NervenCid/UNAL_FDM/README.md

# UNAL FDM
Impresora 3D

Bienvenido al sitio web de Diego

<b> mi proyecto de impresión 3d </b>
