NervenCid/UNAL_FDM/Prototipo_11/Cotizaciones y cuentas/Pesos.docx

Estructura:

Base:

Tornillo:

Base:

Sistema Transfer:

Cremallera:

Carro IGUS:

Extrusores:

Porta-Rodamientos:

Motor Paso:

Porta NEMA 17:

Motor + Porta Nema 17:
