NervenCid/UNAL_FDM/Prototipo_11/Cotizaciones y cuentas/Cotizacion_1.pdf

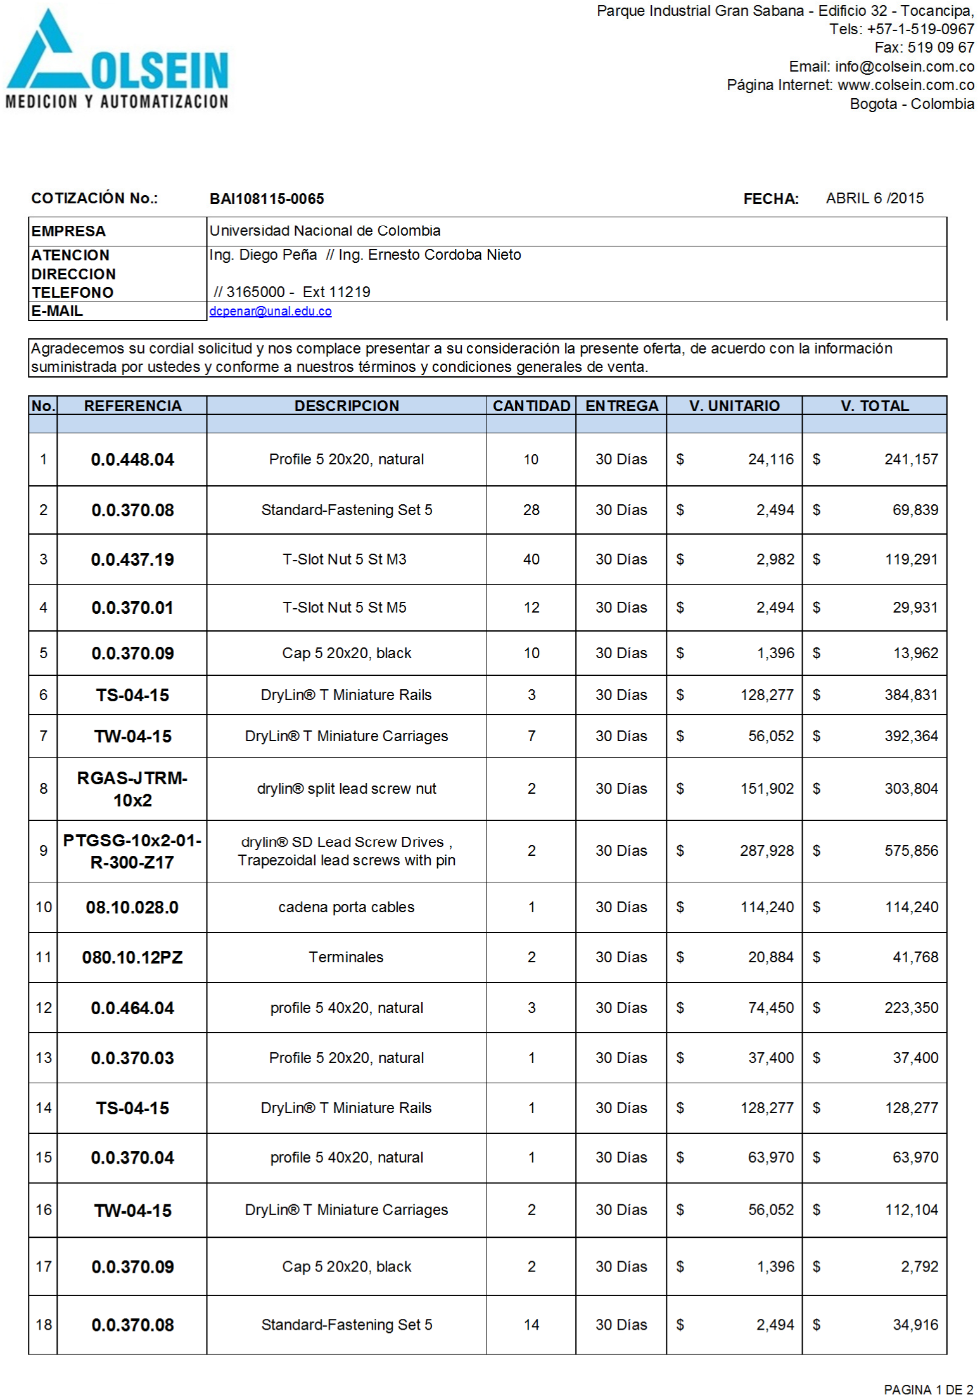
[picture p1: page 1]
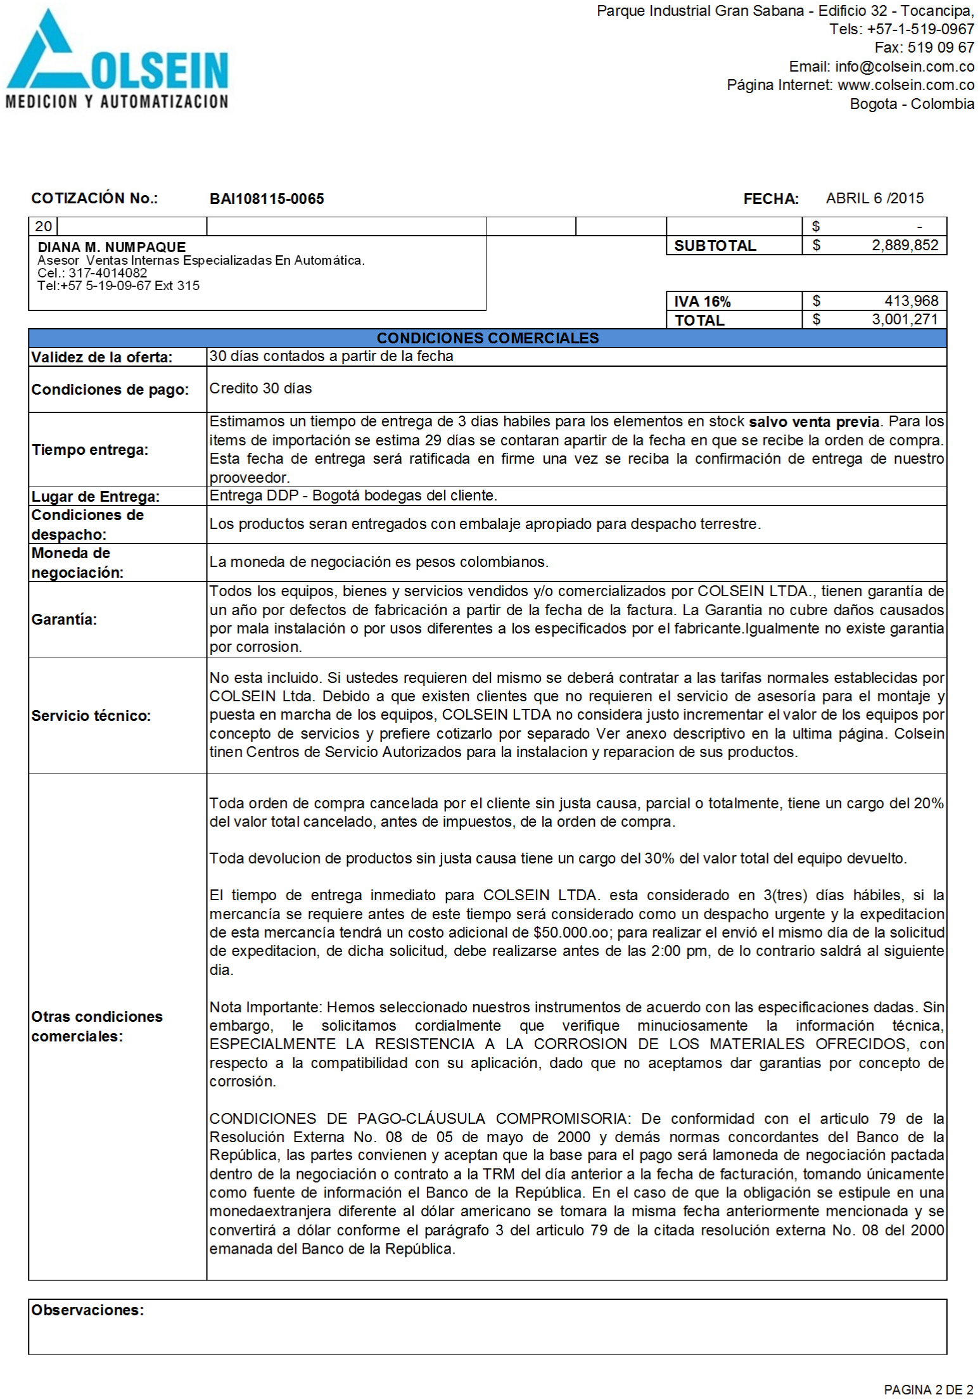
[picture p2: page 2]
