NervenCid/UNAL_FDM/Prototipo_11/Cotizaciones y cuentas/Cotizacion_2.pdf

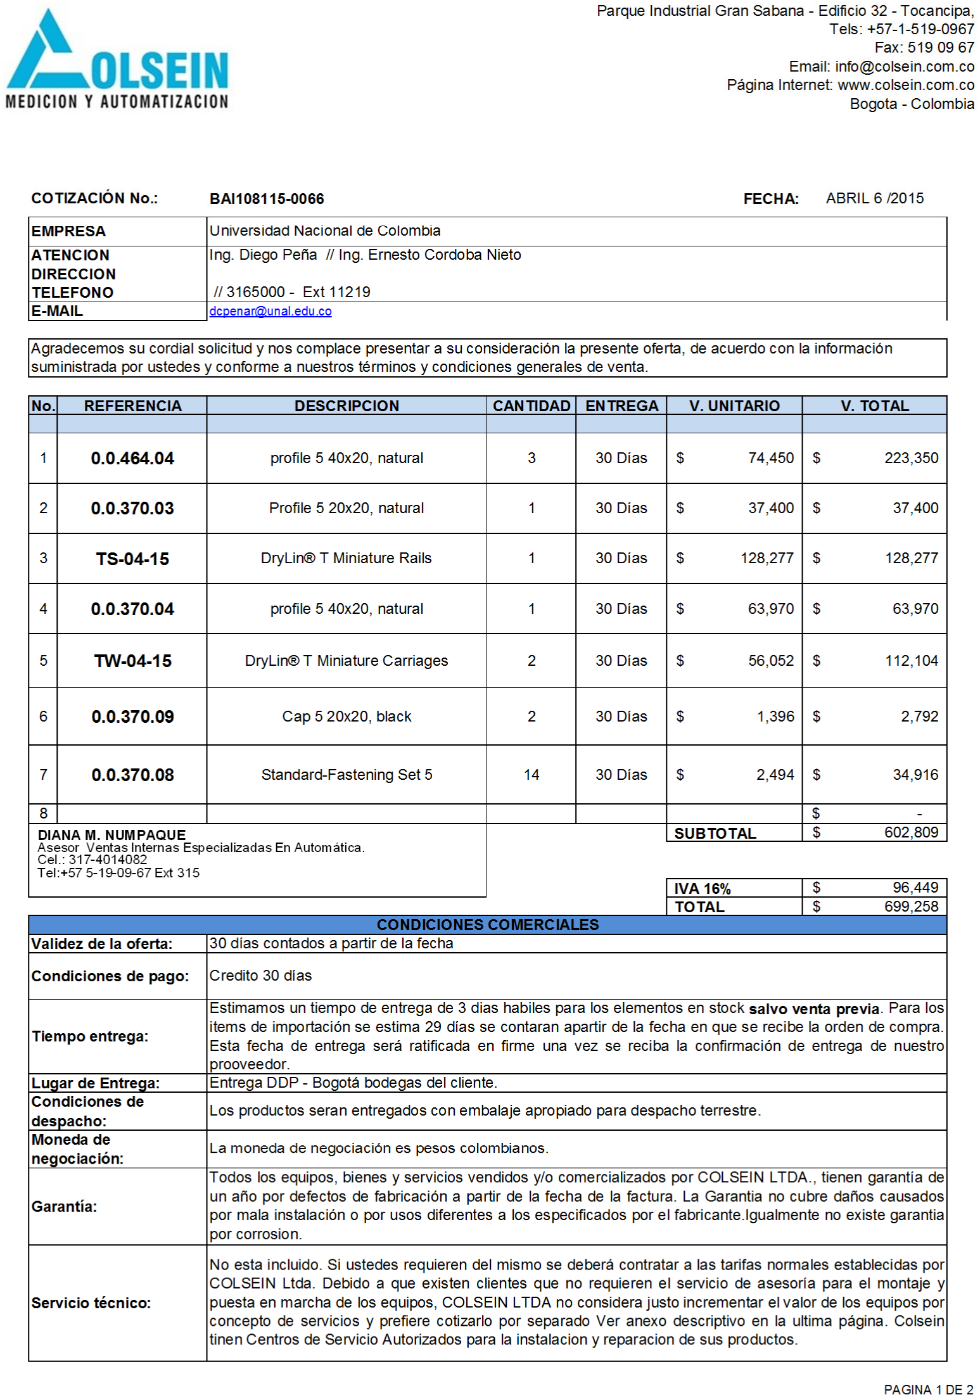
[picture p3: page 1]
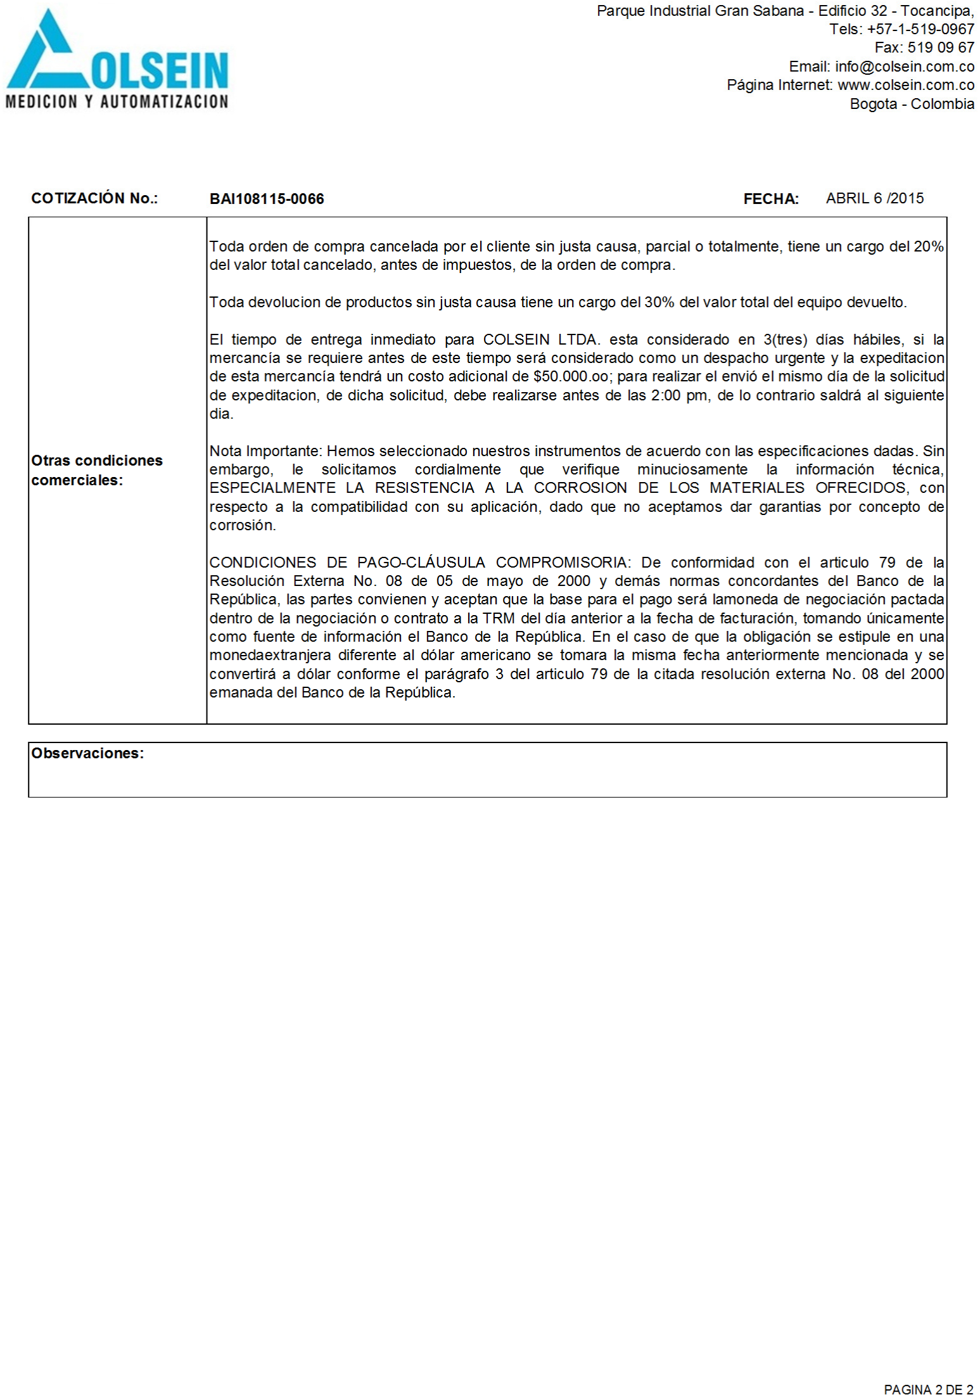
[picture p4: page 2]
