NervenCid/UNAL_FDM/Prototipo_11/AccesoriosTHK/20126271125239772372.jpg

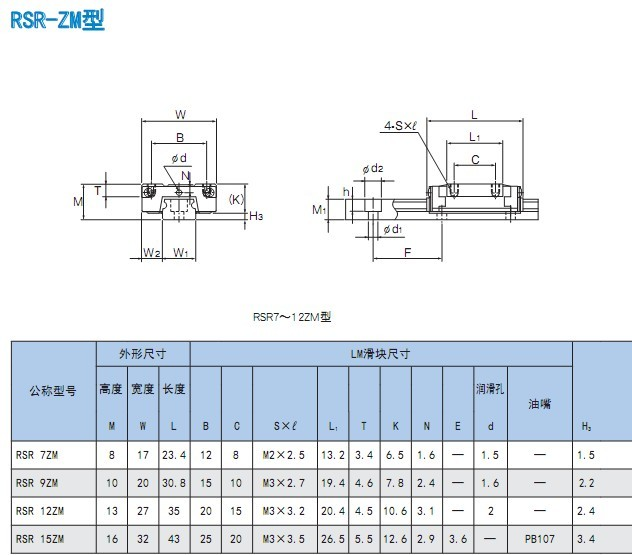
Prototipo_11/AccesoriosTHK/20126271125239772372.jpg
