NervenCid/UNAL_FDM/Prototipo_11/AccesoriosTHK/RSR9ZM_005_j.png

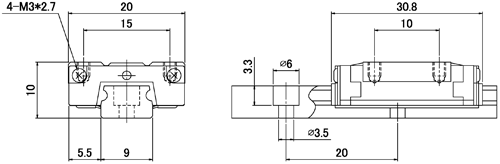
Prototipo_11/AccesoriosTHK/RSR9ZM_005_j.png
