NervenCid/UNAL_FDM/Prototipo_11/Analisis_EF/Lamina_Acople_10mm_EjeXYV4/file6_5987fbc9.jpg

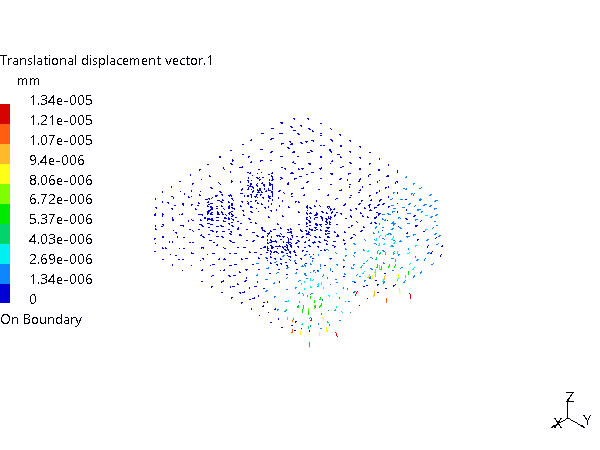
Prototipo_11/Analisis_EF/Lamina_Acople_10mm_EjeXYV4/file6_5987fbc9.jpg
