NervenCid/UNAL_FDM/Prototipo_11/Analisis_EF/Lamina_Acople_Extrusor_V5.jpg

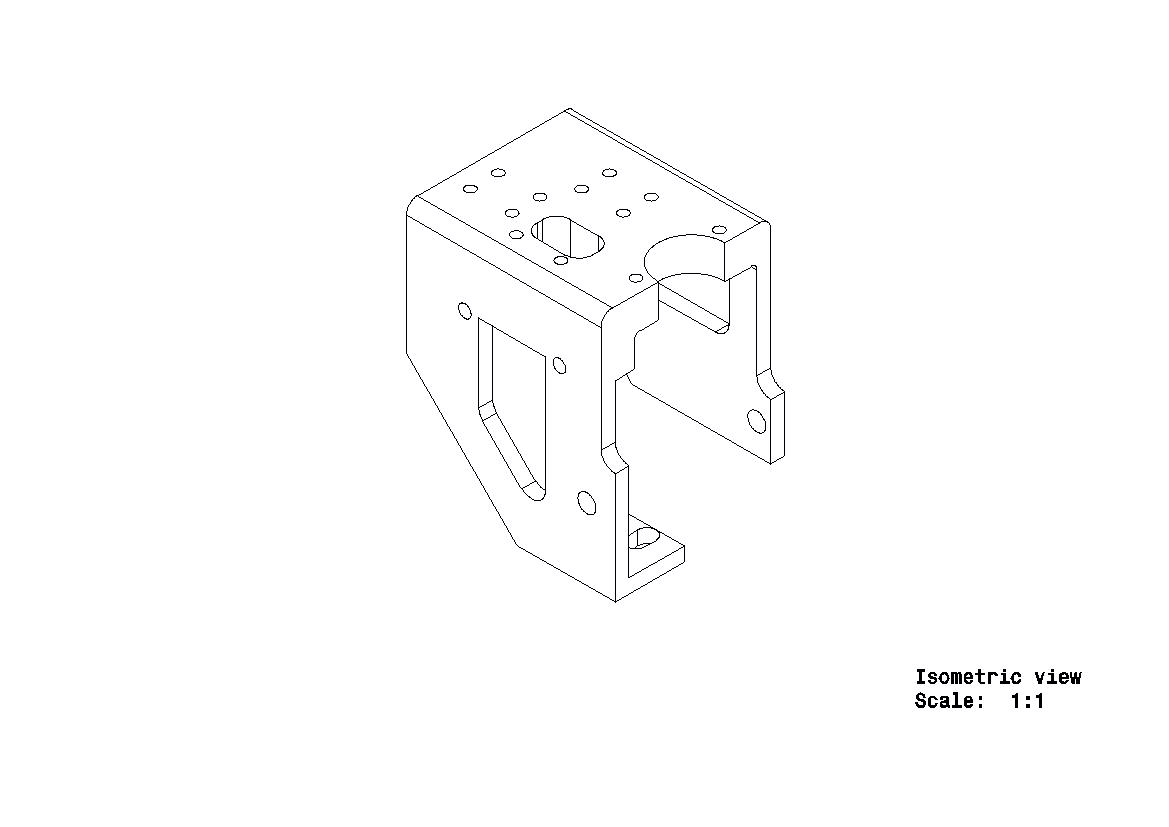
Prototipo_11/Analisis_EF/Lamina_Acople_Extrusor_V5.jpg
