NervenCid/UNAL_FDM/Prototipo_11/Analisis_EF/SoporteGiratorioX.jpg

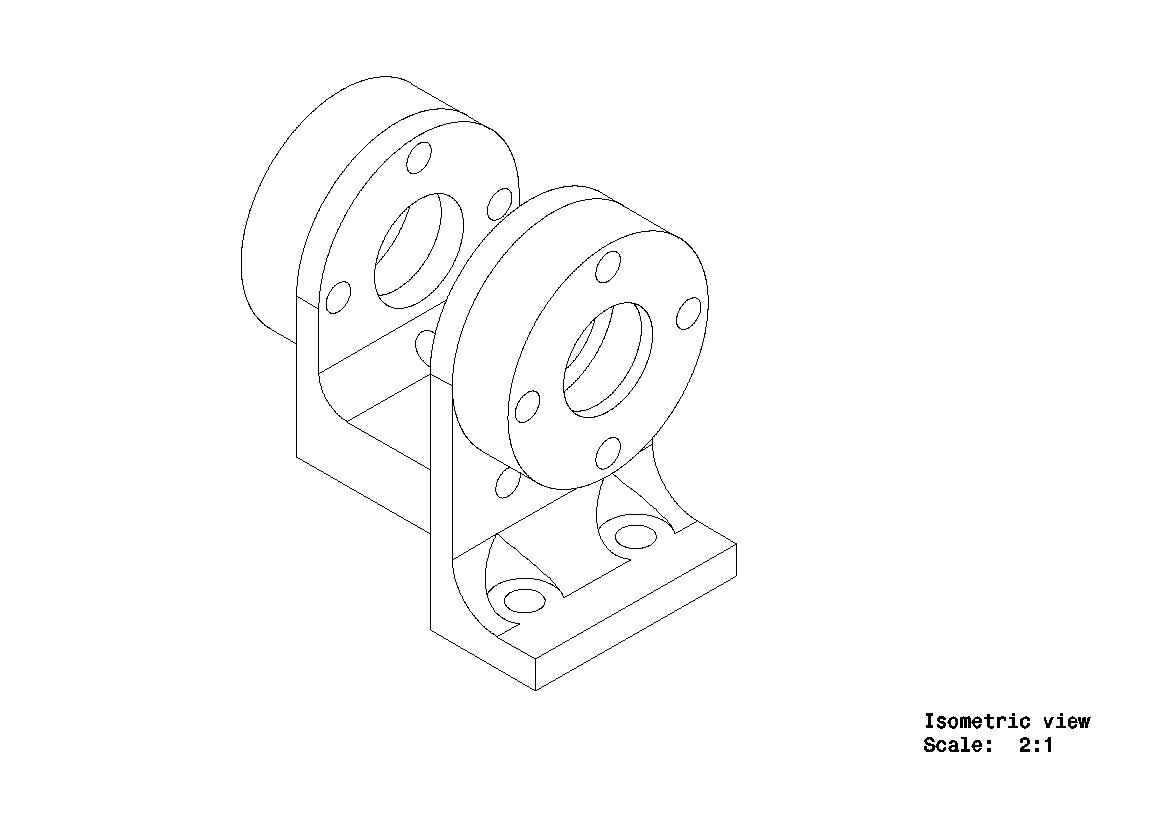
Prototipo_11/Analisis_EF/SoporteGiratorioX.jpg
