NervenCid/UNAL_FDM/Prototipo_11/Analisis_EF/SoporteGiratorioX/file3_59892431.jpg

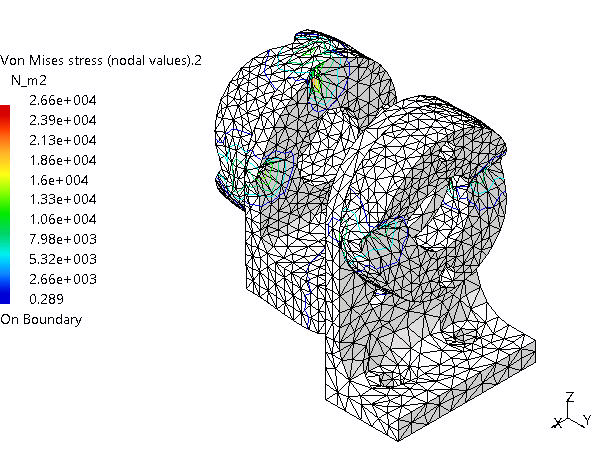
Prototipo_11/Analisis_EF/SoporteGiratorioX/file3_59892431.jpg
