NervenCid/UNAL_FDM/Prototipo_11/Analisis_EF/SoporteGiratorioX/file4_59892431.jpg

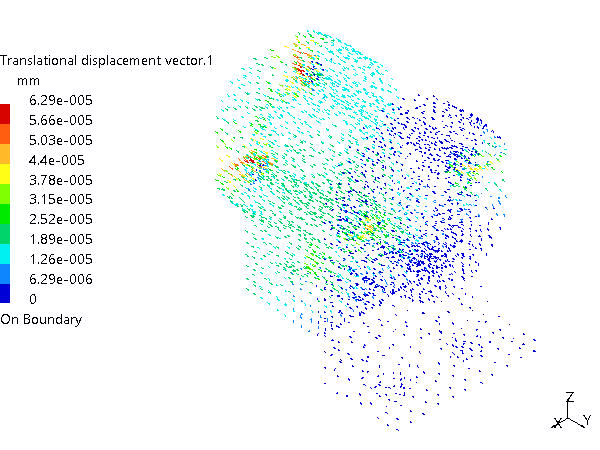
Prototipo_11/Analisis_EF/SoporteGiratorioX/file4_59892431.jpg
