NervenCid/UNAL_FDM/Prototipo_11/Analisis_EF/SoporteGiratorioY.jpg

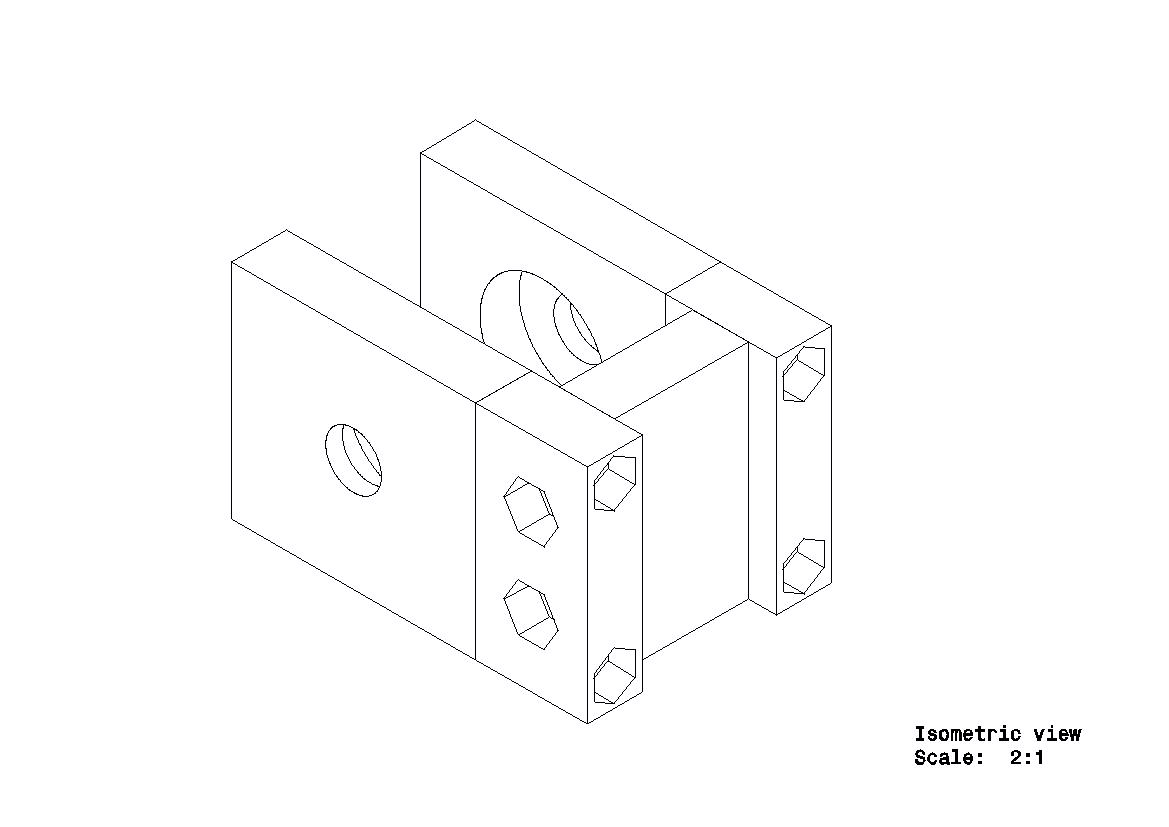
Prototipo_11/Analisis_EF/SoporteGiratorioY.jpg
