NervenCid/UNAL_FDM/Prototipo_11/Analisis_EF/SoporteGiratorioY/file1_5987ef5c.jpg

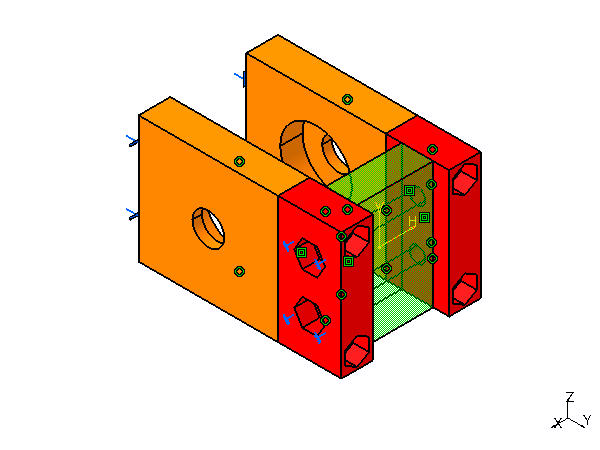
Prototipo_11/Analisis_EF/SoporteGiratorioY/file1_5987ef5c.jpg
