NervenCid/UNAL_FDM/Prototipo_11/Analisis_EF/SoporteGiratorioY/file4_5987ef5c.jpg

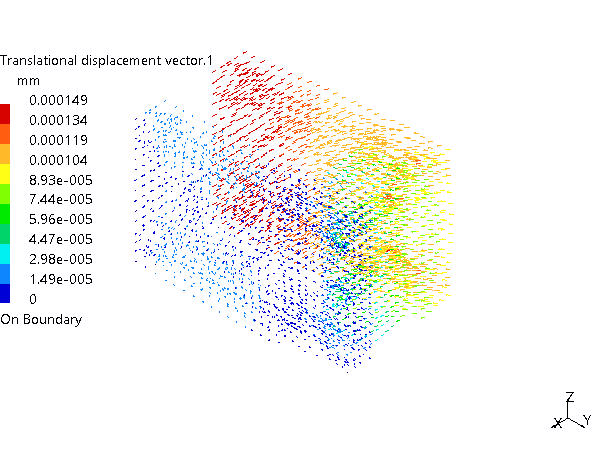
Prototipo_11/Analisis_EF/SoporteGiratorioY/file4_5987ef5c.jpg
