NervenCid/UNAL_FDM/Prototipo_11/Analisis_EF/TensorX.jpg

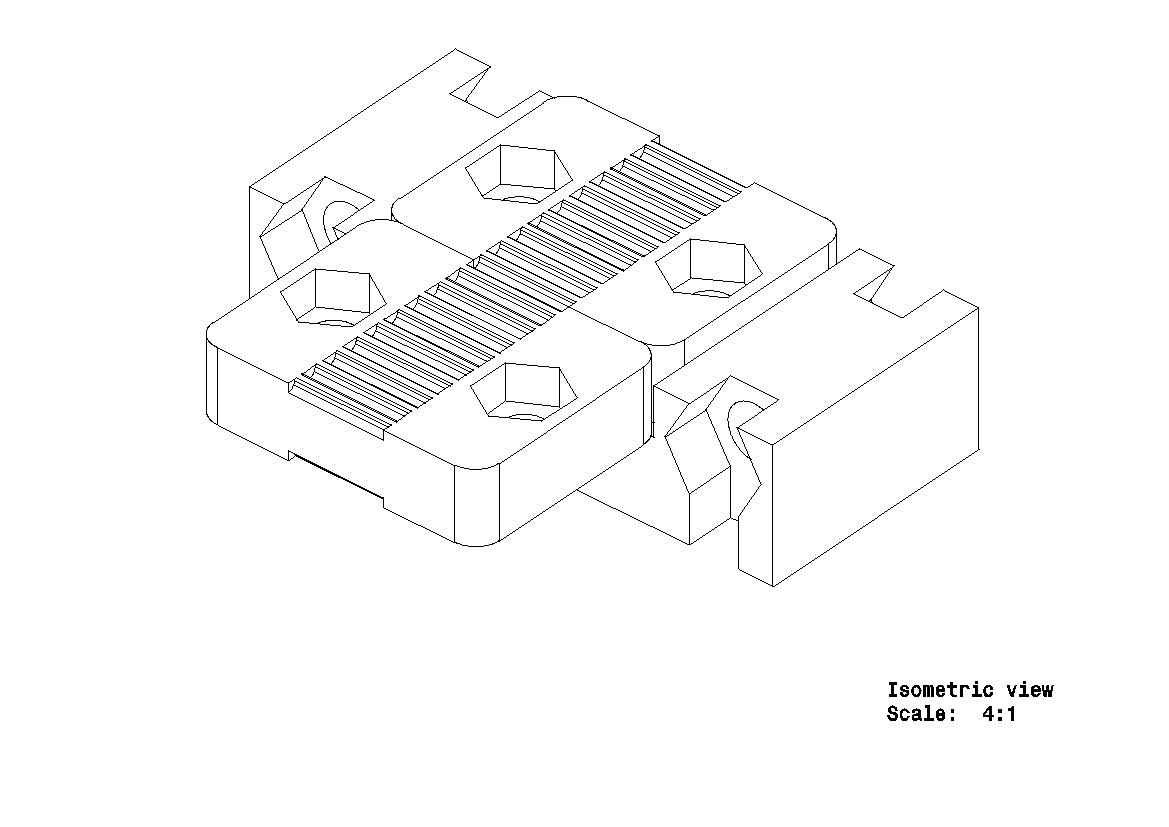
Prototipo_11/Analisis_EF/TensorX.jpg
