NervenCid/UNAL_FDM/Prototipo_11/Analisis_EF/TensorX/file1_59893316.jpg

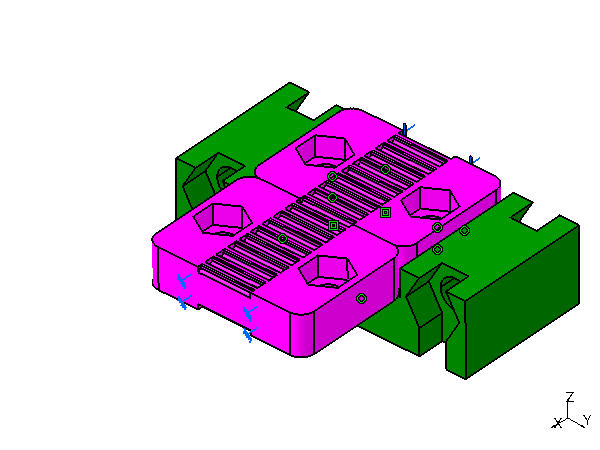
Prototipo_11/Analisis_EF/TensorX/file1_59893316.jpg
