NervenCid/UNAL_FDM/Prototipo_11/Analisis_EF/TensorY.jpg

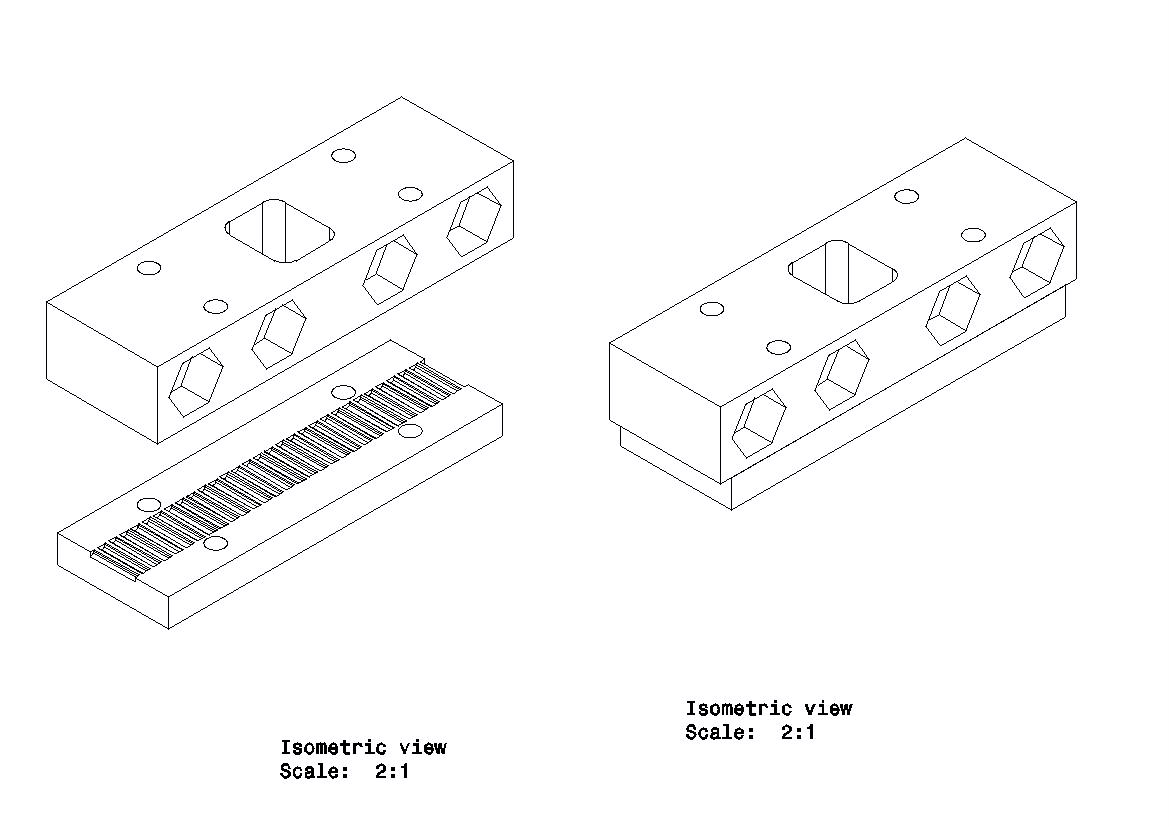
Prototipo_11/Analisis_EF/TensorY.jpg
