NervenCid/UNAL_FDM/Prototipo_11/Analisis_EF/TensorY/file1_5987cb9e.jpg

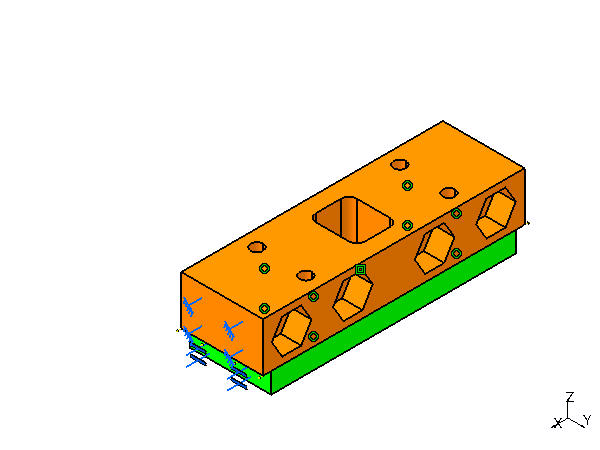
Prototipo_11/Analisis_EF/TensorY/file1_5987cb9e.jpg
