NervenCid/UNAL_FDM/Prototipo_11/Analisis_EF/TensorY/file3_5987cb9e.jpg

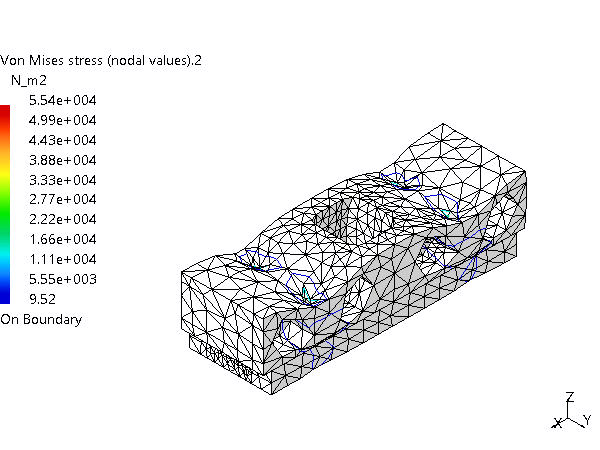
Prototipo_11/Analisis_EF/TensorY/file3_5987cb9e.jpg
