NervenCid/UNAL_FDM/Prototipo_11/Planos Electricos/600px-Ramps-Shield-10.jpg

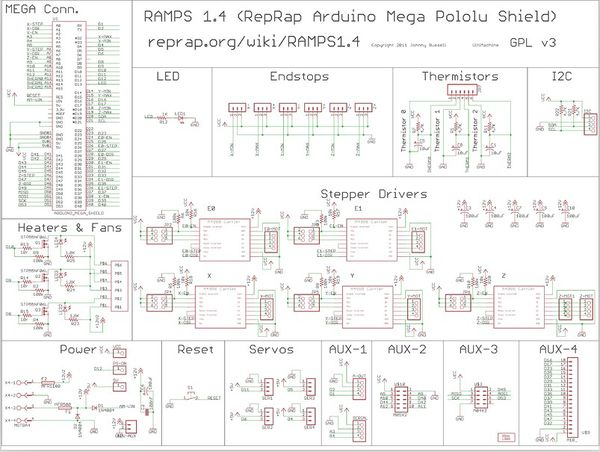
Prototipo_11/Planos Electricos/600px-Ramps-Shield-10.jpg
