NervenCid/UNAL_FDM/Prototipo_11/Planos Electricos/2782231411938289153.png

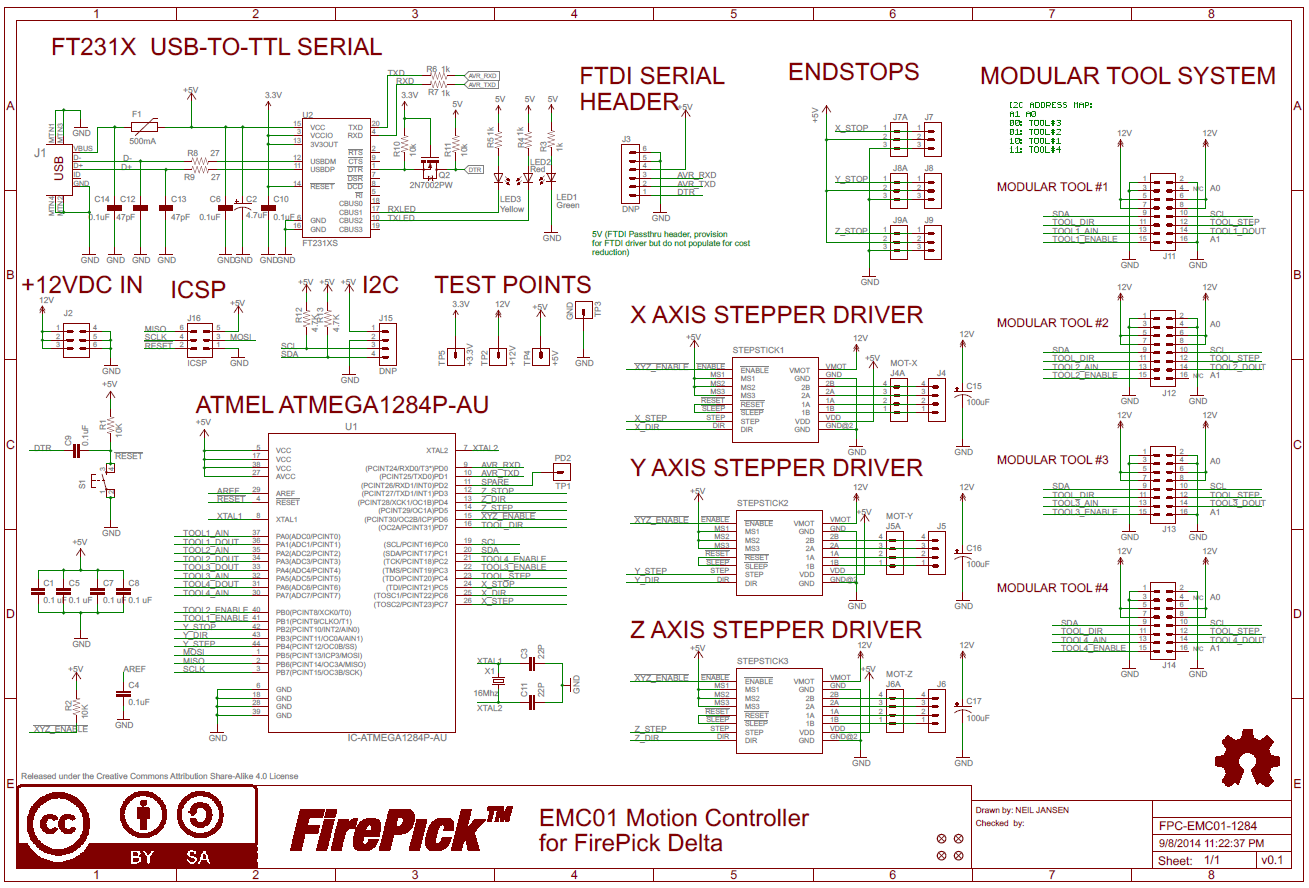
Prototipo_11/Planos Electricos/2782231411938289153.png
