NervenCid/UNAL_FDM/Prototipo_11/Planos Electricos/Bloques1.jpg

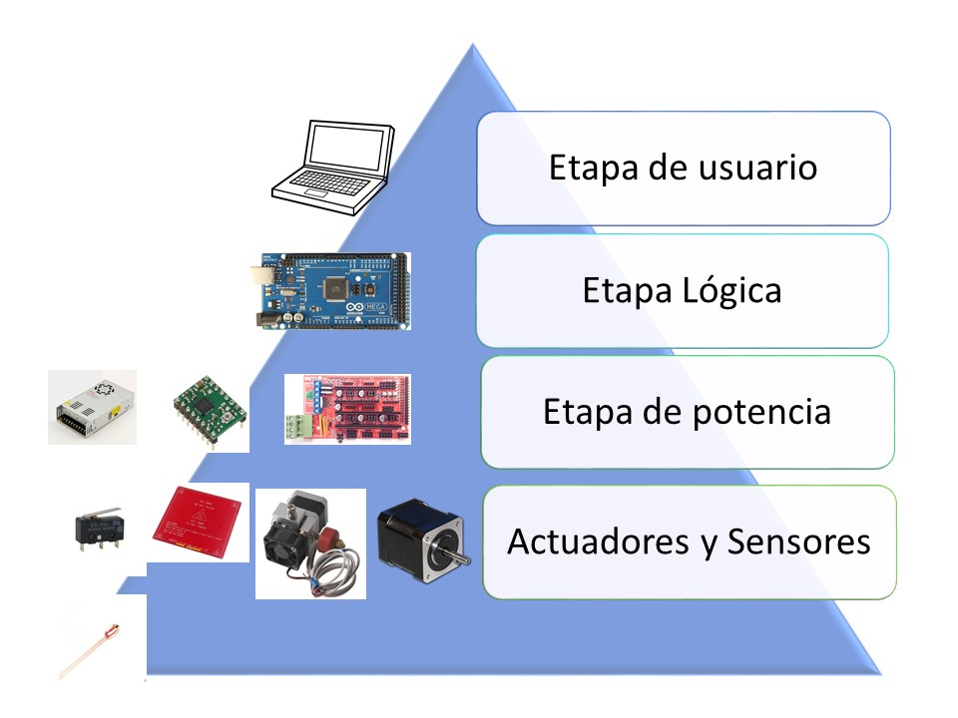
Prototipo_11/Planos Electricos/Bloques1.jpg
