NervenCid/UNAL_FDM/Prototipo_11/Planos Electricos/Bloques2.jpg

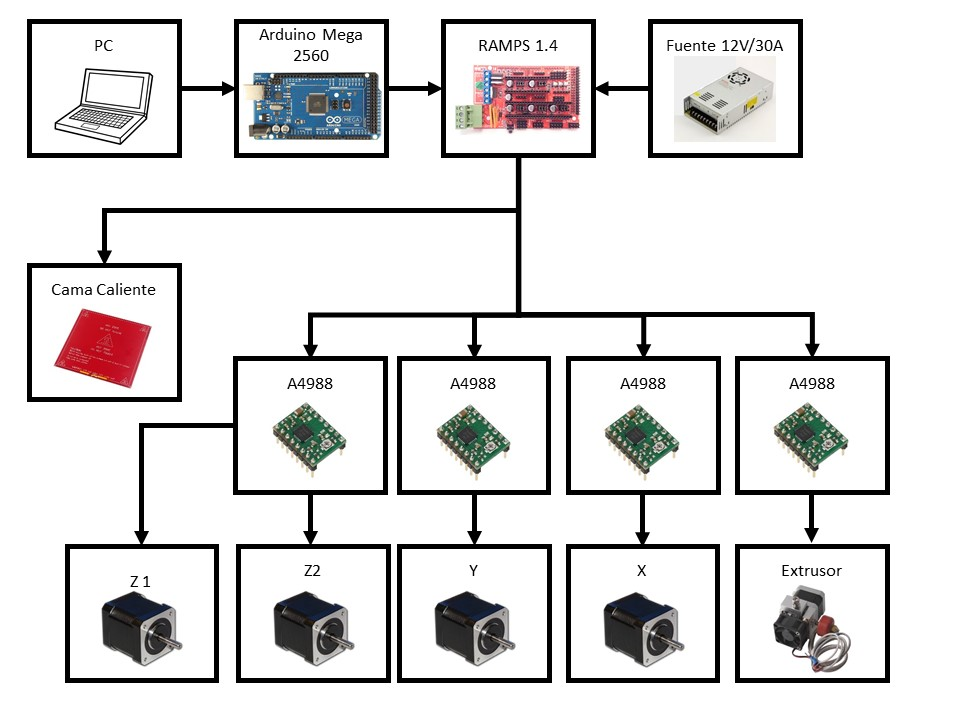
Prototipo_11/Planos Electricos/Bloques2.jpg
