NervenCid/UNAL_FDM/Prototipo_11/Planos Electricos/Bloques3.jpg

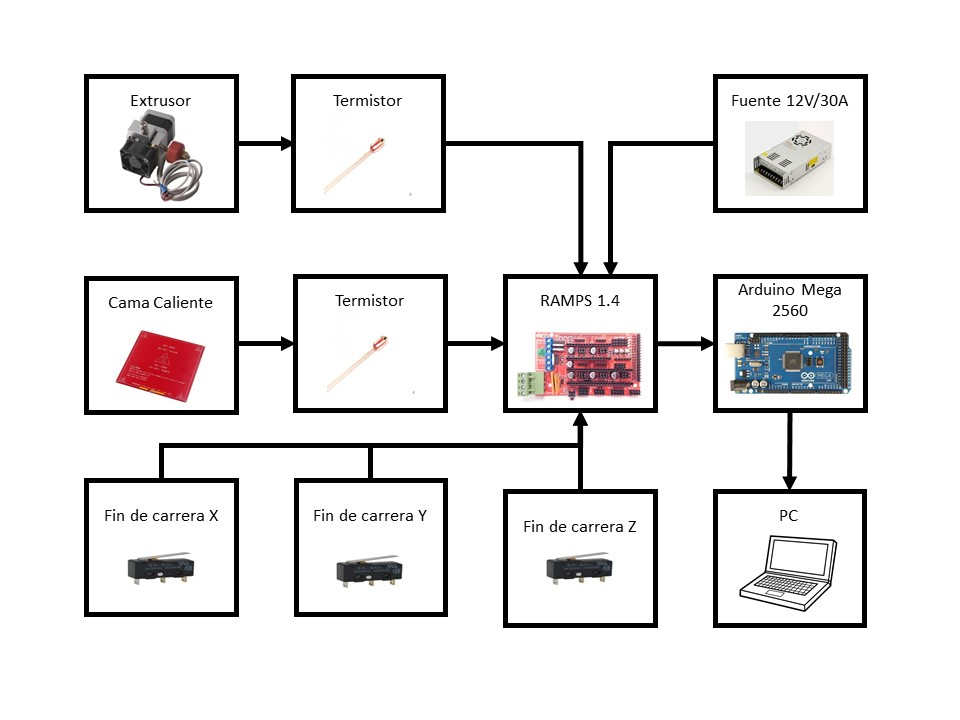
Prototipo_11/Planos Electricos/Bloques3.jpg
