NervenCid/UNAL_FDM/Prototipo_11/Planos Electricos/Bloques4.jpg

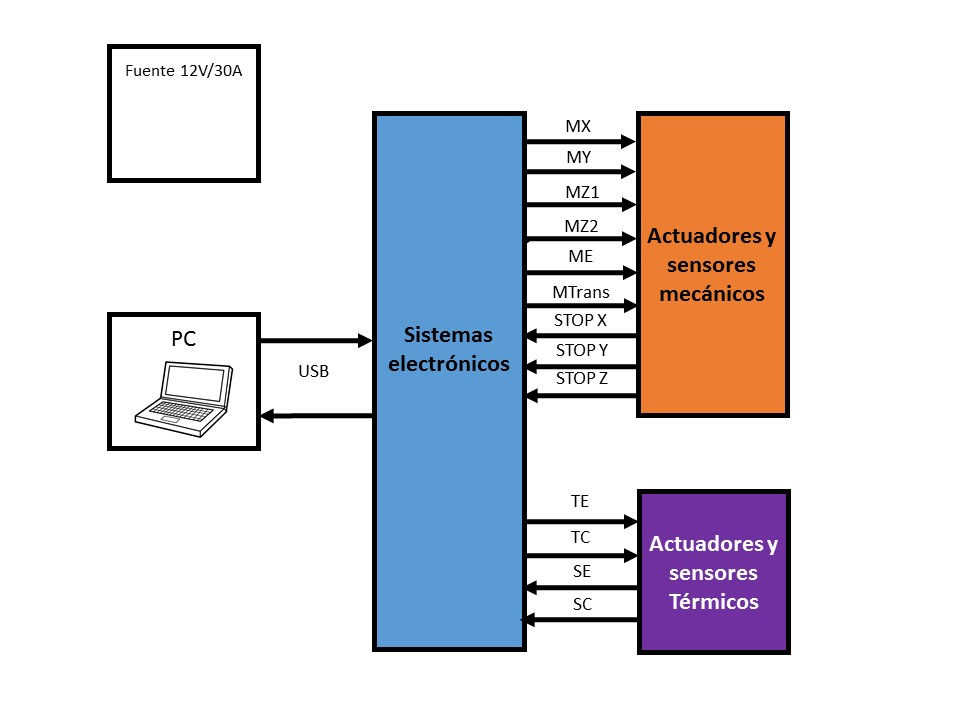
Prototipo_11/Planos Electricos/Bloques4.jpg
