NervenCid/UNAL_FDM/Prototipo_11/Planos Electricos/Bloques5.jpg

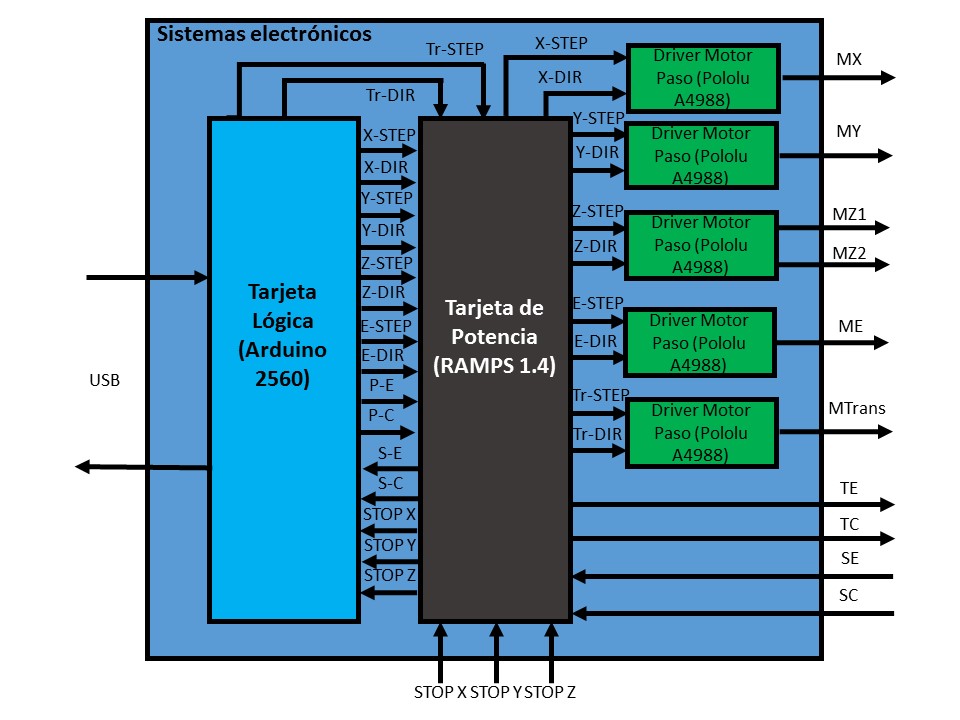
Prototipo_11/Planos Electricos/Bloques5.jpg
