NervenCid/UNAL_FDM/Prototipo_11/Planos Electricos/Bloques6.jpg

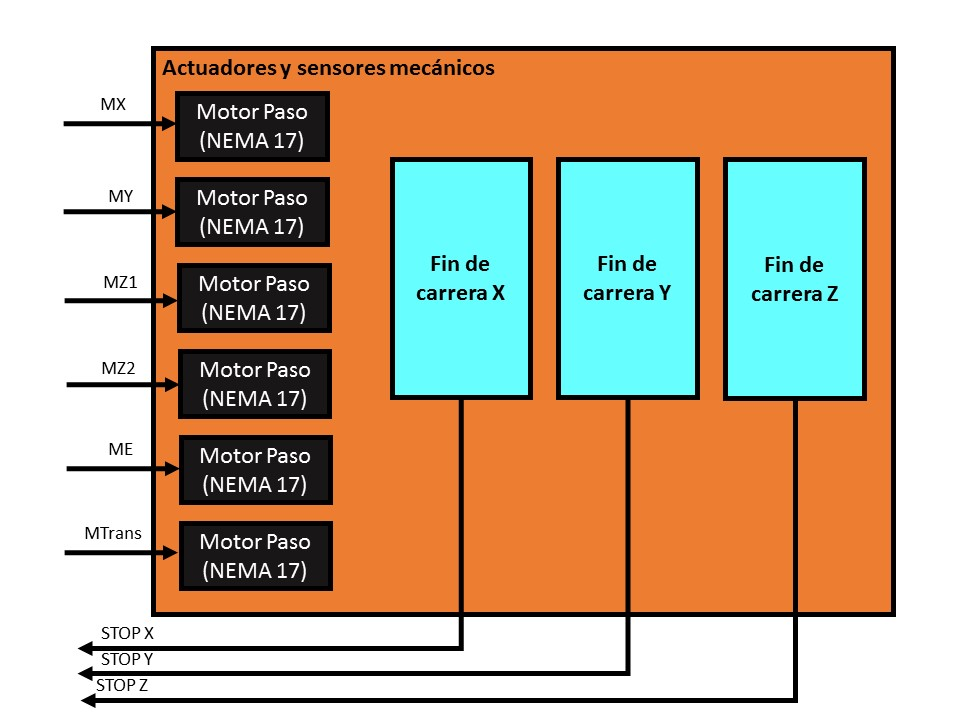
Prototipo_11/Planos Electricos/Bloques6.jpg
