NervenCid/UNAL_FDM/Prototipo_11/Planos Electricos/Bloques7.jpg

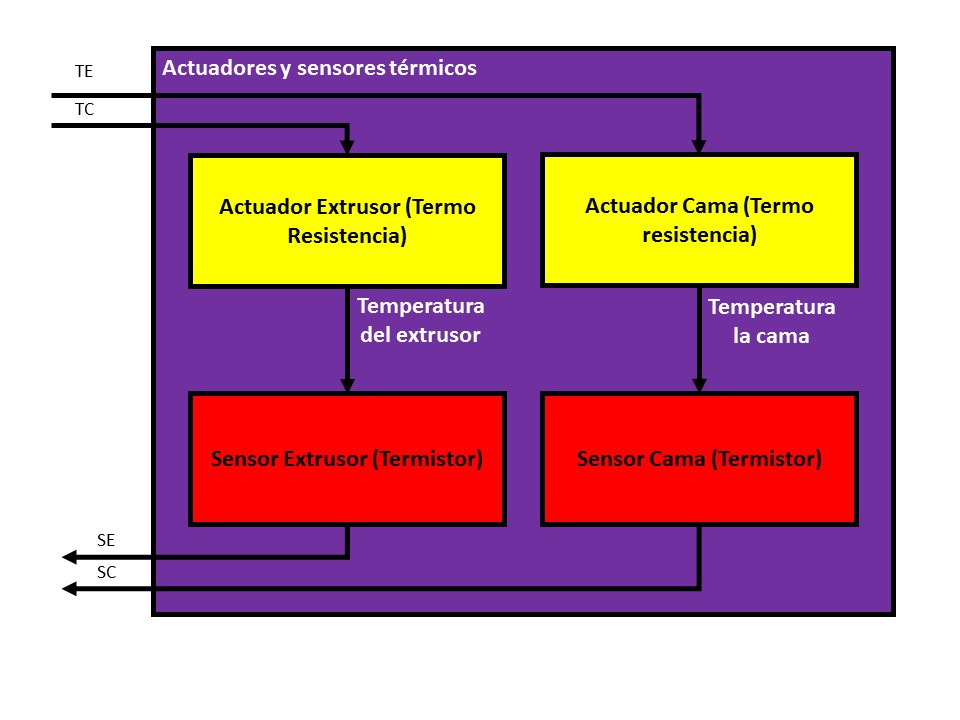
Prototipo_11/Planos Electricos/Bloques7.jpg
