NervenCid/UNAL_FDM/Prototipo_11/Planos Electricos/Gabinete1.jpg

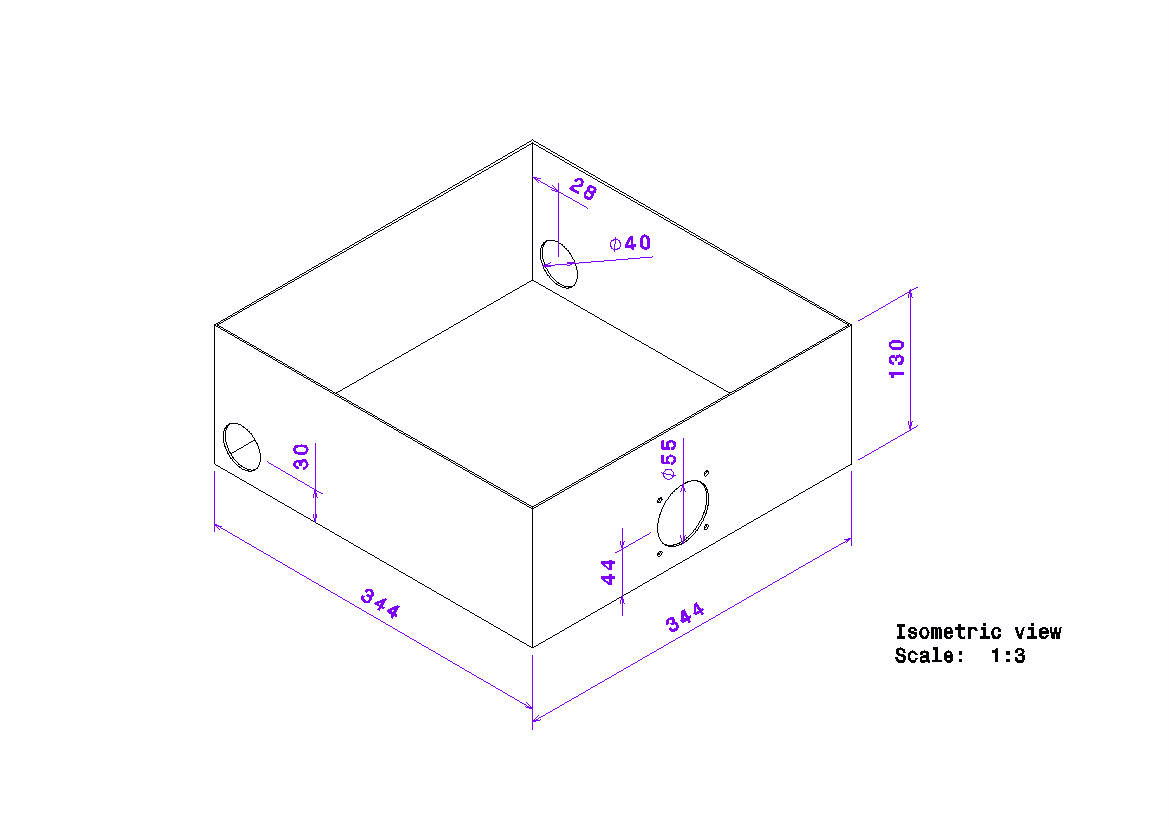
Prototipo_11/Planos Electricos/Gabinete1.jpg
