NervenCid/UNAL_FDM/Prototipo_11/Planos Electricos/RAMPSConnect.jpg

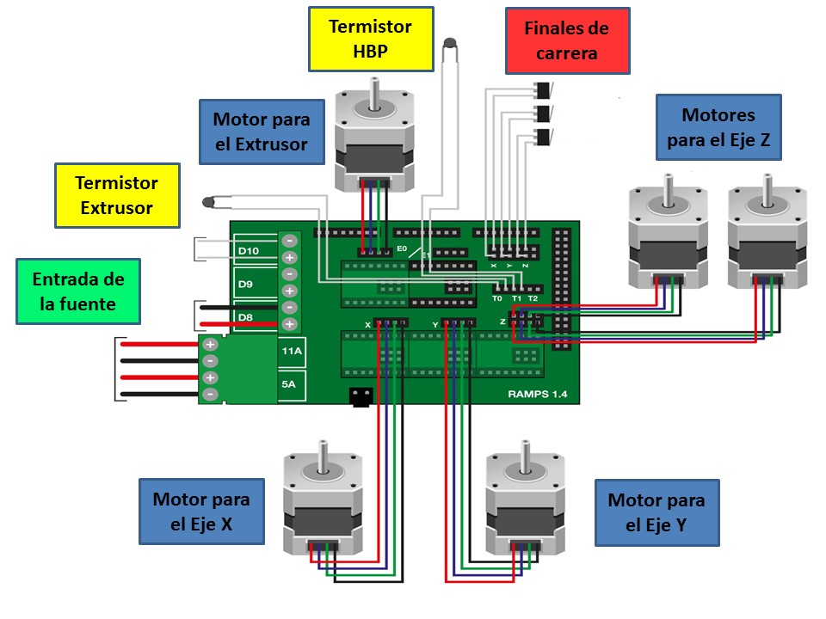
Prototipo_11/Planos Electricos/RAMPSConnect.jpg
