NervenCid/UNAL_FDM/Prototipo_11/Planos Electricos/RAMPSFULL.jpg

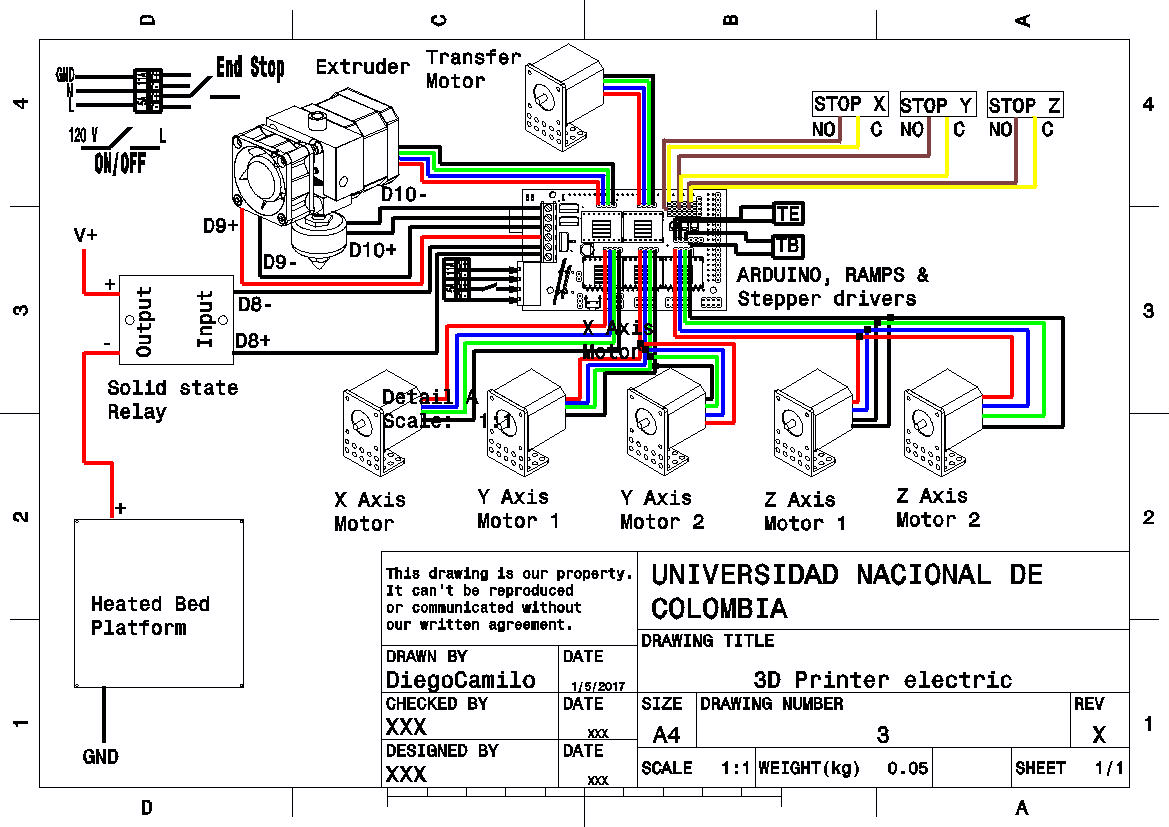
Prototipo_11/Planos Electricos/RAMPSFULL.jpg
