NervenCid/UNAL_FDM/Prototipo_11/Planos Electricos/REPRAPschematic.png

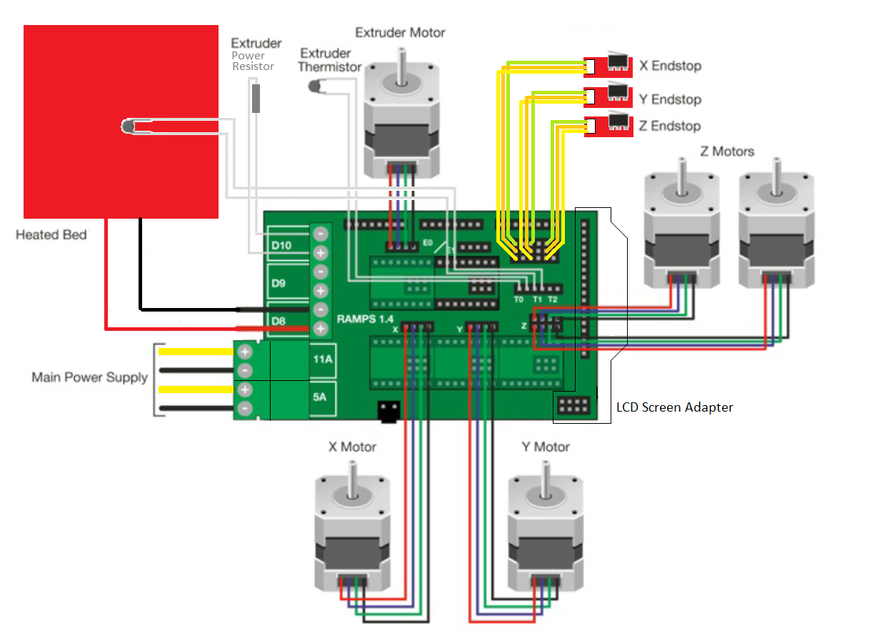
Prototipo_11/Planos Electricos/REPRAPschematic.png
