NervenCid/UNAL_FDM/Prototipo_11/Planos/BaseMovil.jpg

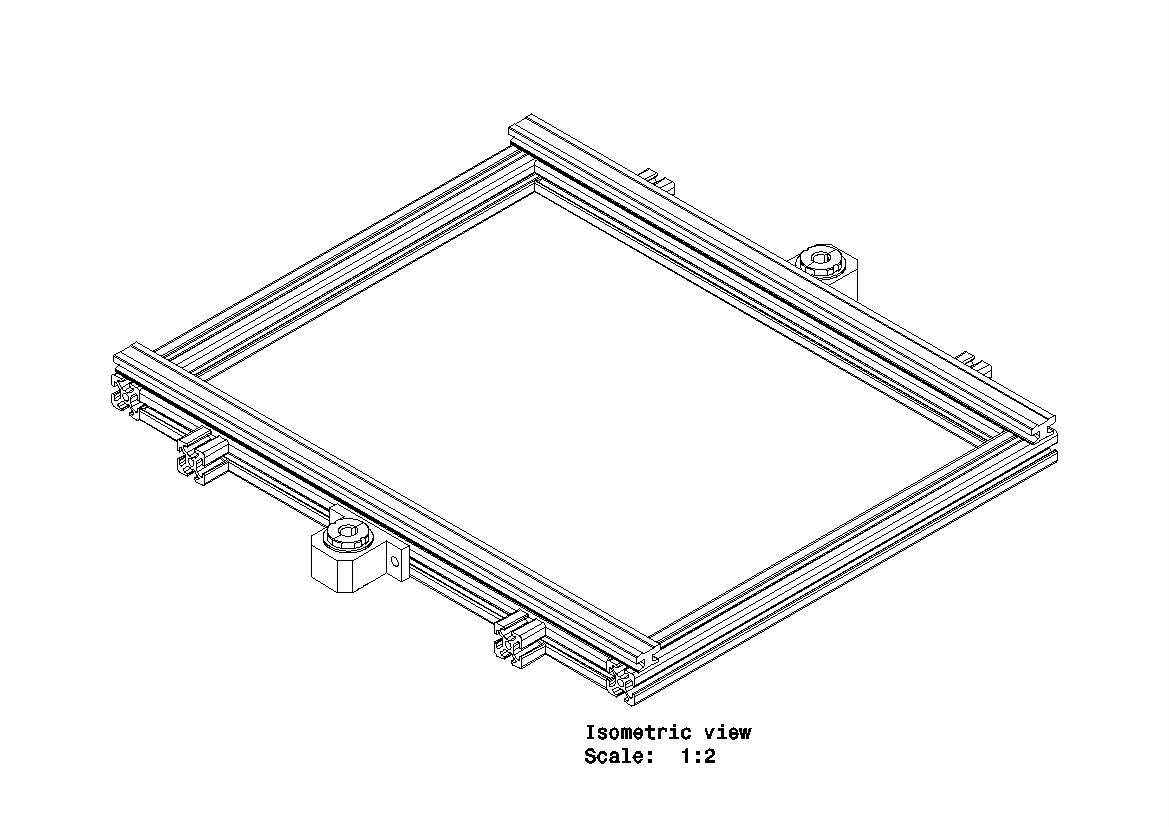
Prototipo_11/Planos/BaseMovil.jpg
