NervenCid/UNAL_FDM/Prototipo_11/Planos/BaseMovilEns.jpg

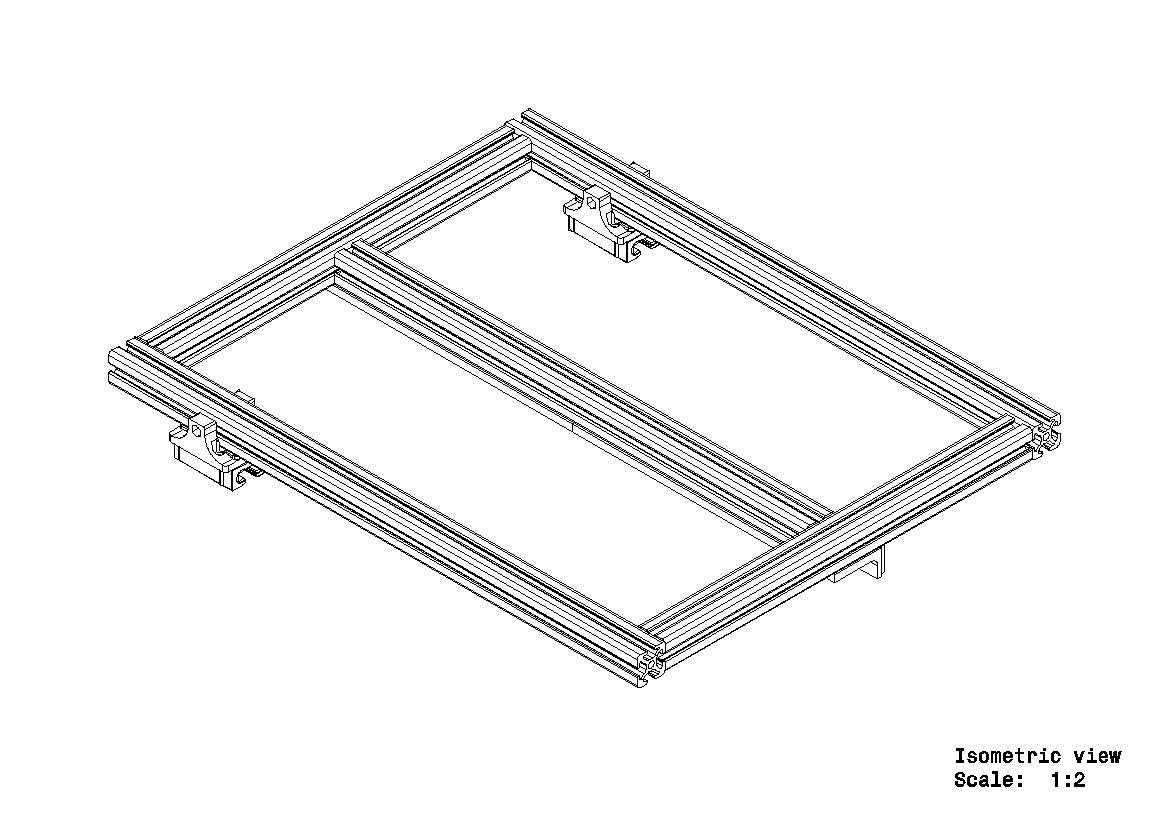
Prototipo_11/Planos/BaseMovilEns.jpg
