NervenCid/UNAL_FDM/Prototipo_11/Planos/BaseMovilExplo.jpg

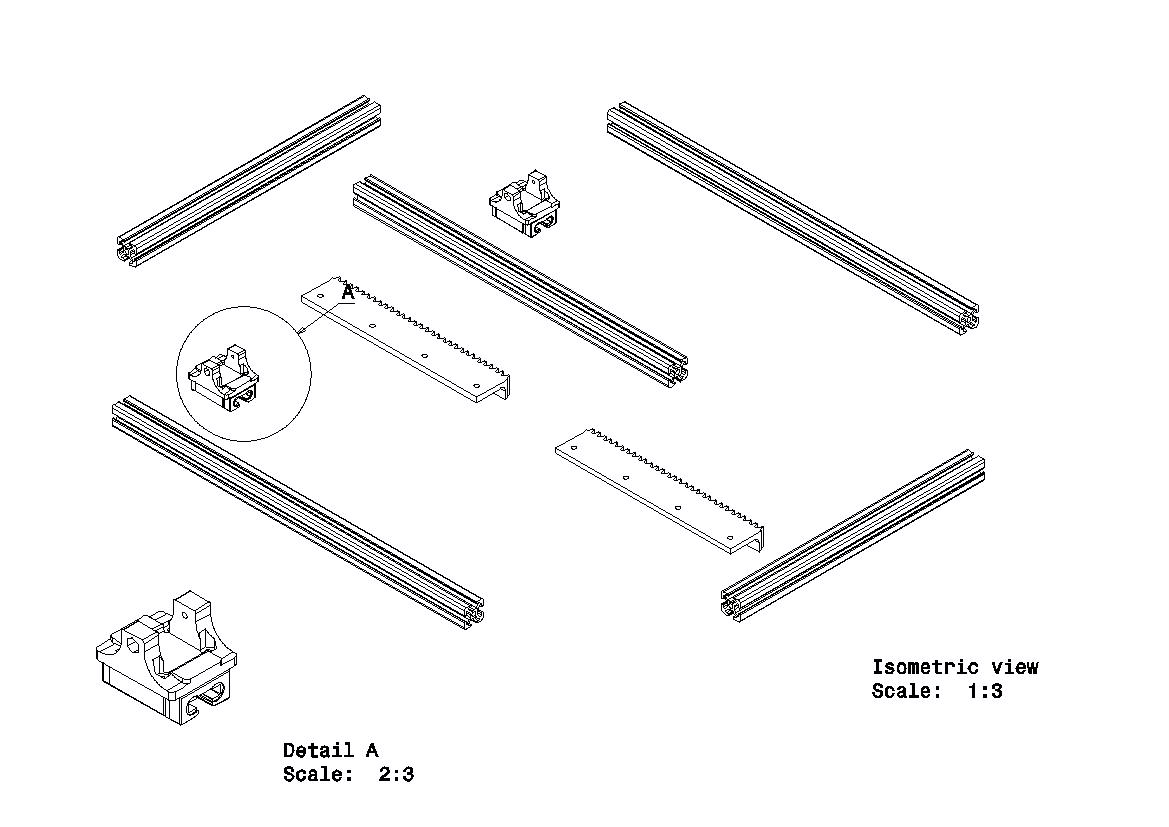
Prototipo_11/Planos/BaseMovilExplo.jpg
