NervenCid/UNAL_FDM/Prototipo_11/Planos/BaseMovP1.jpg

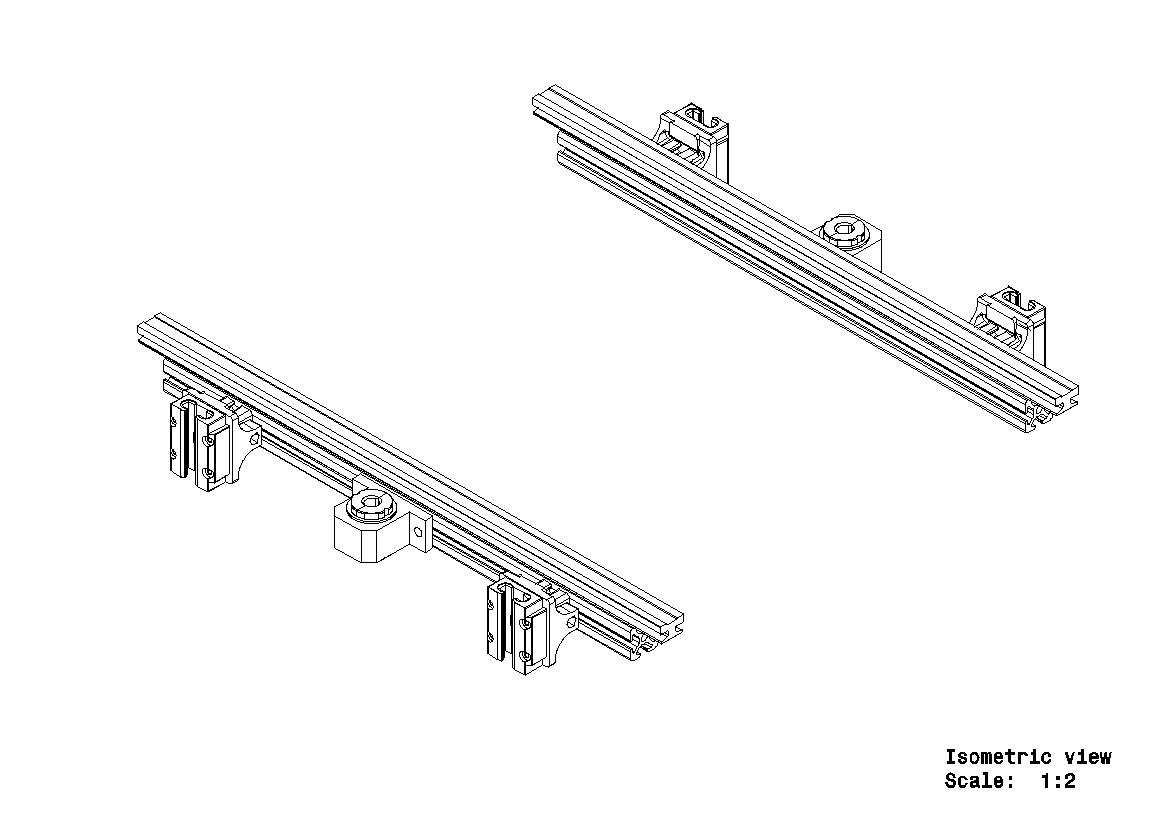
Prototipo_11/Planos/BaseMovP1.jpg
