NervenCid/UNAL_FDM/Prototipo_11/Planos/Conjunto.jpg

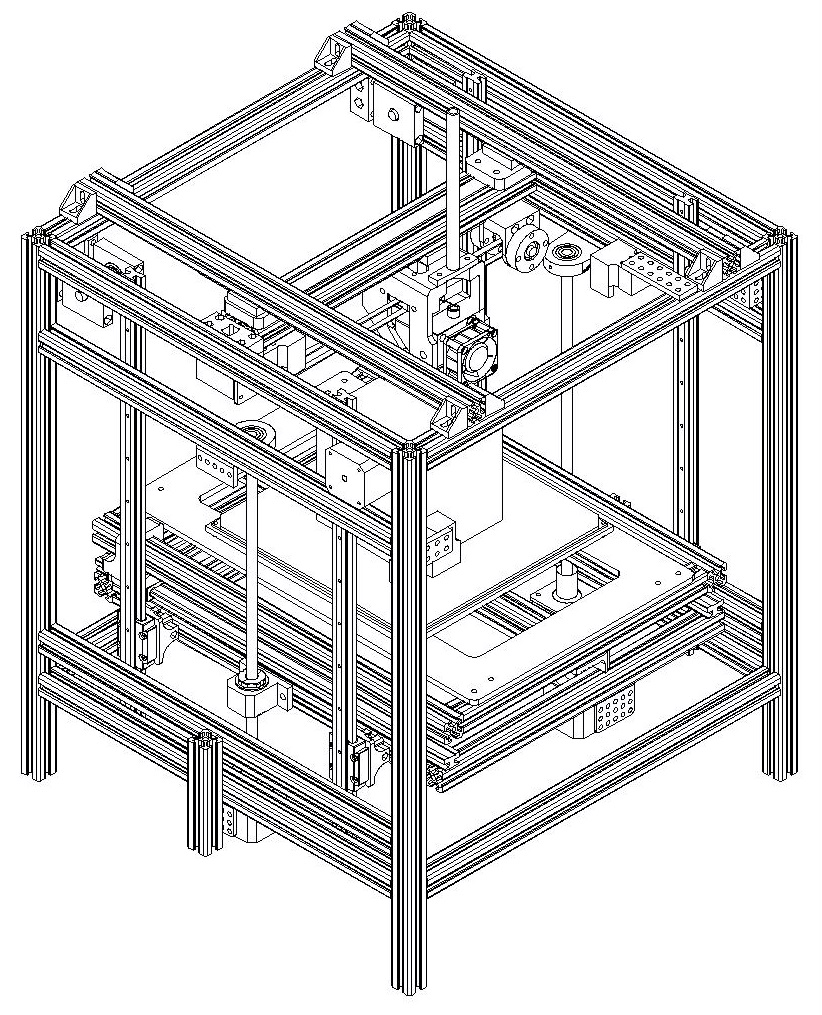
Prototipo_11/Planos/Conjunto.jpg
