NervenCid/UNAL_FDM/Prototipo_11/Planos/ConjuntoExtrusor.jpg

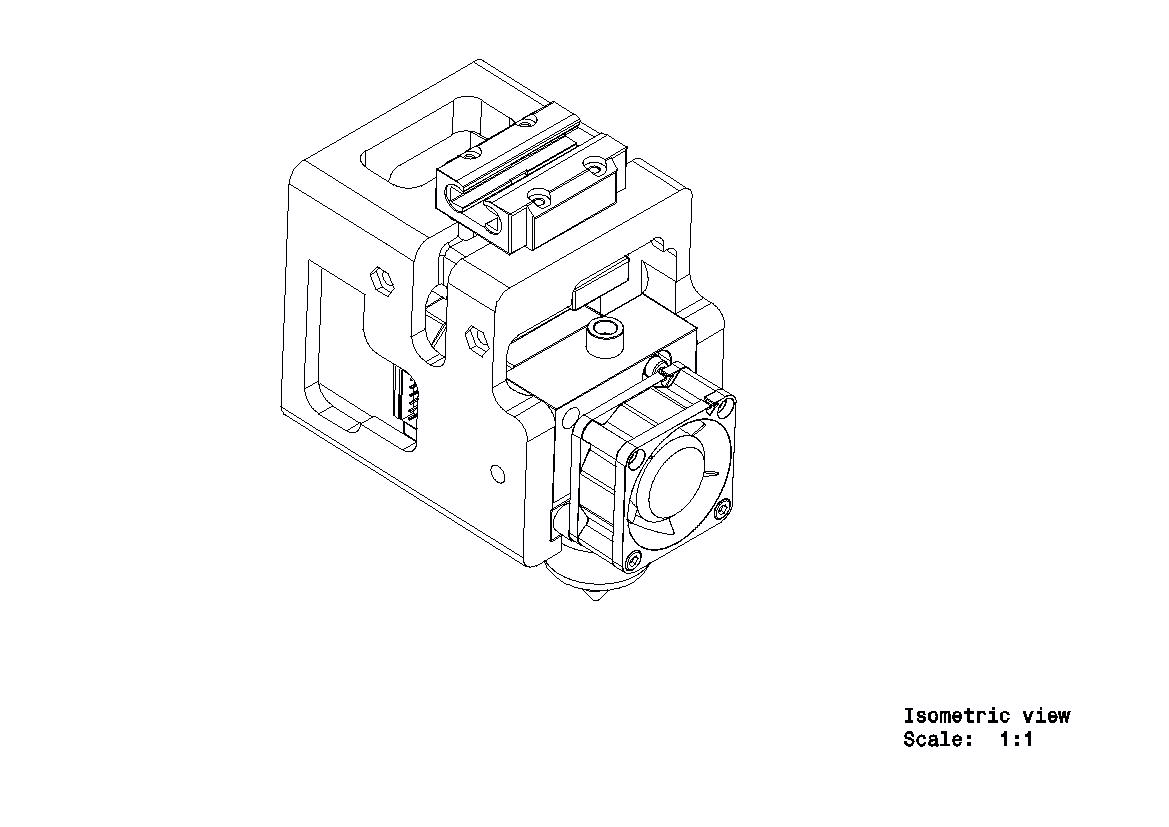
Prototipo_11/Planos/ConjuntoExtrusor.jpg
