NervenCid/UNAL_FDM/Prototipo_11/Planos/ConjuntoExtrusorExplo.jpg

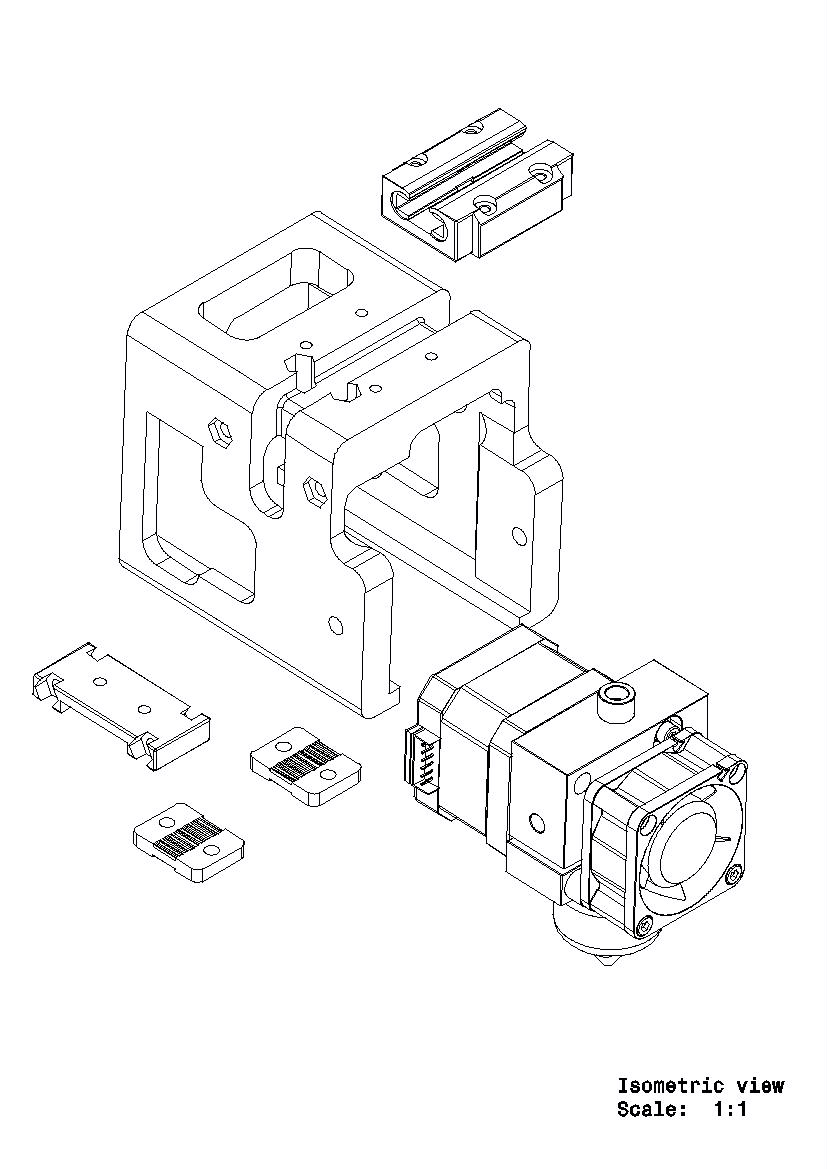
Prototipo_11/Planos/ConjuntoExtrusorExplo.jpg
