NervenCid/UNAL_FDM/Prototipo_11/Planos/EjeX2.jpg

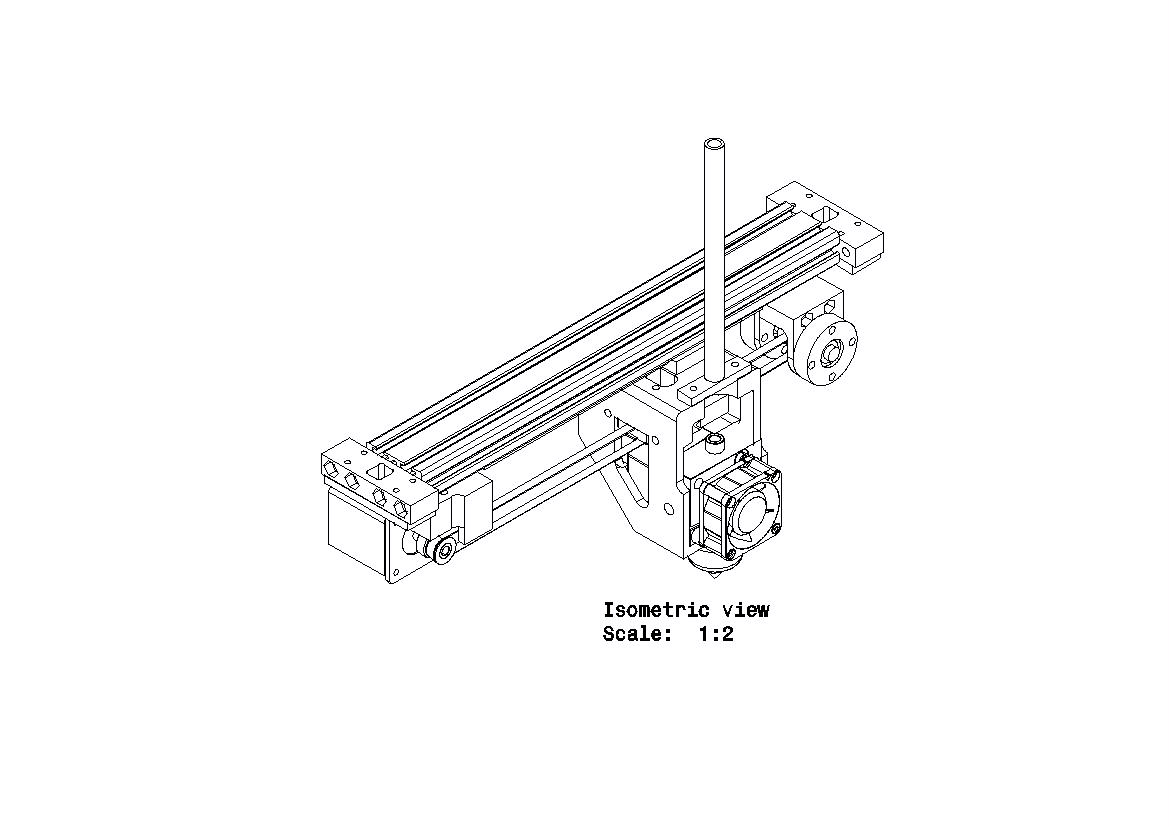
Prototipo_11/Planos/EjeX2.jpg
