NervenCid/UNAL_FDM/Prototipo_11/Planos/EjeX.jpg

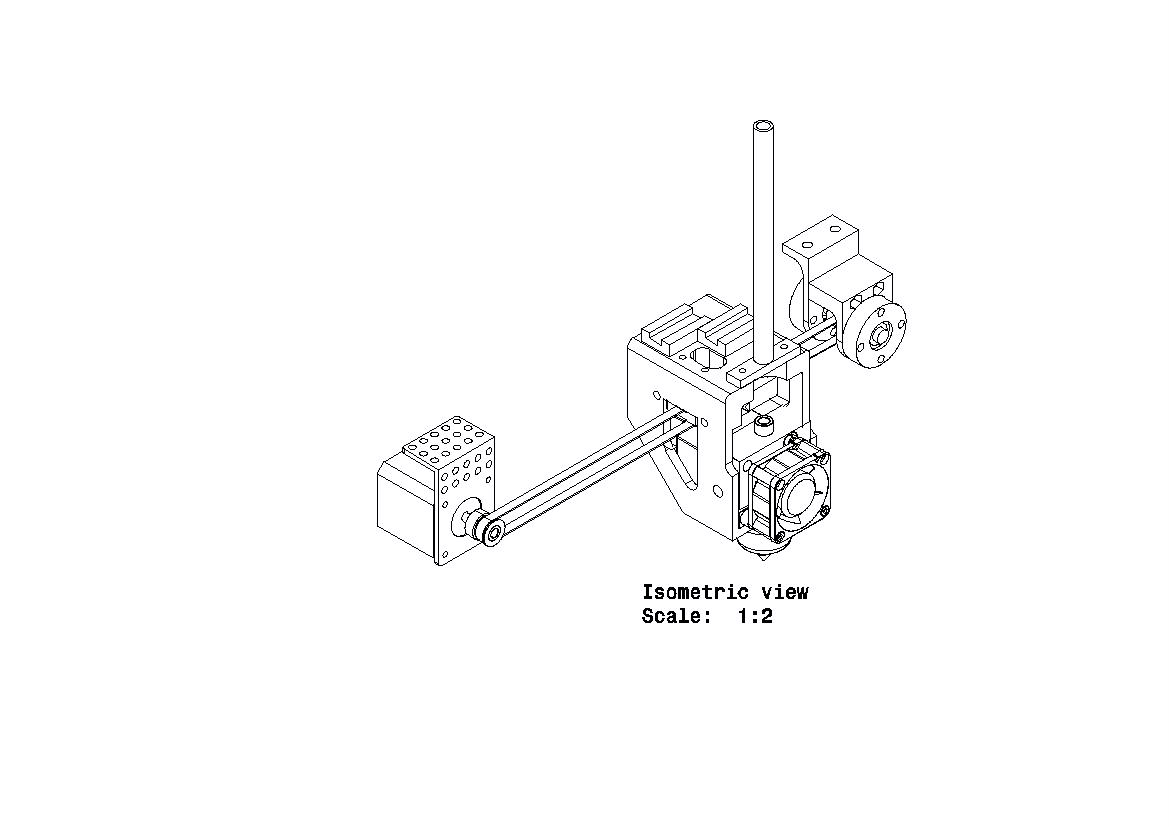
Prototipo_11/Planos/EjeX.jpg
