NervenCid/UNAL_FDM/Prototipo_11/Planos/EjeY.jpg

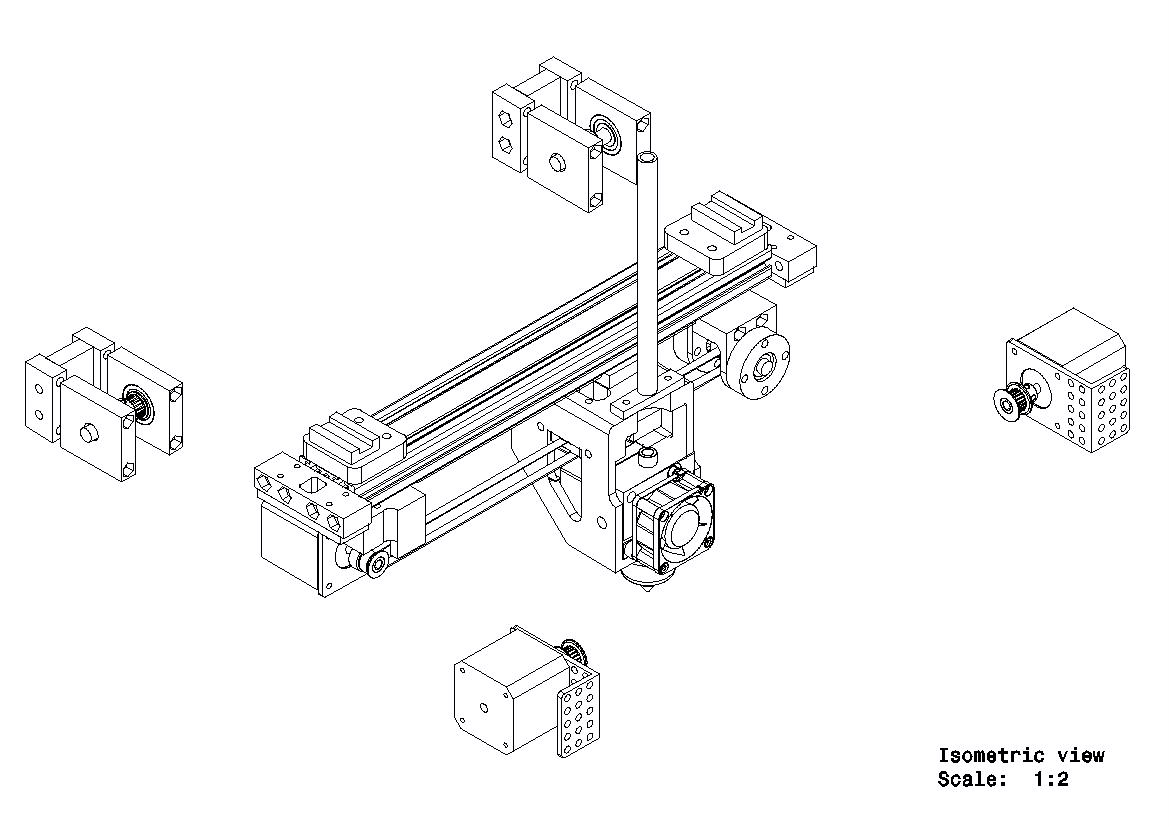
Prototipo_11/Planos/EjeY.jpg
