NervenCid/UNAL_FDM/Prototipo_11/Planos/EjeYEstr.jpg

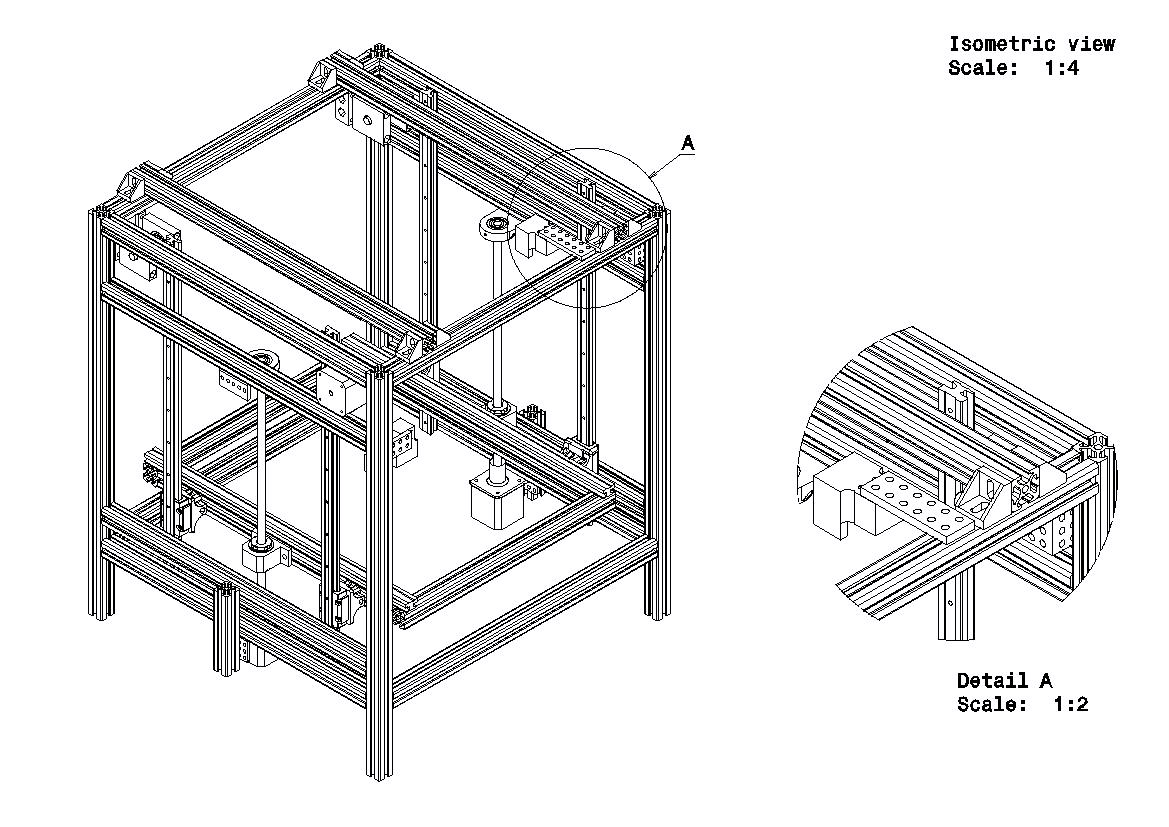
Prototipo_11/Planos/EjeYEstr.jpg
