NervenCid/UNAL_FDM/Prototipo_11/Planos/EjeZ.jpg

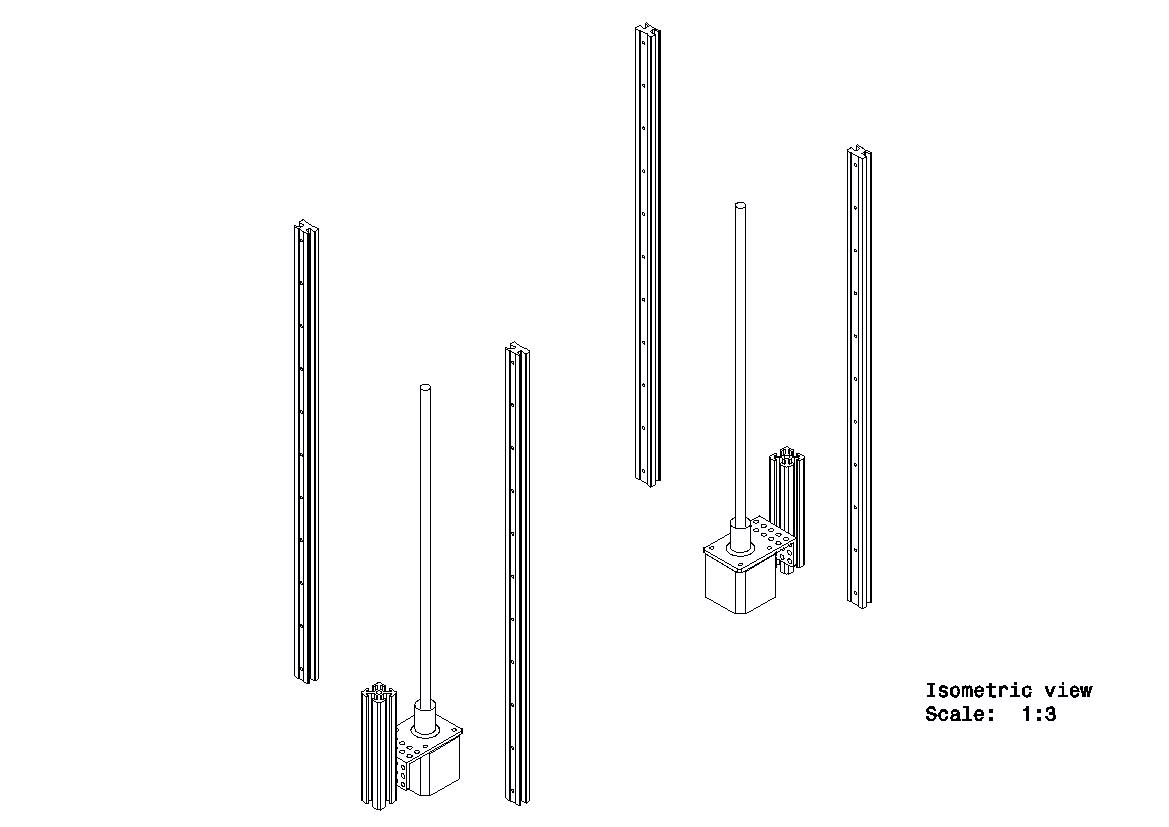
Prototipo_11/Planos/EjeZ.jpg
