NervenCid/UNAL_FDM/Prototipo_11/Planos/EnsamXYP1.jpg

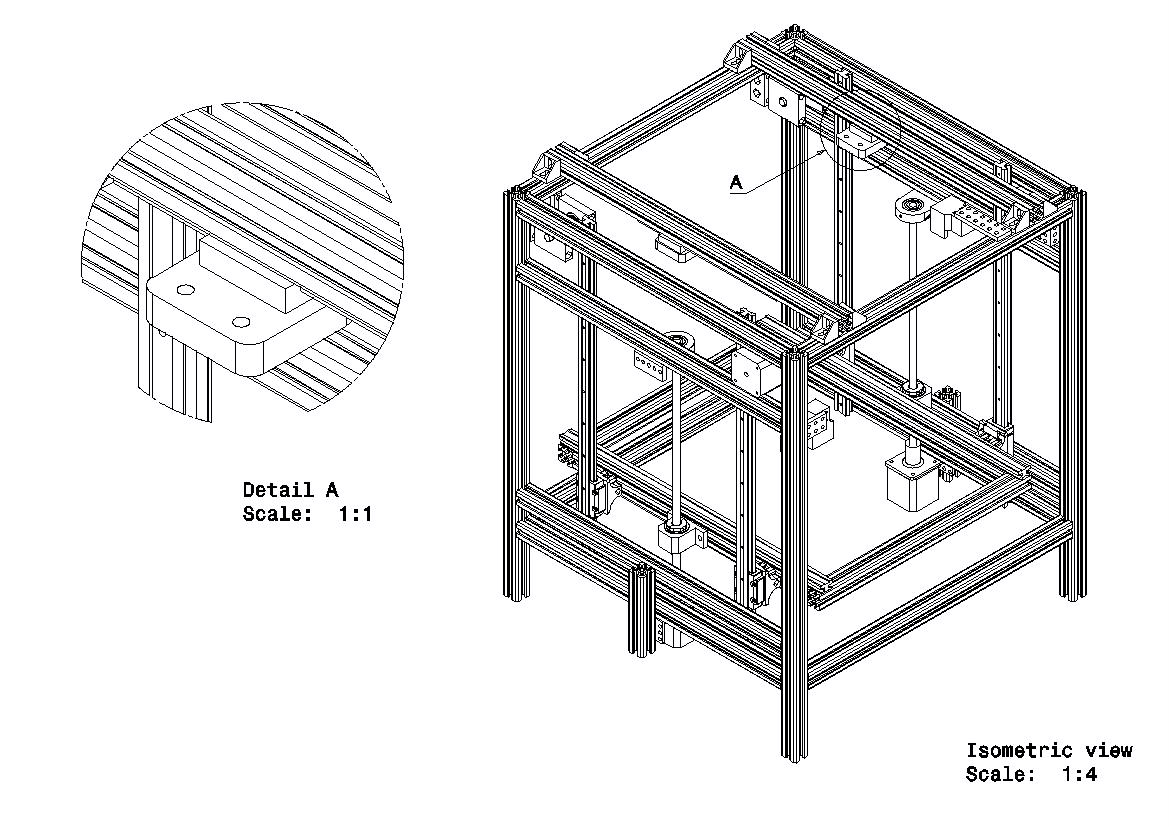
Prototipo_11/Planos/EnsamXYP1.jpg
