NervenCid/UNAL_FDM/Prototipo_11/Planos/EstructBMF1.jpg

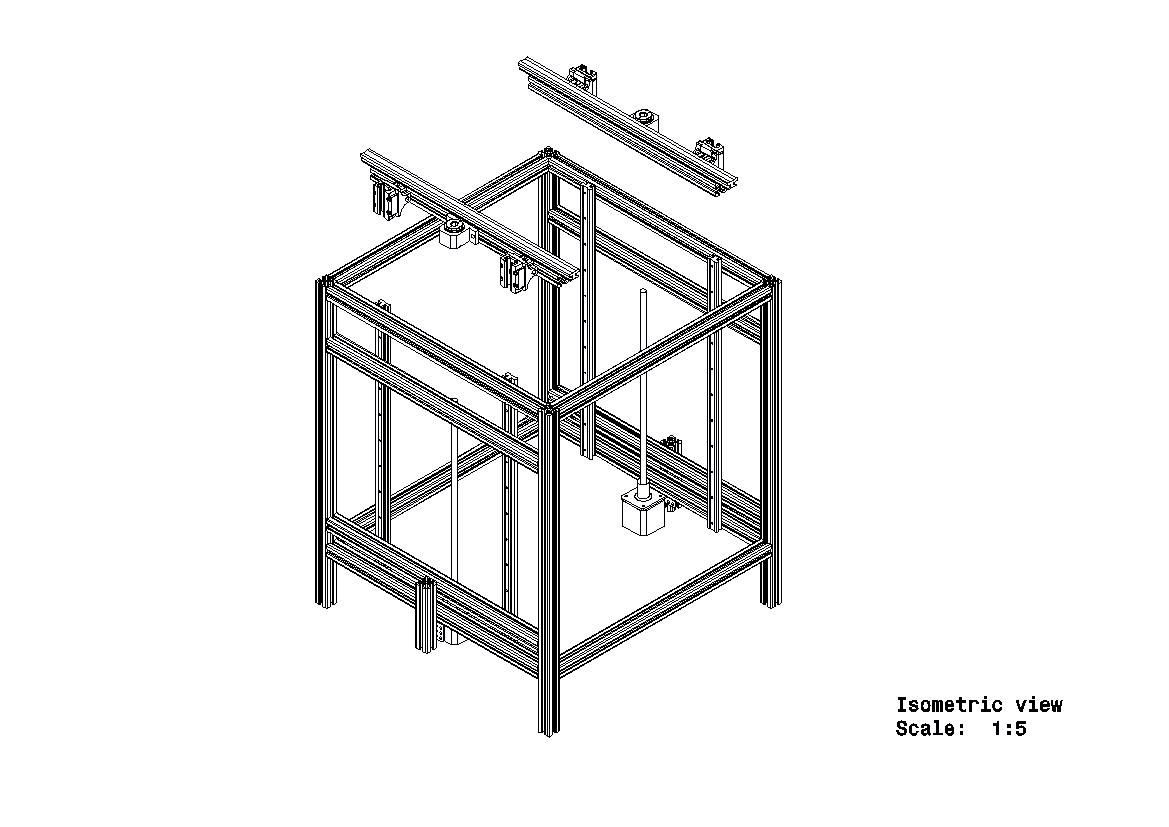
Prototipo_11/Planos/EstructBMF1.jpg
