NervenCid/UNAL_FDM/Prototipo_11/Planos/EstructBMF3.jpg

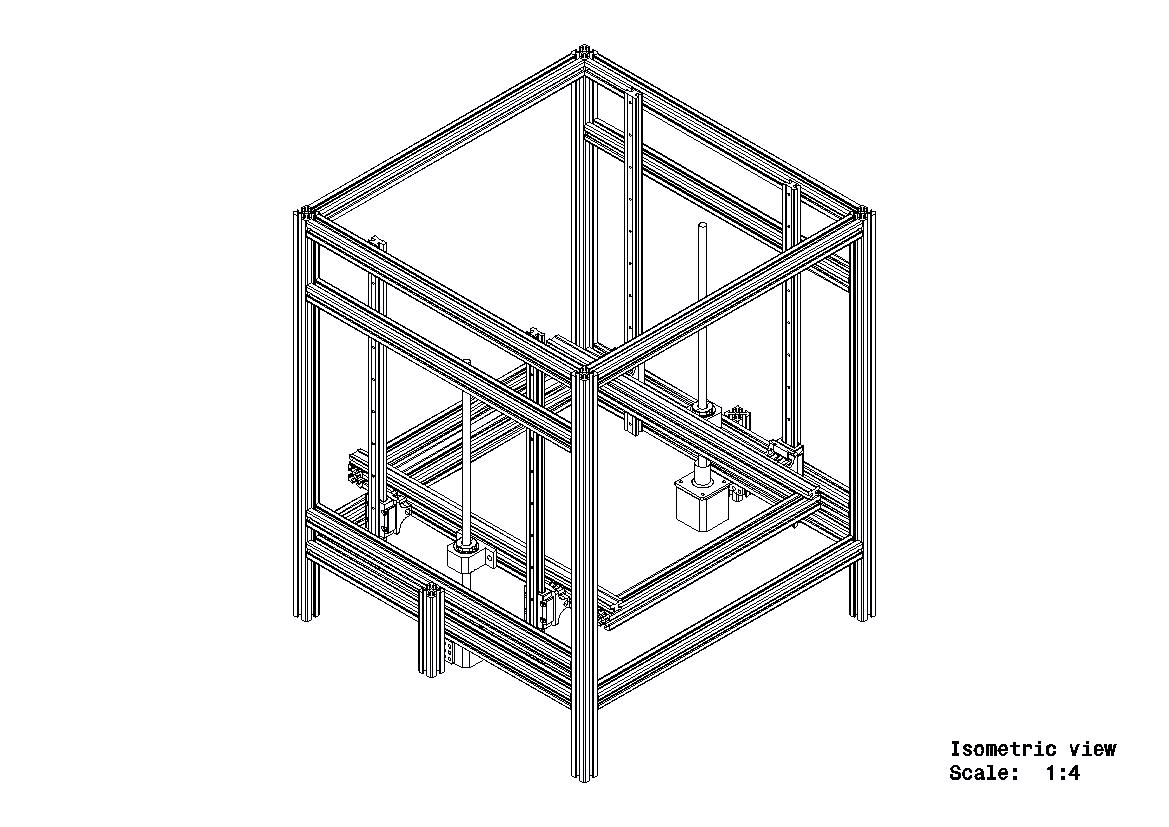
Prototipo_11/Planos/EstructBMF3.jpg
