NervenCid/UNAL_FDM/Prototipo_11/Planos/EstructPatin.jpg

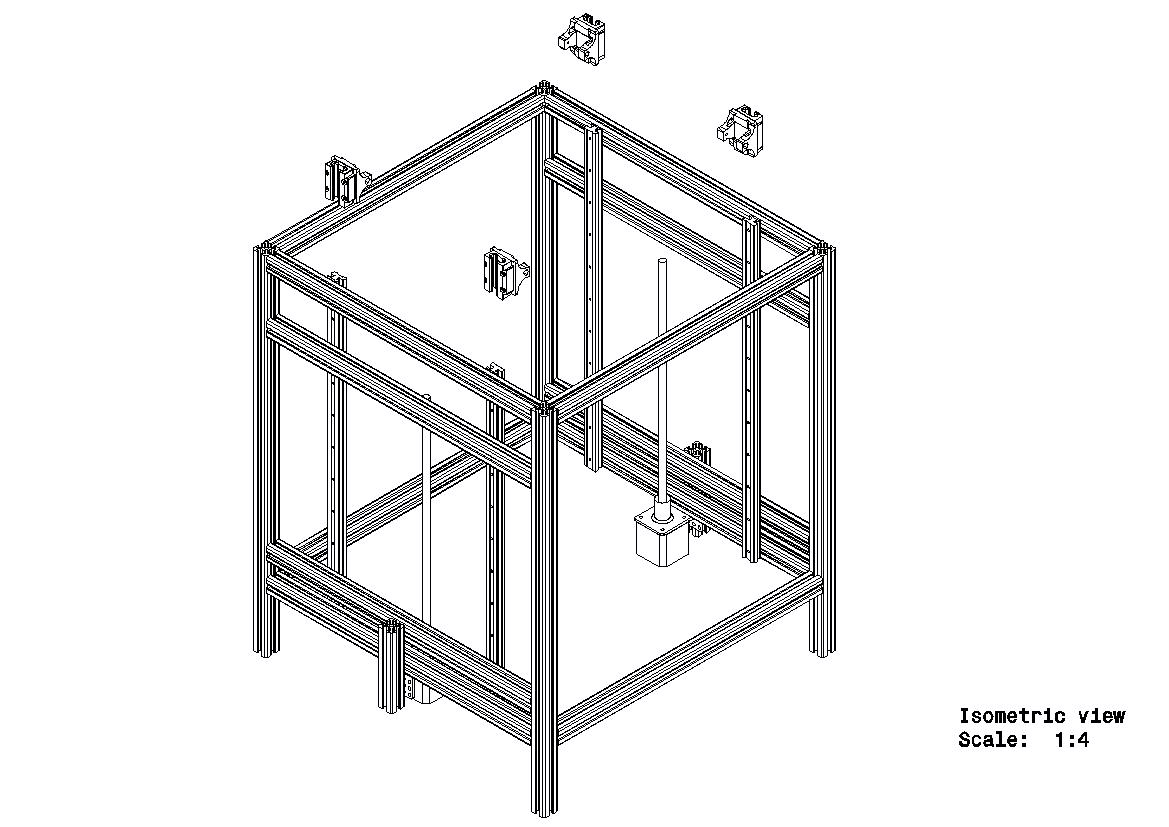
Prototipo_11/Planos/EstructPatin.jpg
