NervenCid/UNAL_FDM/Prototipo_11/Planos/EstructuraIsometrica.jpg

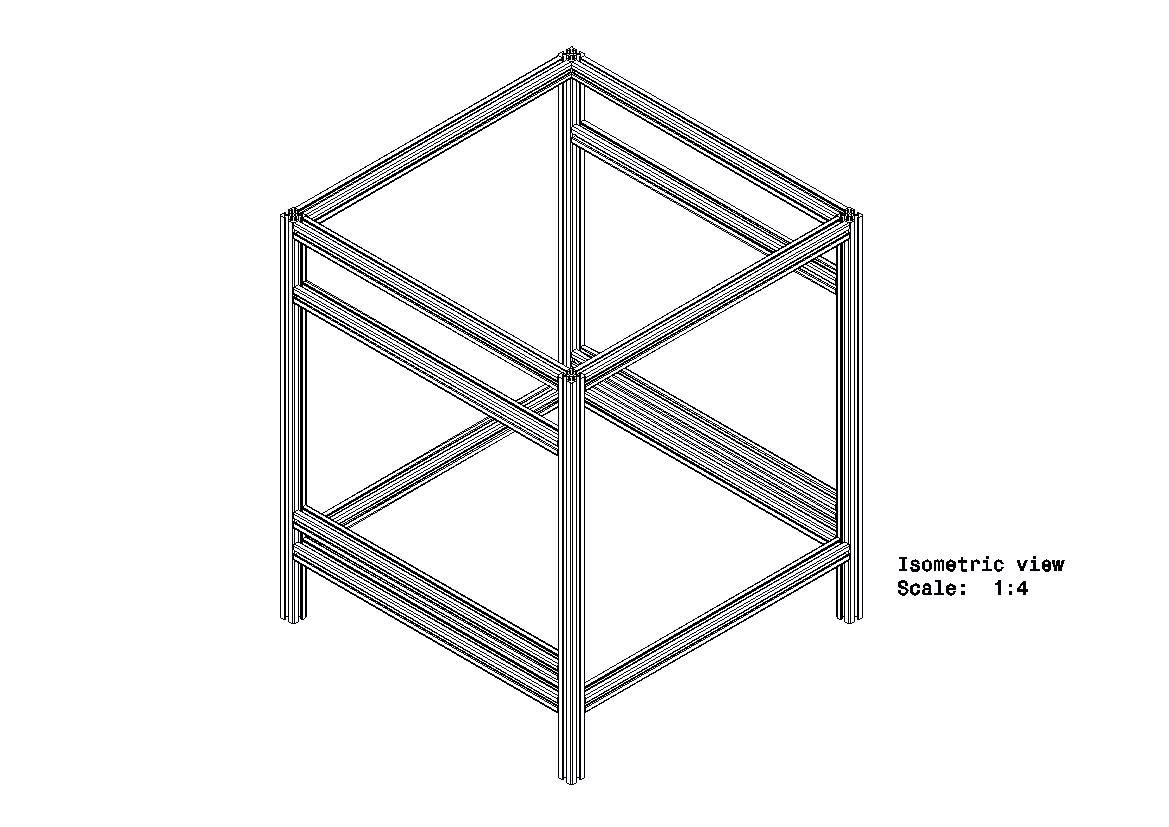
Prototipo_11/Planos/EstructuraIsometrica.jpg
