NervenCid/UNAL_FDM/Prototipo_11/Planos/ExtructEjeXYF1.jpg

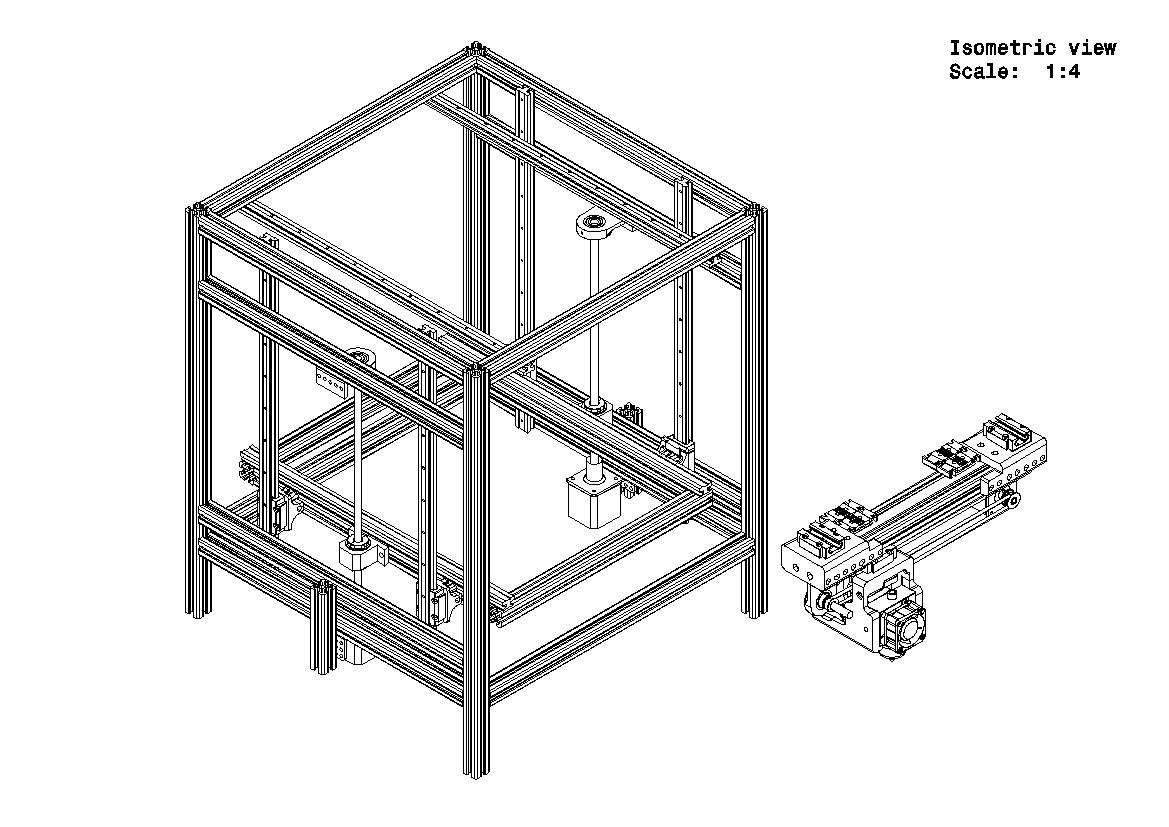
Prototipo_11/Planos/ExtructEjeXYF1.jpg
