NervenCid/UNAL_FDM/Prototipo_11/Planos/ExtructEjeXYF2.jpg

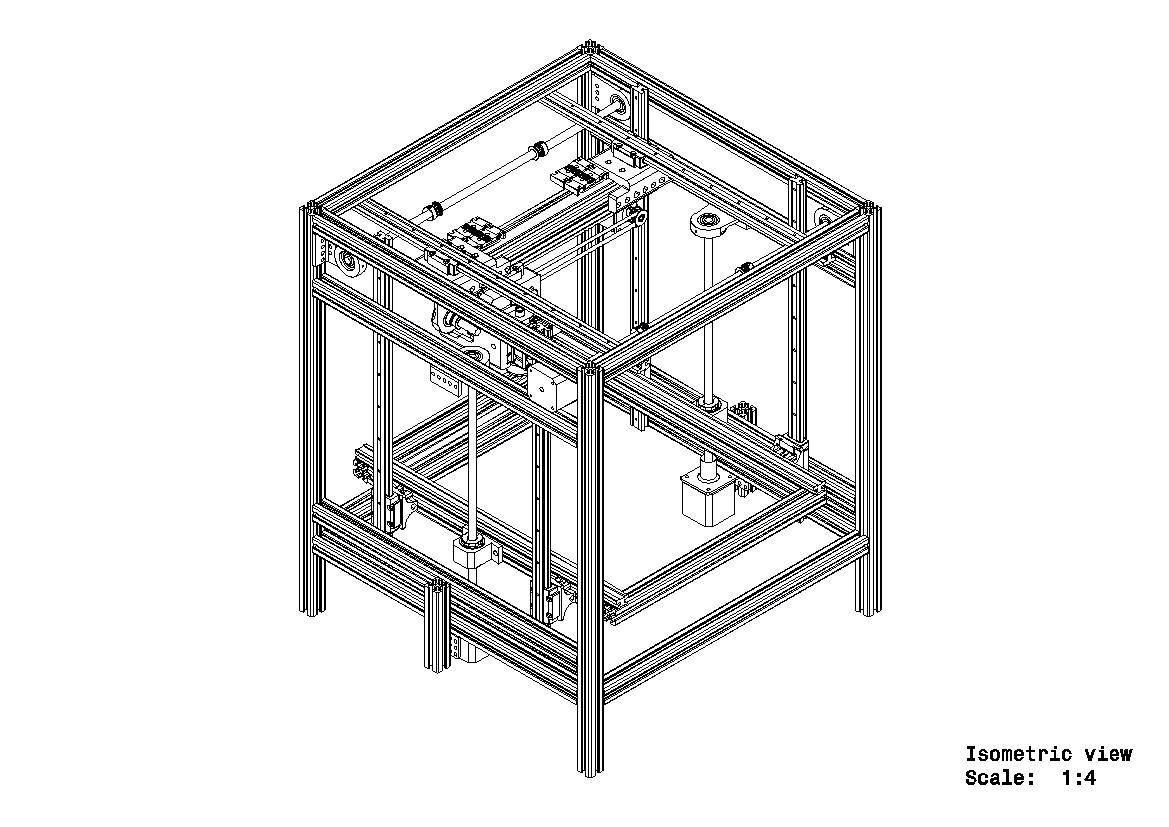
Prototipo_11/Planos/ExtructEjeXYF2.jpg
