NervenCid/UNAL_FDM/Prototipo_11/Planos/Extrusor.jpg

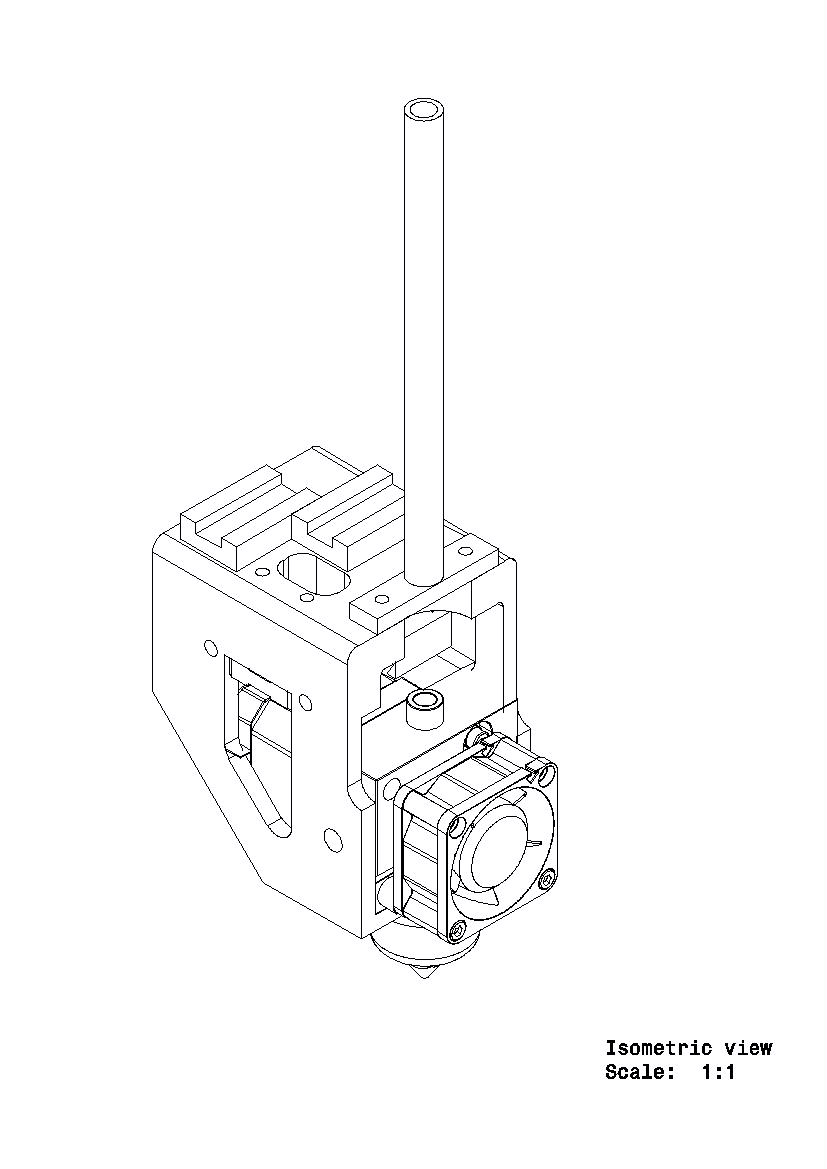
Prototipo_11/Planos/Extrusor.jpg
