NervenCid/UNAL_FDM/Prototipo_11/Planos/ExtrusorExplosionado.jpg

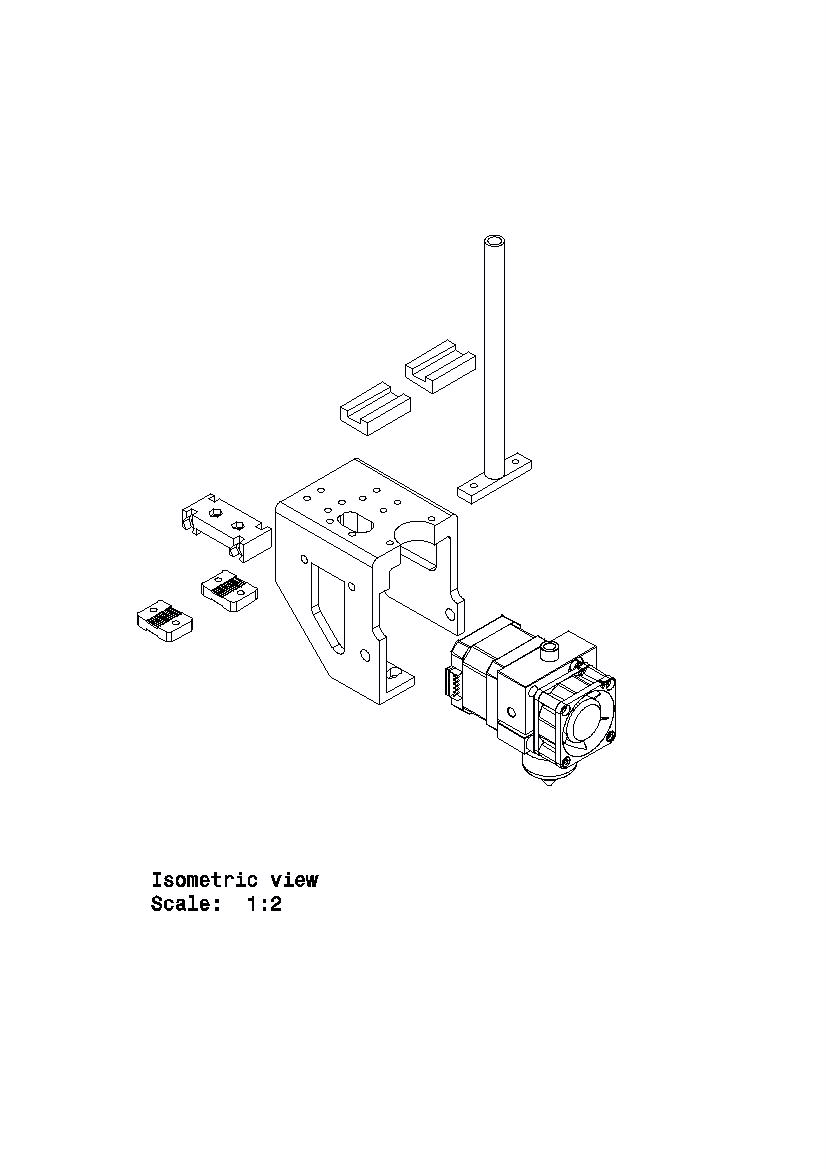
Prototipo_11/Planos/ExtrusorExplosionado.jpg
