NervenCid/UNAL_FDM/Prototipo_11/Planos/HBP.jpg

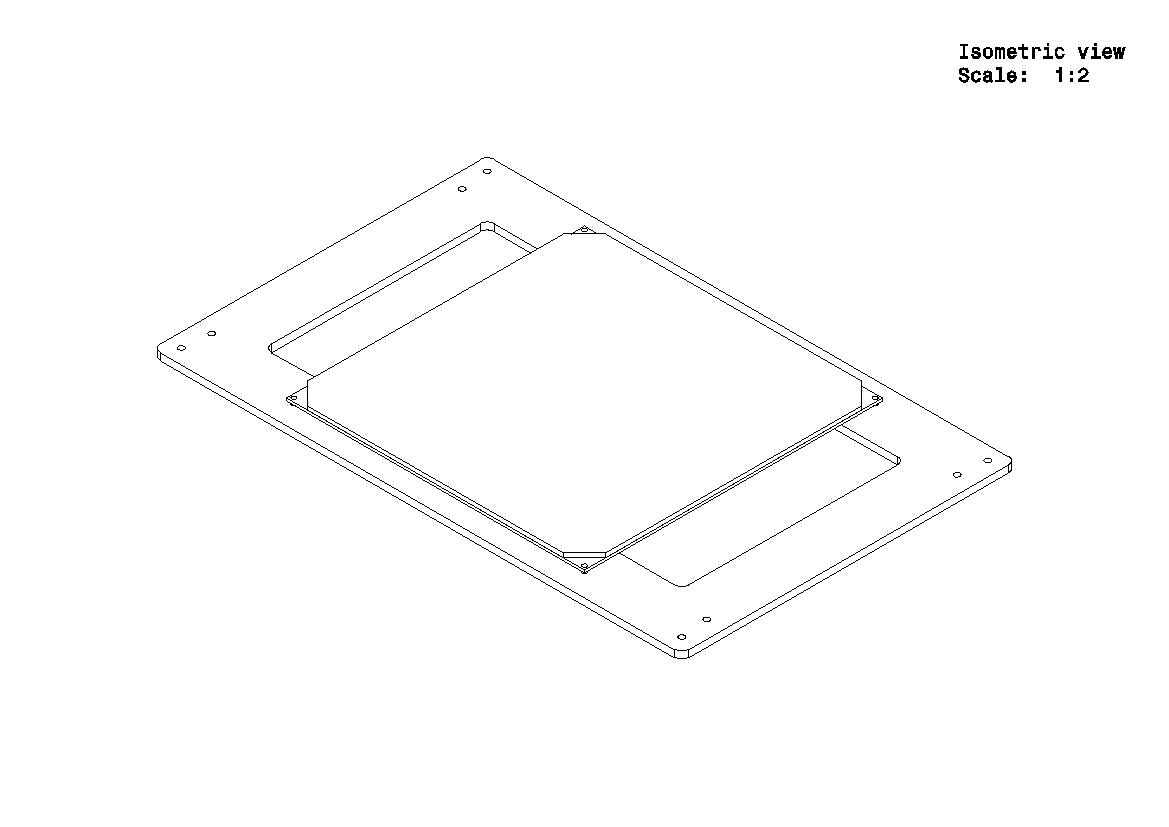
Prototipo_11/Planos/HBP.jpg
