NervenCid/UNAL_FDM/Prototipo_11/Planos/HBPExplo.jpg

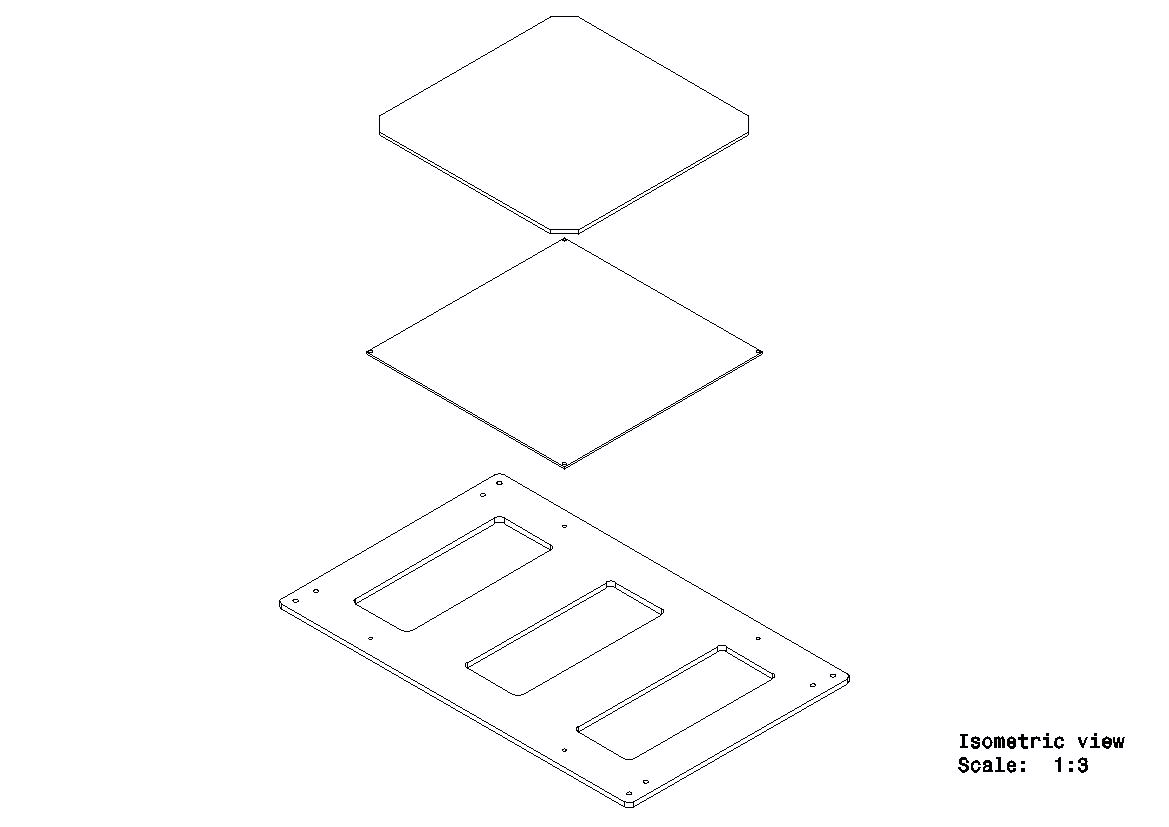
Prototipo_11/Planos/HBPExplo.jpg
