NervenCid/UNAL_FDM/Prototipo_11/Planos/IsometricaExplos.jpg

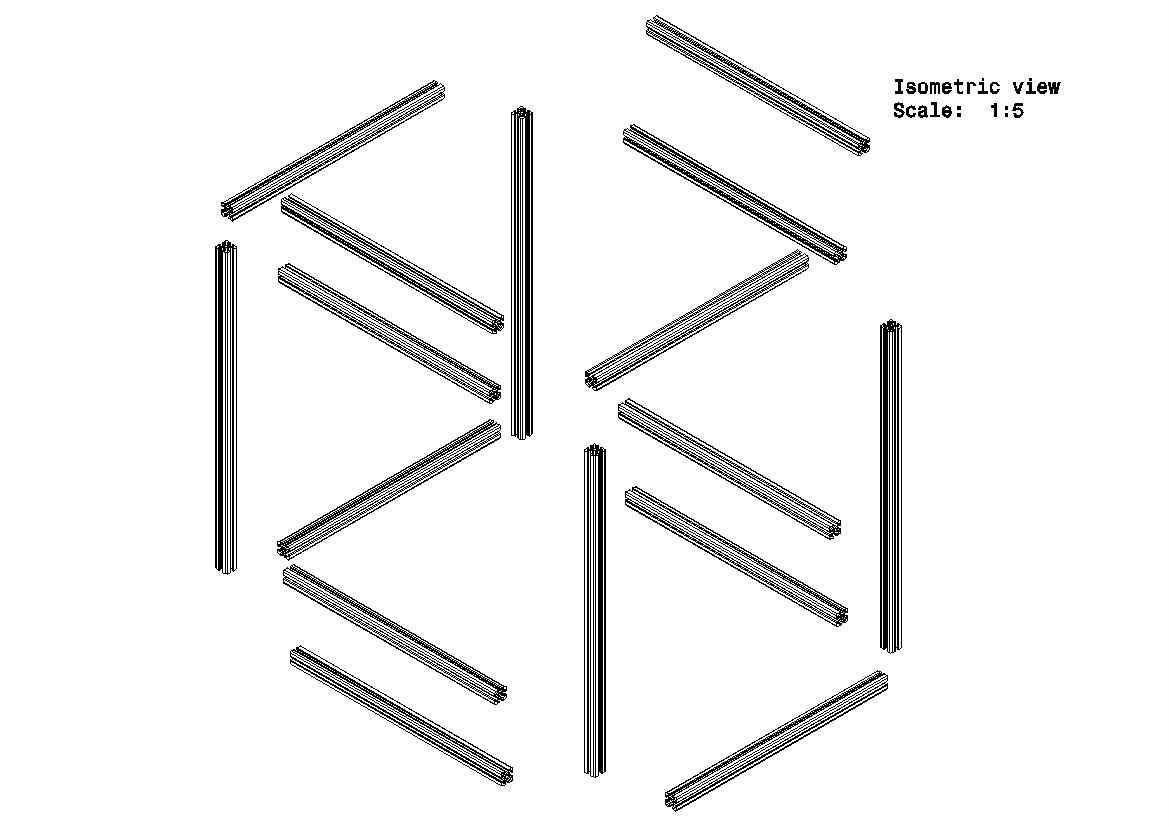
Prototipo_11/Planos/IsometricaExplos.jpg
