NervenCid/UNAL_FDM/Prototipo_11/Planos/LaminaYTWExplo.jpg

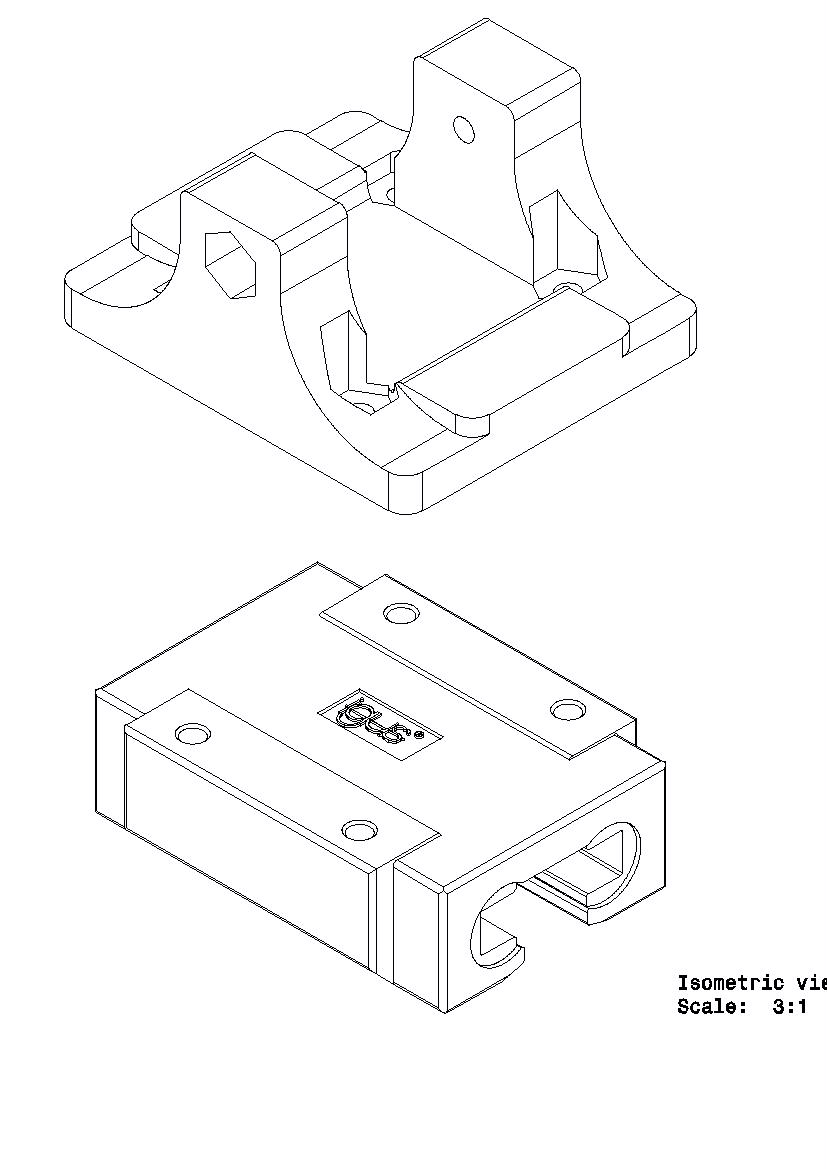
Prototipo_11/Planos/LaminaYTWExplo.jpg
