NervenCid/UNAL_FDM/Prototipo_11/Planos/LaminaYTWIsome.jpg

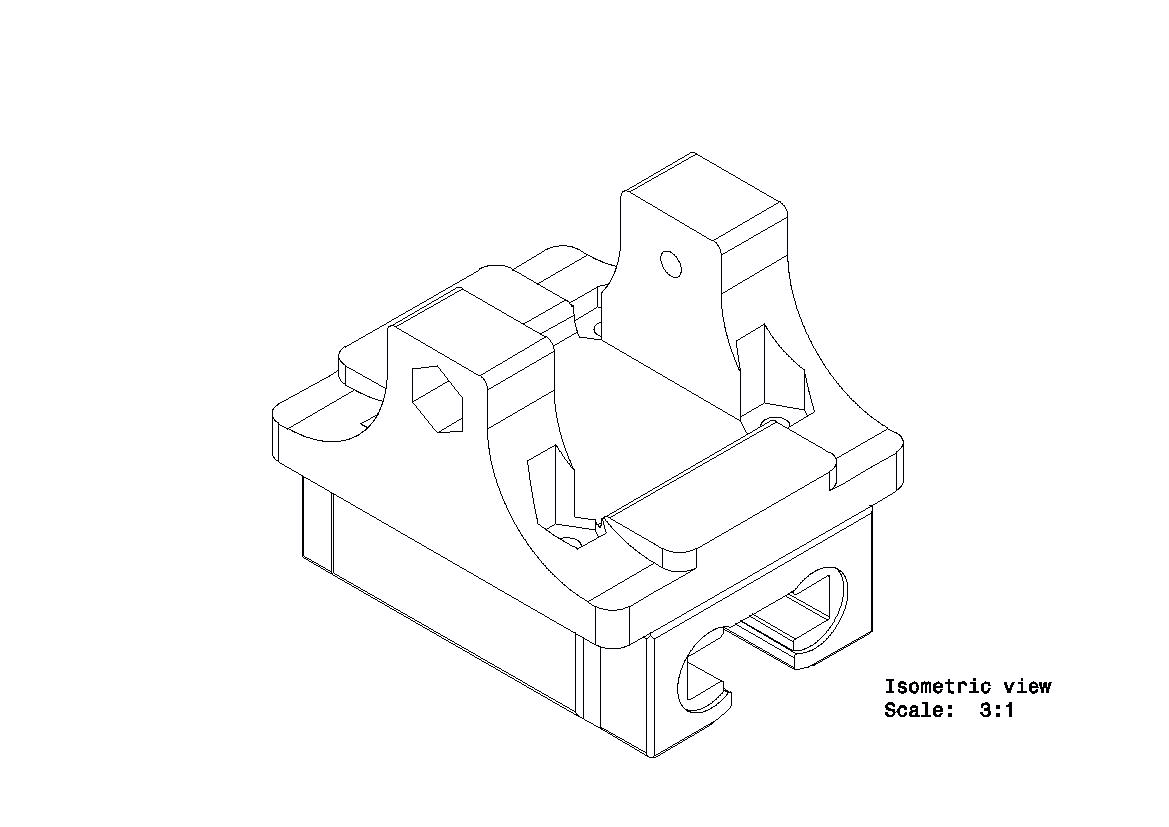
Prototipo_11/Planos/LaminaYTWIsome.jpg
