NervenCid/UNAL_FDM/Prototipo_11/Planos/PortaYNEMA17.jpg

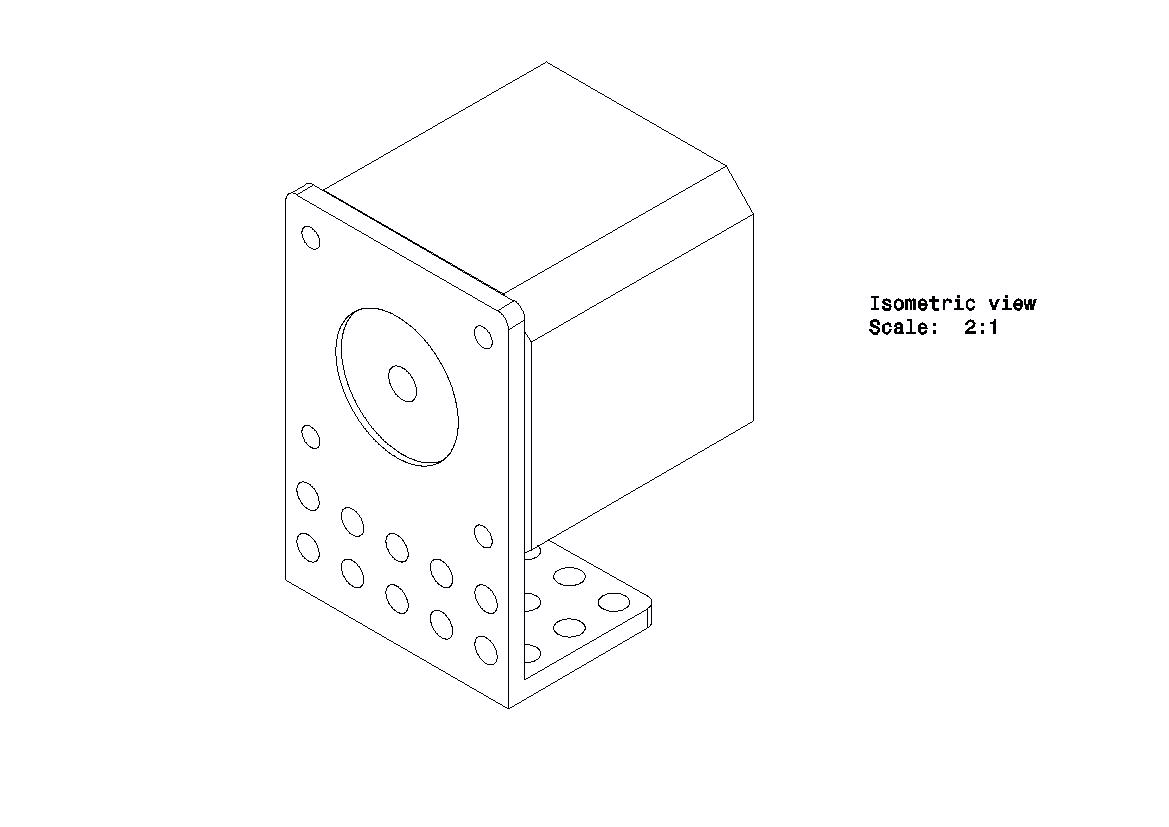
Prototipo_11/Planos/PortaYNEMA17.jpg
