NervenCid/UNAL_FDM/Prototipo_11/Planos/PortaYRod.jpg

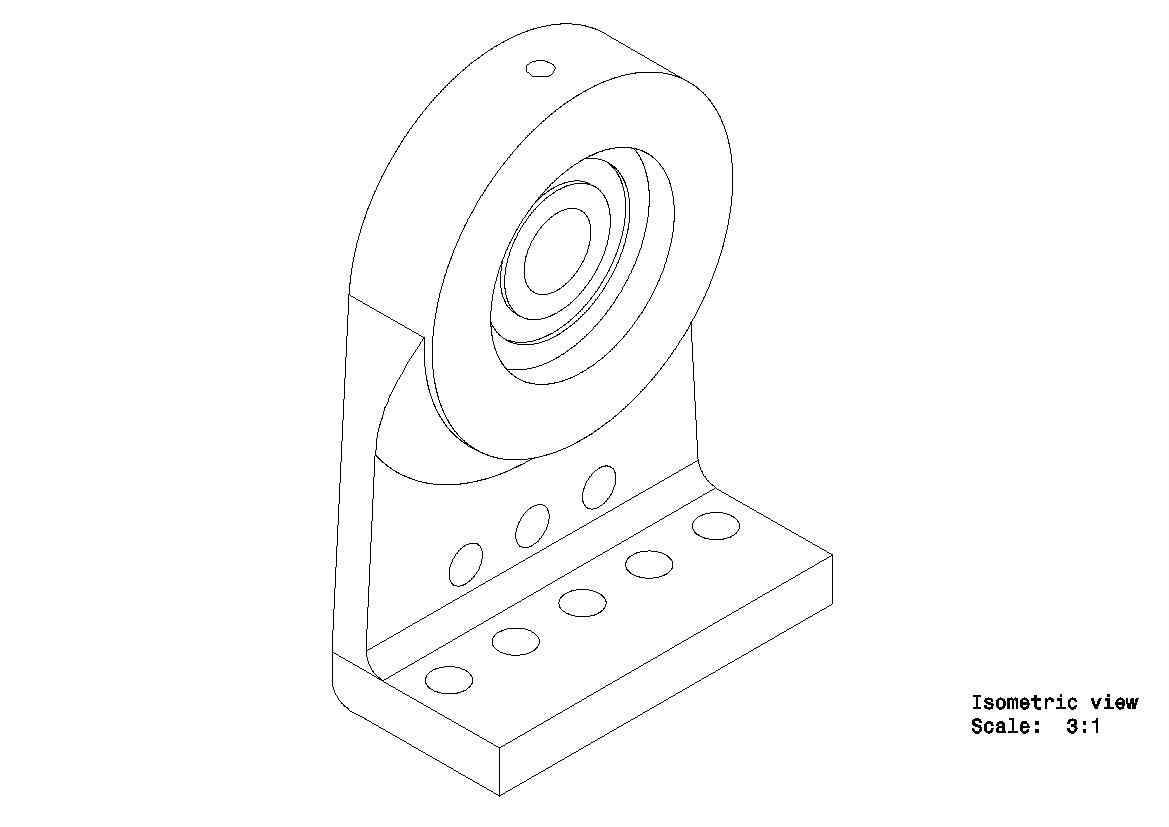
Prototipo_11/Planos/PortaYRod.jpg
