NervenCid/UNAL_FDM/Prototipo_11/Planos/SoporteGiratorioX.jpg

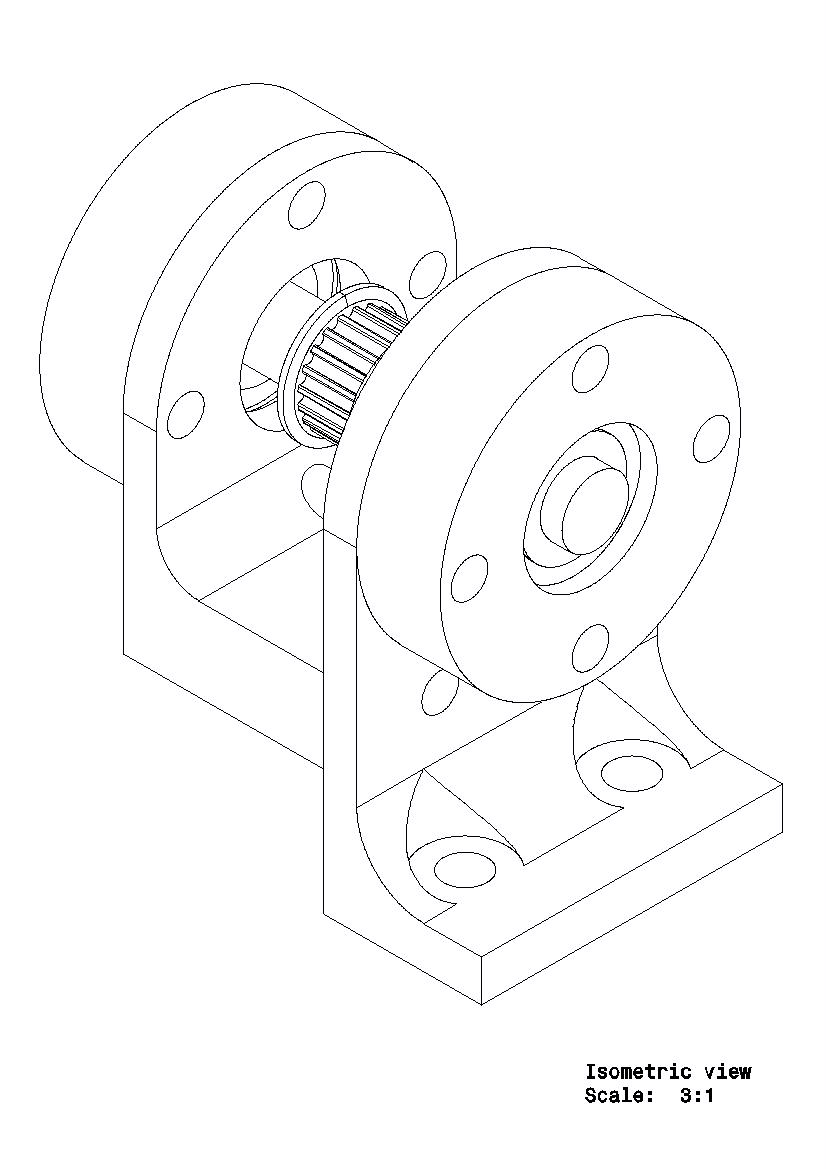
Prototipo_11/Planos/SoporteGiratorioX.jpg
