NervenCid/UNAL_FDM/Prototipo_11/Planos/SoporteGiratorioXExplosionado.jpg

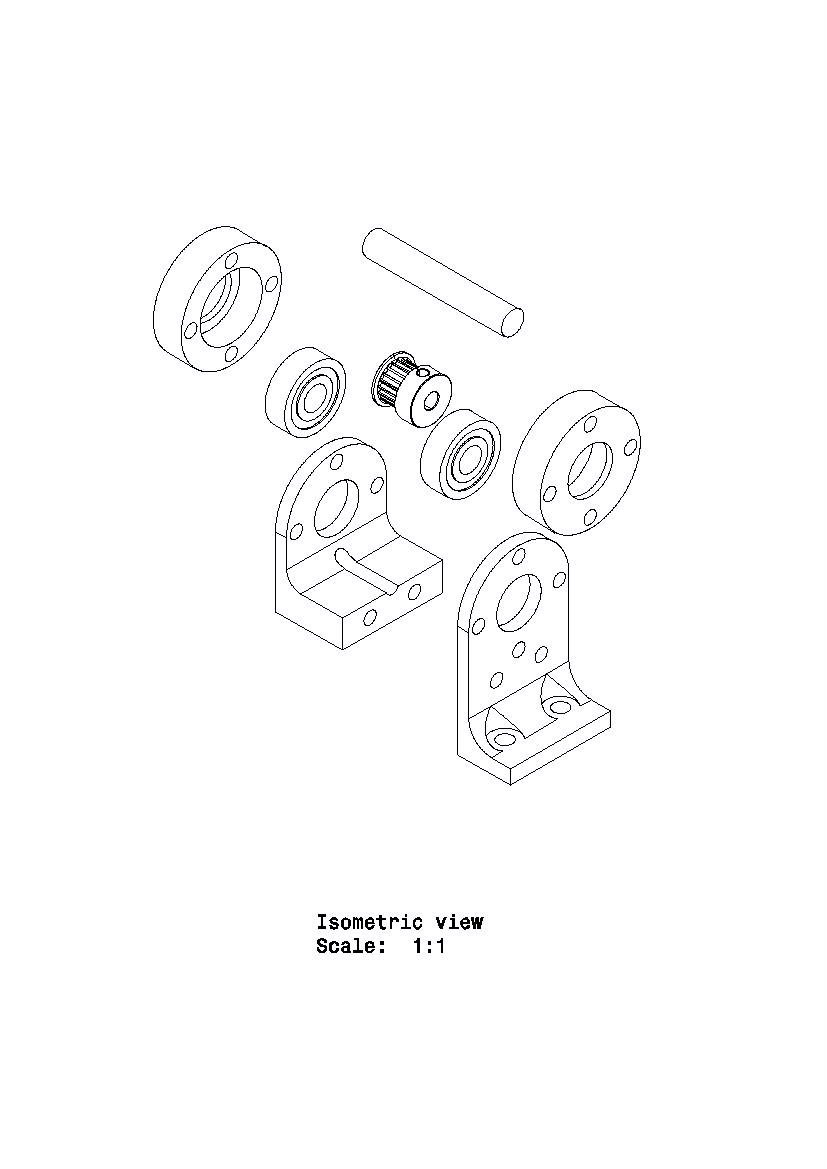
Prototipo_11/Planos/SoporteGiratorioXExplosionado.jpg
