NervenCid/UNAL_FDM/Prototipo_11/Planos/SoporteGiratorioY.jpg

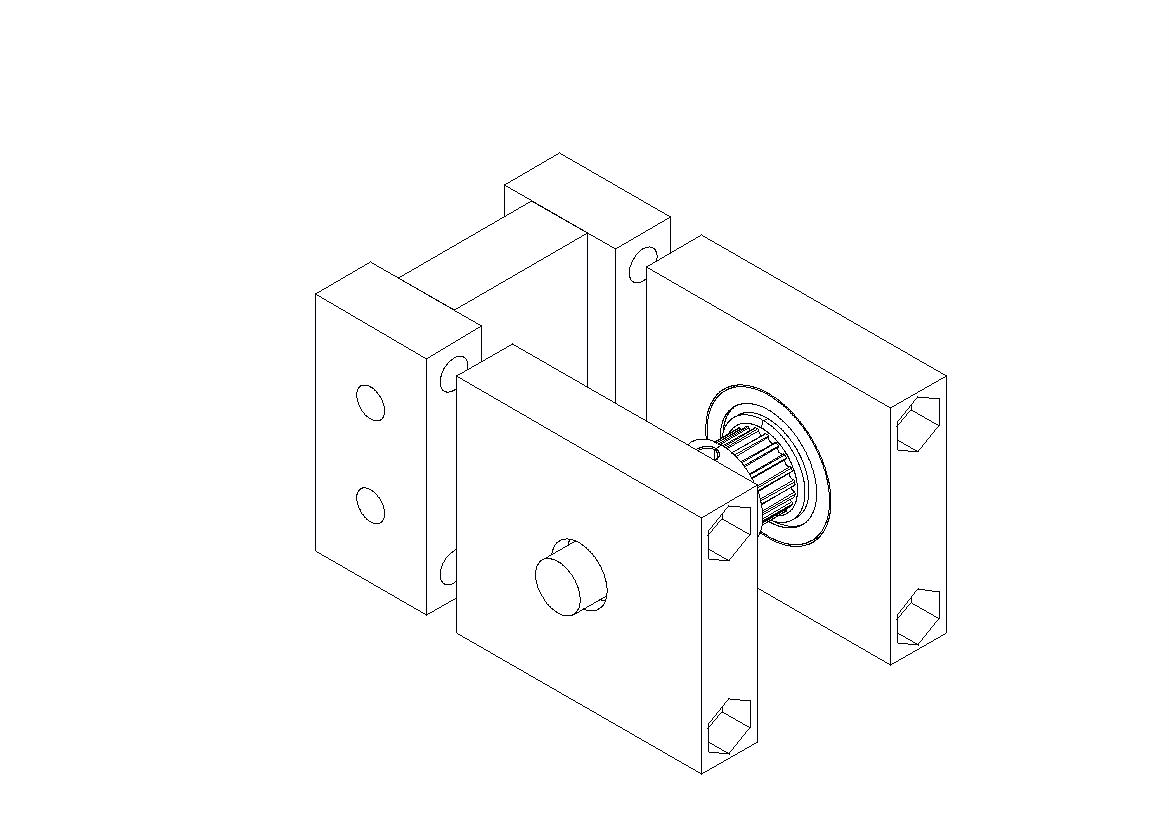
Prototipo_11/Planos/SoporteGiratorioY.jpg
