NervenCid/UNAL_FDM/Prototipo_11/Planos/Transfer.jpg

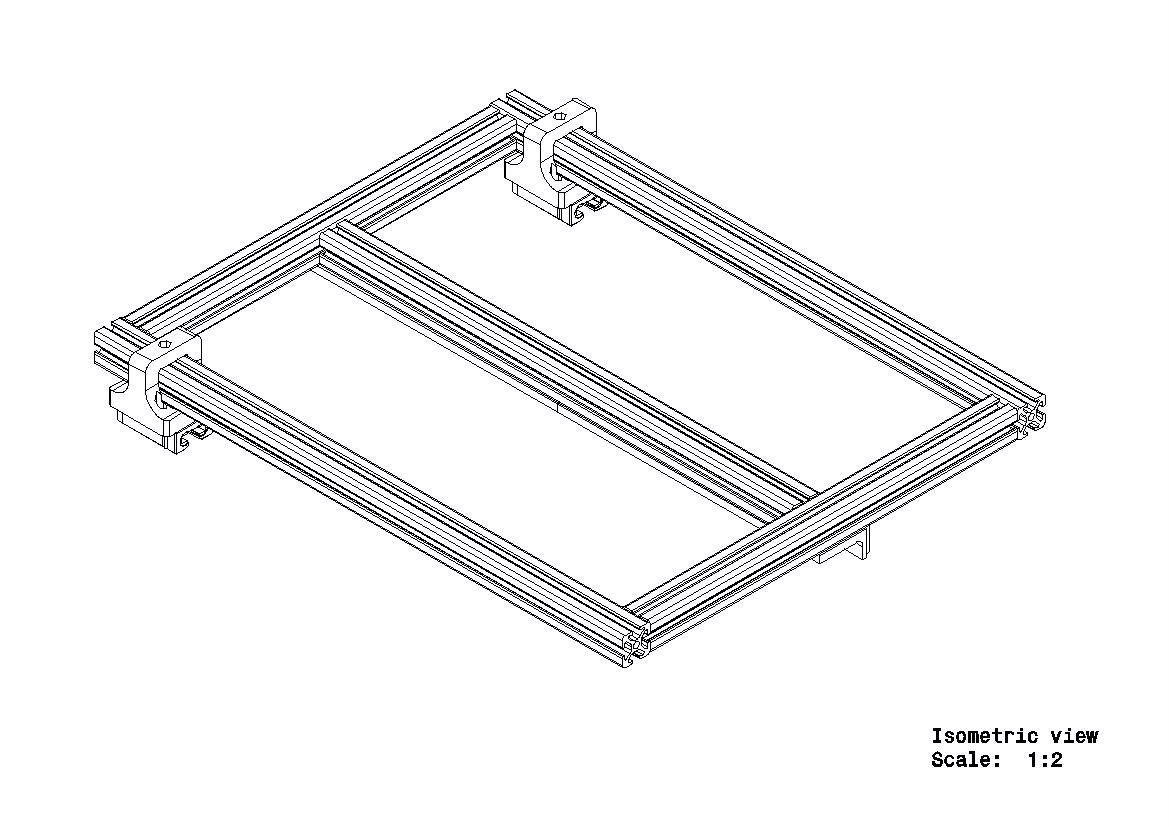
Prototipo_11/Planos/Transfer.jpg
