NervenCid/UNAL_FDM/Prototipo_11/Planos/UnionEstandar.jpg

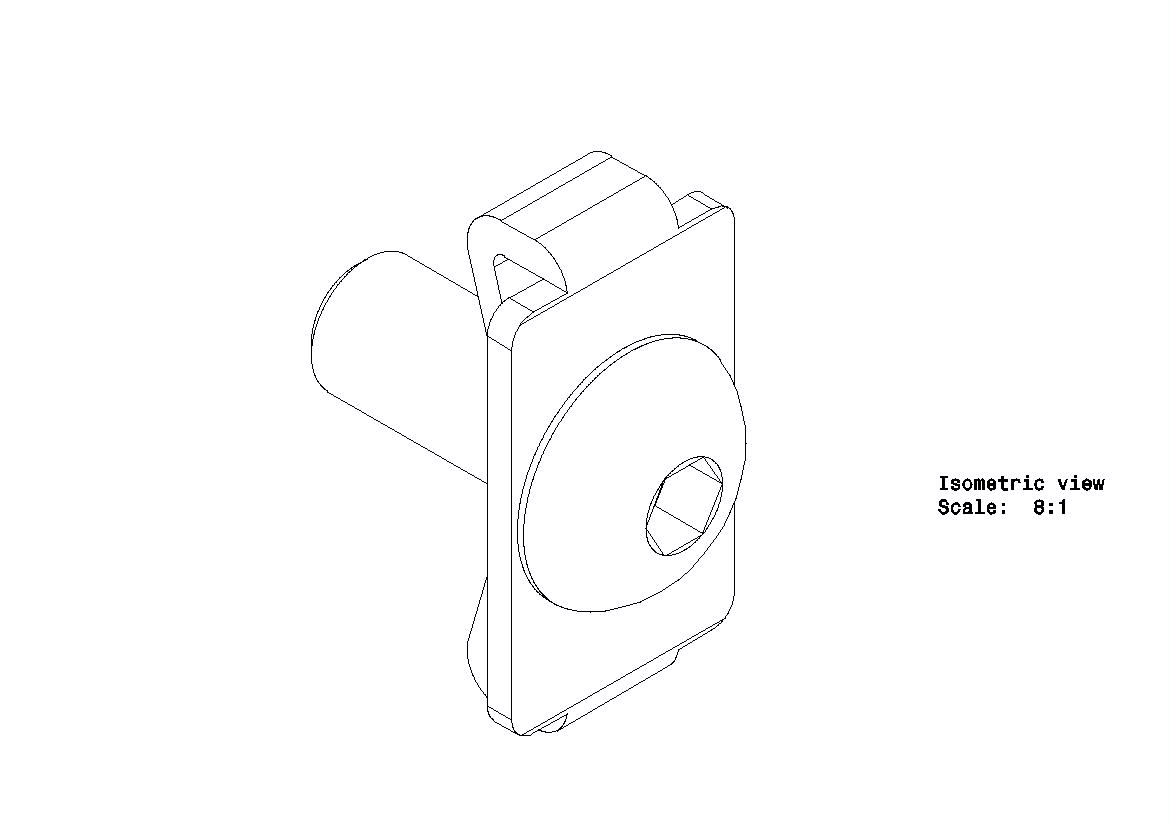
Prototipo_11/Planos/UnionEstandar.jpg
