NervenCid/UNAL_FDM/Prototipo_11/Tablero/Render.jpg

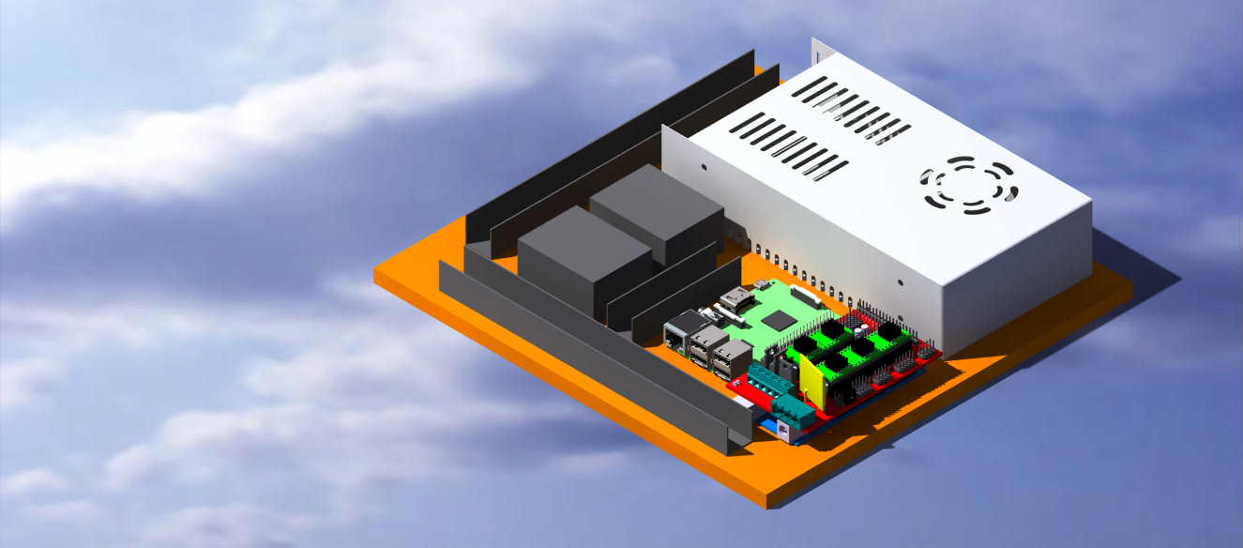
Prototipo_11/Tablero/Render.jpg
