NervenCid/UNAL_FDM/Prototipo_11/Cotizaciones y cuentas/Cuentas Ensamblaje_1.ods

Sheet: Precios Totales
No. | REFERENCIA | NOMBRE | CANTIDAD APROX (metros o unidades) | VALOR UNITARIO | VALOR TOTAL
1 | 0.0.448.04 | Perfil 5 20x20 Natural | 11 | 24116 | 265276
2 | 0.0.464.04 | Perfil 5 40x20 Natural | 1 | 74450 | 74450
3 | TS 04-15 | DrylinT Miniature Rails | 4 | 128277 | 513108
4 | 0.0.370.08 | Standard Fastering set 5 | 45 | 2498 | 112410
5 | TW 04-15 | DrylinT Miniature Carriage | 11 | 56052 | 616572
6 | 0.0.370.09 | Cap 5 20x20 black | 10 | 1396 | 13960
7 | 08.10.128.0 | Cadena Porta Cables | 1 | 114240 | 114240
8 | RGAS-JTRM-10x20 | Drylin lead screw nut | 2 | 152902 | 305804
9 | PTGSG-10x2-01-R-300-Z17 | Drylin SD Lead screw Drives, Trapezoidal lead screw with pin | 2 | 287928 | 575856
 |  |  |  | TOTAL GLOBAL | 2591676

Sheet: CANTIDADES PERFIL
ESTRUCTURA |  |  |  |  |  |  | Total Perfil 5 (mm) | Total Drylin T (mm)
No. | Referencia | Nombre | Medida unitaria (mm) | Cantidad | Medida Total (mm) |  | 6610 | 2520
1 | 0.0.448.04 | Perfil 5 20x20 (500 mm) | 500 | 4 | 2000
2 | 0.0.448.04 | Perfil 5 20x20 (380 mm) | 380 | 12 | 4560
3 | 0.0.448.04 | Perfil 5 20x20(50 mm) | 50 | 1 | 50
4 | TS 04-15 | DrylinT Miniature Rails (420 mm) | 420 | 6 | 2520
BASE MOVIL |  |  |  |  |  |  | Total Perfil 5 (mm) | Total Drylin T (mm)
No. | Referencia | Nombre | Medida unitaria (mm) | Cantidad | Medida Total (mm) |  | 1820 | 840
1 | 0.0.448.04 | Perfil 5 20x20 (304 mm) | 304 | 2 | 608
2 | 0.0.448.04 | Perfil 5 20x20 (380 mm) | 380 | 3 | 1140
3 | 0.0.448.04 | Perfil 5 20x20(18 mm) | 18 | 4 | 72
4 | TS 04-15 | DrylinT Miniature Rails (420 mm) | 420 | 2 | 840
EJE X |  |  |  |  |  |  | Total Perfil 5 (40x20) (mm) | Total Drylin T (mm)
No. | Referencia | Nombre | Medida unitaria (mm) | Cantidad | Medida Total (mm) |  | 300 | 300
1 | 0.0.464.04 | Perfil 5 40x20 (300 mm) | 300 | 1 | 300
2 | TS 04-15 | DrylinT Miniature Rails (300 mm) | 300 | 1 | 300
PLATAFORMA MOVIL |  |  |  |  |  |  | Total Perfil 5 (mm) | Total Drylin T (mm)
No. | Referencia | Nombre | Medida unitaria (mm) | Cantidad | Medida Total (mm) |  | 1628 | 0
1 | 0.0.448.04 | Perfil 5 20x20 (380 mm) | 380 | 2 | 760
2 | 0.0.448.04 | Perfil 5 20x20 (340 mm) | 340 | 1 | 340
3 | 0.0.448.04 | Perfil 5 20x20 (264 mm) | 264 | 2 | 528
 |  |  |  |  |  |  | GLOBAL TOTAL
 |  |  |  |  |  |  | Total Perfil 5 (mm) | Total Perfil 5 (40x20) (mm) | Total Drylin T (mm)
 |  |  |  |  |  |  | 10058 | 300 | 3660
 |  |  |  |  |  | APROX (metros) | 11 | 1 | 4
