NervenCid/UNAL_FDM/Prototipo_11/Faltantes.xlsx

Item | Cantidad | Costo
Guias lineales THK | 2 | $130000
Patin adicional THK | 2 | $20000
Relay DC-DC 25 A | 1 | $235000
Soportes cable | 1 | N/A
Soporte RaspBerry | 1 | N/A
