NervenCid/UNAL_FDM/Prototipo_11/Ensamblaje_2.stp

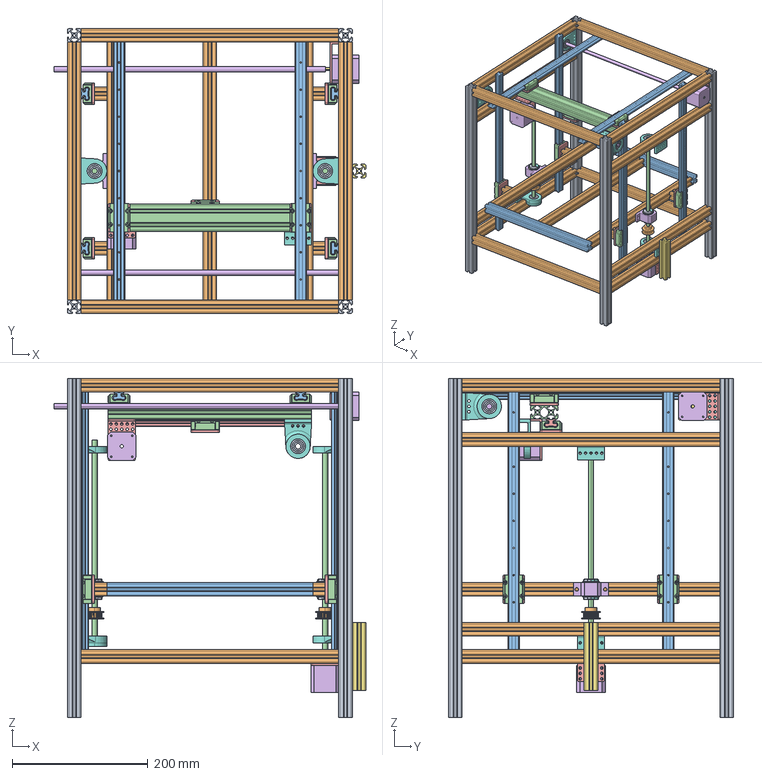
[picture p81: CAD file, 2017-09-23]
Prototipo_11/Ensamblaje_2.stp
459.7 x 420.0 x 500.0 mm
