NervenCid/UNAL_FDM/Prototipo_11/Accesorios_IGUS/BB_608_B180_10_GL_2.stp

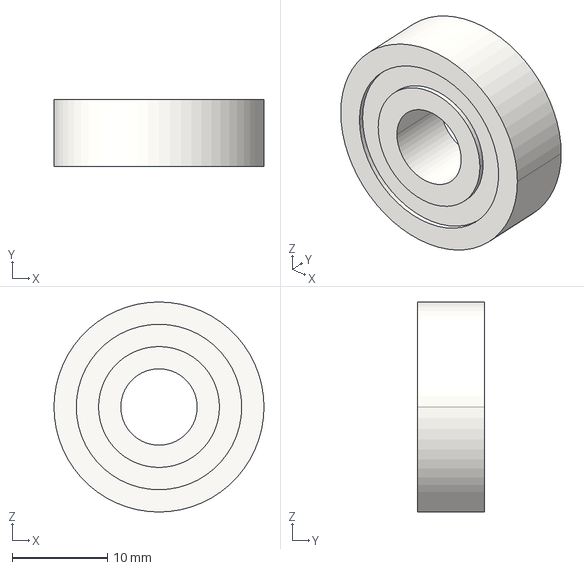
[picture p82: CAD file, 2017-09-23]
Prototipo_11/Accesorios_IGUS/BB_608_B180_10_GL_2.stp
22.0 x 7.00 x 22.0 mm
