NervenCid/UNAL_FDM/Prototipo_11/ExtrusorPorta.stp

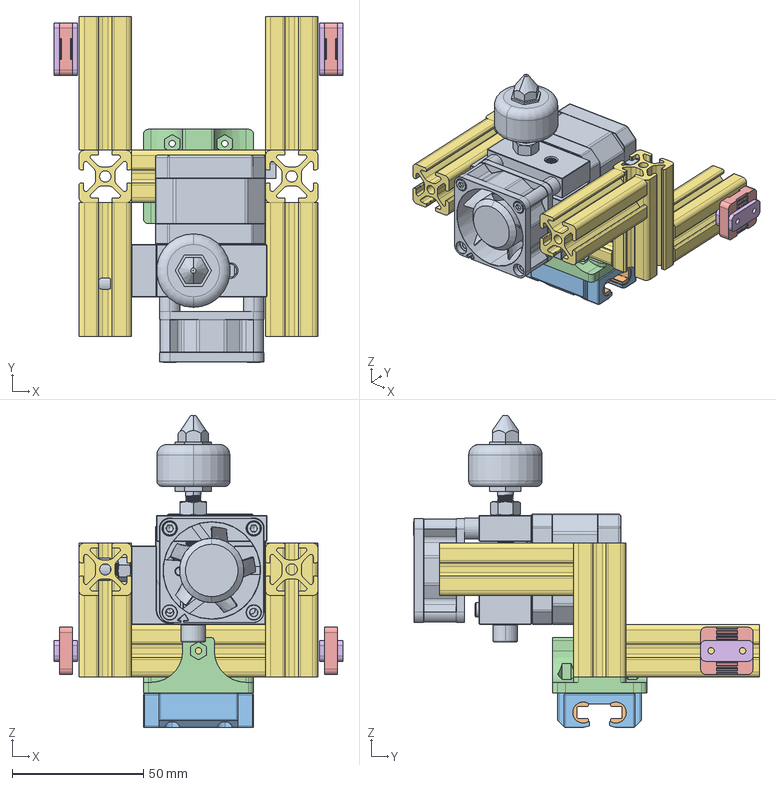
[picture p83: CAD file, 2017-09-23]
Prototipo_11/ExtrusorPorta.stp
110.0 x 131.9 x 118.8 mm
