NervenCid/UNAL_FDM/Prototipo_11/Otros_Accesorios/SC8UU.stp

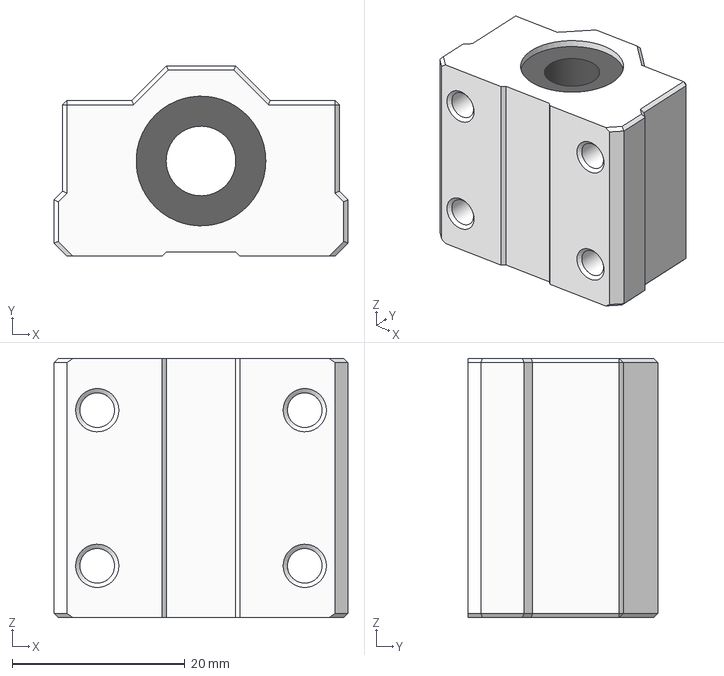
[picture p84: CAD file, 2017-09-23]
Prototipo_11/Otros_Accesorios/SC8UU.stp
34.0 x 22.0 x 30.0 mm
