NervenCid/UNAL_FDM/Prototipo_11/Piezas_Impresas/Lamina_Acople_4mm.stp

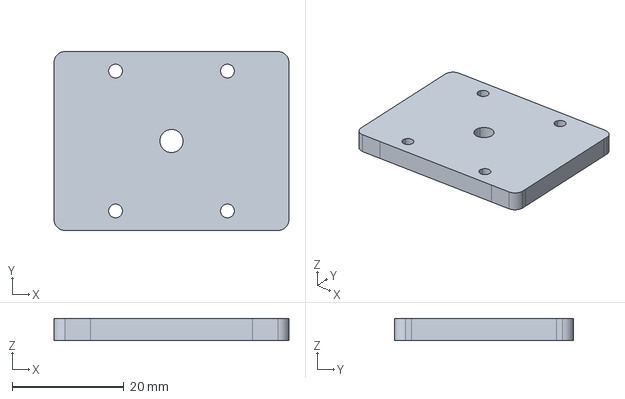
[picture p85: CAD file, 2017-09-23]
Prototipo_11/Piezas_Impresas/Lamina_Acople_4mm.stp
42.0 x 32.0 x 4.00 mm
