NervenCid/UNAL_FDM/Prototipo_11/PortaRollo/UnionCarrEs.stl

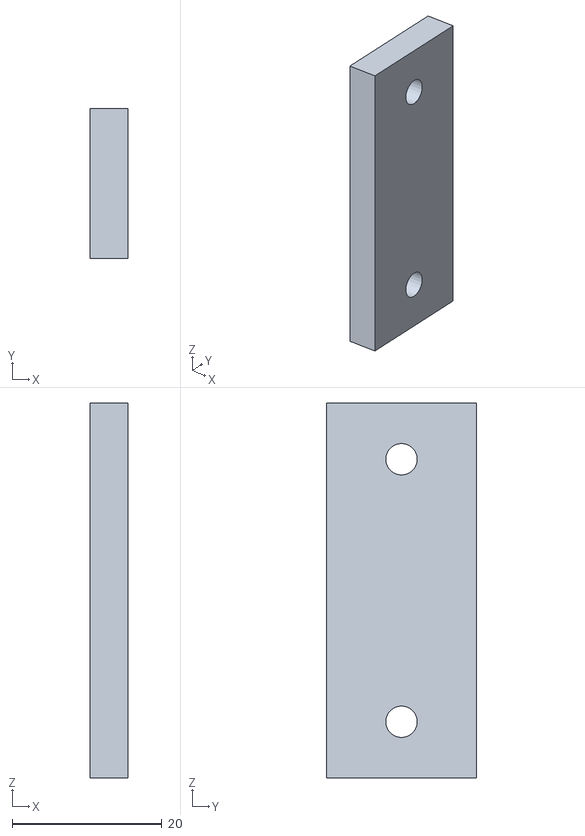
[picture p86: CAD file, 2017-09-23]
Prototipo_11/PortaRollo/UnionCarrEs.stl
5.00 x 20.0 x 50.0
