NervenCid/UNAL_FDM/Prototipo_11/SoporteGiratorio/UnionAPerfil.stl

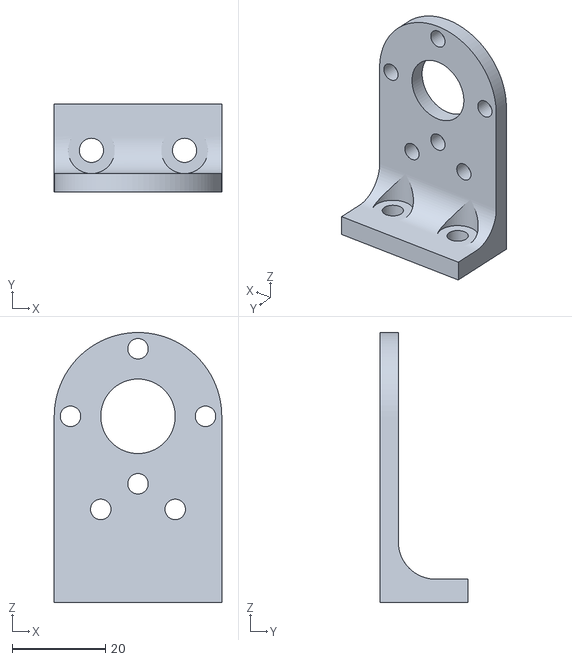
[picture p87: CAD file, 2017-09-23]
Prototipo_11/SoporteGiratorio/UnionAPerfil.stl
36.0 x 19.0 x 58.0
