NervenCid/UNAL_FDM/Prototipo_11/Tablero/Power_Supply.STEP

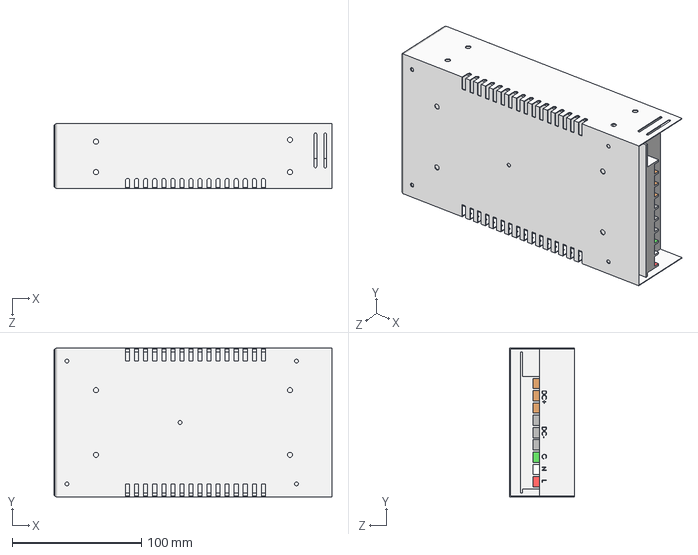
[picture p88: CAD file, 2017-09-23]
Prototipo_11/Tablero/Power_Supply.STEP
215.0 x 115.0 x 50.0 mm
