NervenCid/UNAL_FDM/Prototipo_11/Accesorios_IGUS/RGAS_JTRM_10x2_1.stp

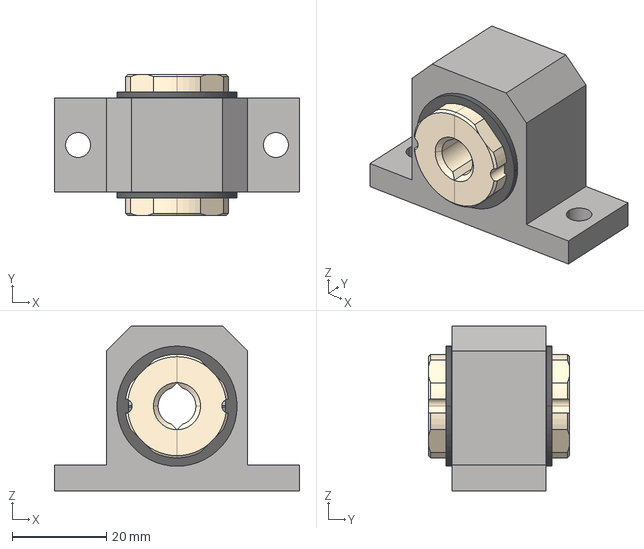
[picture p89: CAD file, 2017-09-23]
Prototipo_11/Accesorios_IGUS/RGAS_JTRM_10x2_1.stp
52.0 x 30.0 x 35.0 mm
