NervenCid/UNAL_FDM/Prototipo_11/Piezas_Impresas/Lamina_Fijacion.stl

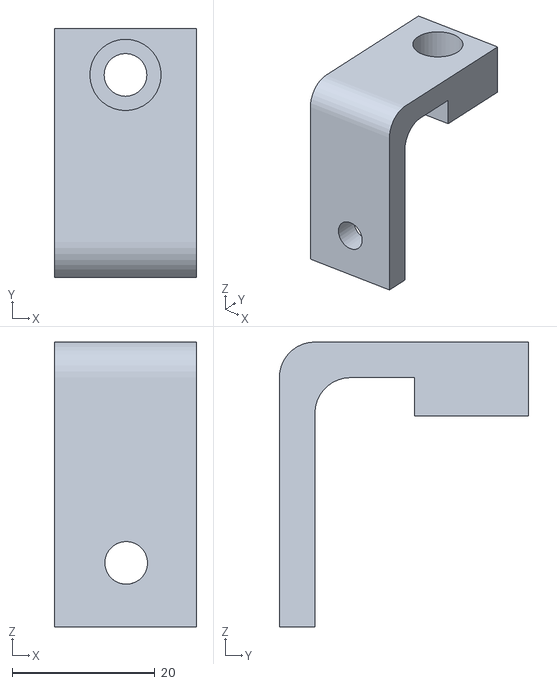
[picture p90: CAD file, 2017-09-23]
Prototipo_11/Piezas_Impresas/Lamina_Fijacion.stl
20.0 x 35.0 x 40.0
