NervenCid/UNAL_FDM/Prototipo_11/PortaRollo/UnionPerfCarr.stl

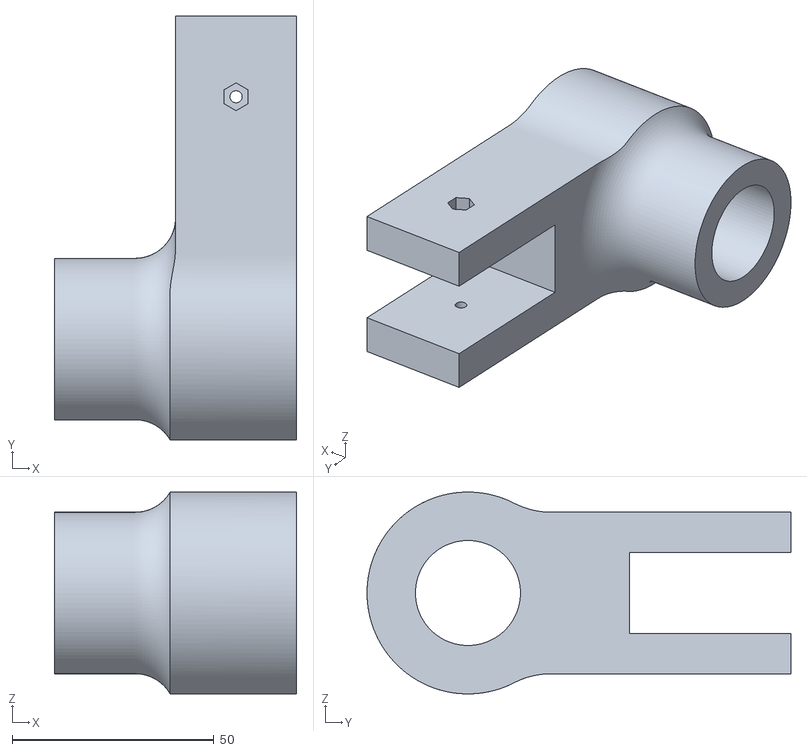
[picture p91: CAD file, 2017-09-23]
Prototipo_11/PortaRollo/UnionPerfCarr.stl
60.0 x 105.0 x 50.0
