NervenCid/UNAL_FDM/Prototipo_11/SoporteGiratorio/PortaBalinera.stl

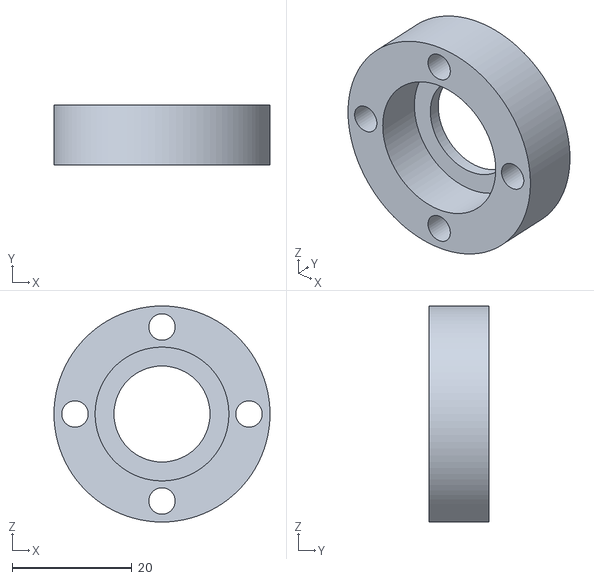
[picture p92: CAD file, 2017-09-23]
Prototipo_11/SoporteGiratorio/PortaBalinera.stl
36.0 x 10.0 x 36.0
