NervenCid/UNAL_FDM/Prototipo_11/Accesorios_IGUS/TW_04_15.stp

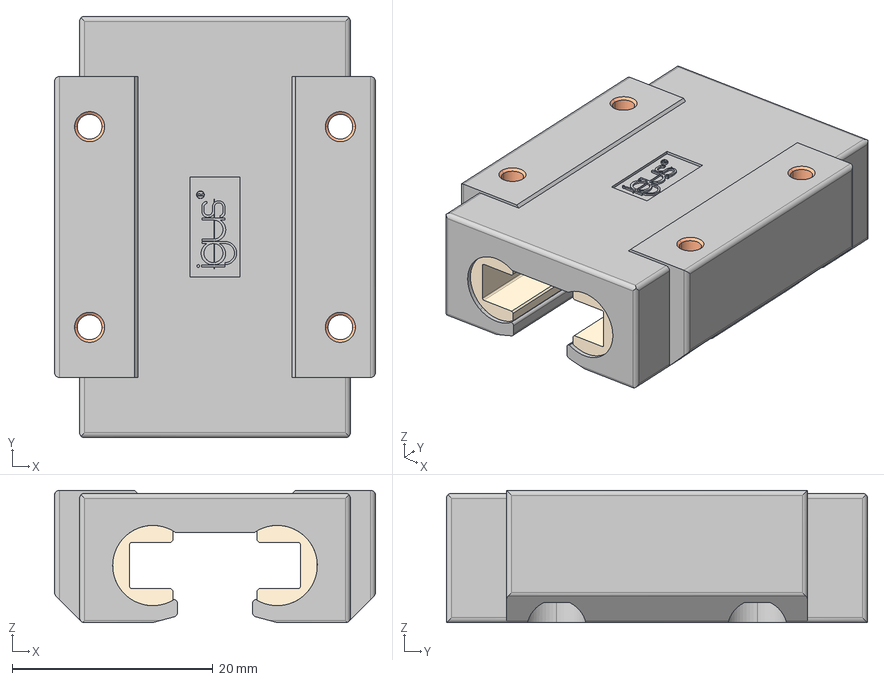
[picture p93: CAD file, 2017-09-23]
Prototipo_11/Accesorios_IGUS/TW_04_15.stp
32.0 x 42.0 x 13.2 mm
