NervenCid/UNAL_FDM/Prototipo_11/Base_Movil_1.stp

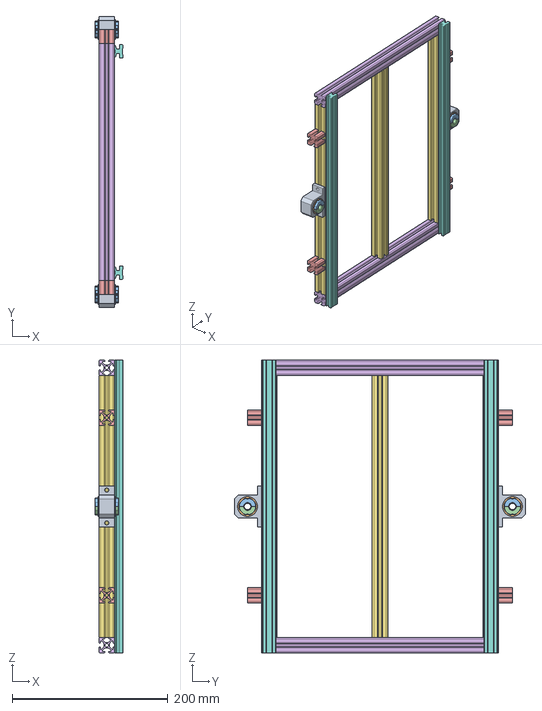
[picture p94: CAD file, 2017-09-23]
Prototipo_11/Base_Movil_1.stp
35.8 x 374.0 x 376.0 mm
