NervenCid/UNAL_FDM/Prototipo_11/PerfilesItem5/item_7000262_Profile_M_20x4_E_natural_L=20.stp

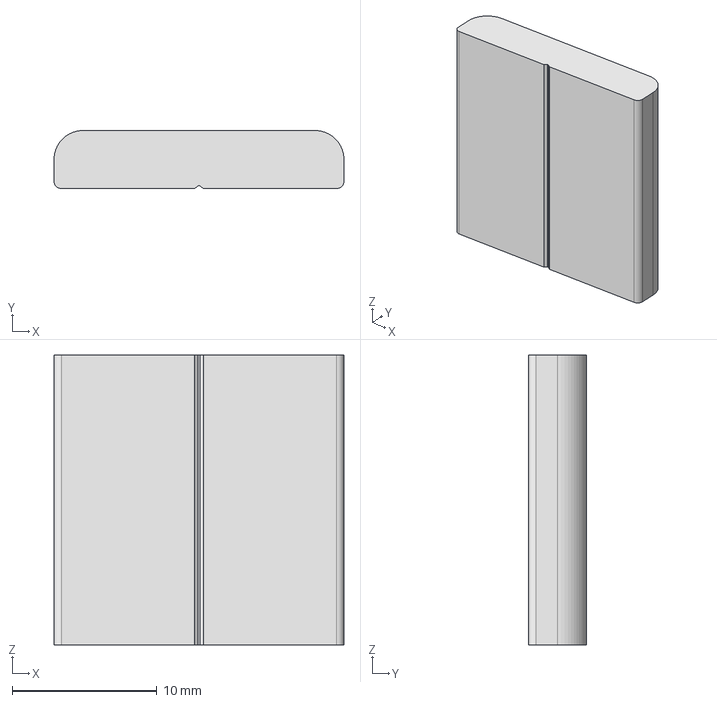
[picture p95: CAD file, 2017-09-23]
Prototipo_11/PerfilesItem5/item_7000262_Profile_M_20x4_E_natural_L=20.stp
20.0 x 4.00 x 20.0 mm
