NervenCid/UNAL_FDM/Prototipo_11/Piezas_Impresas/Arandela_Rod.stl

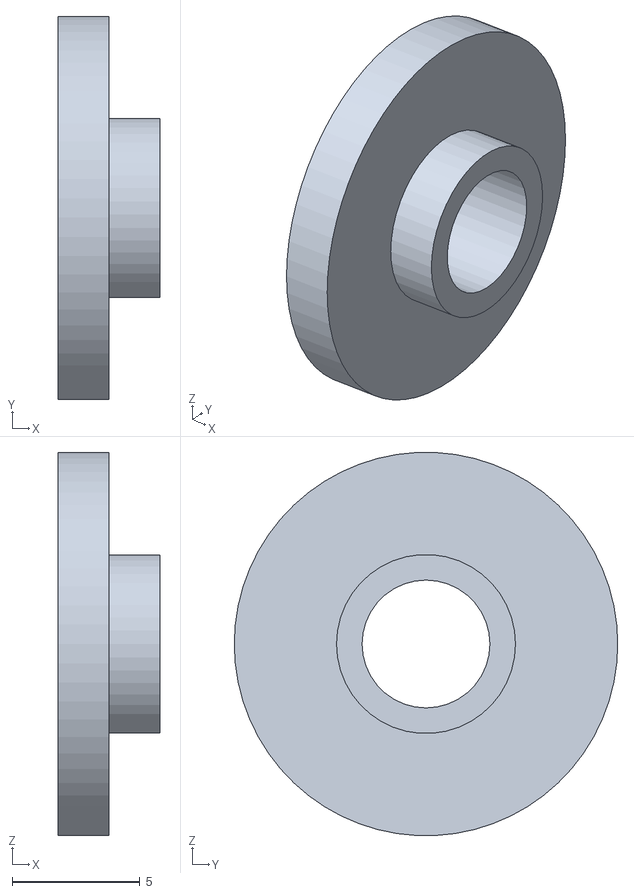
[picture p96: CAD file, 2017-09-23]
Prototipo_11/Piezas_Impresas/Arandela_Rod.stl
4.00 x 15.0 x 15.0
