NervenCid/UNAL_FDM/Prototipo_11/PortaRollo/PieAmigoPCarr.stl

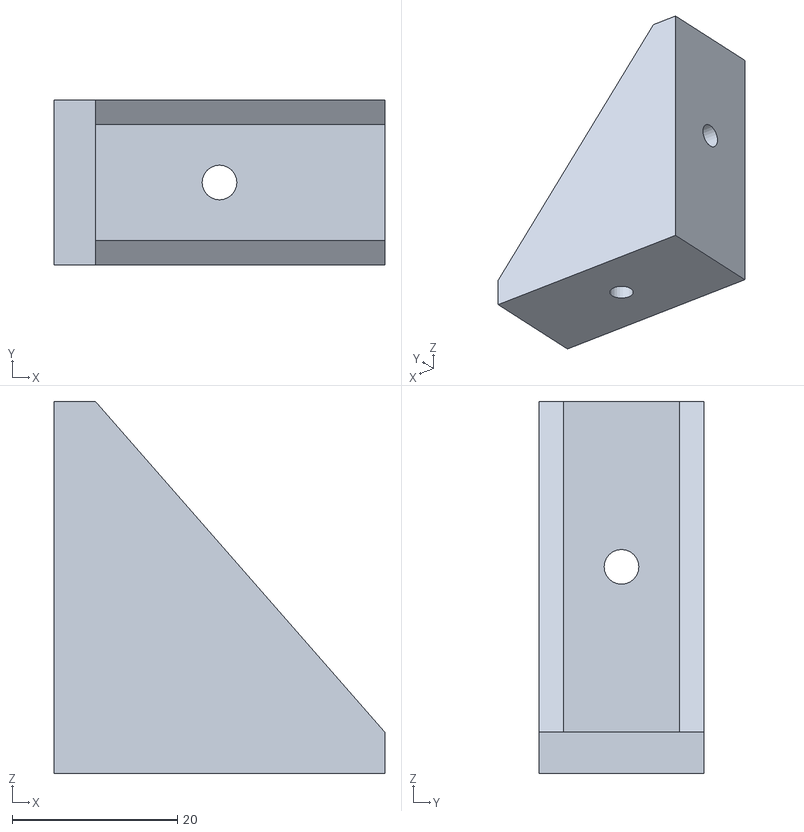
[picture p97: CAD file, 2017-09-23]
Prototipo_11/PortaRollo/PieAmigoPCarr.stl
40.0 x 20.0 x 45.0
