NervenCid/UNAL_FDM/Prototipo_11/SoporteGiratorio/UnionV.stl

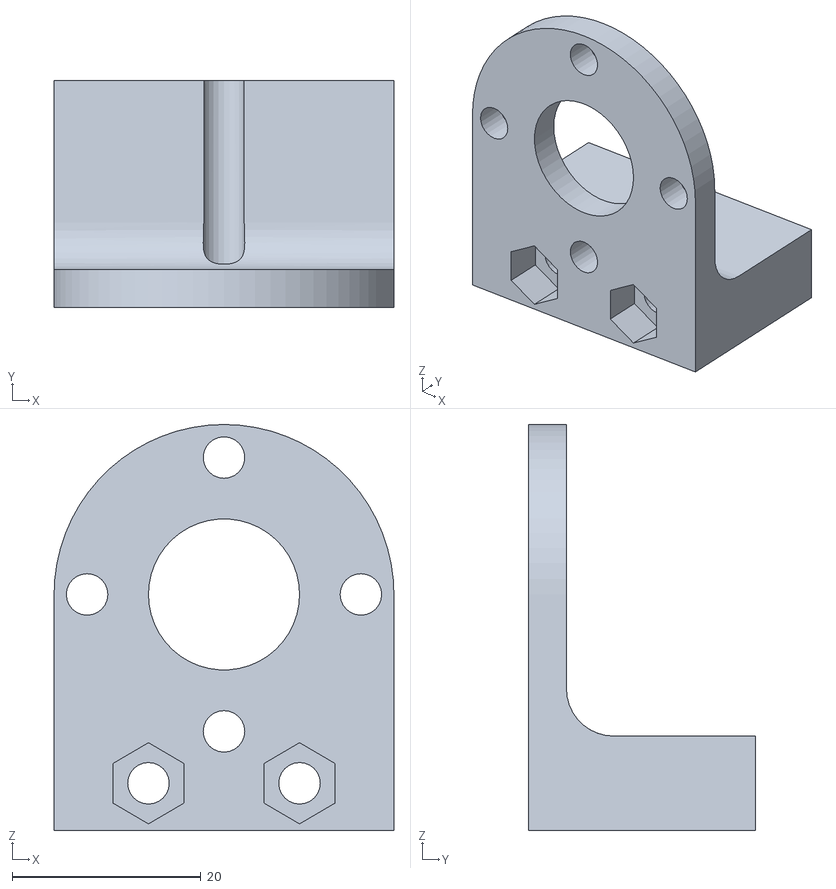
[picture p98: CAD file, 2017-09-23]
Prototipo_11/SoporteGiratorio/UnionV.stl
36.0 x 24.0 x 43.0
