NervenCid/UNAL_FDM/Prototipo_11/Accesorios_IGUS/MFM_081416_10.stp

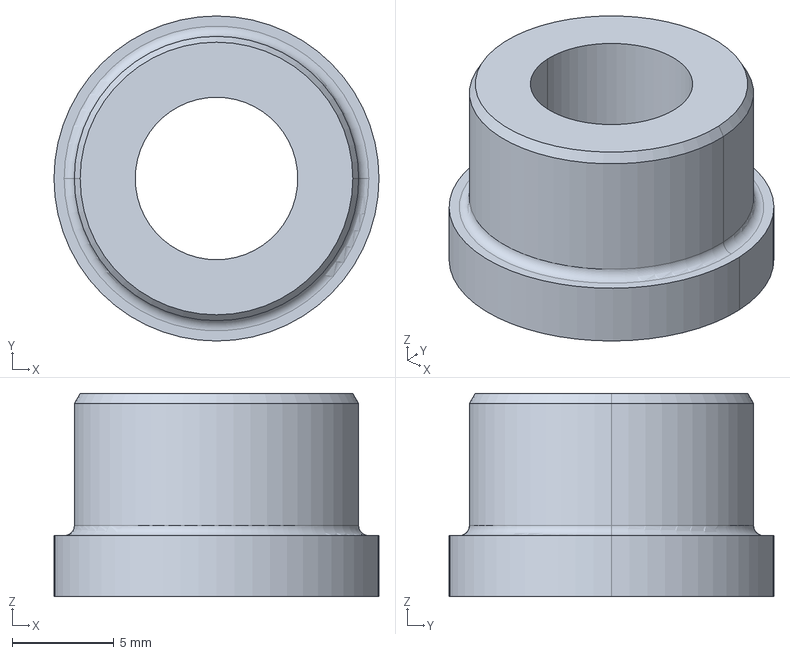
[picture p99: CAD file, 2017-09-23]
Prototipo_11/Accesorios_IGUS/MFM_081416_10.stp
16.0 x 16.0 x 10.0 mm
