NervenCid/UNAL_FDM/Prototipo_11/PerfilesItem5/Profile_5_60x20_natural_L=20.stp

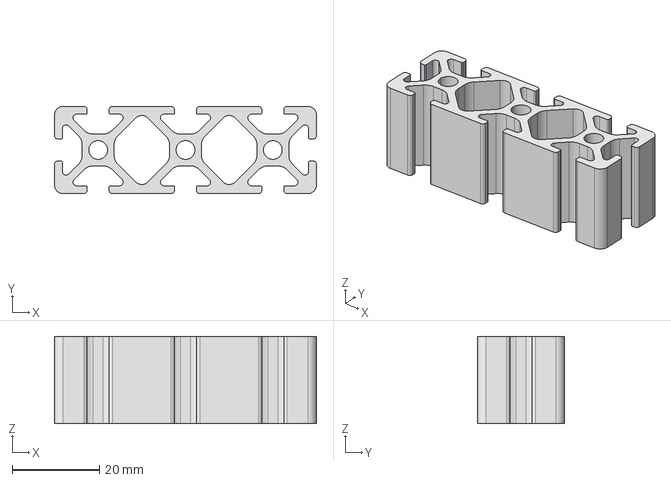
[picture p100: CAD file, 2017-09-23]
Prototipo_11/PerfilesItem5/Profile_5_60x20_natural_L=20.stp
60.0 x 20.0 x 20.0 mm
