NervenCid/UNAL_FDM/Prototipo_11/Piezas_Impresas/Lamina_Acople_4mm_EjeXTensor.stl

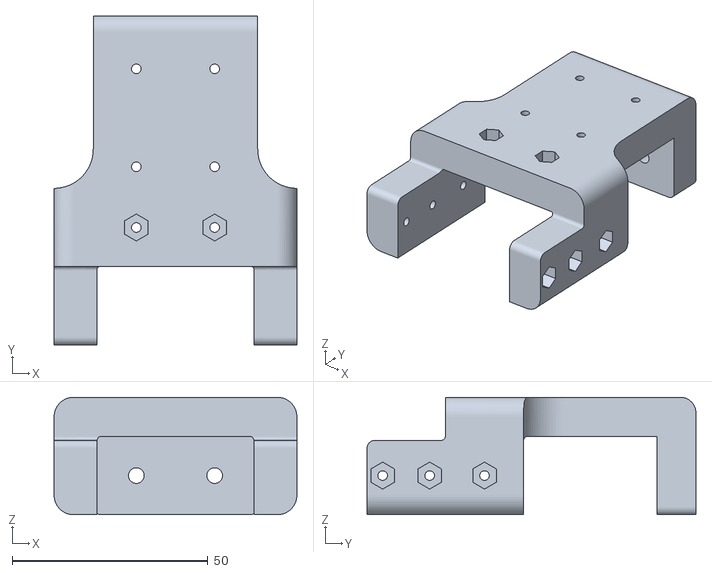
[picture p101: CAD file, 2017-09-23]
Prototipo_11/Piezas_Impresas/Lamina_Acople_4mm_EjeXTensor.stl
62.0 x 84.0 x 30.0
