NervenCid/UNAL_FDM/Prototipo_11/PortaRollo/UnionEstPerf.stl

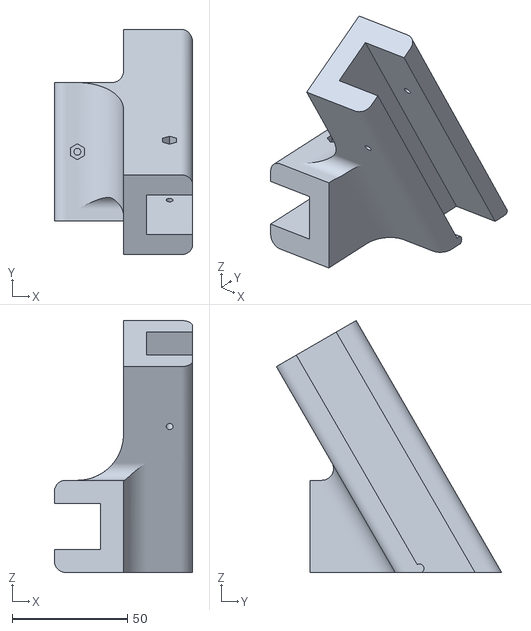
[picture p102: CAD file, 2017-09-23]
Prototipo_11/PortaRollo/UnionEstPerf.stl
60.0 x 97.7 x 109.3
