NervenCid/UNAL_FDM/Prototipo_11/Accesorios_IGUS/JFRM_2020TR8x1_5_1.stp

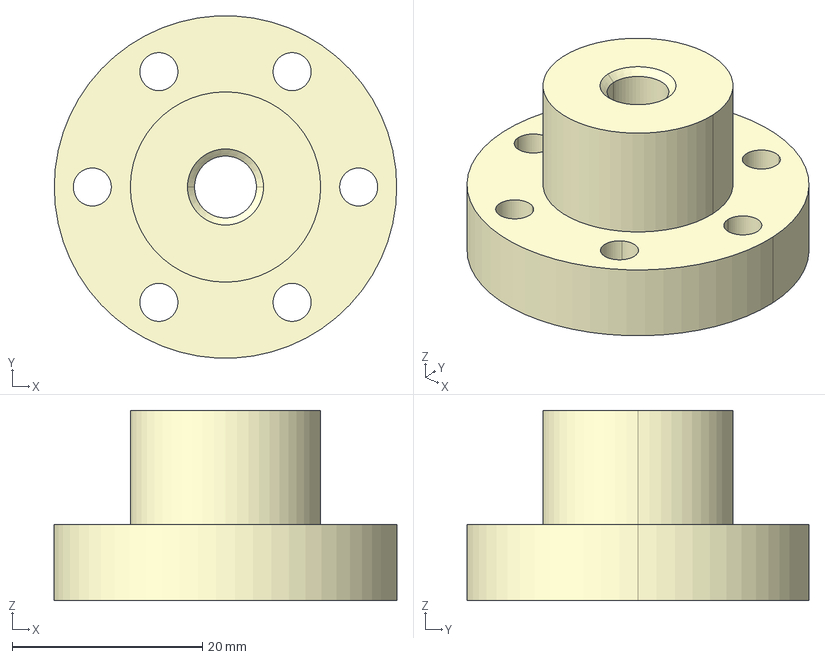
[picture p103: CAD file, 2017-09-23]
Prototipo_11/Accesorios_IGUS/JFRM_2020TR8x1_5_1.stp
36.0 x 35.9 x 20.0 mm
