NervenCid/UNAL_FDM/Prototipo_11/PerfilesItem5/item_0037008_Standard_Fastening_Set_5_1.stp

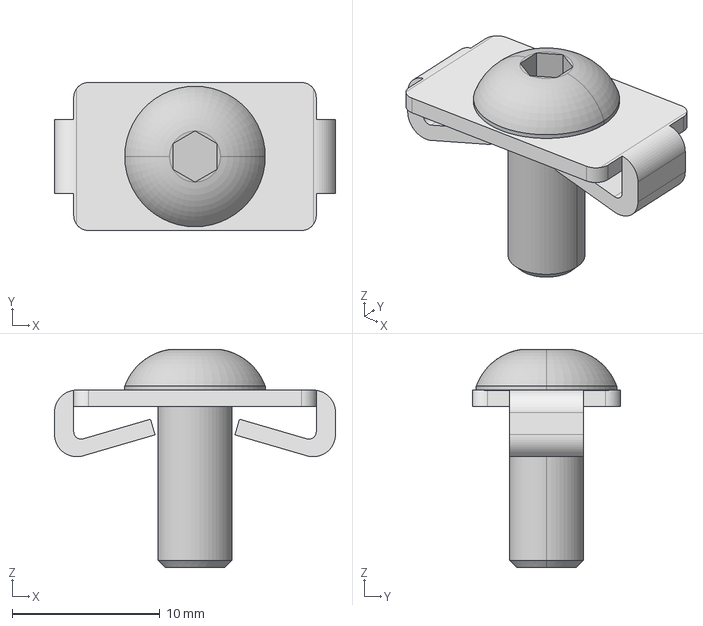
[picture p104: CAD file, 2017-09-23]
Prototipo_11/PerfilesItem5/item_0037008_Standard_Fastening_Set_5_1.stp
19.0 x 10.0 x 14.8 mm
