NervenCid/UNAL_FDM/Prototipo_11/Piezas_Impresas/Soporte_GiraTensor_B.stl

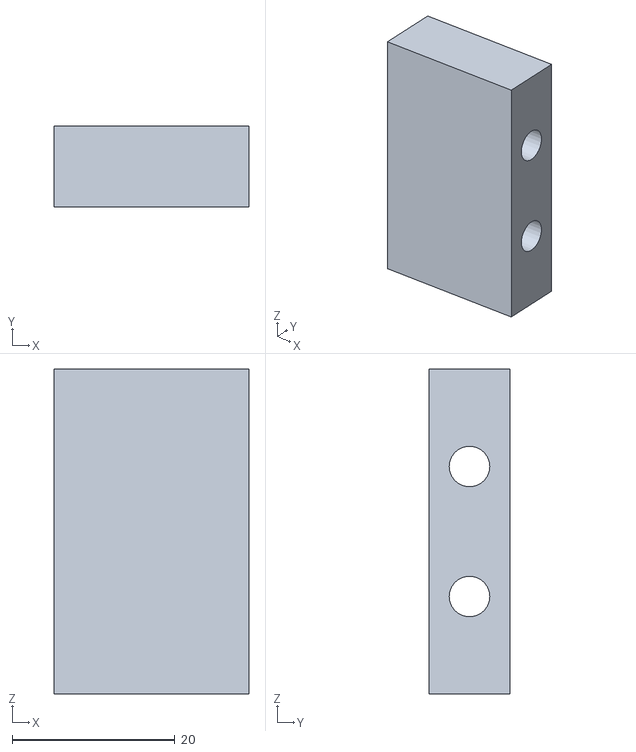
[picture p105: CAD file, 2017-09-23]
Prototipo_11/Piezas_Impresas/Soporte_GiraTensor_B.stl
24.0 x 10.0 x 40.0
