NervenCid/UNAL_FDM/Prototipo_11/Accesorios_IGUS/JSRM_1418TR8x1_5.stp

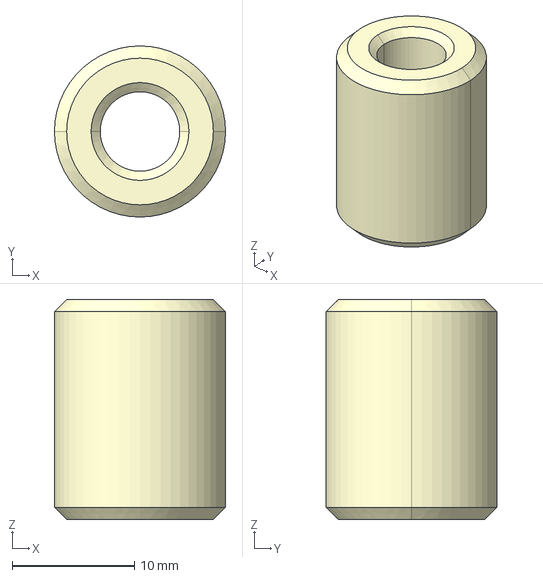
[picture p106: CAD file, 2017-09-23]
Prototipo_11/Accesorios_IGUS/JSRM_1418TR8x1_5.stp
14.0 x 14.0 x 18.0 mm
