NervenCid/UNAL_FDM/Prototipo_11/Piezas_Impresas/Lamina_Acople_10mm_EjeXYV4.stl

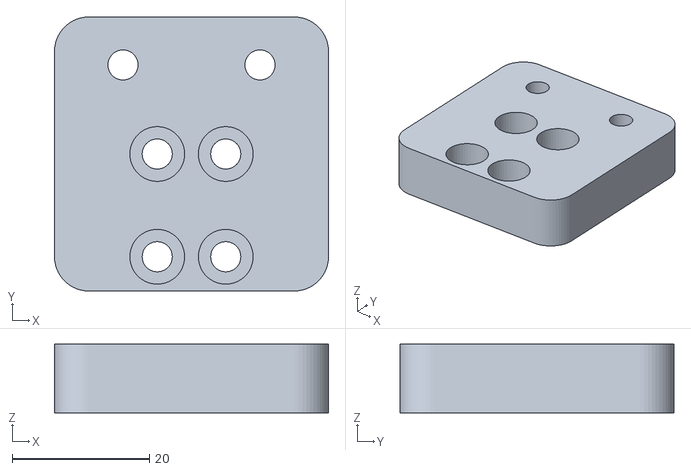
[picture p107: CAD file, 2017-09-23]
Prototipo_11/Piezas_Impresas/Lamina_Acople_10mm_EjeXYV4.stl
40.0 x 40.0 x 10.0
