NervenCid/UNAL_FDM/Prototipo_11/Accesorios_IGUS/TS_04_15_UNGEBOHRT.stp

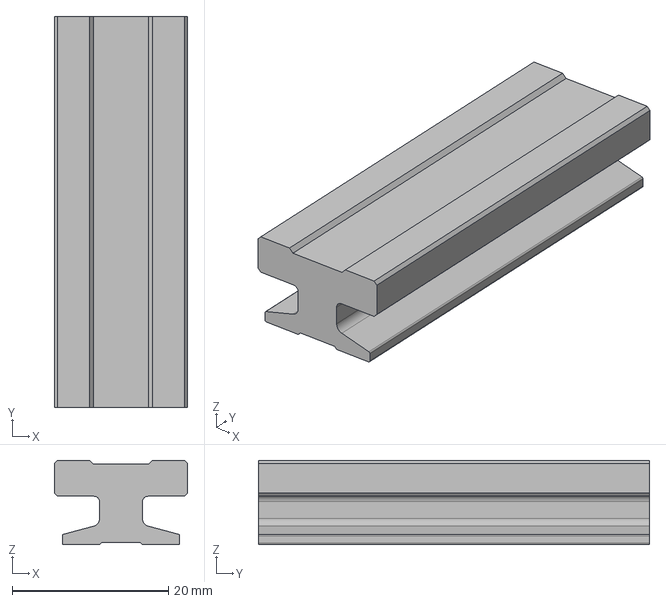
[picture p108: CAD file, 2017-09-23]
Prototipo_11/Accesorios_IGUS/TS_04_15_UNGEBOHRT.stp
17.0 x 50.0 x 10.8 mm
