NervenCid/UNAL_FDM/Prototipo_11/Piezas_Impresas/PortaEndStopZ_v1.stl

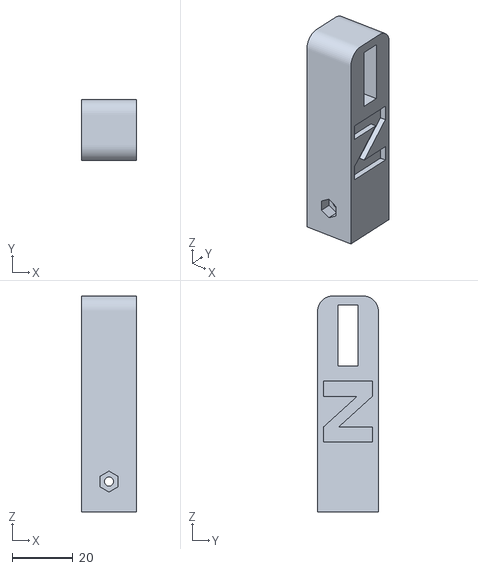
[picture p109: CAD file, 2017-09-23]
Prototipo_11/Piezas_Impresas/PortaEndStopZ_v1.stl
18.0 x 20.0 x 71.0
