NervenCid/UNAL_FDM/Prototipo_11/Piezas_Impresas/EJE_Acople_Gear_Polea.stl

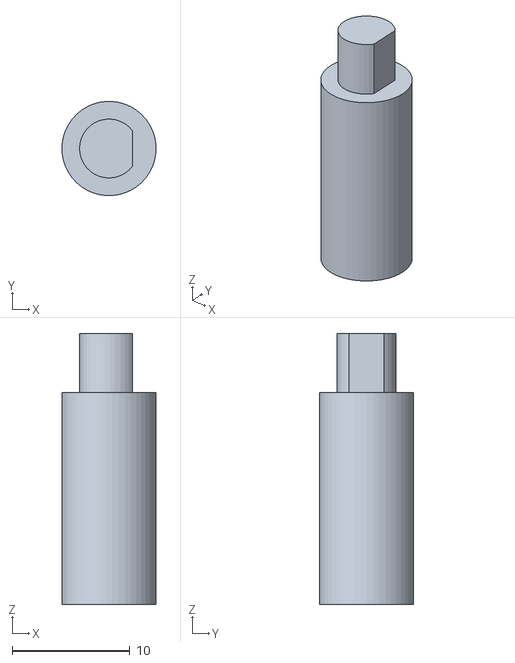
[picture p110: CAD file, 2017-09-23]
Prototipo_11/Piezas_Impresas/EJE_Acople_Gear_Polea.stl
8.00 x 7.98 x 23.0
