NervenCid/UNAL_FDM/Prototipo_11/Piezas_Impresas/Lamina_Acople_4mm_Extrusor.stl

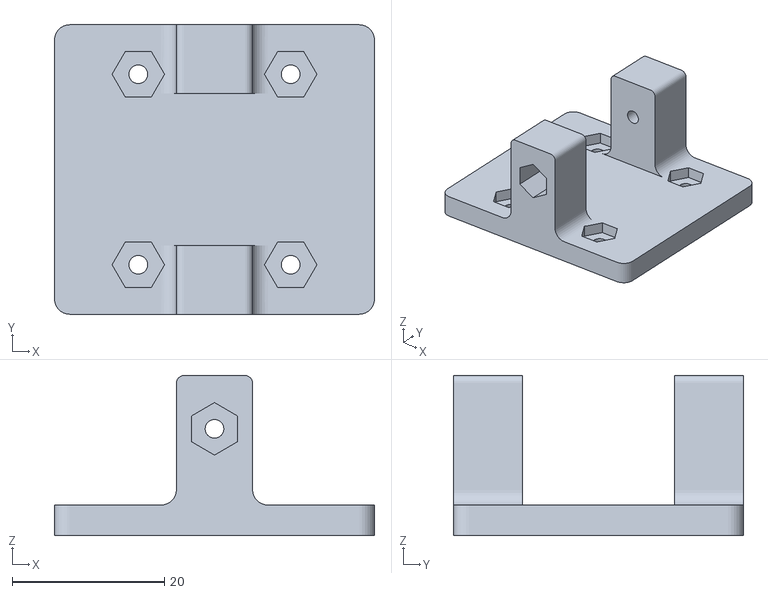
[picture p111: CAD file, 2017-09-23]
Prototipo_11/Piezas_Impresas/Lamina_Acople_4mm_Extrusor.stl
42.0 x 38.0 x 21.0
