NervenCid/UNAL_FDM/Prototipo_11/Piezas_Impresas/PortaEndStopX_v1.stl

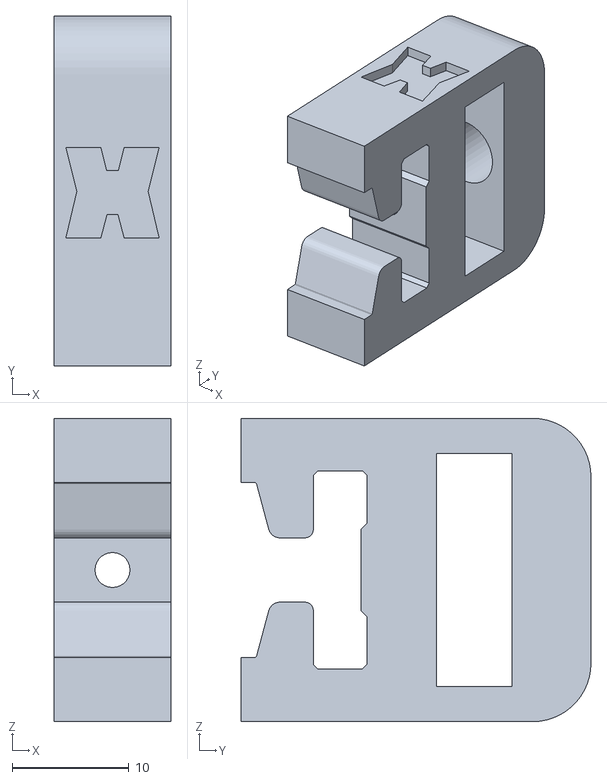
[picture p113: CAD file, 2017-09-23]
Prototipo_11/Piezas_Impresas/PortaEndStopX_v1.stl
10.0 x 30.0 x 26.0
