NervenCid/UNAL_FDM/Prototipo_11/Piezas_Impresas/BujeTornillo.stl

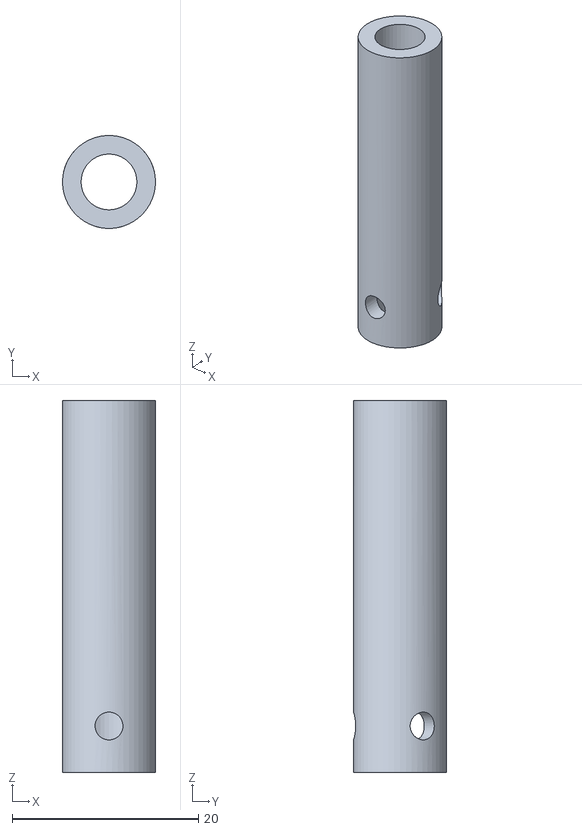
[picture p114: CAD file, 2017-09-23]
Prototipo_11/Piezas_Impresas/BujeTornillo.stl
10.0 x 9.99 x 40.0
