NervenCid/UNAL_FDM/Prototipo_11/Piezas_Impresas/Lamina_Tensor_A_V2.stl

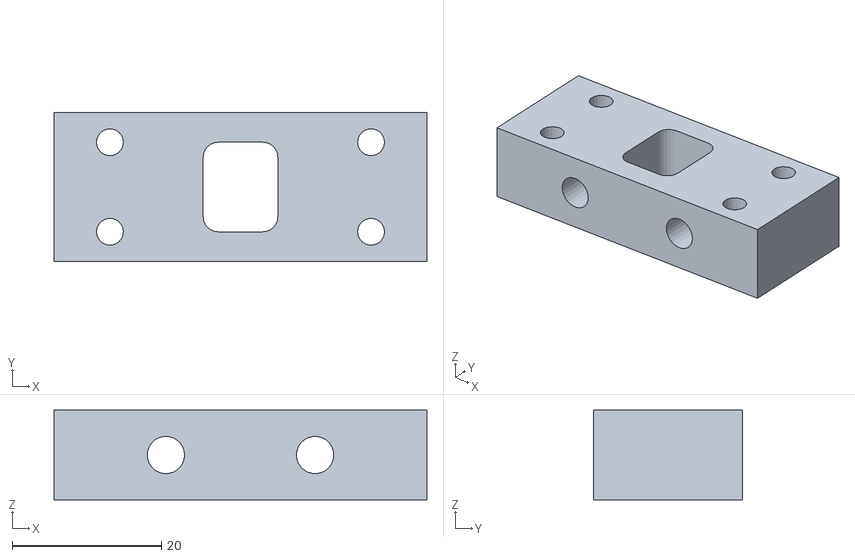
[picture p115: CAD file, 2017-09-23]
Prototipo_11/Piezas_Impresas/Lamina_Tensor_A_V2.stl
50.0 x 20.0 x 12.0
