NervenCid/UNAL_FDM/Prototipo_11/Piezas_Impresas/Lamina_Tensor_B.stl

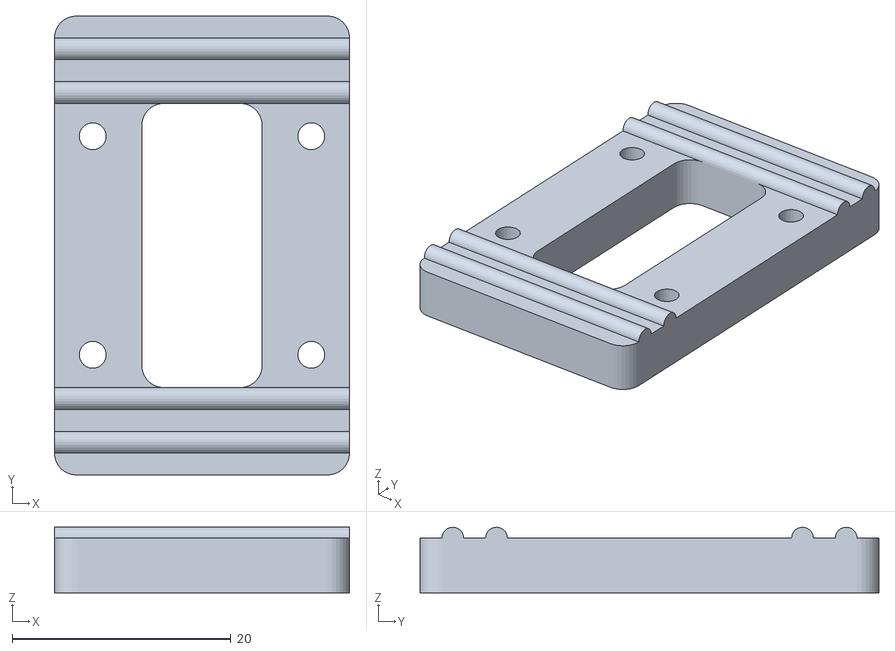
[picture p116: CAD file, 2017-09-23]
Prototipo_11/Piezas_Impresas/Lamina_Tensor_B.stl
27.0 x 42.0 x 6.00
