NervenCid/UNAL_FDM/Prototipo_11/Piezas_Impresas/GT2_Tensor.stl

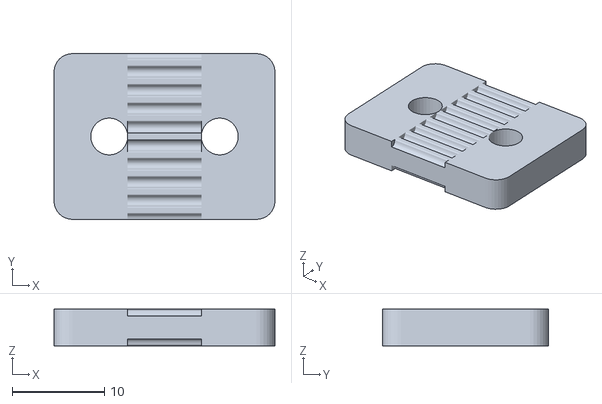
[picture p117: CAD file, 2017-09-23]
Prototipo_11/Piezas_Impresas/GT2_Tensor.stl
24.0 x 18.0 x 4.00
