NervenCid/UNAL_FDM/Prototipo_11/Piezas_Impresas/ContrapesoExtrusor.stl

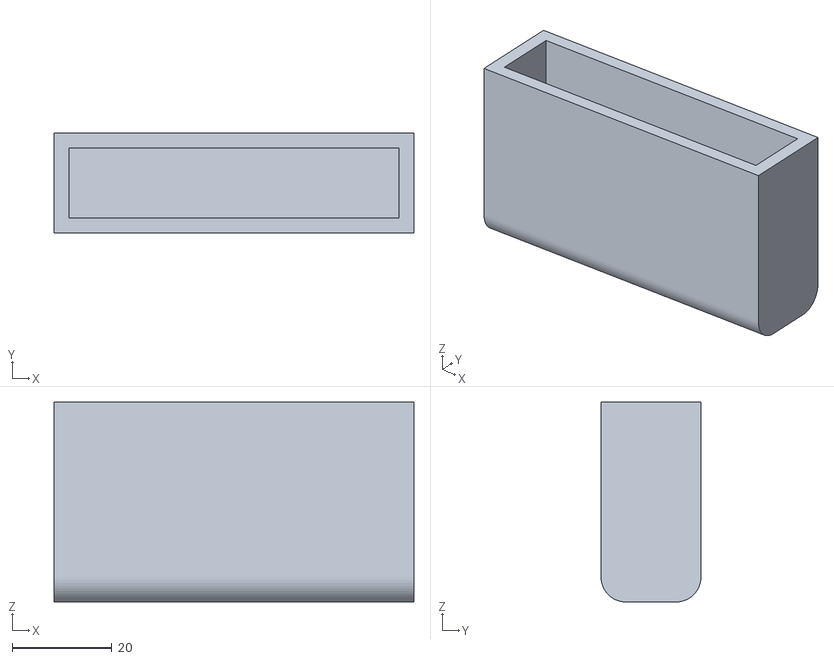
[picture p118: CAD file, 2017-09-23]
Prototipo_11/Piezas_Impresas/ContrapesoExtrusor.stl
72.0 x 20.0 x 40.0
