NervenCid/UNAL_FDM/Prototipo_11/Piezas_Impresas/EjeAmpliado_5_8.stl

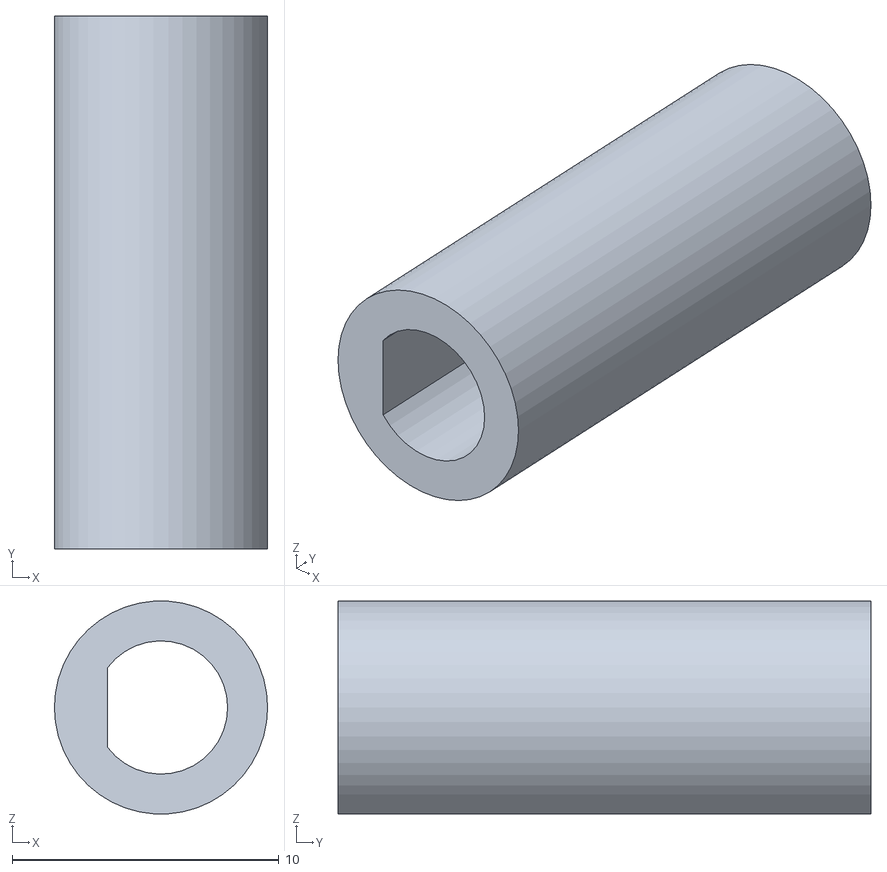
[picture p119: CAD file, 2017-09-23]
Prototipo_11/Piezas_Impresas/EjeAmpliado_5_8.stl
8.00 x 20.0 x 7.98
