NervenCid/UNAL_FDM/Prototipo_11/Piezas_Impresas/GT2_Tensor_v3.stl

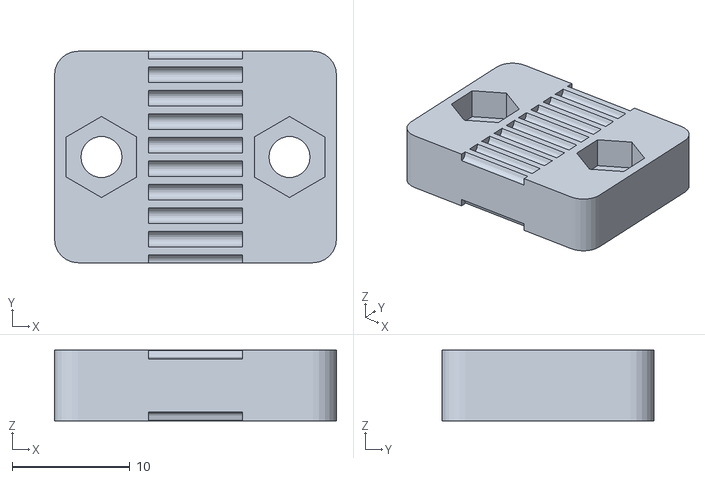
[picture p120: CAD file, 2017-09-23]
Prototipo_11/Piezas_Impresas/GT2_Tensor_v3.stl
24.0 x 18.0 x 6.00
