NervenCid/UNAL_FDM/Prototipo_11/Piezas_Impresas/Gear_Transfer.stl

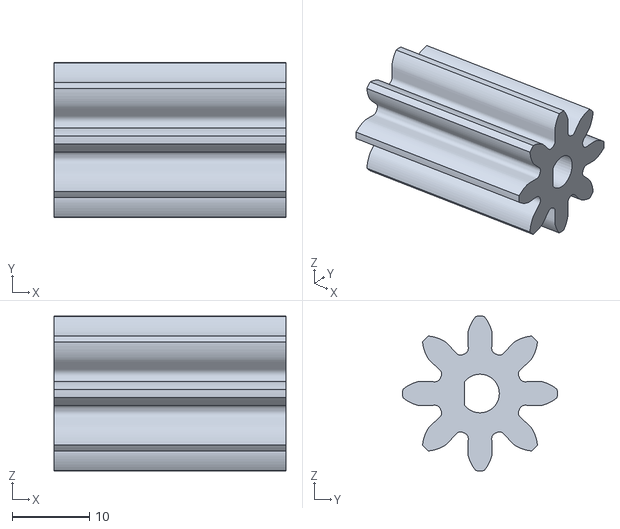
[picture p121: CAD file, 2017-09-23]
Prototipo_11/Piezas_Impresas/Gear_Transfer.stl
30.0 x 20.0 x 20.0
