NervenCid/UNAL_FDM/Prototipo_11/Piezas_Impresas/Lamina_Acople_10mm_EjeXY.stl

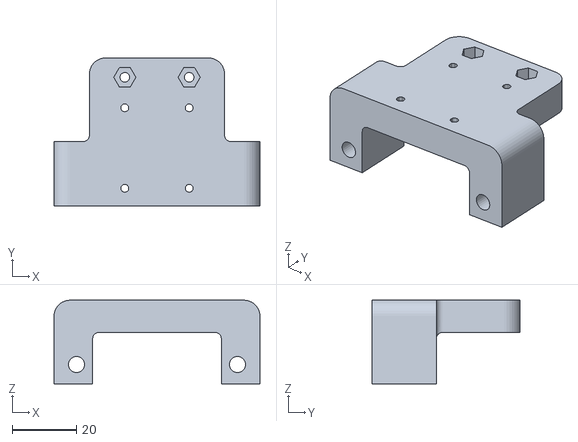
[picture p122: CAD file, 2017-09-23]
Prototipo_11/Piezas_Impresas/Lamina_Acople_10mm_EjeXY.stl
64.0 x 46.0 x 26.0
