NervenCid/UNAL_FDM/Prototipo_11/Piezas_Impresas/Lamina_Acople_4mm_v3.stl

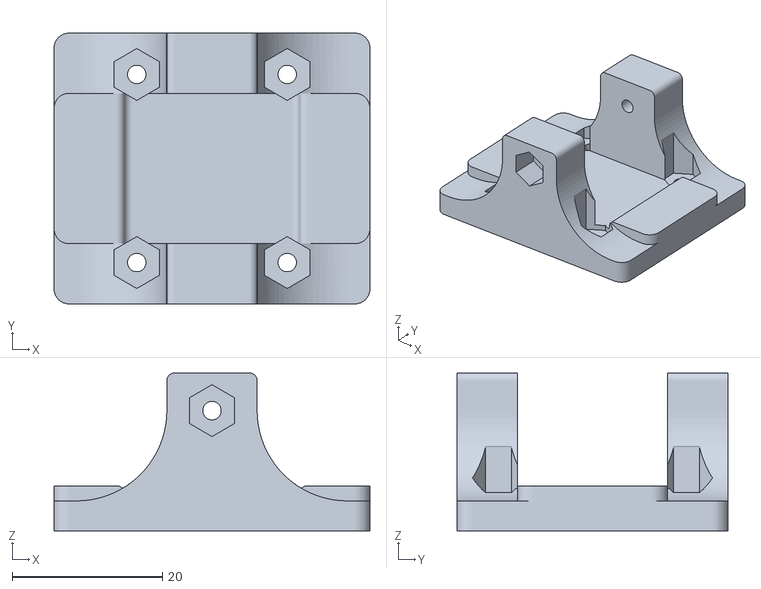
[picture p123: CAD file, 2017-09-23]
Prototipo_11/Piezas_Impresas/Lamina_Acople_4mm_v3.stl
42.0 x 36.0 x 21.0
