NervenCid/UNAL_FDM/Prototipo_11/Piezas_Impresas/Soporte_GiraTensor_C.stl

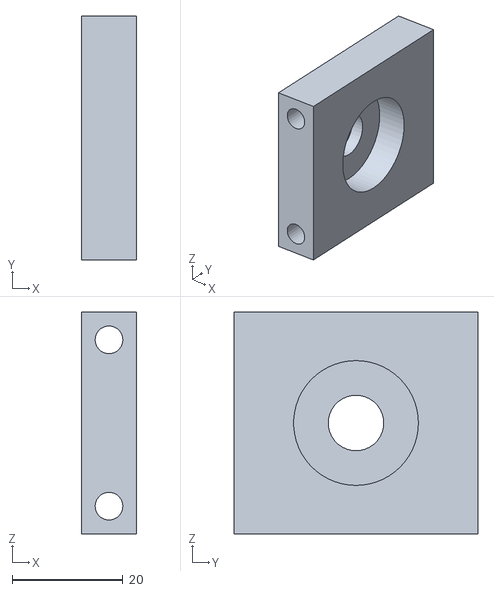
[picture p124: CAD file, 2017-09-23]
Prototipo_11/Piezas_Impresas/Soporte_GiraTensor_C.stl
10.0 x 44.0 x 40.0
