NervenCid/UNAL_FDM/Prototipo_11/Piezas_Impresas/portaEndStopU.stl

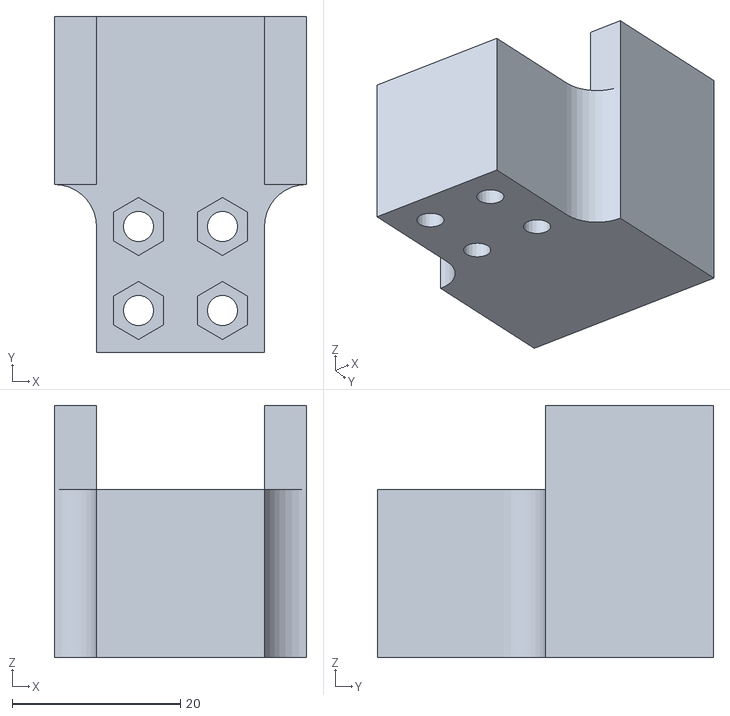
[picture p125: CAD file, 2017-09-23]
Prototipo_11/Piezas_Impresas/portaEndStopU.stl
30.0 x 40.0 x 30.0
