NervenCid/UNAL_FDM/Prototipo_11/Piezas_Impresas/Gear_Prueba1.stl

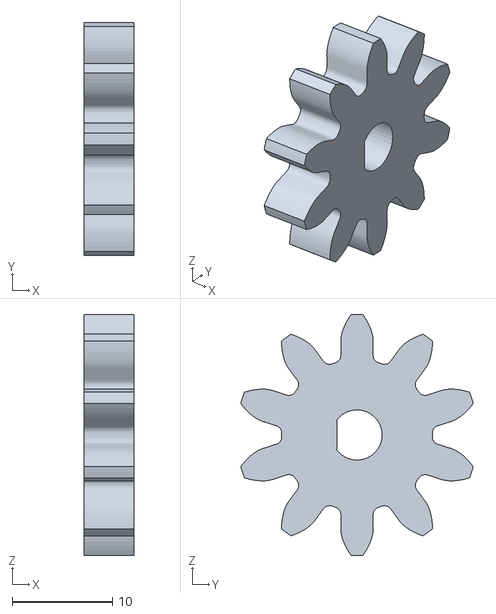
[picture p126: CAD file, 2017-09-23]
Prototipo_11/Piezas_Impresas/Gear_Prueba1.stl
5.00 x 23.2 x 24.0
