NervenCid/UNAL_FDM/Prototipo_11/Piezas_Impresas/Lamina_tensorX.stl

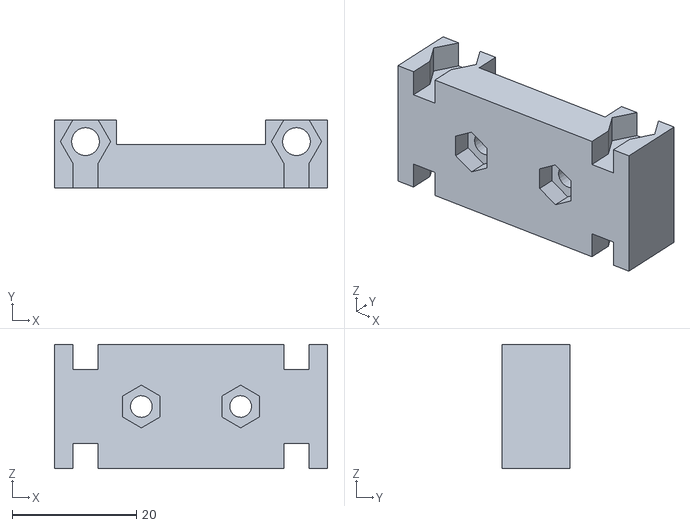
[picture p127: CAD file, 2017-09-23]
Prototipo_11/Piezas_Impresas/Lamina_tensorX.stl
44.0 x 11.0 x 20.0
