NervenCid/UNAL_FDM/Prototipo_11/Piezas_Impresas/Soporte_GiraTensor_A.stl

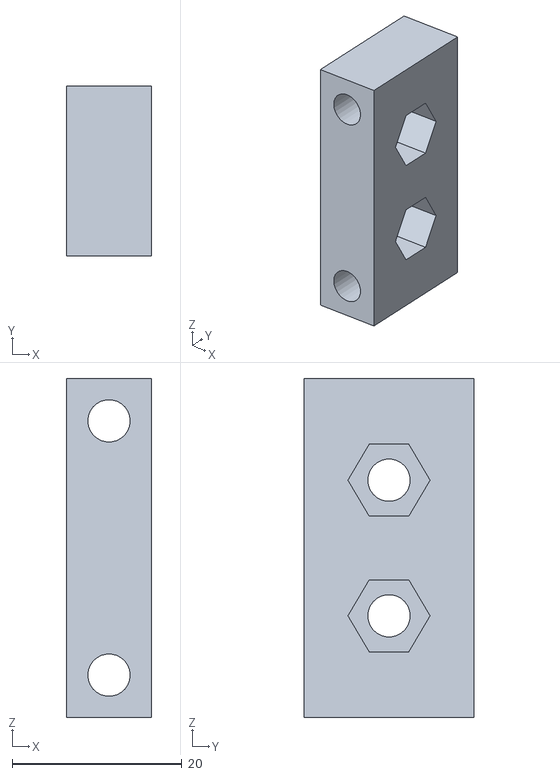
[picture p128: CAD file, 2017-09-23]
Prototipo_11/Piezas_Impresas/Soporte_GiraTensor_A.stl
10.0 x 20.0 x 40.0
