NervenCid/UNAL_FDM/Prototipo_11/Piezas_Impresas/Lamina_TensorA_4mm.stl

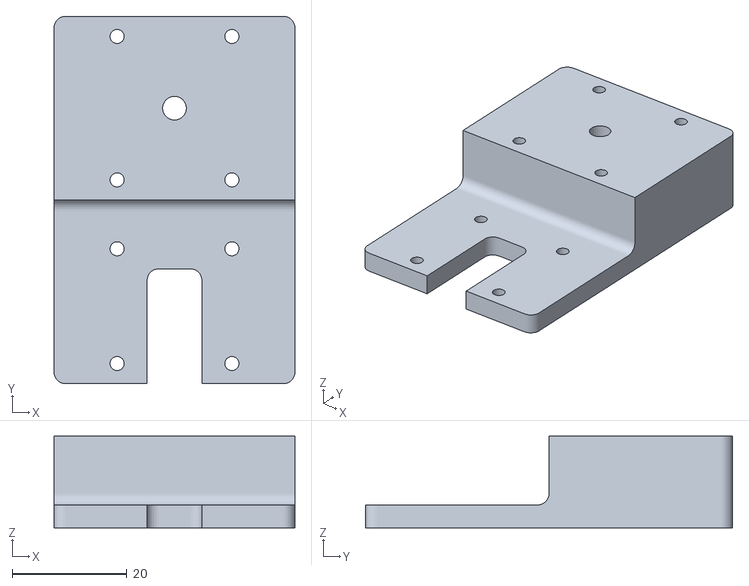
[picture p129: CAD file, 2017-09-23]
Prototipo_11/Piezas_Impresas/Lamina_TensorA_4mm.stl
42.0 x 64.0 x 16.0
