NervenCid/UNAL_FDM/Prototipo_11/Piezas_Impresas/Guia_FilamentoA.stl

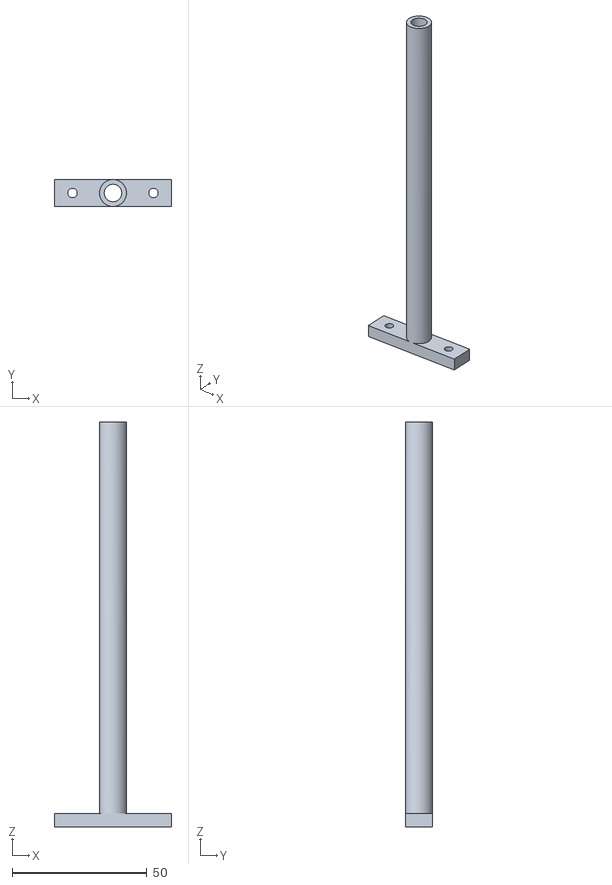
[picture p131: CAD file, 2017-09-23]
Prototipo_11/Piezas_Impresas/Guia_FilamentoA.stl
43.5 x 10.0 x 150.0
