NervenCid/UNAL_FDM/Prototipo_11/Piezas_Impresas/Lamina_tensorY.stl

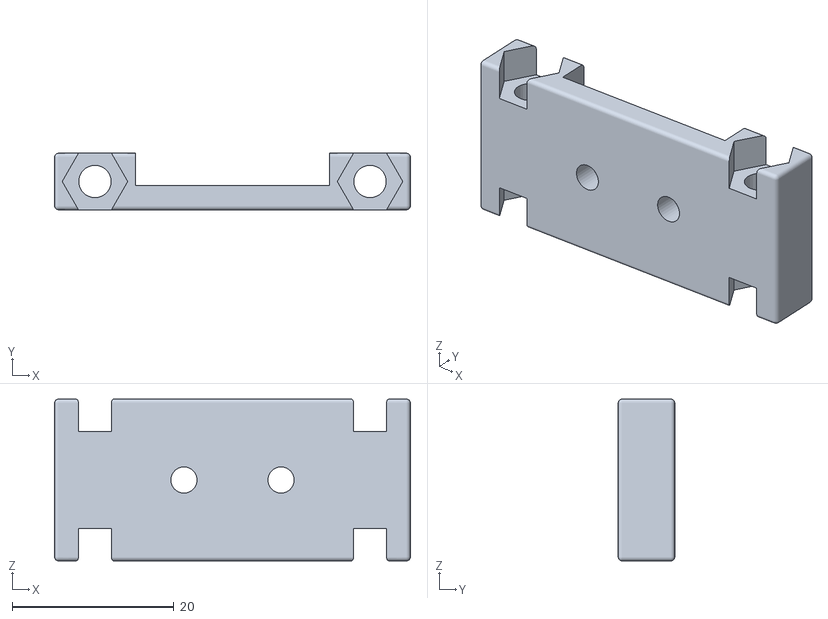
[picture p132: CAD file, 2017-09-23]
Prototipo_11/Piezas_Impresas/Lamina_tensorY.stl
44.0 x 7.00 x 20.0
