NervenCid/UNAL_FDM/Prototipo_11/Piezas_Impresas/PortaRodamientosDual.stl

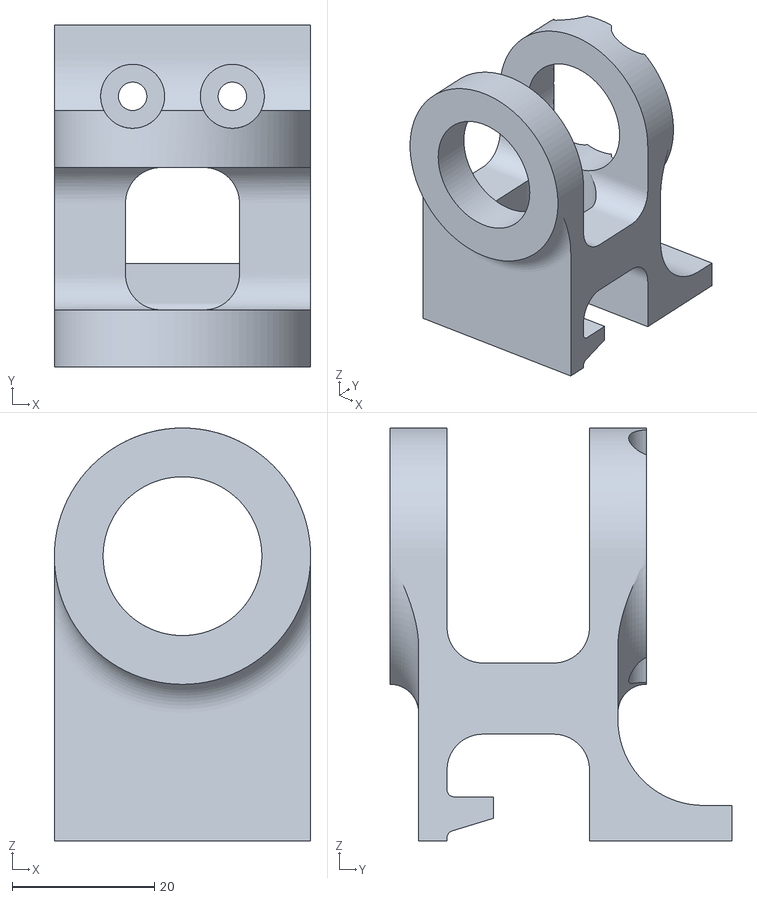
[picture p133: CAD file, 2017-09-23]
Prototipo_11/Piezas_Impresas/PortaRodamientosDual.stl
36.0 x 48.0 x 58.0
