NervenCid/UNAL_FDM/Prototipo_11/Piezas_Impresas/LaminaEndStop.stl

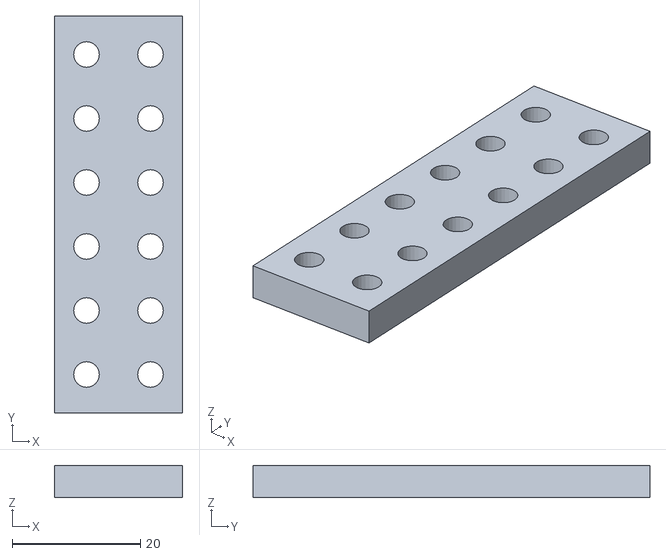
[picture p134: CAD file, 2017-09-23]
Prototipo_11/Piezas_Impresas/LaminaEndStop.stl
20.0 x 62.0 x 5.00
