NervenCid/UNAL_FDM/Prototipo_11/Piezas_Impresas/Gear_output.stl

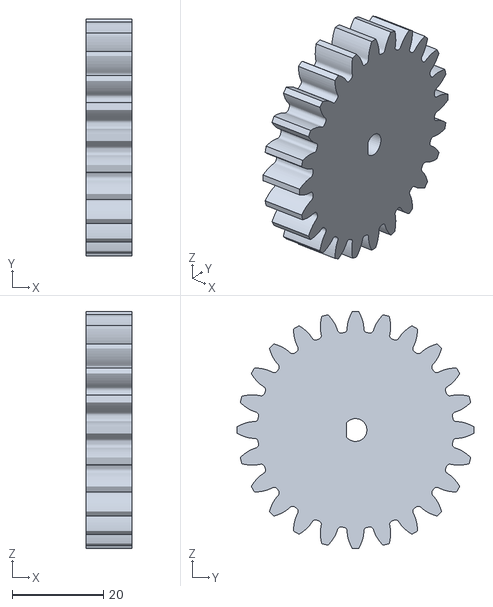
[picture p135: CAD file, 2017-09-23]
Prototipo_11/Piezas_Impresas/Gear_output.stl
10.0 x 52.0 x 52.0
