NervenCid/UNAL_FDM/Prototipo_11/Piezas_Impresas/PortaRodamientos.stp

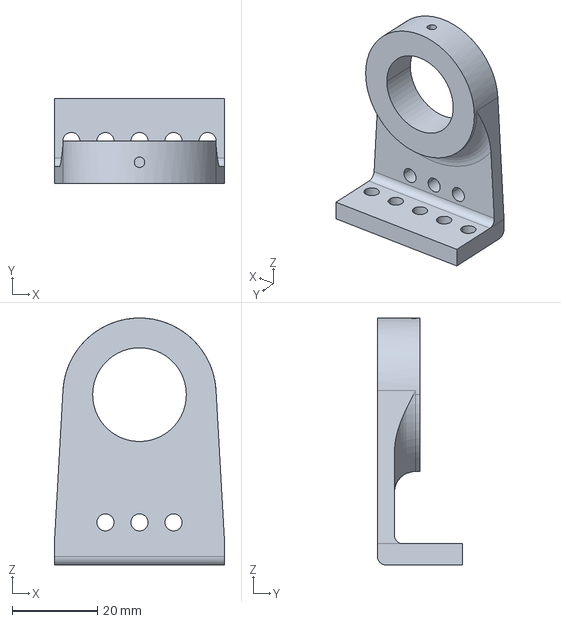
[picture p136: CAD file, 2017-09-23]
Prototipo_11/Piezas_Impresas/PortaRodamientos.stp
40.0 x 20.0 x 58.0 mm
