NervenCid/UNAL_FDM/Prototipo_11/Piezas_Impresas/Lamina_Acople_Transfer_v2.stl

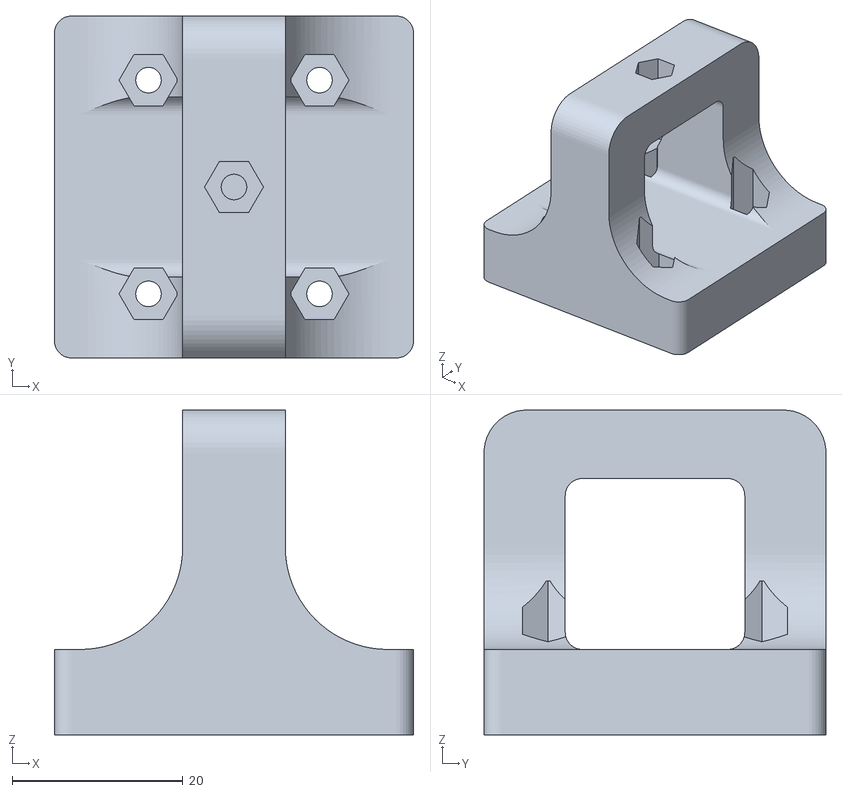
[picture p137: CAD file, 2017-09-23]
Prototipo_11/Piezas_Impresas/Lamina_Acople_Transfer_v2.stl
42.0 x 40.0 x 38.0
