NervenCid/UNAL_FDM/Prototipo_11/Piezas_Impresas/PortaRasp.stl

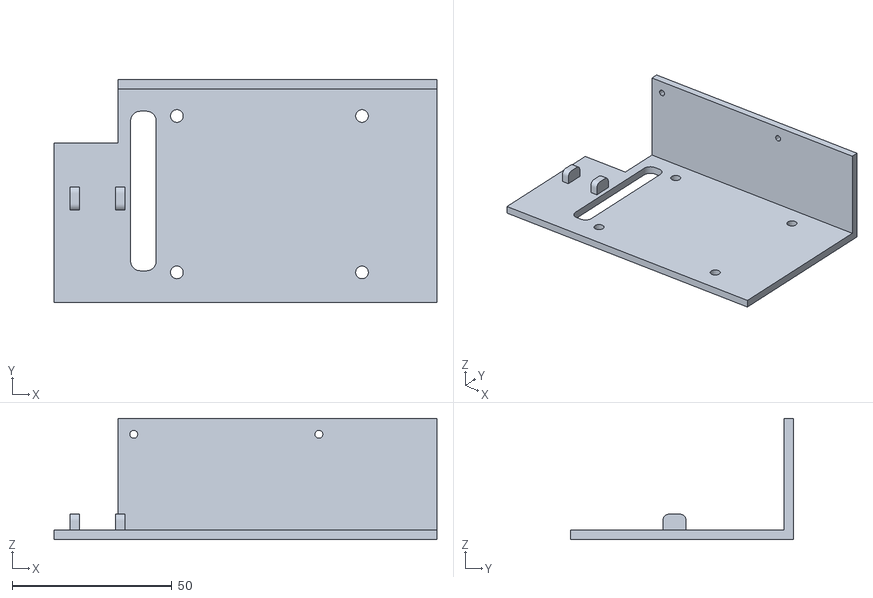
[picture p138: CAD file, 2017-09-23]
Prototipo_11/Piezas_Impresas/PortaRasp.stl
120.0 x 70.0 x 38.0
