NervenCid/UNAL_FDM/Prototipo_11/Piezas_Impresas/AdaptadorContraP.stl

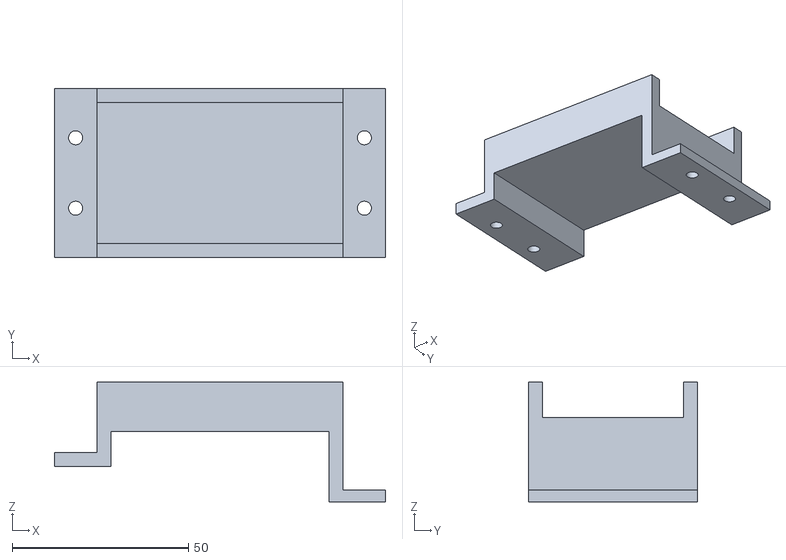
[picture p139: CAD file, 2017-09-23]
Prototipo_11/Piezas_Impresas/AdaptadorContraP.stl
94.0 x 48.0 x 34.0
