NervenCid/UNAL_FDM/Prototipo_11/Piezas_Impresas/Lamina_Acople_Extrusor_v5.stl

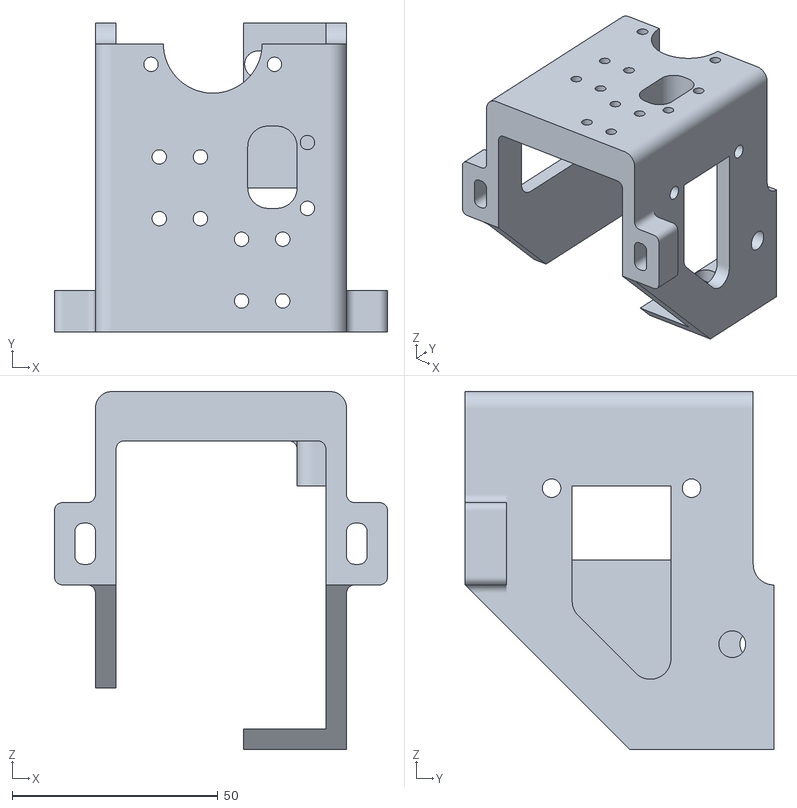
[picture p140: CAD file, 2017-09-23]
Prototipo_11/Piezas_Impresas/Lamina_Acople_Extrusor_v5.stl
81.0 x 75.0 x 87.0
