NervenCid/UNAL_FDM/Prototipo_11/Piezas_Impresas/LaminaComp2.stl

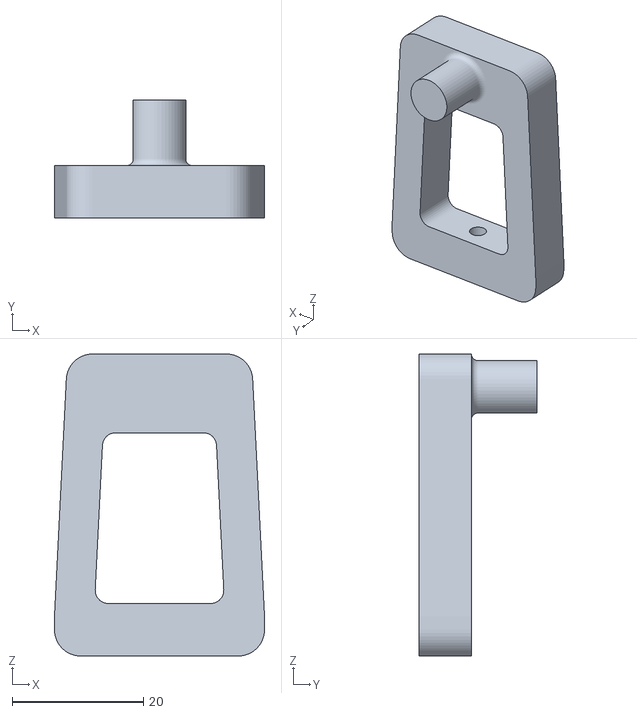
[picture p141: CAD file, 2017-09-23]
Prototipo_11/Piezas_Impresas/LaminaComp2.stl
32.0 x 18.0 x 46.0
