NervenCid/UNAL_FDM/Prototipo_11/Piezas_Impresas/Mariposa.igs

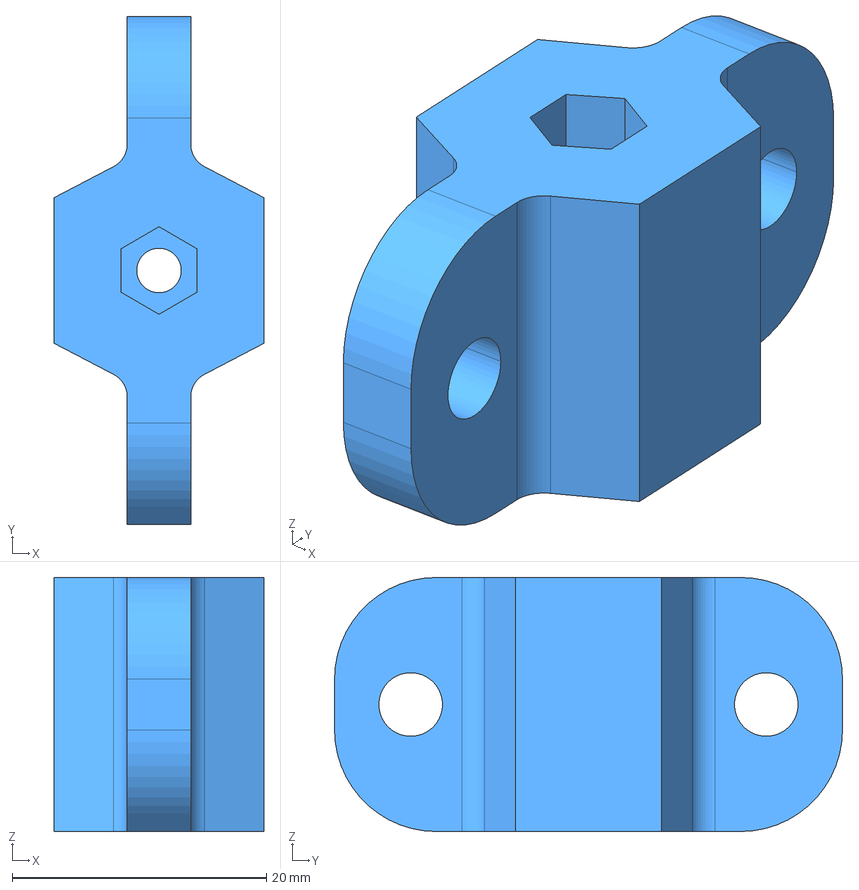
[picture p142: CAD file, 2017-09-23]
Prototipo_11/Piezas_Impresas/Mariposa.igs
16.5 x 40.0 x 20.0 mm
