NervenCid/UNAL_FDM/Prototipo_11/Piezas_Impresas/TAPETAPCrr.stl

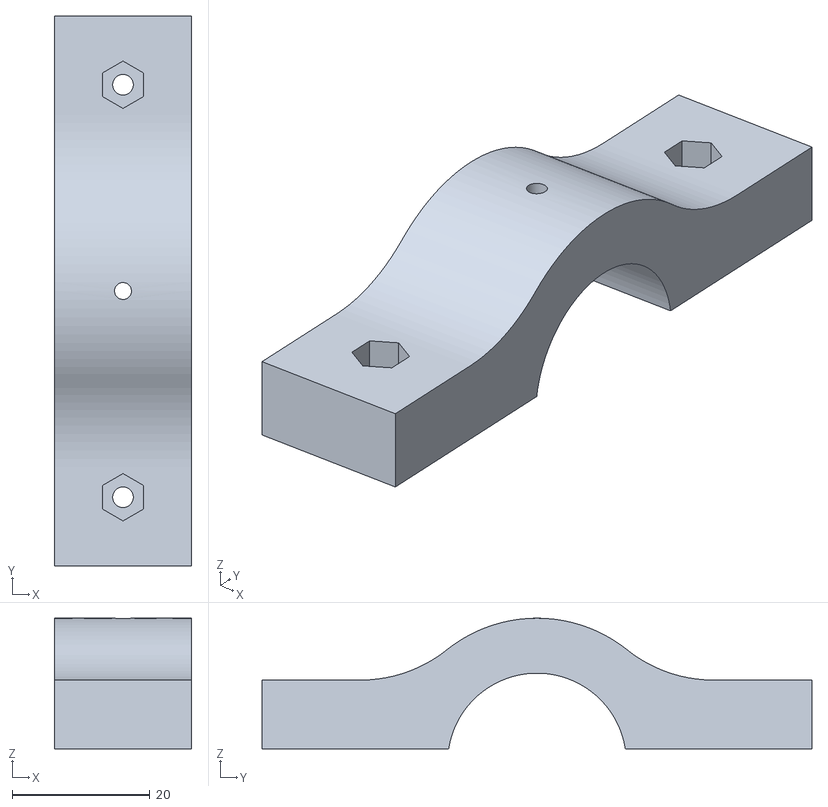
[picture p143: CAD file, 2017-09-23]
Prototipo_11/Piezas_Impresas/TAPETAPCrr.stl
20.0 x 80.0 x 19.0
