NervenCid/UNAL_FDM/Prototipo_11/Piezas_Impresas/Lamina_Acople_Transfer.stl

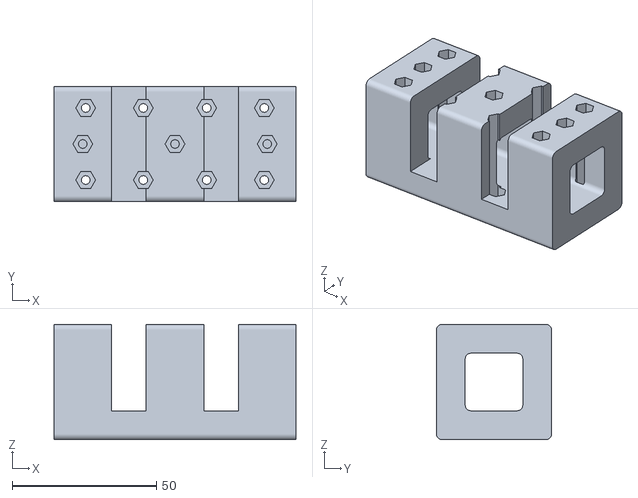
[picture p144: CAD file, 2017-09-23]
Prototipo_11/Piezas_Impresas/Lamina_Acople_Transfer.stl
84.0 x 40.0 x 40.0
