NervenCid/UNAL_FDM/Prototipo_11/Piezas_Impresas/Lamina_Acople_10mm_EjeXYV3.stl

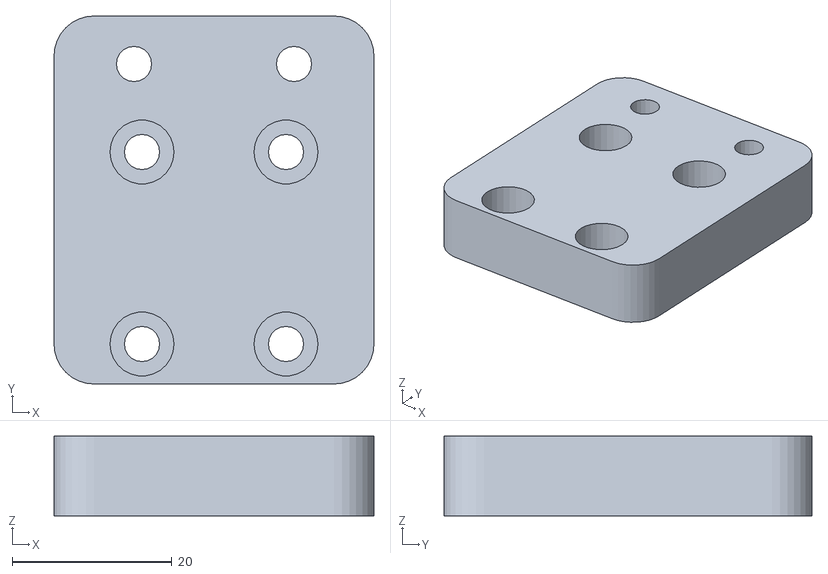
[picture p145: CAD file, 2017-09-23]
Prototipo_11/Piezas_Impresas/Lamina_Acople_10mm_EjeXYV3.stl
40.0 x 46.0 x 10.0
