NervenCid/UNAL_FDM/Prototipo_11/Piezas_Impresas/PieAmigo2020.stl

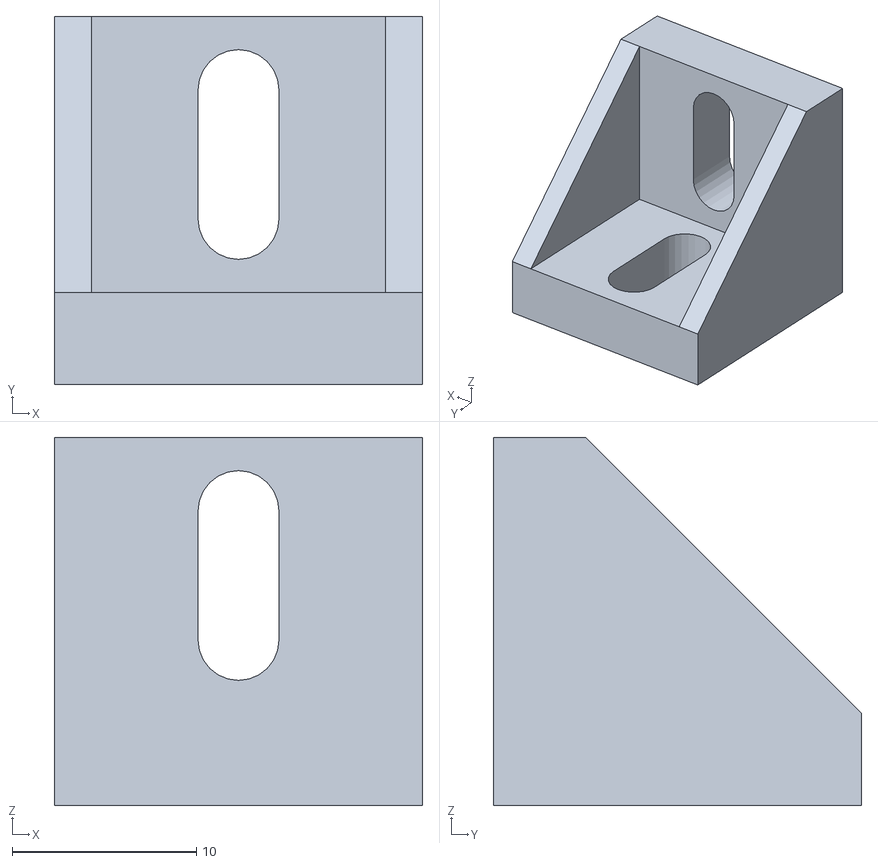
[picture p146: CAD file, 2017-09-23]
Prototipo_11/Piezas_Impresas/PieAmigo2020.stl
20.0 x 20.0 x 20.0
