NervenCid/UNAL_FDM/Prototipo_11/Piezas_Impresas/LaminaComp1.stl

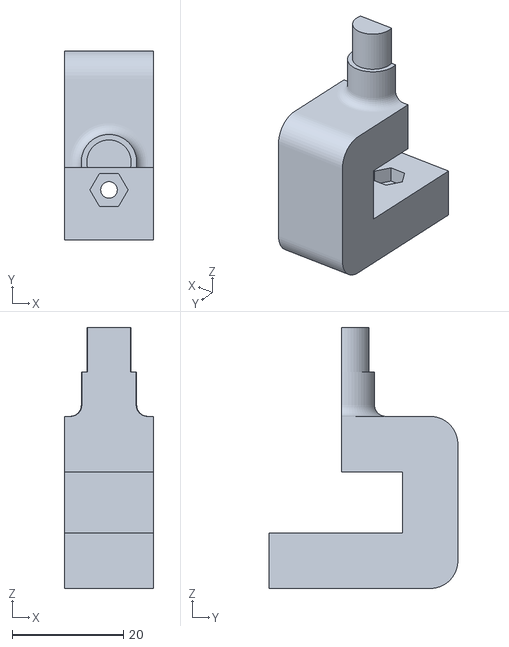
[picture p147: CAD file, 2017-09-23]
Prototipo_11/Piezas_Impresas/LaminaComp1.stl
16.0 x 34.0 x 47.0
