NervenCid/UNAL_FDM/Prototipo_11/Piezas_Impresas/PortaEndStopY_v1.stl

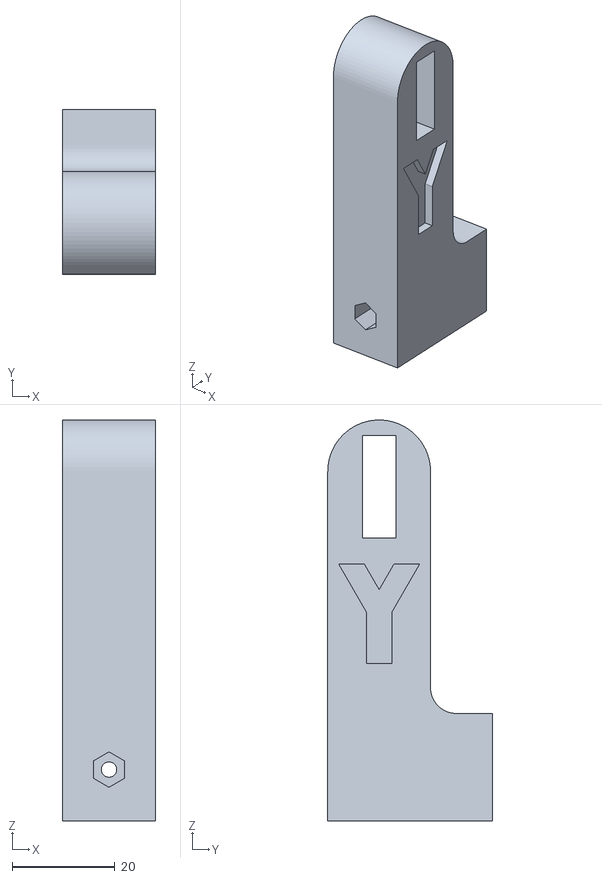
[picture p148: CAD file, 2017-09-23]
Prototipo_11/Piezas_Impresas/PortaEndStopY_v1.stl
18.0 x 32.0 x 78.0
