NervenCid/UNAL_FDM/Prototipo_11/Piezas_Impresas/PortaRodamientosCerrado.stp

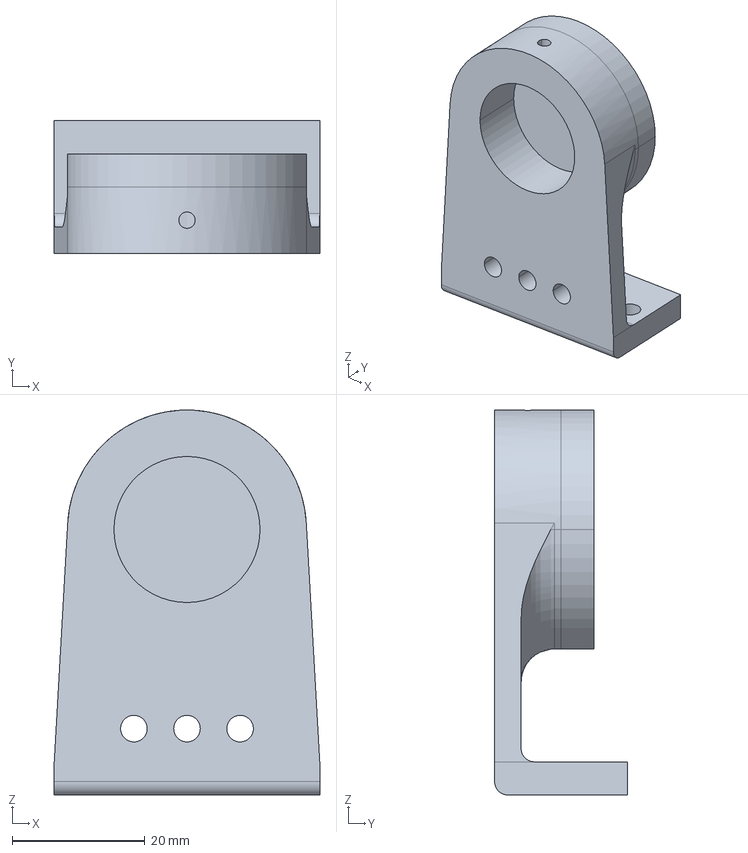
[picture p149: CAD file, 2017-09-23]
Prototipo_11/Piezas_Impresas/PortaRodamientosCerrado.stp
40.0 x 20.0 x 58.0 mm
