NervenCid/UNAL_FDM/Prototipo_11/Piezas_Impresas/Lamina_Tensor_B_V2.stl

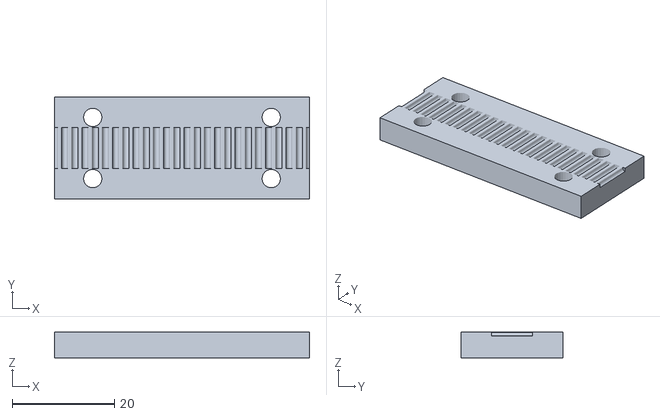
[picture p150: CAD file, 2017-09-23]
Prototipo_11/Piezas_Impresas/Lamina_Tensor_B_V2.stl
50.0 x 20.0 x 5.00
