NervenCid/UNAL_FDM/Prototipo_11/Piezas_Impresas/ContraPeso.stl

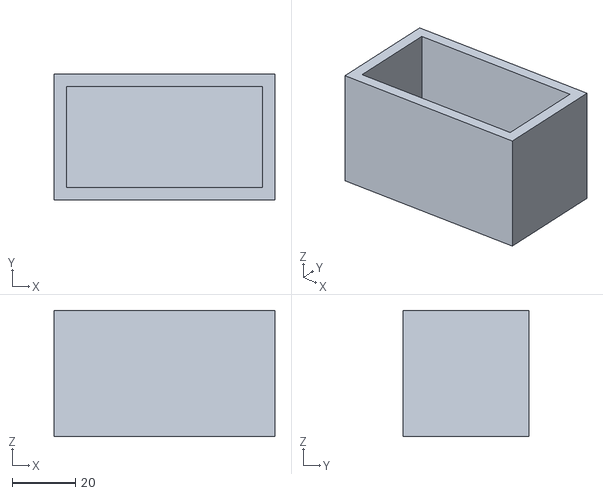
[picture p151: CAD file, 2017-09-23]
Prototipo_11/Piezas_Impresas/ContraPeso.stl
70.0 x 40.0 x 40.0
