NervenCid/UNAL_FDM/Prototipo_11/Piezas_Impresas/Cremallera_Transfer_1.stl

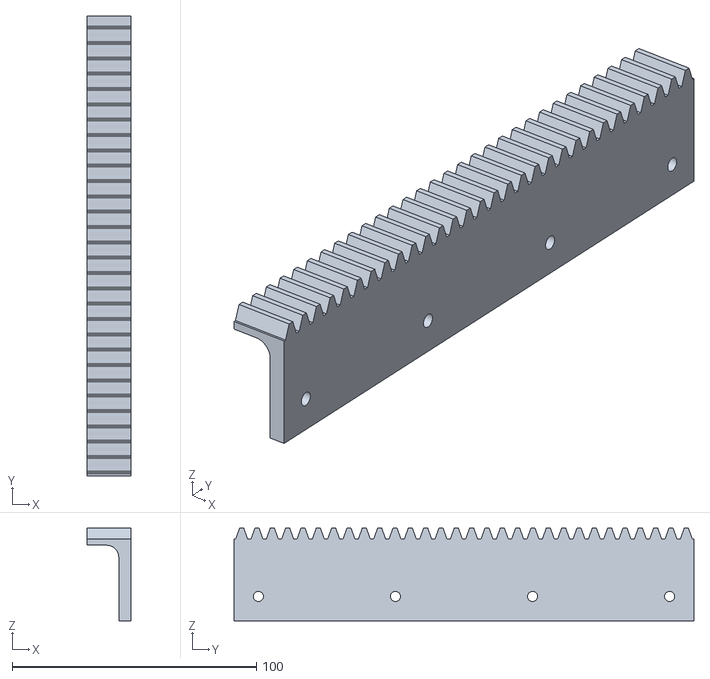
[picture p152: CAD file, 2017-09-23]
Prototipo_11/Piezas_Impresas/Cremallera_Transfer_1.stl
18.0 x 188.5 x 38.0
