NervenCid/UNAL_FDM/(list of files, cad)

Other CAD files:
Prototipo_11/Piezas_Impresas/Lamina_tensorY_v2.stl
Prototipo_11/(GT2) 36 Tooth x 8mm Bore Pulley.CATPart
Prototipo_11/AccesoriosTHK/Balinera.CATPart
Prototipo_11/AccesoriosTHK/RSR9ZZMRIEL.CATPart
Prototipo_11/Accesorios_IGUS/619_5.CATProduct
Prototipo_11/Accesorios_IGUS/619_5_PART1.CATPart
Prototipo_11/Accesorios_IGUS/619_5_PART2.CATPart
Prototipo_11/Accesorios_IGUS/619_5_PART3.CATPart
Prototipo_11/Accesorios_IGUS/BB_608_B180_10_GL_2.CATPart
Prototipo_11/Accesorios_IGUS/RGAS_JTRM_10x2.CATPart
Prototipo_11/Accesorios_IGUS/TS_04_15.CATPart
Prototipo_11/Accesorios_IGUS/TS_04_15x300.CATPart
Prototipo_11/Accesorios_IGUS/TS_04_15x336.CATPart
Prototipo_11/Accesorios_IGUS/TS_04_15x376.CATPart
Prototipo_11/Accesorios_IGUS/TS_04_15x420.CATPart
Prototipo_11/Accesorios_IGUS/TW_04_15.CATPart
Prototipo_11/Accesorios_IGUS/Tornillo_M8.CATPart
Prototipo_11/Accesorios_IGUS/Tornillo_M8x300.CATPart
Prototipo_11/Acople flexible.CATPart
Prototipo_11/Acople_5_8.CATPart
Prototipo_11/Analisis_EF/SoporteGiratorioX.CATProduct
Prototipo_11/Analisis_EF/SoporteGiratorioY.CATProduct
Prototipo_11/Analisis_EF/TensorX.CATProduct
Prototipo_11/Analisis_EF/TensorY.CATProduct
Prototipo_11/Audio.CATPart
Prototipo_11/Base_Movil_1.CATProduct
Prototipo_11/Base_Movil_2.CATProduct
Prototipo_11/CameraAssembly.CATPart
Prototipo_11/Compensador.CATProduct
Prototipo_11/Correa_Sinc_Y.CATPart
Prototipo_11/Correa_Sync_Z.CATPart
Prototipo_11/Correa_X.CATPart
Prototipo_11/Cremallera_Plantilla.CATPart
Prototipo_11/Eje_S_8_292.CATPart
Prototipo_11/Eje_S_8_400.CATPart
Prototipo_11/Eje_S_8_50.CATPart
Prototipo_11/Eje_XY.CATProduct
Prototipo_11/Ensamblaje_1.CATProduct
Prototipo_11/Ensamblaje_1_Aux.CATProduct
Prototipo_11/Ensamblaje_2.CATProduct
Prototipo_11/Estructura.CATProduct
Prototipo_11/Extruder Assembly.CATPart
Prototipo_11/ExtrusorPorta.CATProduct
Prototipo_11/ExtrusorPorta2.CATProduct
Prototipo_11/ExtrusorPorta3.CATProduct
Prototipo_11/ExtrusorPorta4.CATProduct
Prototipo_11/GPIO.CATPart
Prototipo_11/GPU.CATPart
Prototipo_11/GT2_20teeth_pulley.CATPart
Prototipo_11/GT2_20tooth.CATPart
Prototipo_11/GT2_Tensor.CATPart
Prototipo_11/Guia_Falsa_X.CATPart
Prototipo_11/Guia_Falsa_Y.CATPart
Prototipo_11/Guia_Falsa_Z.CATPart
Prototipo_11/HBP/HB.CATPart
Prototipo_11/HBP/HBP.CATProduct
Prototipo_11/HBP/Perfil_Item200.CATPart
Prototipo_11/HBP/Perfil_Item400.CATPart
Prototipo_11/HBP/Platina_Montaje.CATPart
Prototipo_11/HBP/Tabla.CATPart
Prototipo_11/HBP/Vidrio_HB.CATPart
Prototipo_11/HBP/Volumen.CATPart
Prototipo_11/HDMI.CATPart
Prototipo_11/LaminaTrans_TW.CATProduct
Prototipo_11/LaminaYTW04.CATProduct
Prototipo_11/Lamina_Tensor_B.CATPart
Prototipo_11/Laminas_TensorYTW.CATProduct
Prototipo_11/Mainboard2.CATPart
Prototipo_11/MakerBlock/42BYG_NEMA17.CATPart
Prototipo_11/MakerBlock/Bracket_U1.CATPart
Prototipo_11/MicroSD.CATPart
Prototipo_11/MicroSDSocket.CATPart
Prototipo_11/NEMA17_17HS4417.CATPart
Prototipo_11/NEMA17_Shaft.CATPart
Prototipo_11/Otros_Accesorios/AcopleEstEjeY.CATPart
Prototipo_11/Otros_Accesorios/EjeSincro.CATPart
Prototipo_11/Otros_Accesorios/GuiaCilindricaY.CATPart
Prototipo_11/Otros_Accesorios/SC8UU.CATPart
Prototipo_11/Part1.CATPart
Prototipo_11/PerfilesItem5/Eje_10.CATPart
Prototipo_11/PerfilesItem5/Eje_10x300.CATPart
Prototipo_11/PerfilesItem5/Eje_10x340.CATPart
Prototipo_11/PerfilesItem5/Perfil_Doble.CATPart
Prototipo_11/PerfilesItem5/Perfil_Doble_260.CATPart
Prototipo_11/PerfilesItem5/Perfil_Doble_292.CATPart
Prototipo_11/PerfilesItem5/Perfil_Doble_300.CATPart
Prototipo_11/PerfilesItem5/Perfil_Doble_40.CATPart
Prototipo_11/PerfilesItem5/Perfil_Doble_Final.CATPart
Prototipo_11/PerfilesItem5/Perfil_Doble_Movil.CATPart
Prototipo_11/PerfilesItem5/Perfil_Item.CATPart
Prototipo_11/PerfilesItem5/Perfil_Item_100.CATPart
Prototipo_11/PerfilesItem5/Perfil_Item_150.CATPart
Prototipo_11/PerfilesItem5/Perfil_Item_17.CATPart
Prototipo_11/PerfilesItem5/Perfil_Item_18.CATPart
Prototipo_11/PerfilesItem5/Perfil_Item_230.CATPart
Prototipo_11/PerfilesItem5/Perfil_Item_264.CATPart
Prototipo_11/PerfilesItem5/Perfil_Item_280.CATPart
Prototipo_11/PerfilesItem5/Perfil_Item_284.CATPart
Prototipo_11/PerfilesItem5/Perfil_Item_300.CATPart
Prototipo_11/PerfilesItem5/Perfil_Item_304.CATPart
Prototipo_11/PerfilesItem5/Perfil_Item_336.CATPart
Prototipo_11/PerfilesItem5/Perfil_Item_340.CATPart
Prototipo_11/PerfilesItem5/Perfil_Item_360.CATPart
Prototipo_11/PerfilesItem5/Perfil_Item_38.CATPart
Prototipo_11/PerfilesItem5/Perfil_Item_380.CATPart
Prototipo_11/PerfilesItem5/Perfil_Item_400.CATPart
Prototipo_11/PerfilesItem5/Perfil_Item_420.CATPart
Prototipo_11/PerfilesItem5/Perfil_Item_50.CATPart
Prototipo_11/PerfilesItem5/Perfil_Item_500.CATPart
Prototipo_11/PerfilesItem5/Perfil_Item_51.CATPart
Prototipo_11/PerfilesItem5/Perfil_Item_52.CATPart
Prototipo_11/PerfilesItem5/Perfil_Item_72.CATPart
Prototipo_11/PerfilesItem5/Perfil_Triple -60.CATPart
Prototipo_11/PerfilesItem5/Perfil_Triple.CATPart
Prototipo_11/PerfilesItem5/item_0037006_T_Slot_Nut_5_St_M4_2.stp
Prototipo_11/PerfilesItem5/item_0043719_T_Slot_Nut_5_St_M3_1.stp
Prototipo_11/PerfilesItem5/item_7000262_Profile_M_20x4_E.CATPart
Prototipo_11/Piezas_Impresas/AdaptadorContraP.CATPart
Prototipo_11/Piezas_Impresas/Arandela_Rod.CATPart
Prototipo_11/Piezas_Impresas/BujeAntiFlex.CATPart
Prototipo_11/Piezas_Impresas/BujeTornillo.CATPart
Prototipo_11/Piezas_Impresas/ContraPeso.CATPart
Prototipo_11/Piezas_Impresas/ContrapesoExtrusor.CATPart
Prototipo_11/Piezas_Impresas/Cremallera_Horizontal.CATPart
Prototipo_11/Piezas_Impresas/Cremallera_Transfer_1.CATPart
Prototipo_11/Piezas_Impresas/EJE_Acople_Gear_Polea.CATPart
Prototipo_11/Piezas_Impresas/EjeAmpliado_5_8.CATPart
Prototipo_11/Piezas_Impresas/GT2_Tensor.CATPart
Prototipo_11/Piezas_Impresas/GT2_Tensor_v2.CATPart
Prototipo_11/Piezas_Impresas/GT2_Tensor_v2.stl
Prototipo_11/Piezas_Impresas/GT2_Tensor_v3.CATPart
Prototipo_11/Piezas_Impresas/Gear_Prueba1.CATPart
Prototipo_11/Piezas_Impresas/Gear_Transfer.CATPart
Prototipo_11/Piezas_Impresas/Gear_input.CATPart
Prototipo_11/Piezas_Impresas/Gear_output.CATPart
Prototipo_11/Piezas_Impresas/Guia_FilamentoA.CATPart
Prototipo_11/Piezas_Impresas/LaminaComp1.CATPart
Prototipo_11/Piezas_Impresas/LaminaComp2.CATPart
Prototipo_11/Piezas_Impresas/LaminaEndStop.CATPart
Prototipo_11/Piezas_Impresas/Lamina_Acople_10mm_EjeXY.CATPart
Prototipo_11/Piezas_Impresas/Lamina_Acople_10mm_EjeXYV2.CATPart
Prototipo_11/Piezas_Impresas/Lamina_Acople_10mm_EjeXYV3.CATPart
Prototipo_11/Piezas_Impresas/Lamina_Acople_10mm_EjeXYV4.CATPart
Prototipo_11/Piezas_Impresas/Lamina_Acople_4mm.CATPart
Prototipo_11/Piezas_Impresas/Lamina_Acople_4mm.stl
Prototipo_11/Piezas_Impresas/Lamina_Acople_4mm_EjeXTensor.CATPart
Prototipo_11/Piezas_Impresas/Lamina_Acople_4mm_EjeXTensorV2.CATPart
Prototipo_11/Piezas_Impresas/Lamina_Acople_4mm_EjeXTensor[TOLERANCIA].CATPart
Prototipo_11/Piezas_Impresas/Lamina_Acople_4mm_EjeXY.CATPart
Prototipo_11/Piezas_Impresas/Lamina_Acople_4mm_Extrusor.CATPart
Prototipo_11/Piezas_Impresas/Lamina_Acople_4mm_v2.CATPart
Prototipo_11/Piezas_Impresas/Lamina_Acople_4mm_v2.stl
Prototipo_11/Piezas_Impresas/Lamina_Acople_4mm_v3.CATPart
Prototipo_11/Piezas_Impresas/Lamina_Acople_Extrusor_v2.CATPart
Prototipo_11/Piezas_Impresas/Lamina_Acople_Extrusor_v2.stl
Prototipo_11/Piezas_Impresas/Lamina_Acople_Extrusor_v3.CATPart
Prototipo_11/Piezas_Impresas/Lamina_Acople_Extrusor_v3.stl
Prototipo_11/Piezas_Impresas/Lamina_Acople_Extrusor_v4.CATPart
Prototipo_11/Piezas_Impresas/Lamina_Acople_Extrusor_v4.stl
Prototipo_11/Piezas_Impresas/Lamina_Acople_Extrusor_v5.CATPart
Prototipo_11/Piezas_Impresas/Lamina_Acople_Transfer.CATPart
Prototipo_11/Piezas_Impresas/Lamina_Acople_Transfer_v2.CATPart
Prototipo_11/Piezas_Impresas/Lamina_Fijacion.CATPart
Prototipo_11/Piezas_Impresas/Lamina_TensorA_4mm.CATPart
Prototipo_11/Piezas_Impresas/Lamina_Tensor_A_V1.CATPart
Prototipo_11/Piezas_Impresas/Lamina_Tensor_A_V1.stl
Prototipo_11/Piezas_Impresas/Lamina_Tensor_A_V2.CATPart
Prototipo_11/Piezas_Impresas/Lamina_Tensor_B_V1.CATPart
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
