NervenCid/UNAL_FDM/Prototipo_11/Analisis_EF/Platina_Montaje/index.html

Platina_Montaje

### MESH:

Entity | Size
Nodes | 975
Elements | 2530

### ELEMENT TYPE:

Connectivity | Statistics
TE4 | 2530 ( 100.00% )

### ELEMENT QUALITY:

Criterion | Good | Poor | Bad | Worst | Average
Stretch | 2472 ( 97.71% ) | 58 ( 2.29% ) | 0 ( 0.00% ) | 0.220 | 0.477
Aspect Ratio | 2454 ( 97.00% ) | 76 ( 3.00% ) | 0 ( 0.00% ) | 6.248 | 2.916

### Materials.1

Material | User Material.2 : Steel
Young's modulus | 2e+011N_m2
Poisson's ratio | 0.266
Density | 7860kg_m3
Coefficient of thermal expansion | 1.17e-005_Kdeg
Yield strength | 2.5e+008N_m2

# Static Case

### Boundary Conditions

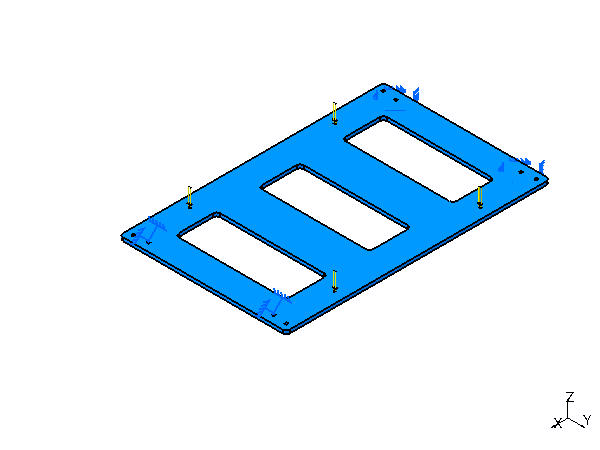
[picture p153: Prototipo_11/Analisis_EF/Platina_Montaje/file1_58896d8b.jpg]


Figure 1

### STRUCTURE Computation

Number of nodes | : | 975
Number of elements | : | 2530
Number of D.O.F. | : | 2925
Number of Contact relations | : | 0
Number of Kinematic relations | : | 0

Linear tetrahedron | : | 2530

### RESTRAINT Computation

Name: Restraints.1

Number of S.P.C : 93

### LOAD Computation

Name: Loads.1

Applied load resultant :

Fx | = | 0 | . | 000e+000 | N
Fy | = | 0 | . | 000e+000 | N
Fz | = | -5 | . | 742e-001 | N
Mx | = | 4 | . | 774e-004 | Nxm
My | = | 5 | . | 529e-004 | Nxm
Mz | = | 0 | . | 000e+000 | Nxm

### STIFFNESS Computation

Number of lines | : | 2925
Number of coefficients | : | 46314
Number of blocks | : | 1
Maximum number of coefficients per bloc | : | 46314
Total matrix size | : | 0 | . | 54 | Mb

### SINGULARITY Computation

Restraint: Restraints.1

Number of local singularities | : | 0
Number of singularities in translation | : | 0
Number of singularities in rotation | : | 0
Generated constraint type | : | MPC

### CONSTRAINT Computation

Restraint: Restraints.1

Number of constraints | : | 93
Number of coefficients | : | 0
Number of factorized constraints | : | 93
Number of coefficients | : | 0
Number of deferred constraints | : | 0

### FACTORIZED Computation

Method | : | SPARSE
Number of factorized degrees | : | 2832
Number of supernodes | : | 438
Number of overhead indices | : | 13734
Number of coefficients | : | 124305
Maximum front width | : | 114
Maximum front size | : | 6555
Size of the factorized matrix (Mb) | : | 0 | . | 948372
Number of blocks | : | 1
Number of Mflops for factorization | : | 7 | . | 244e+000
Number of Mflops for solve | : | 5 | . | 114e-001
Minimum relative pivot | : | 5 | . | 121e-004

Minimum and maximum pivot

Value | Dof | Node | x (mm) | y (mm) | z (mm)
6.6495e+006 | Tz | 974 | 1.3102e+002 | 8.0000e+001 | -1.7000e+001
2.4907e+010 | Tx | 427 | -1.8568e+002 | 1.1284e+002 | -1.7000e+001

Minimum pivot

Value | Dof | Node | x (mm) | y (mm) | z (mm)
7.8886e+006 | Tz | 975 | -1.4689e+002 | -1.0137e+002 | -1.4500e+001
2.4558e+007 | Tz | 511 | -1.4173e+002 | 1.0608e+002 | -1.7000e+001
4.6860e+007 | Tz | 392 | 1.5000e+002 | 2.6950e+001 | -1.7000e+001
4.7576e+007 | Tz | 973 | -9.8608e+001 | -8.6997e+001 | -1.7000e+001
4.8472e+007 | Tz | 945 | 1.8052e+001 | -8.5487e+001 | -1.2000e+001
4.9142e+007 | Tz | 535 | 7.1996e+001 | 9.3812e+001 | -1.7000e+001
6.1932e+007 | Tz | 969 | 1.7941e+002 | 1.1414e+002 | -1.4477e+001
7.3235e+007 | Tz | 401 | 1.5000e+002 | 4.9033e+001 | -1.2000e+001
8.7169e+007 | Tz | 867 | 1.0049e+002 | 1.0860e+002 | -1.2000e+001

Translational pivot distribution

Value | Percentage
10.E6 --> 10.E7 | 7.0621e-002
10.E7 --> 10.E8 | 3.5311e-001
10.E8 --> 10.E9 | 1.6525e+001
10.E9 --> 10.E10 | 8.0297e+001
10.E10 --> 10.E11 | 2.7542e+000

### DIRECT METHOD Computation

Name: Static Case Solution.1

Restraint: Restraints.1

Load: Loads.1

Strain Energy : 8.481e-009 J

Equilibrium

Components | Applied Forces | Reactions | Residual | Relative Magnitude Error
Fx (N) | 0.0000e+000 | 1.9349e-013 | 1.9349e-013 | 2.0299e-013
Fy (N) | 0.0000e+000 | -9.0553e-015 | -9.0553e-015 | 9.5002e-015
Fz (N) | -5.7418e-001 | 5.7418e-001 | -4.1818e-012 | 4.3872e-012
Mx (Nxm) | 4.7738e-004 | -4.7738e-004 | -7.7295e-014 | 4.2680e-013
My (Nxm) | 5.5285e-004 | -5.5285e-004 | -2.1544e-013 | 1.1896e-012
Mz (Nxm) | 0.0000e+000 | 9.4564e-016 | 9.4564e-016 | 5.2216e-015

### Static Case Solution.1 - Deformed mesh.2

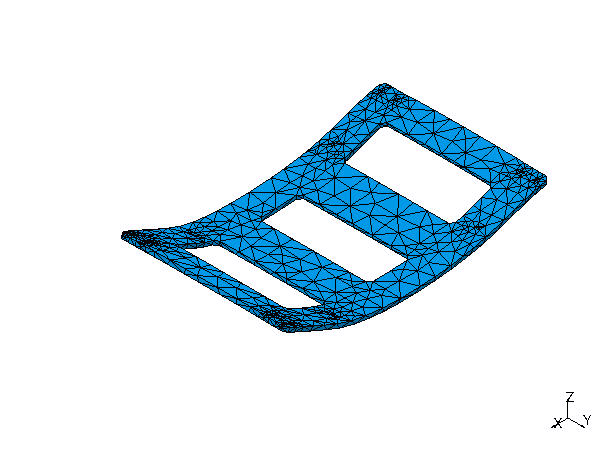
[picture p154: Prototipo_11/Analisis_EF/Platina_Montaje/file2_58896d8b.jpg]


Figure 2

On deformed mesh ---- On boundary ---- Over all the model

### Static Case Solution.1 - Von Mises stress (nodal values).2

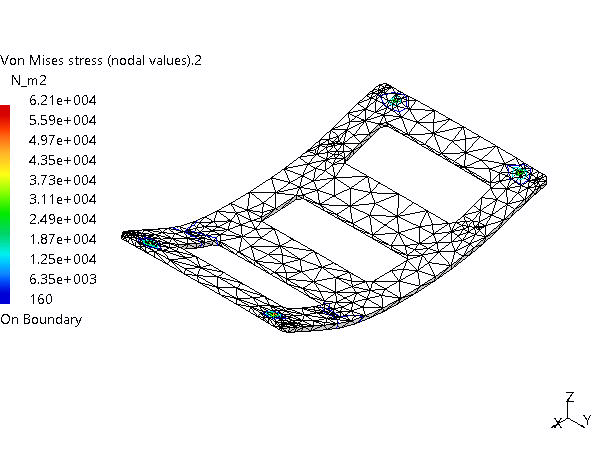
[picture p155: Prototipo_11/Analisis_EF/Platina_Montaje/file3_58896d8b.jpg]


Figure 3

3D elements: : Components: : All

On deformed mesh ---- On boundary ---- Over all the model

### Static Case Solution.1 - Translational displacement vector.1

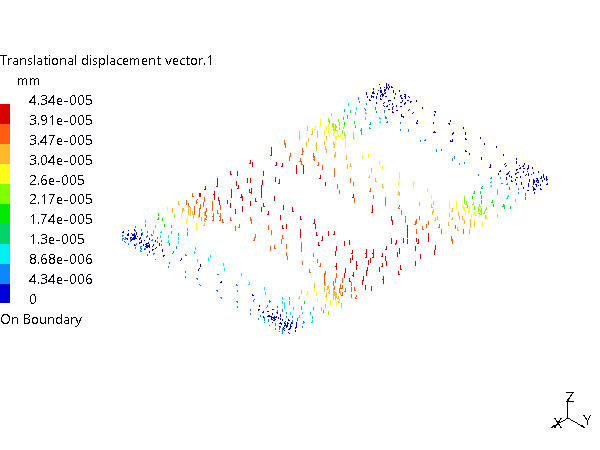
[picture p156: Prototipo_11/Analisis_EF/Platina_Montaje/file4_58896d8b.jpg]


Figure 4

3D elements: : Components: : All

On deformed mesh ---- On boundary ---- Over all the model

### Static Case Solution.1 - Deformed mesh.1

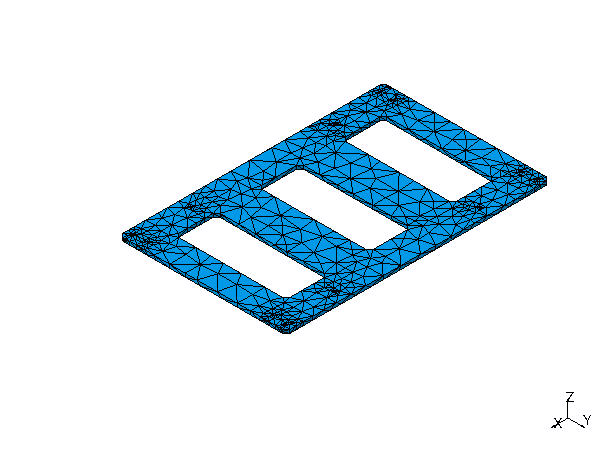
[picture p157: Prototipo_11/Analisis_EF/Platina_Montaje/file5_58896d8b.jpg]


Figure 5

On deformed mesh ---- On boundary ---- Over all the model

### Static Case Solution.1 - Von Mises stress (nodal values).1

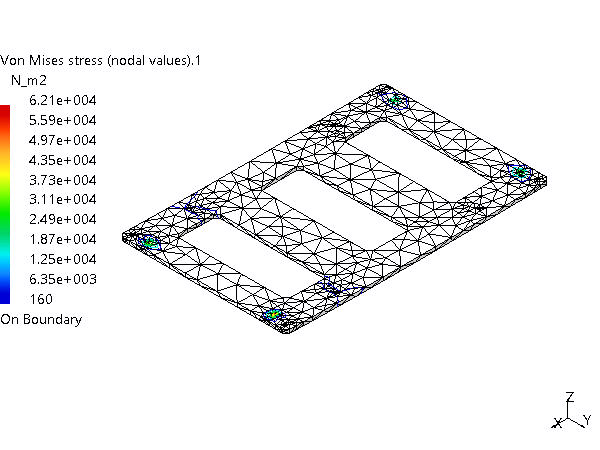
[picture p158: Prototipo_11/Analisis_EF/Platina_Montaje/file6_58896d8b.jpg]


Figure 6

3D elements: : Components: : All

On deformed mesh ---- On boundary ---- Over all the model

### Global Sensors

Sensor Name | Sensor Value
Energy | 8.481e-009J
