NervenCid/UNAL_FDM/Prototipo_11/Planos/EnsamblajeFULL.jpg

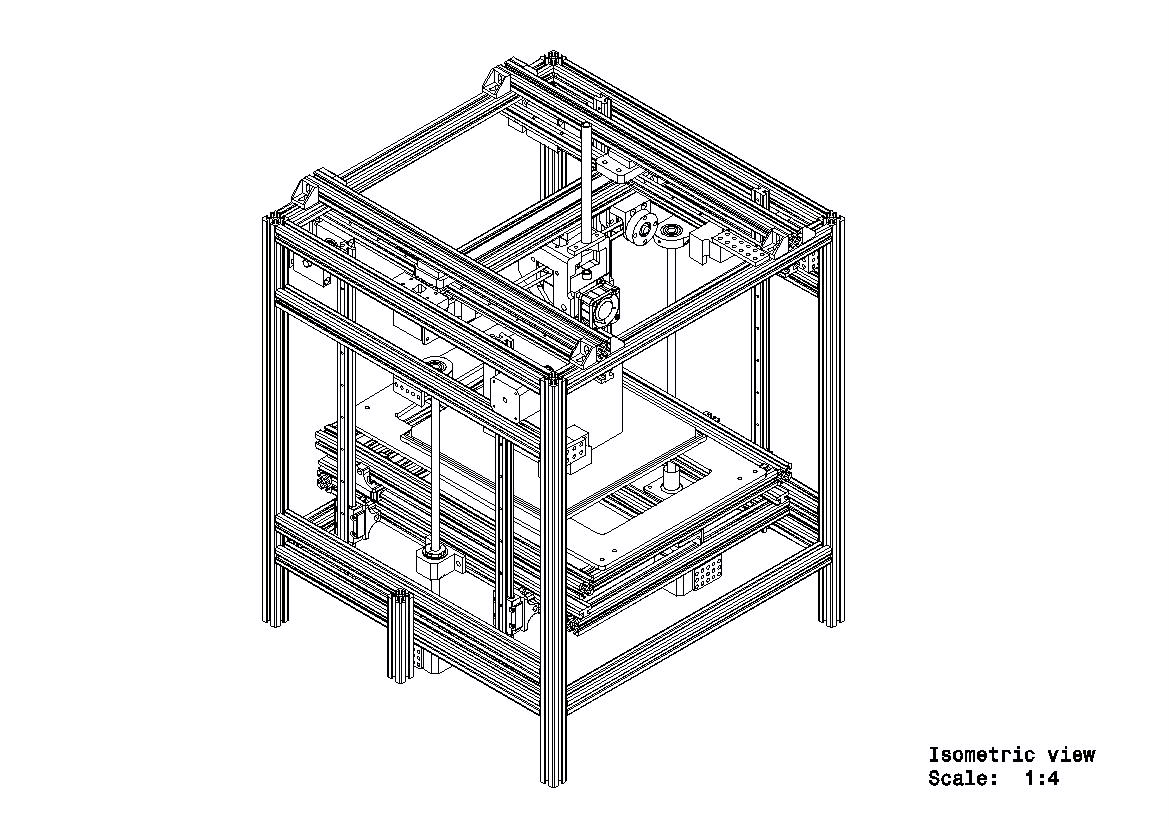
Prototipo_11/Planos/EnsamblajeFULL.jpg
