NervenCid/UNAL_FDM/Prototipo_11/Planos Electricos/BaseEnsamblada.pdf

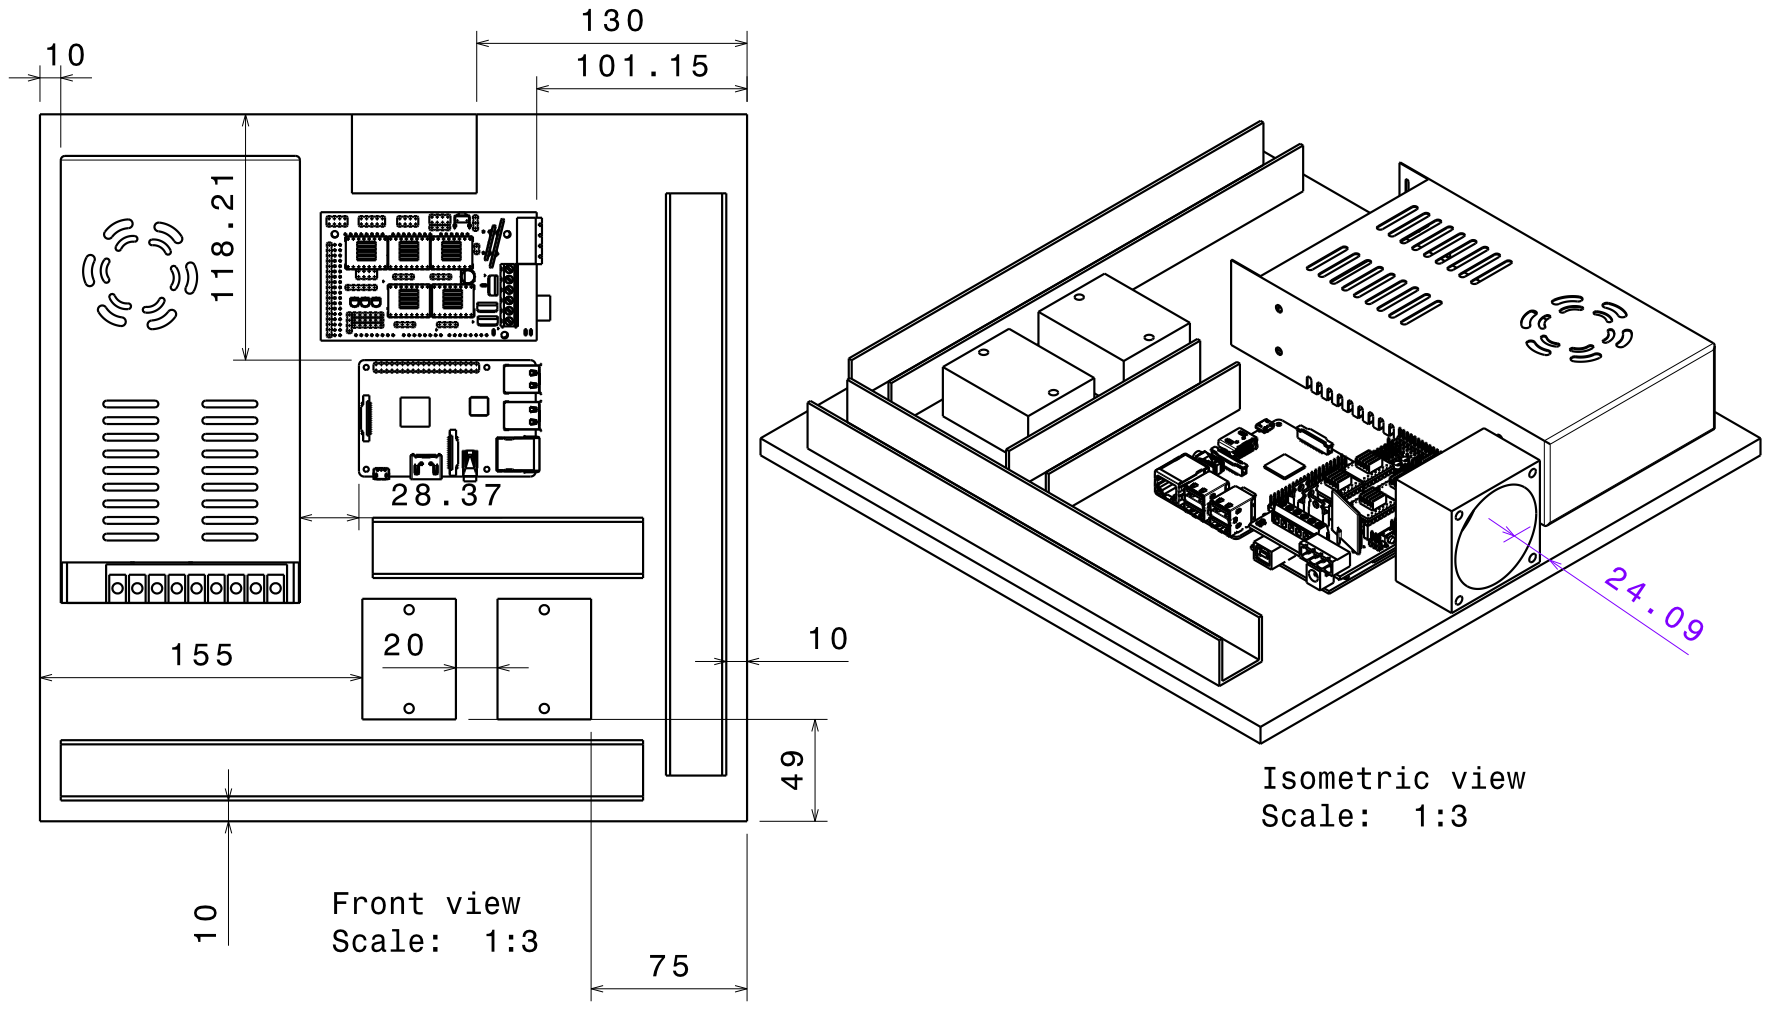
[picture p160: page 1]
