NervenCid/UNAL_FDM/Prototipo_11/Planos/EnsamblajeFULL.pdf

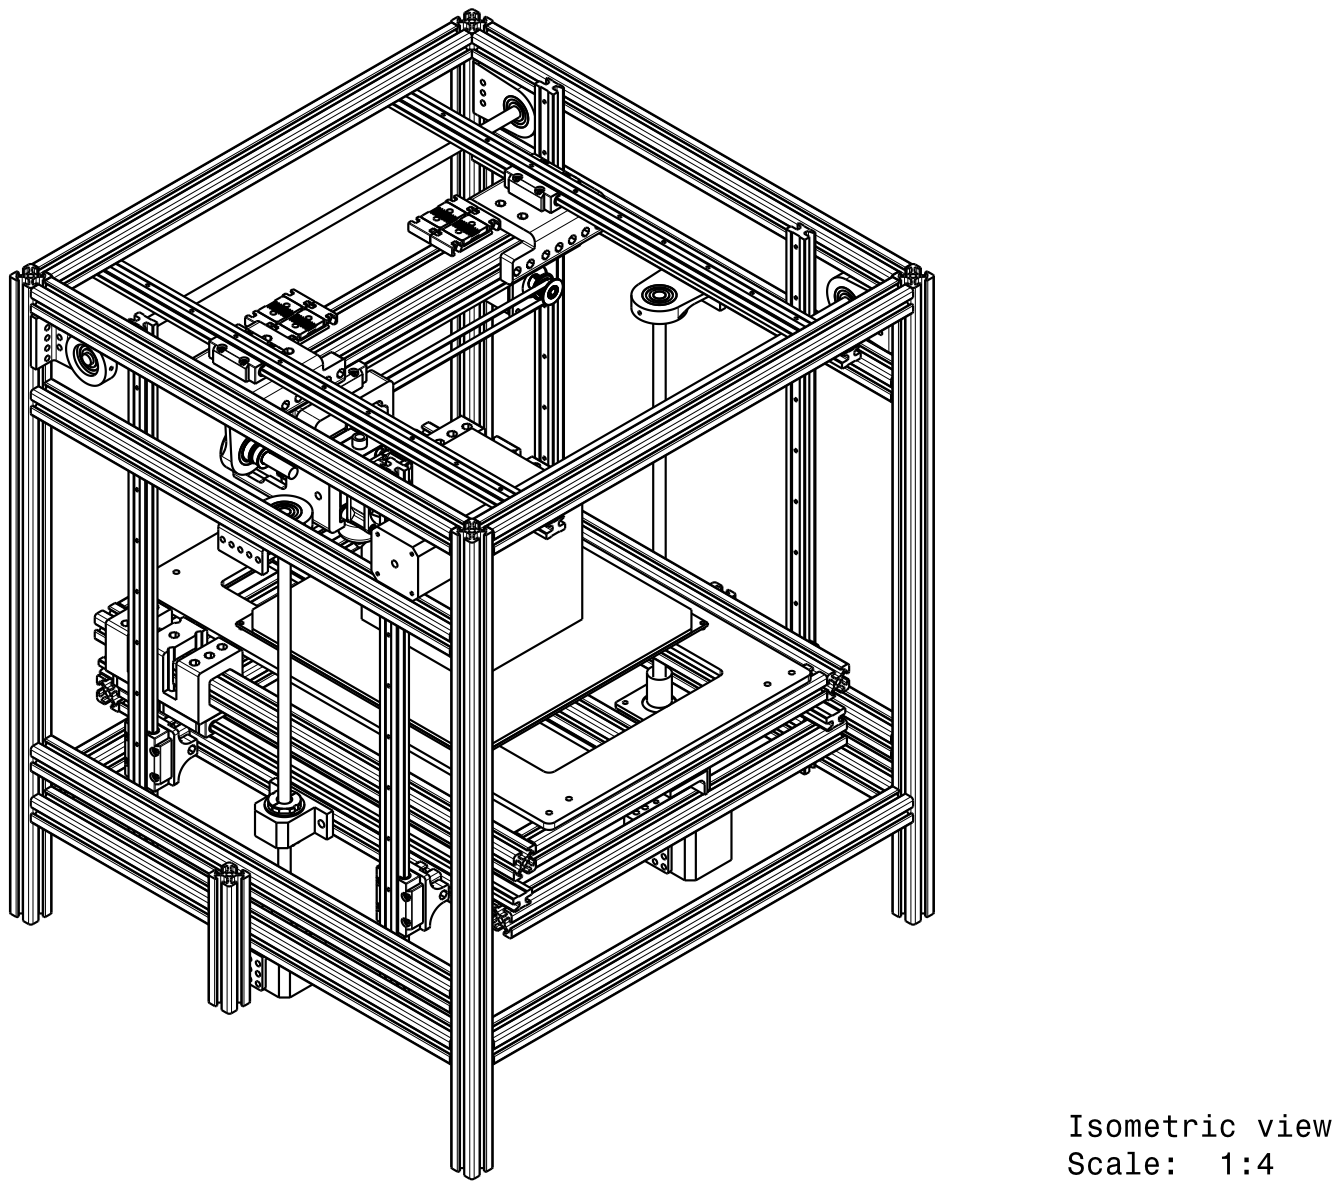
[picture p161: page 1]
