NervenCid/UNAL_FDM/Prototipo_11/Base.pdf

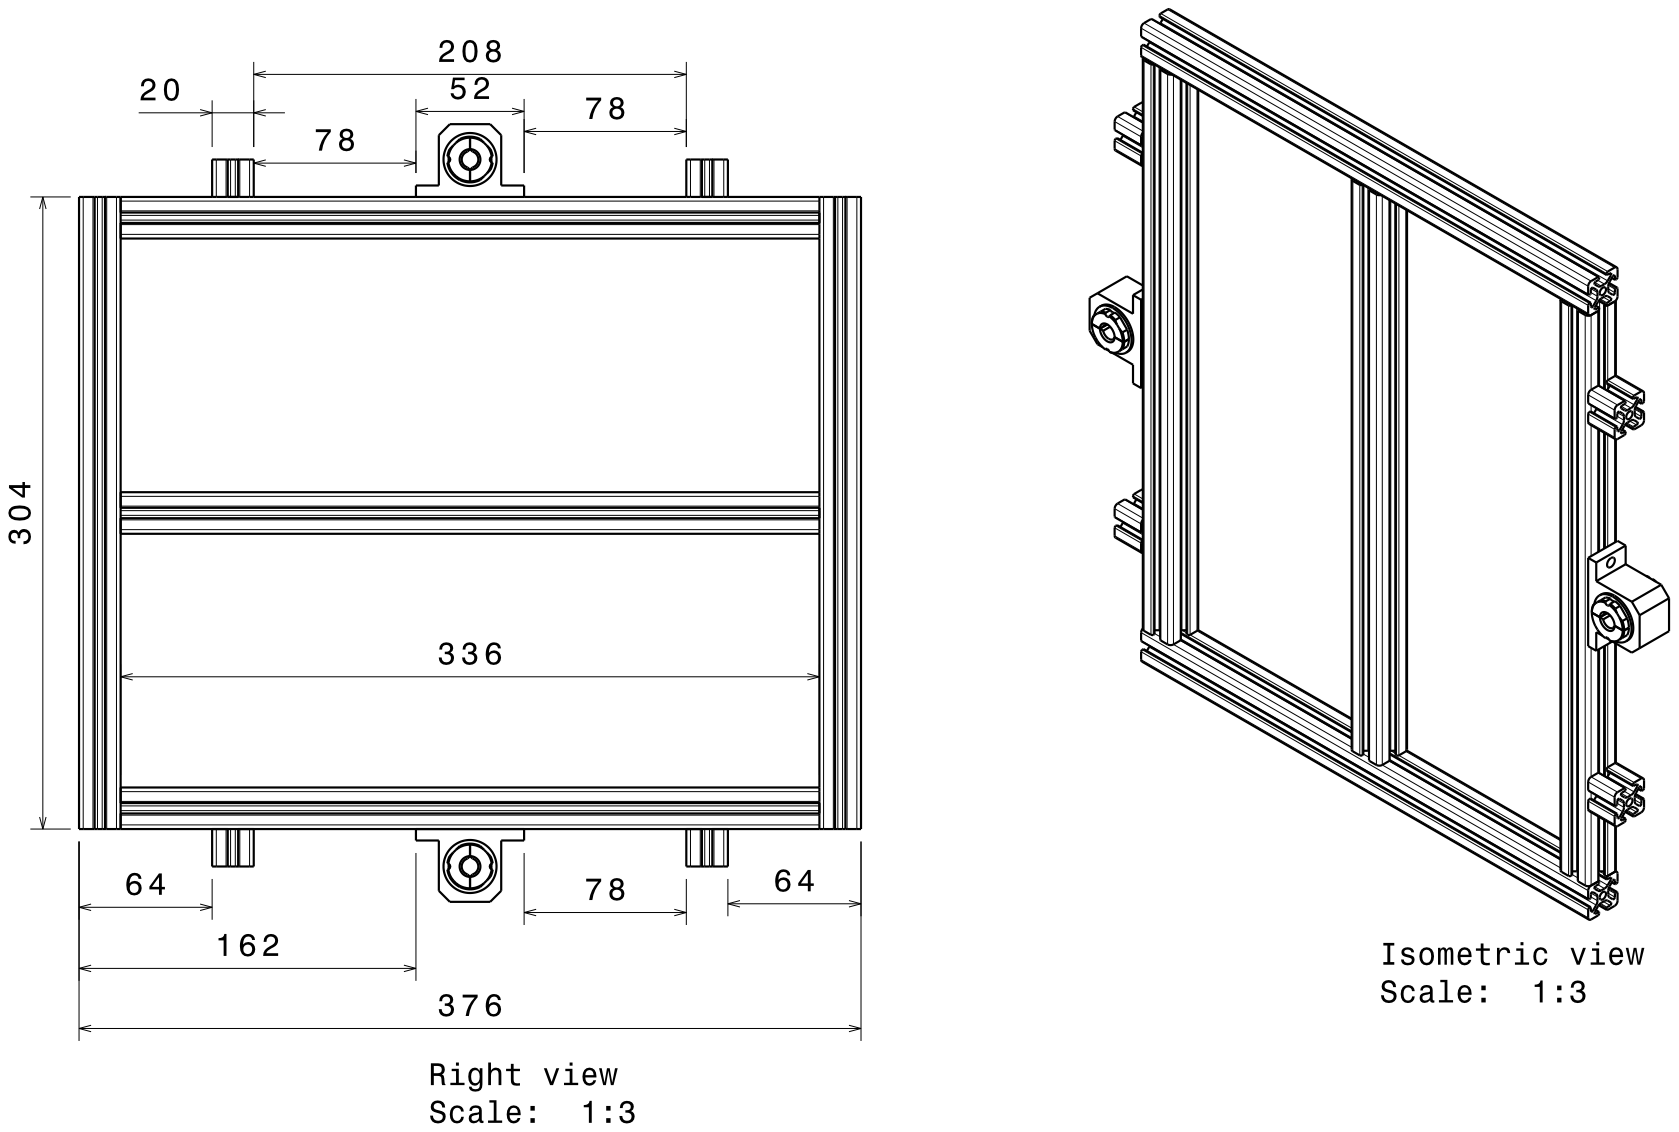
[picture p162: page 1]
