NervenCid/UNAL_FDM/Prototipo_11/Base_Movil_1.pdf

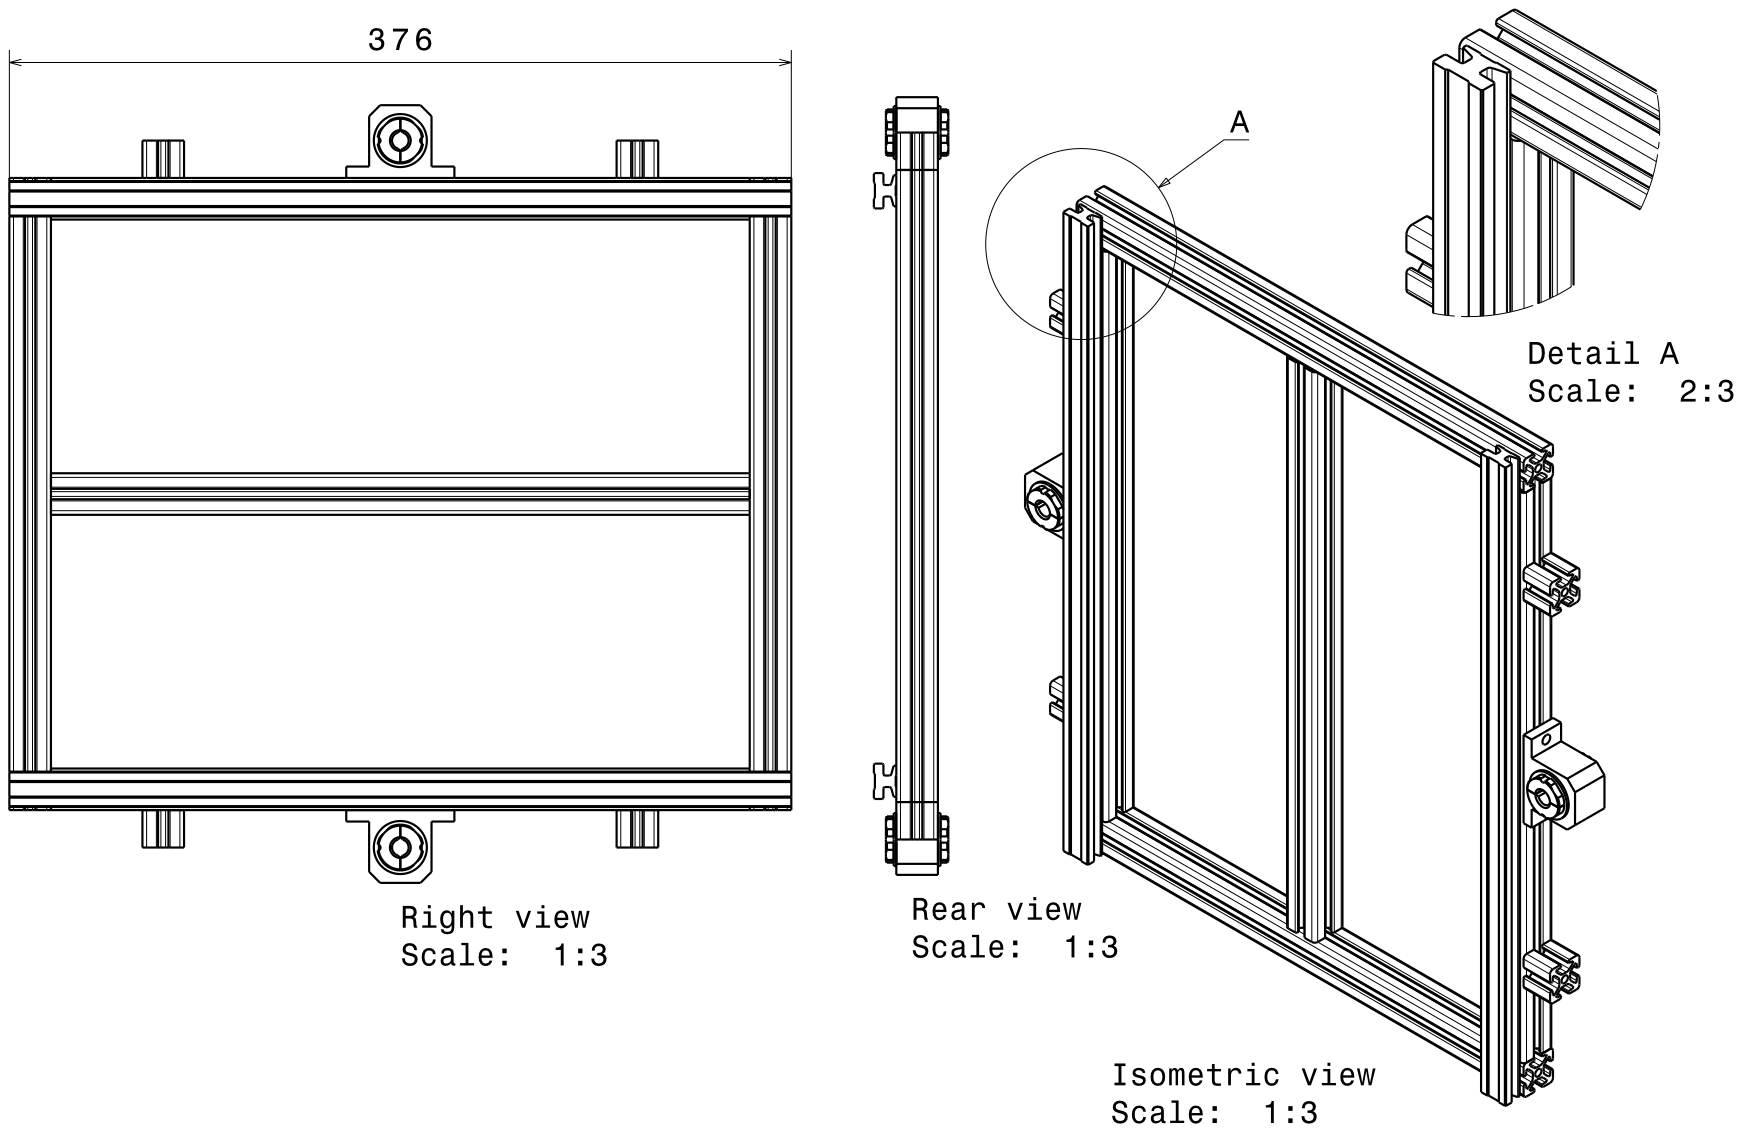
[picture p163: page 1]
