NervenCid/UNAL_FDM/Prototipo_11/LaminaTensorY.pdf

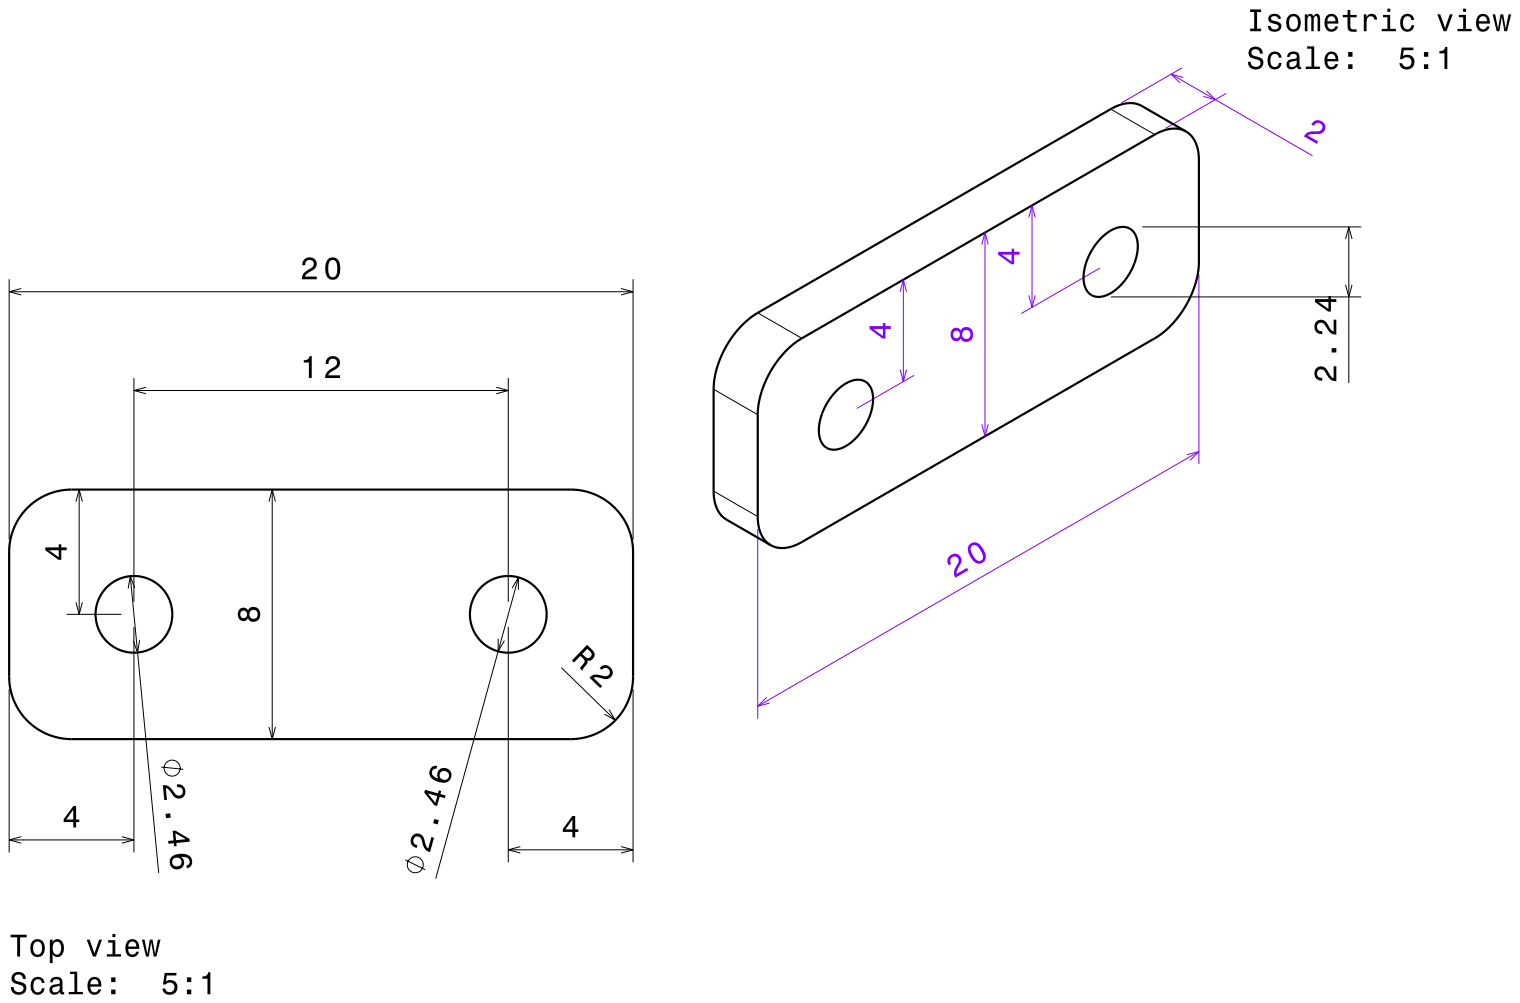
[picture p164: page 1]
