NervenCid/UNAL_FDM/Prototipo_11/Perforaciones.pdf

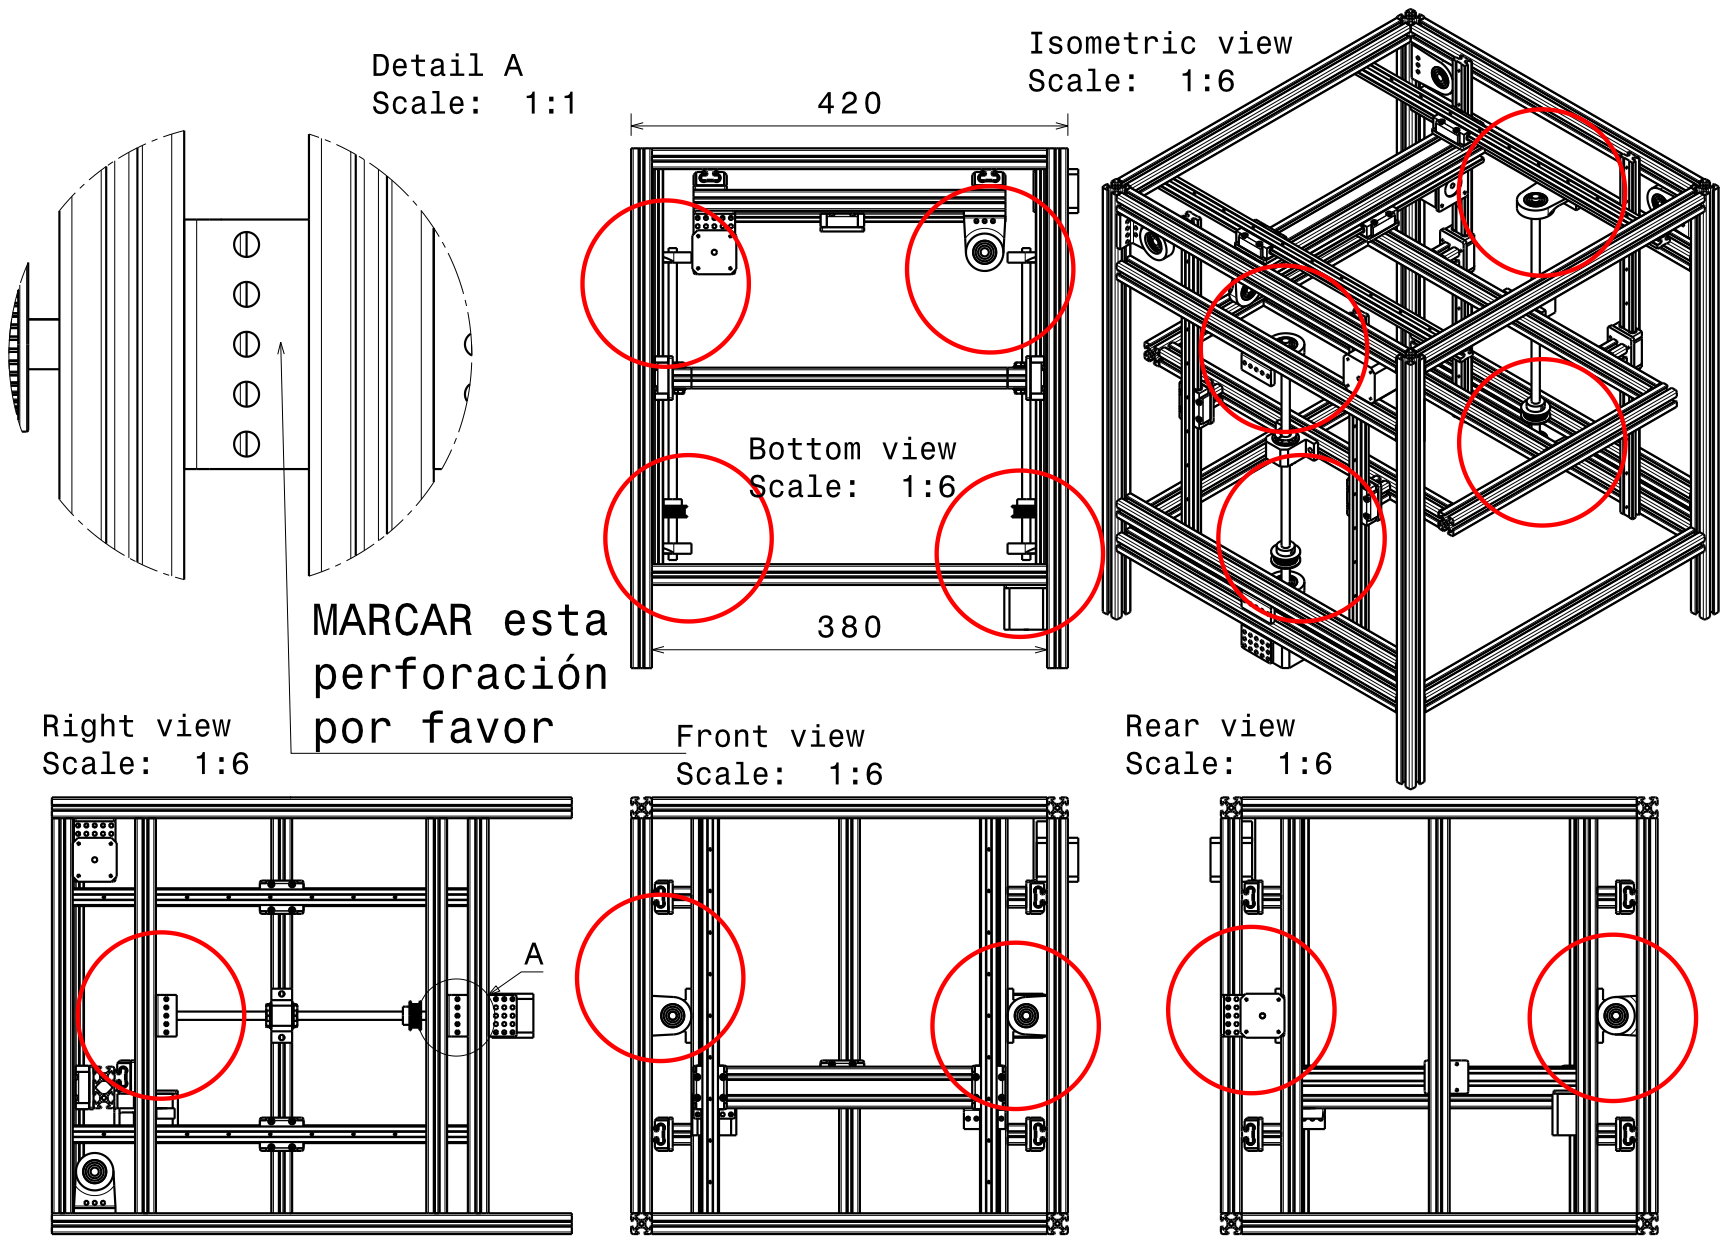
[picture p165: page 1]
