NervenCid/UNAL_FDM/Prototipo_11/DFMA/Estructura_1.pdf

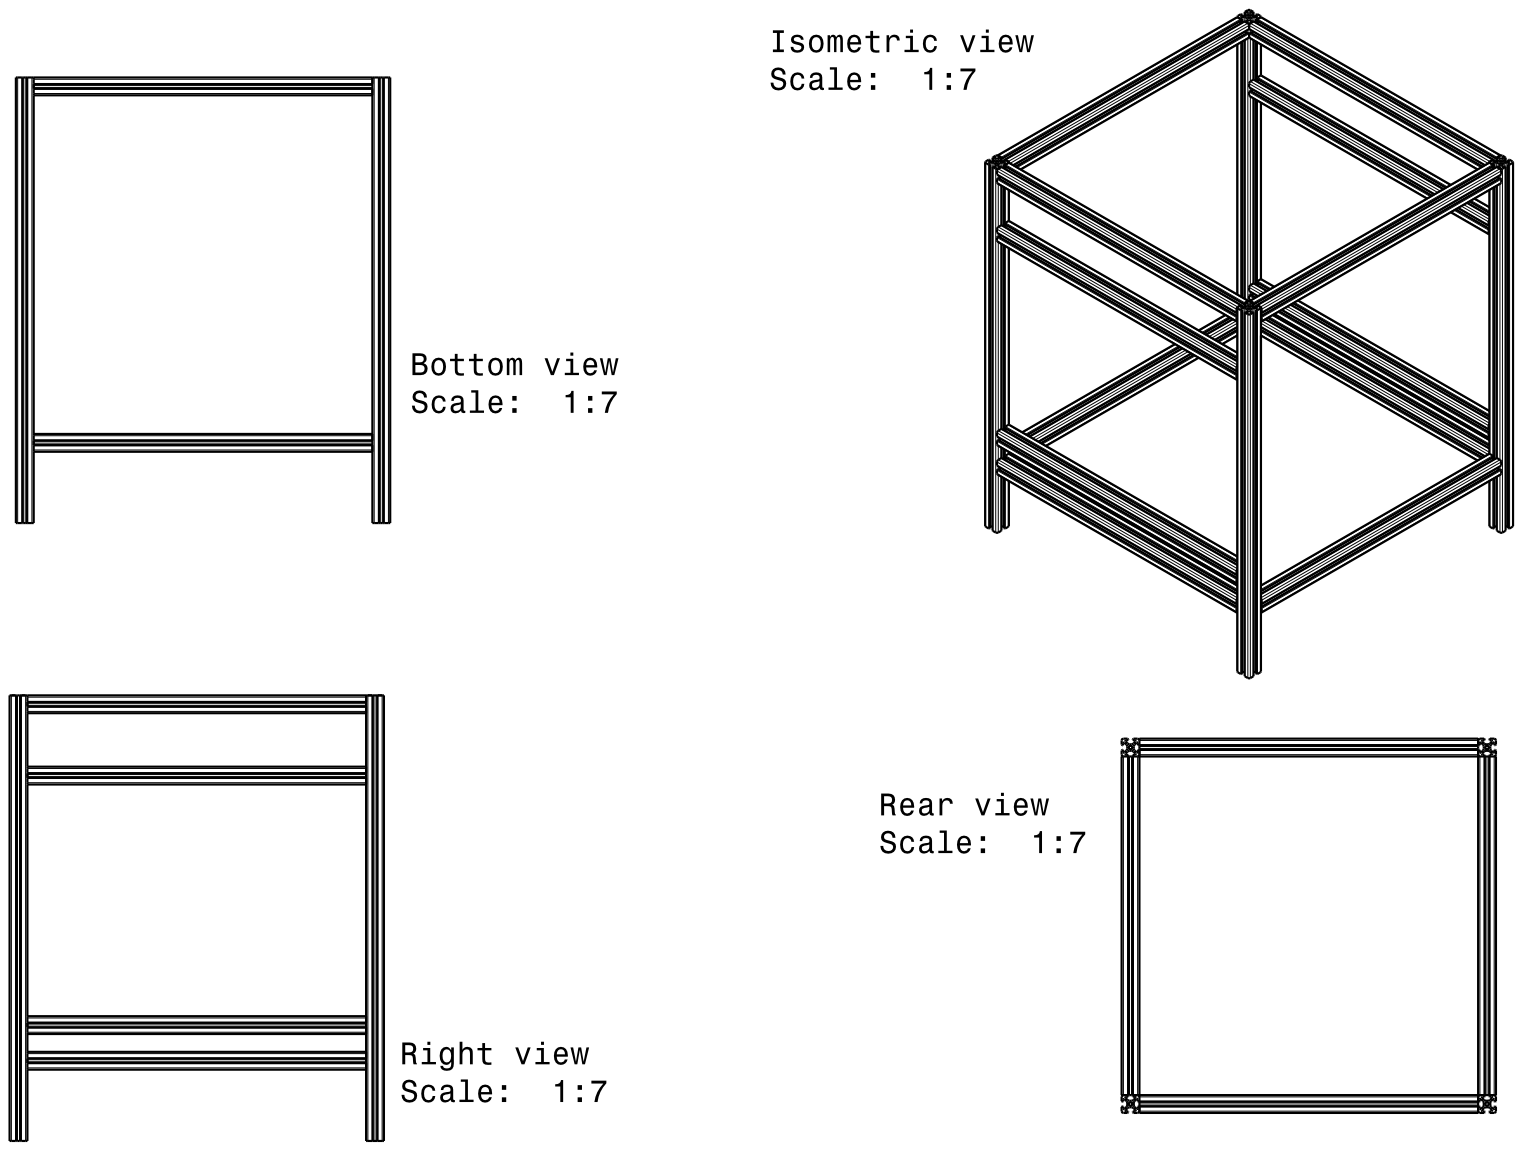
[picture p166: page 1]
