NervenCid/UNAL_FDM/Prototipo_11/Planos Electricos/Base.pdf

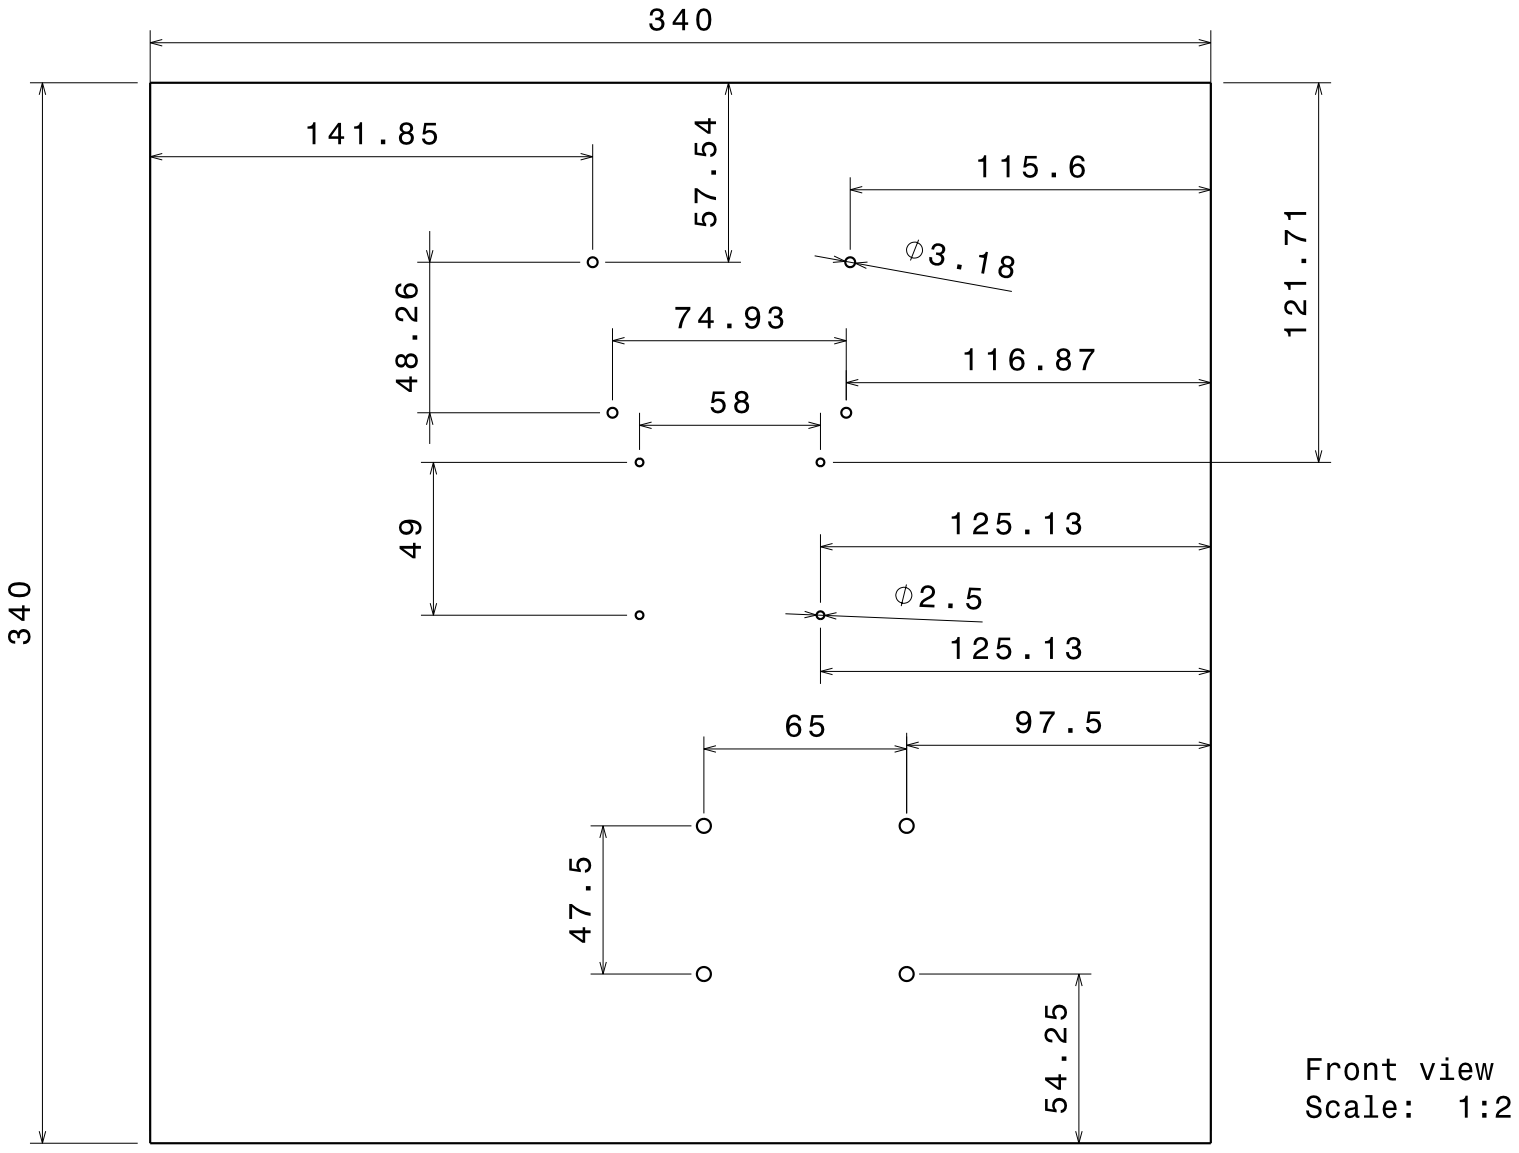
[picture p167: page 1]
