NervenCid/UNAL_FDM/Prototipo_11/Planos Electricos/ConjuntoExtrusor.pdf

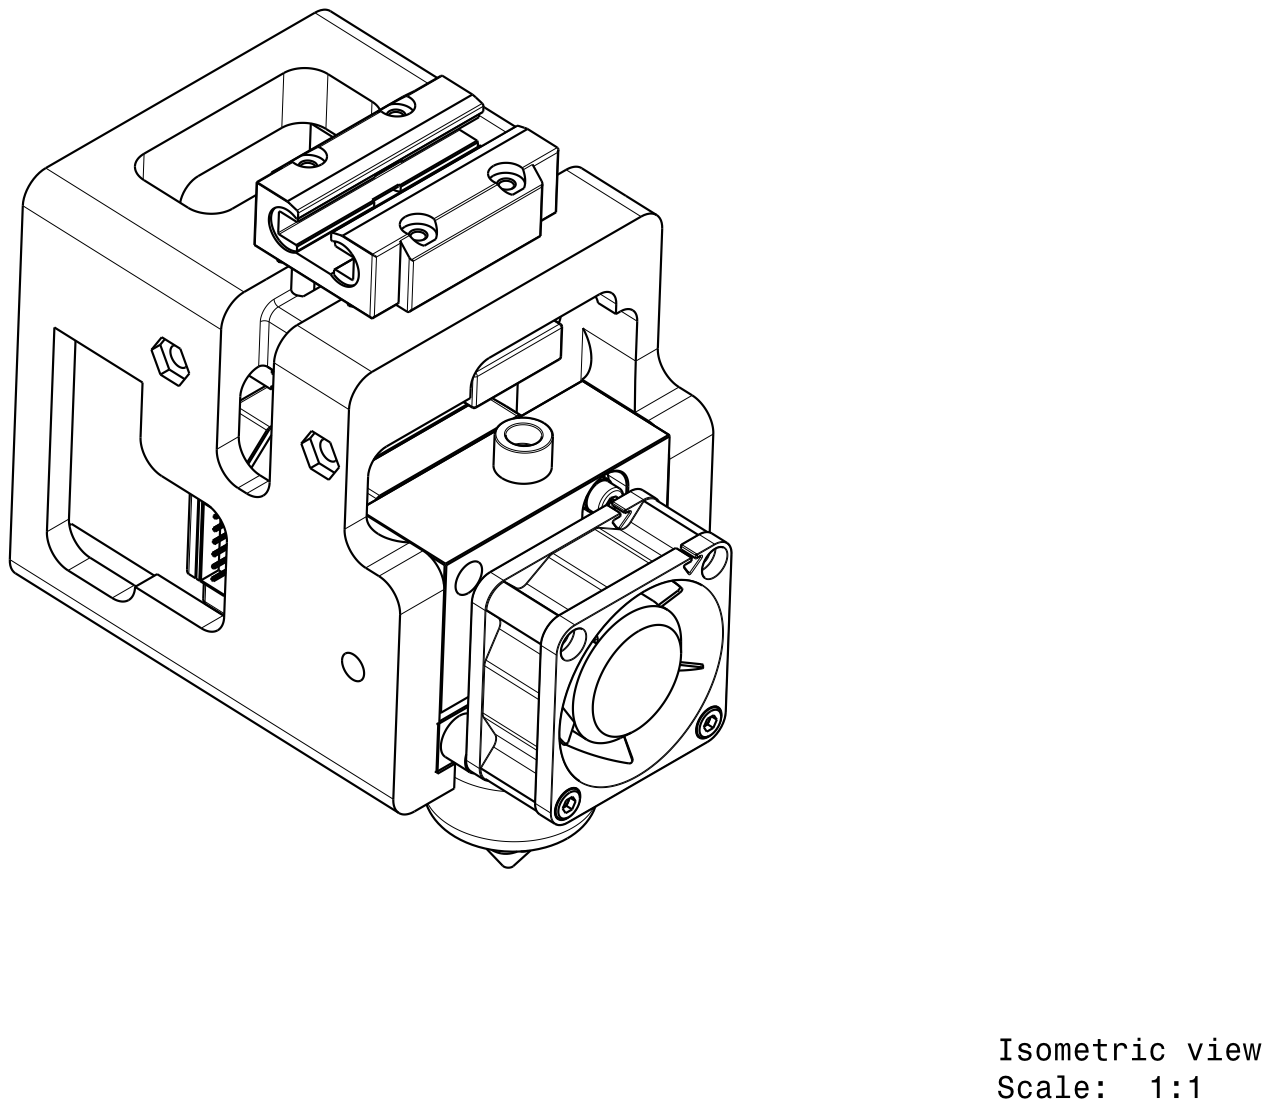
[picture p168: page 1]
