NervenCid/UNAL_FDM/Prototipo_11/Planos Electricos/ConjuntoExtrusorExplo.pdf

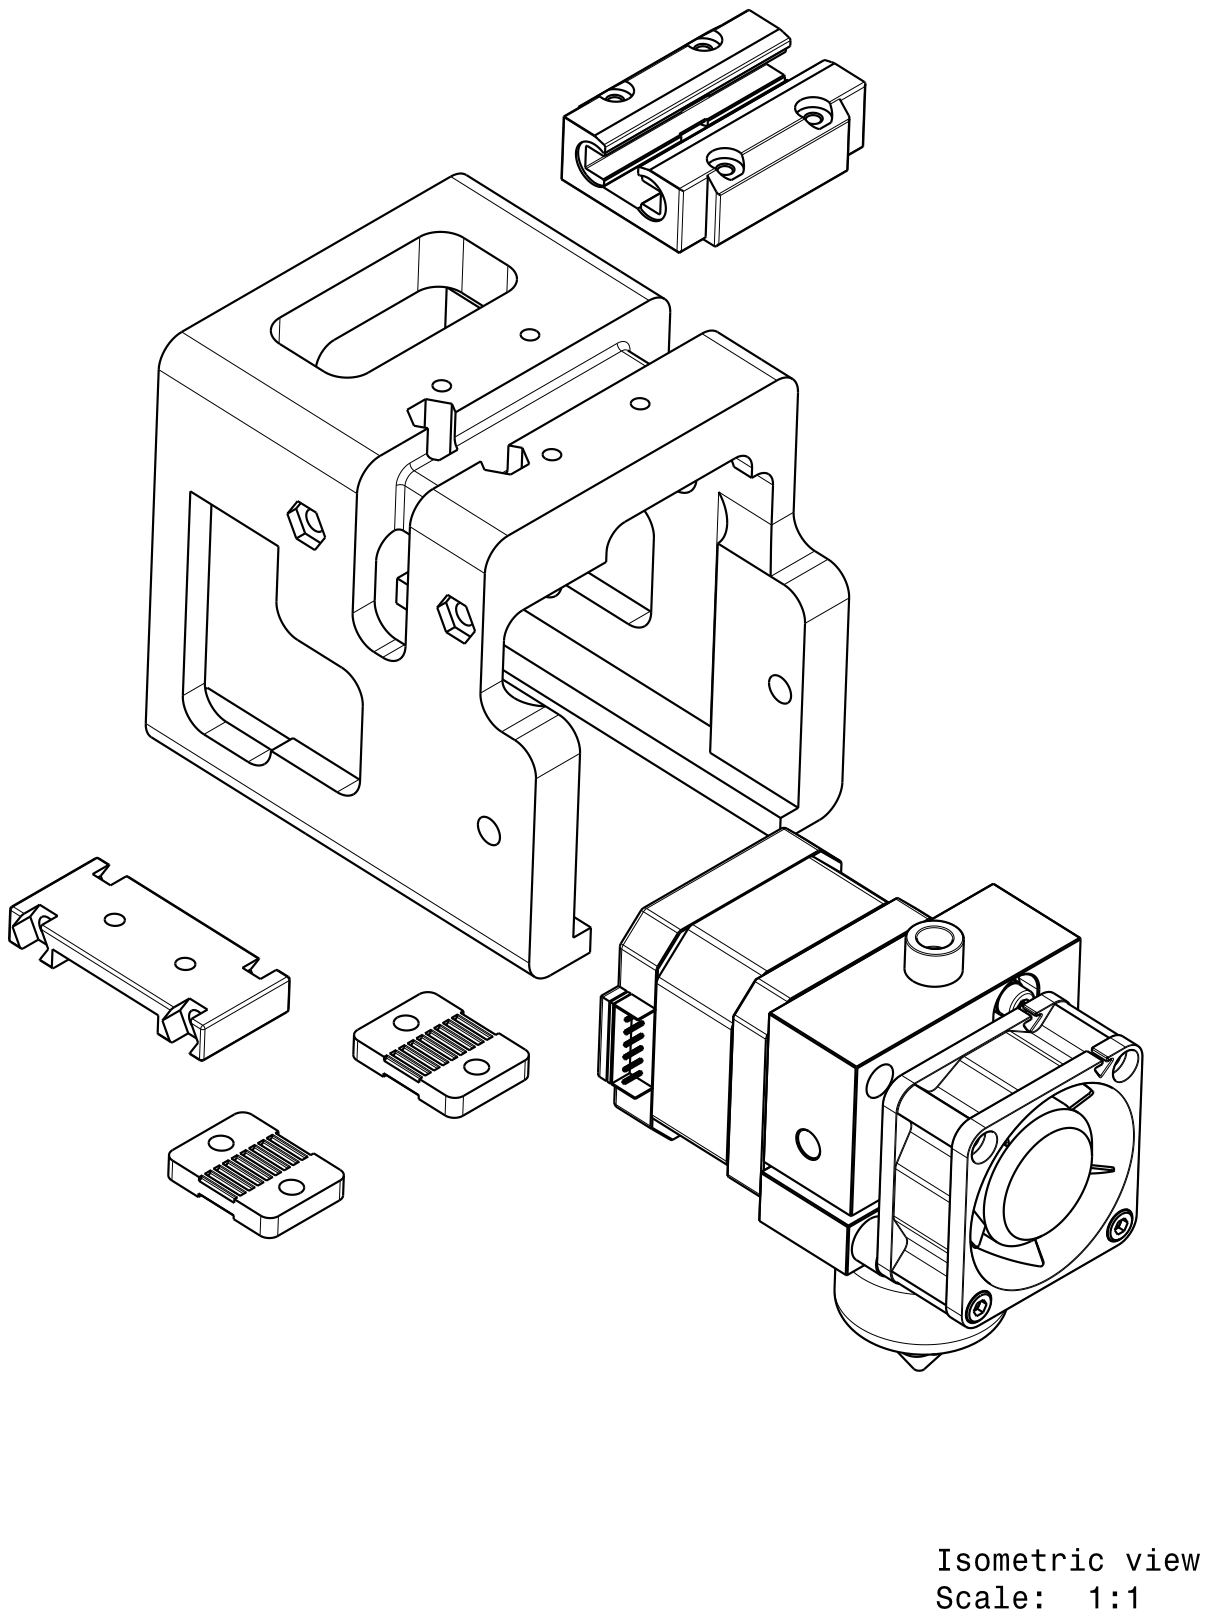
[picture p169: page 1]
