NervenCid/UNAL_FDM/Prototipo_11/Planos Electricos/EjeY.pdf

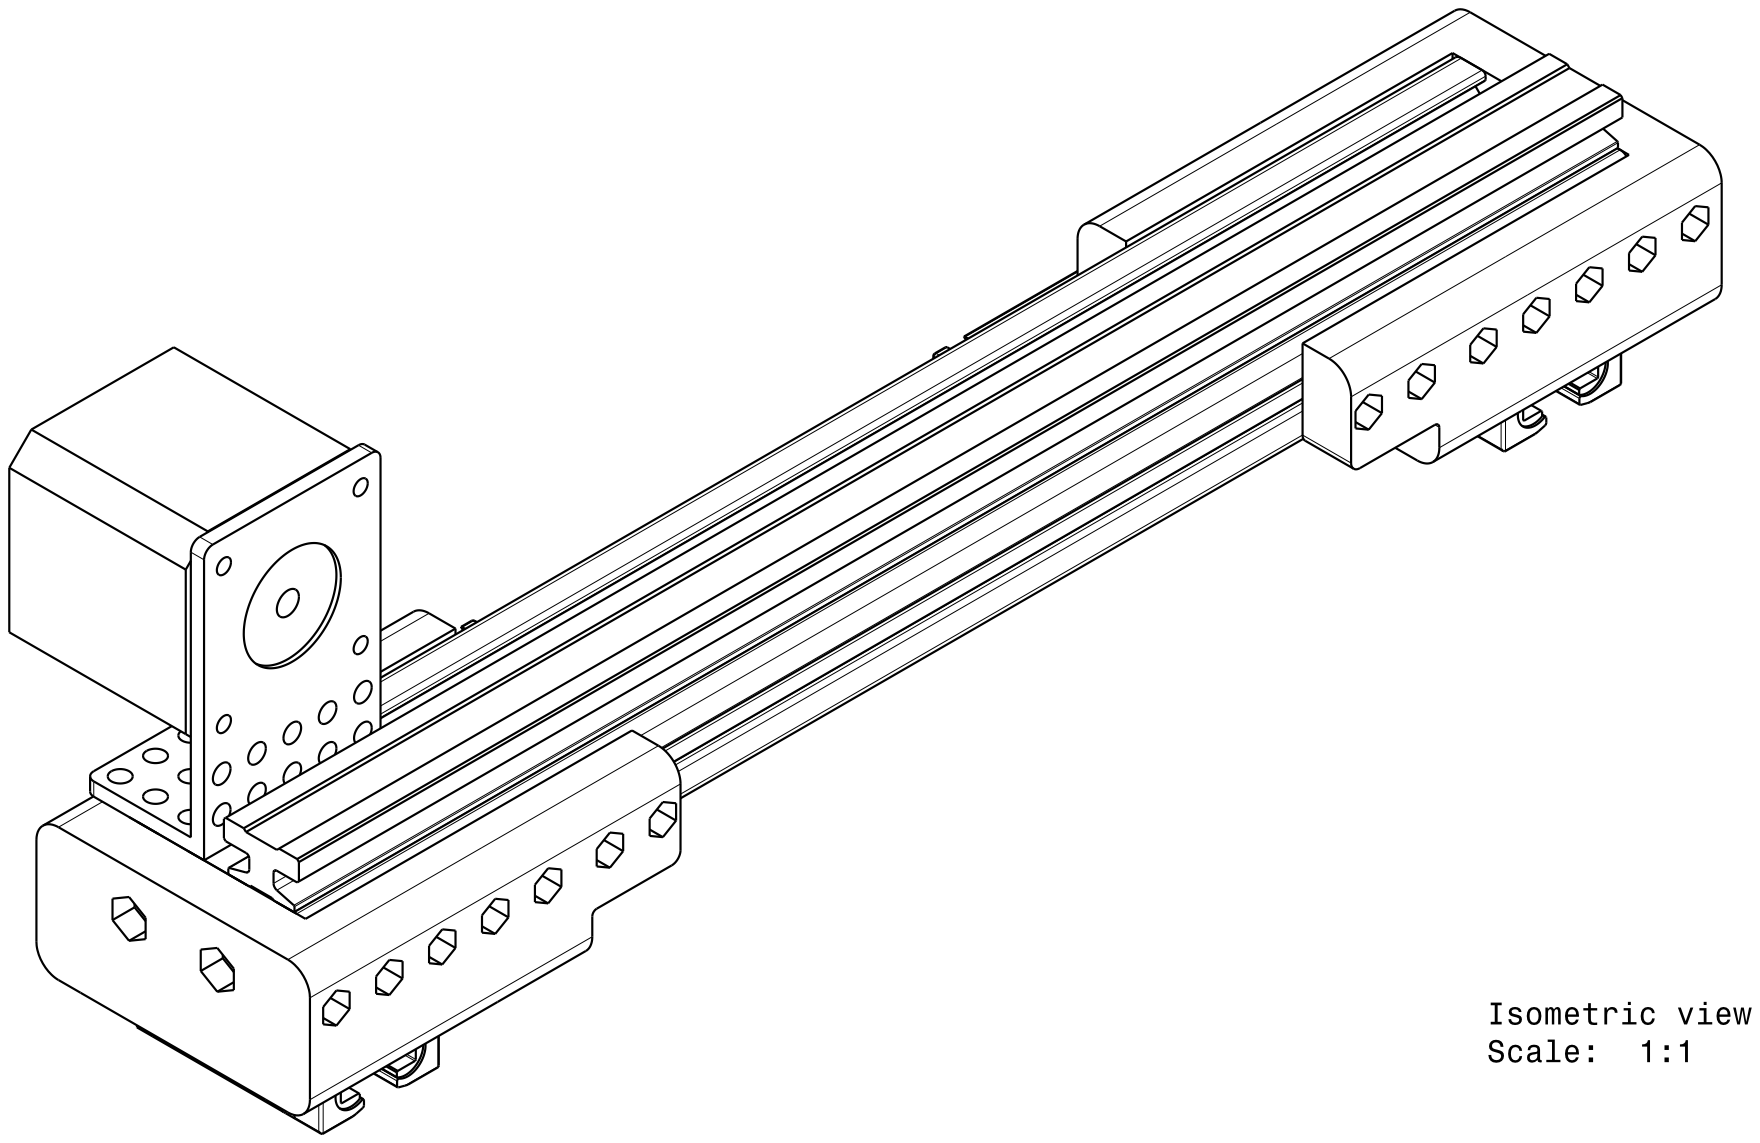
[picture p170: page 1]
