NervenCid/UNAL_FDM/Prototipo_11/Planos Electricos/Gabinete.pdf

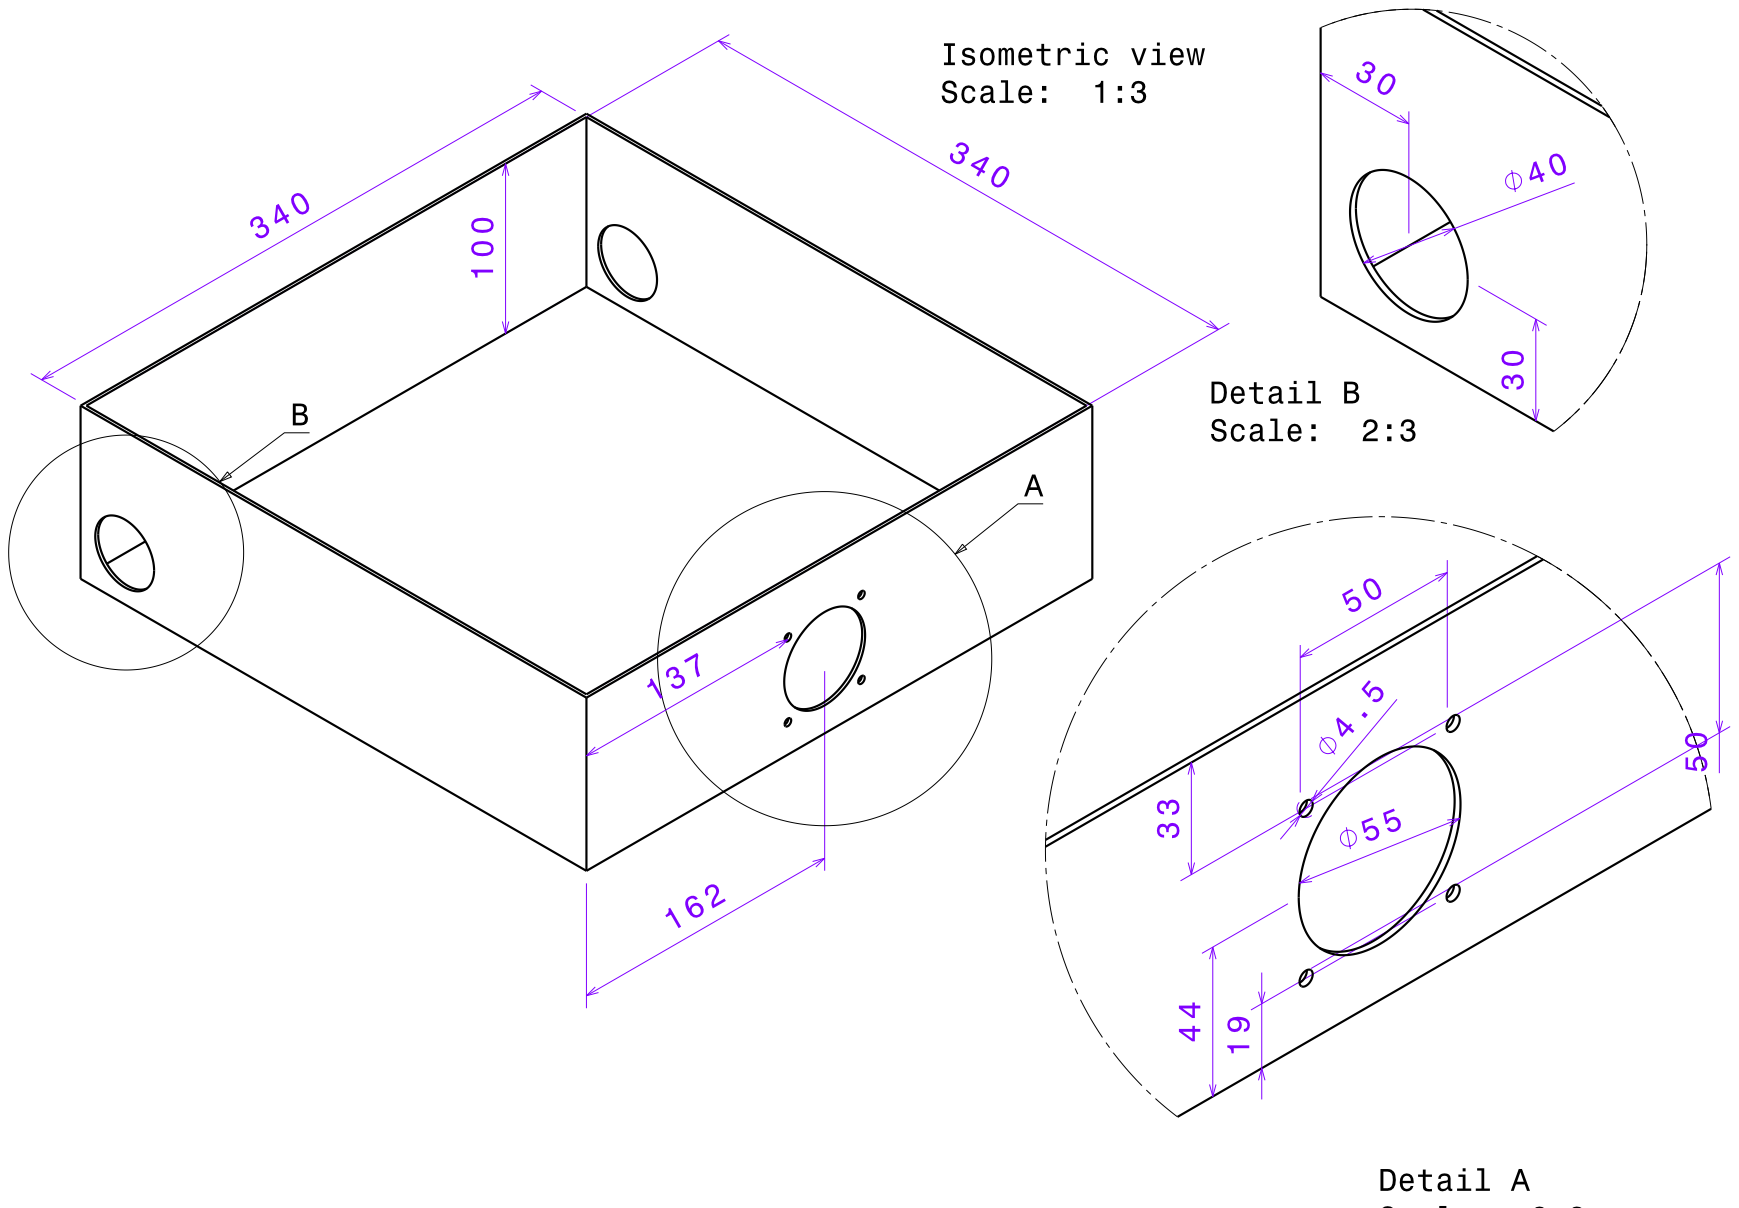
[picture p171: page 1]
