NervenCid/UNAL_FDM/Prototipo_11/Planos Electricos/Plano.pdf

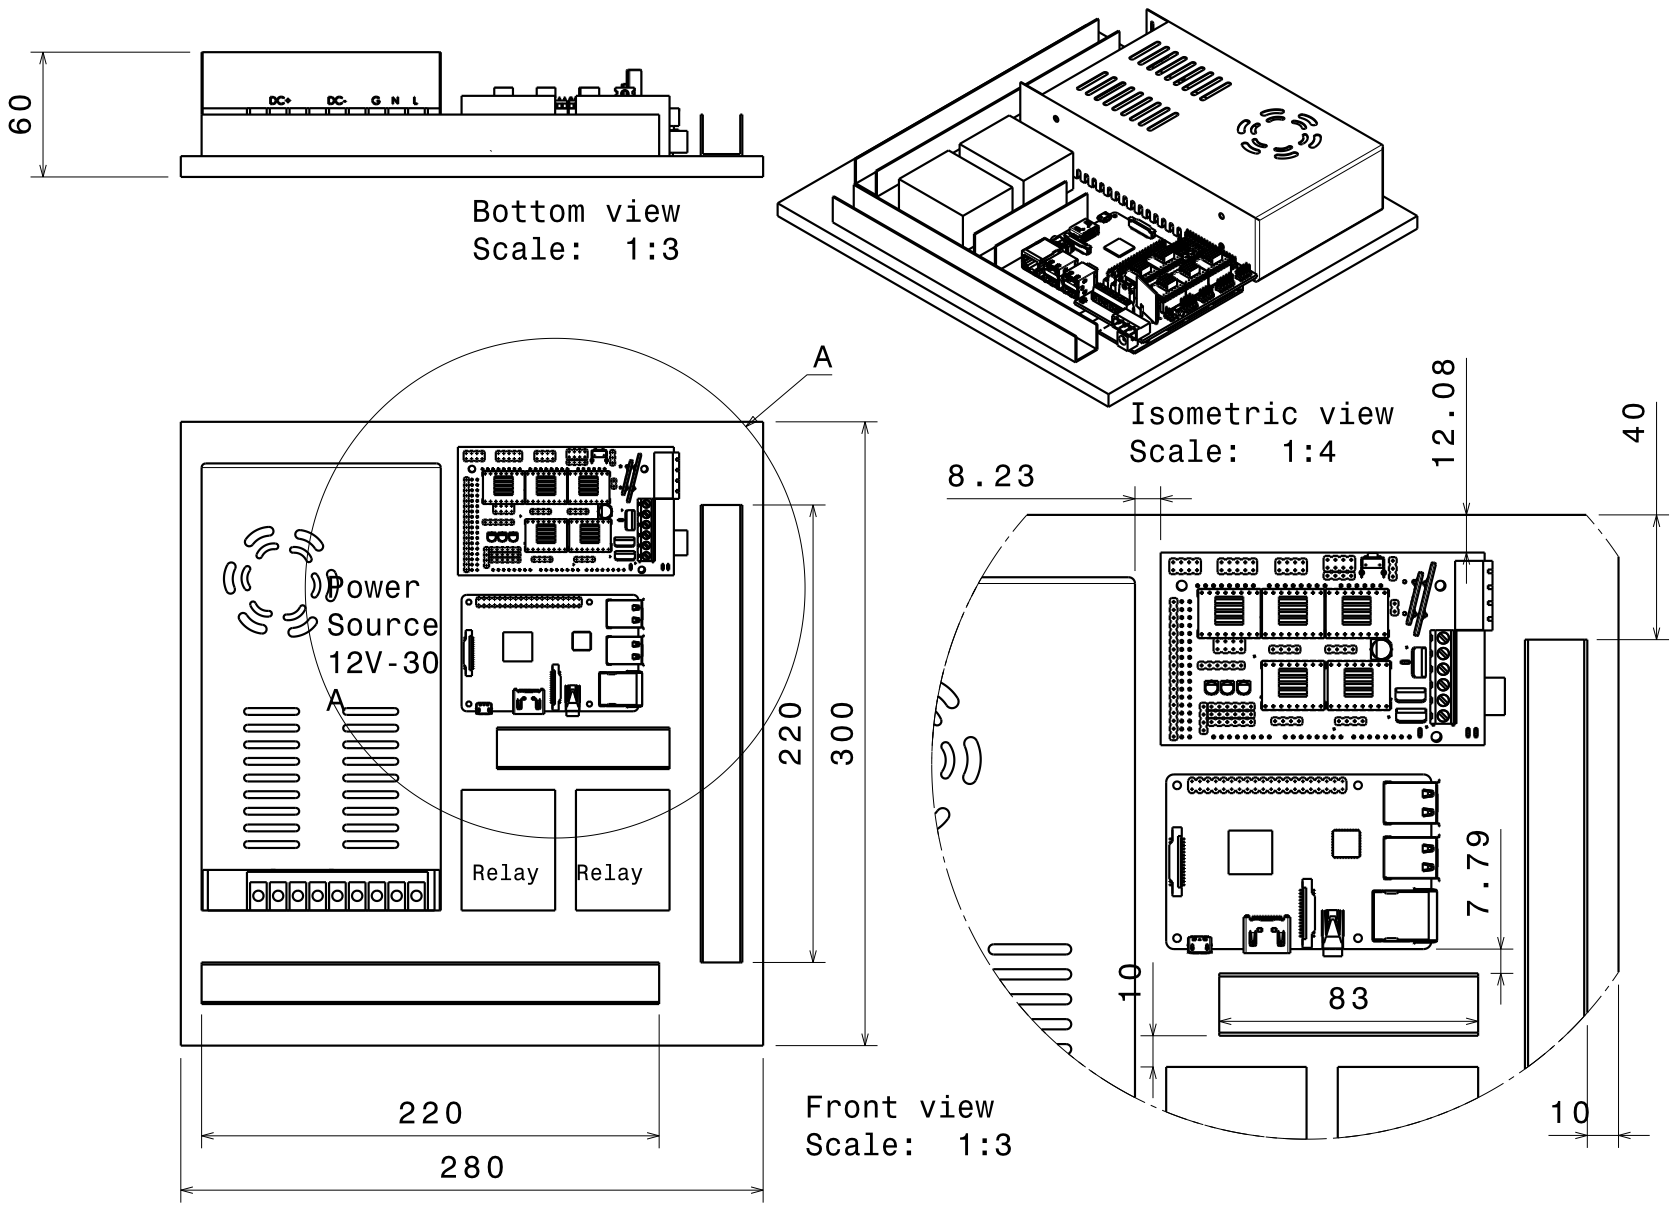
[picture p172: page 1]
