NervenCid/UNAL_FDM/Prototipo_11/Planos Electricos/RAMPS14TOP.pdf

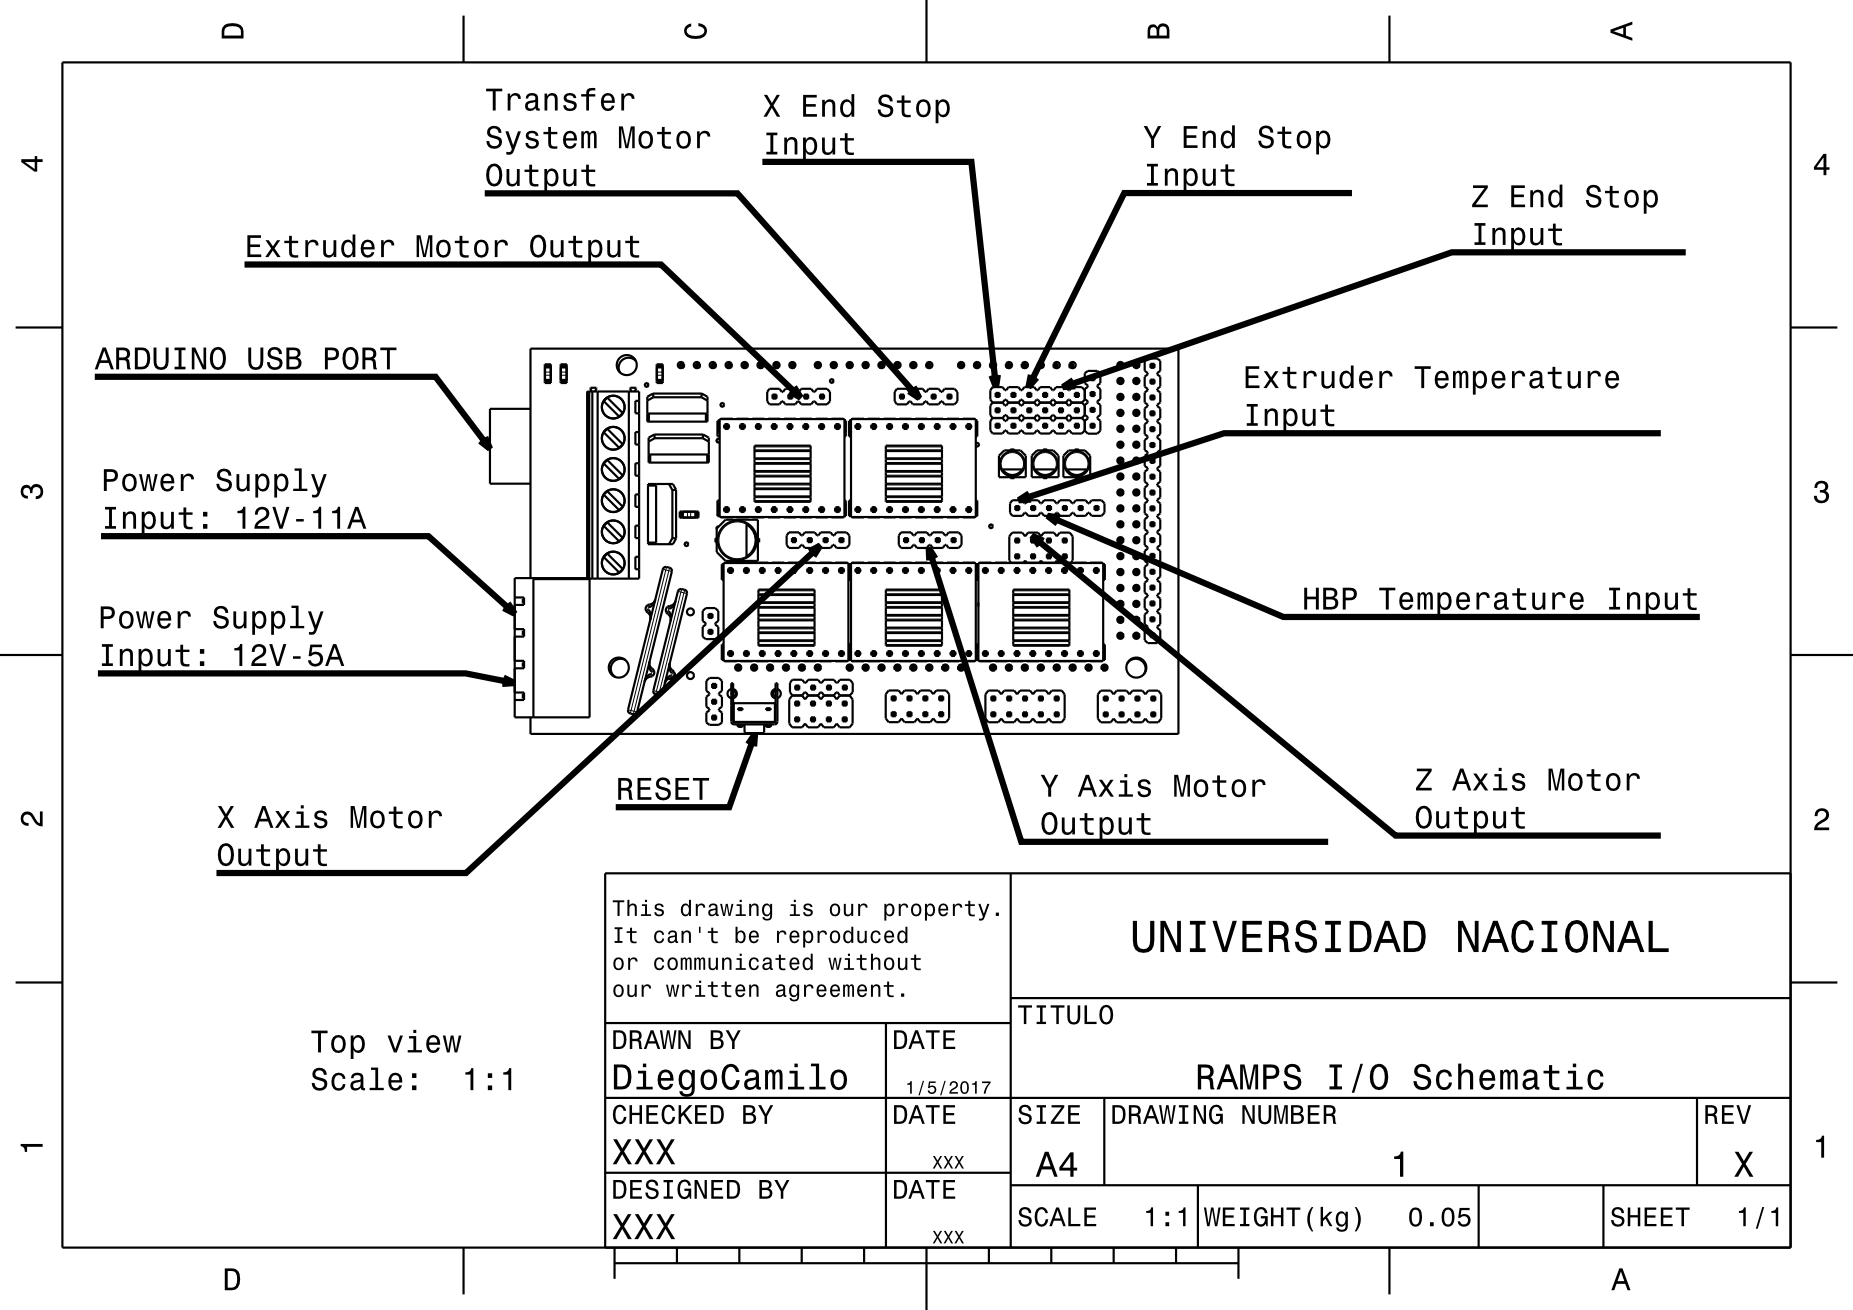
[picture p173: page 1]
