NervenCid/UNAL_FDM/Prototipo_11/Planos Electricos/RAMPSExploded.pdf

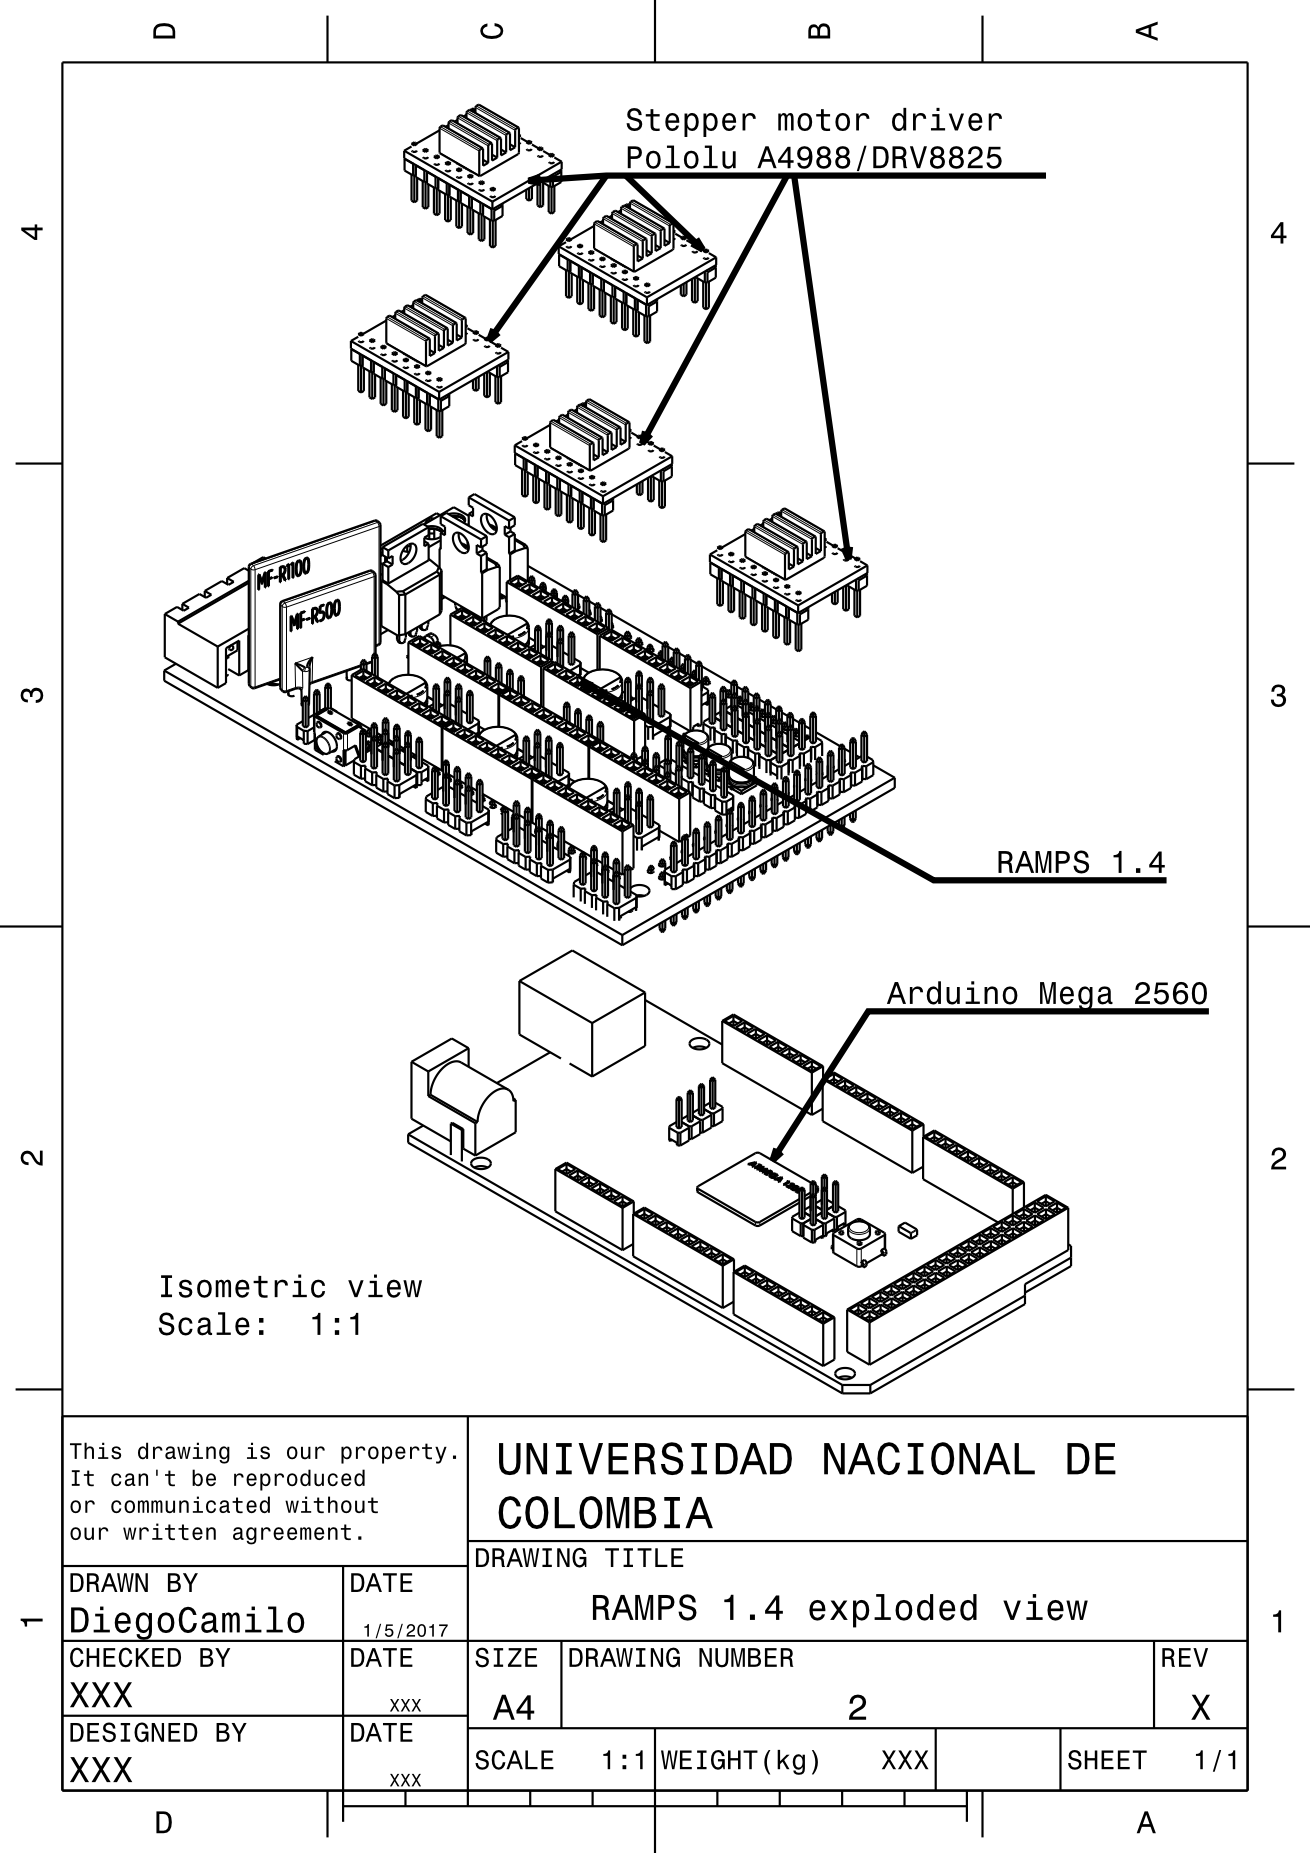
[picture p174: page 1]
