NervenCid/UNAL_FDM/Prototipo_11/Planos Electricos/RAMPSFULL.pdf

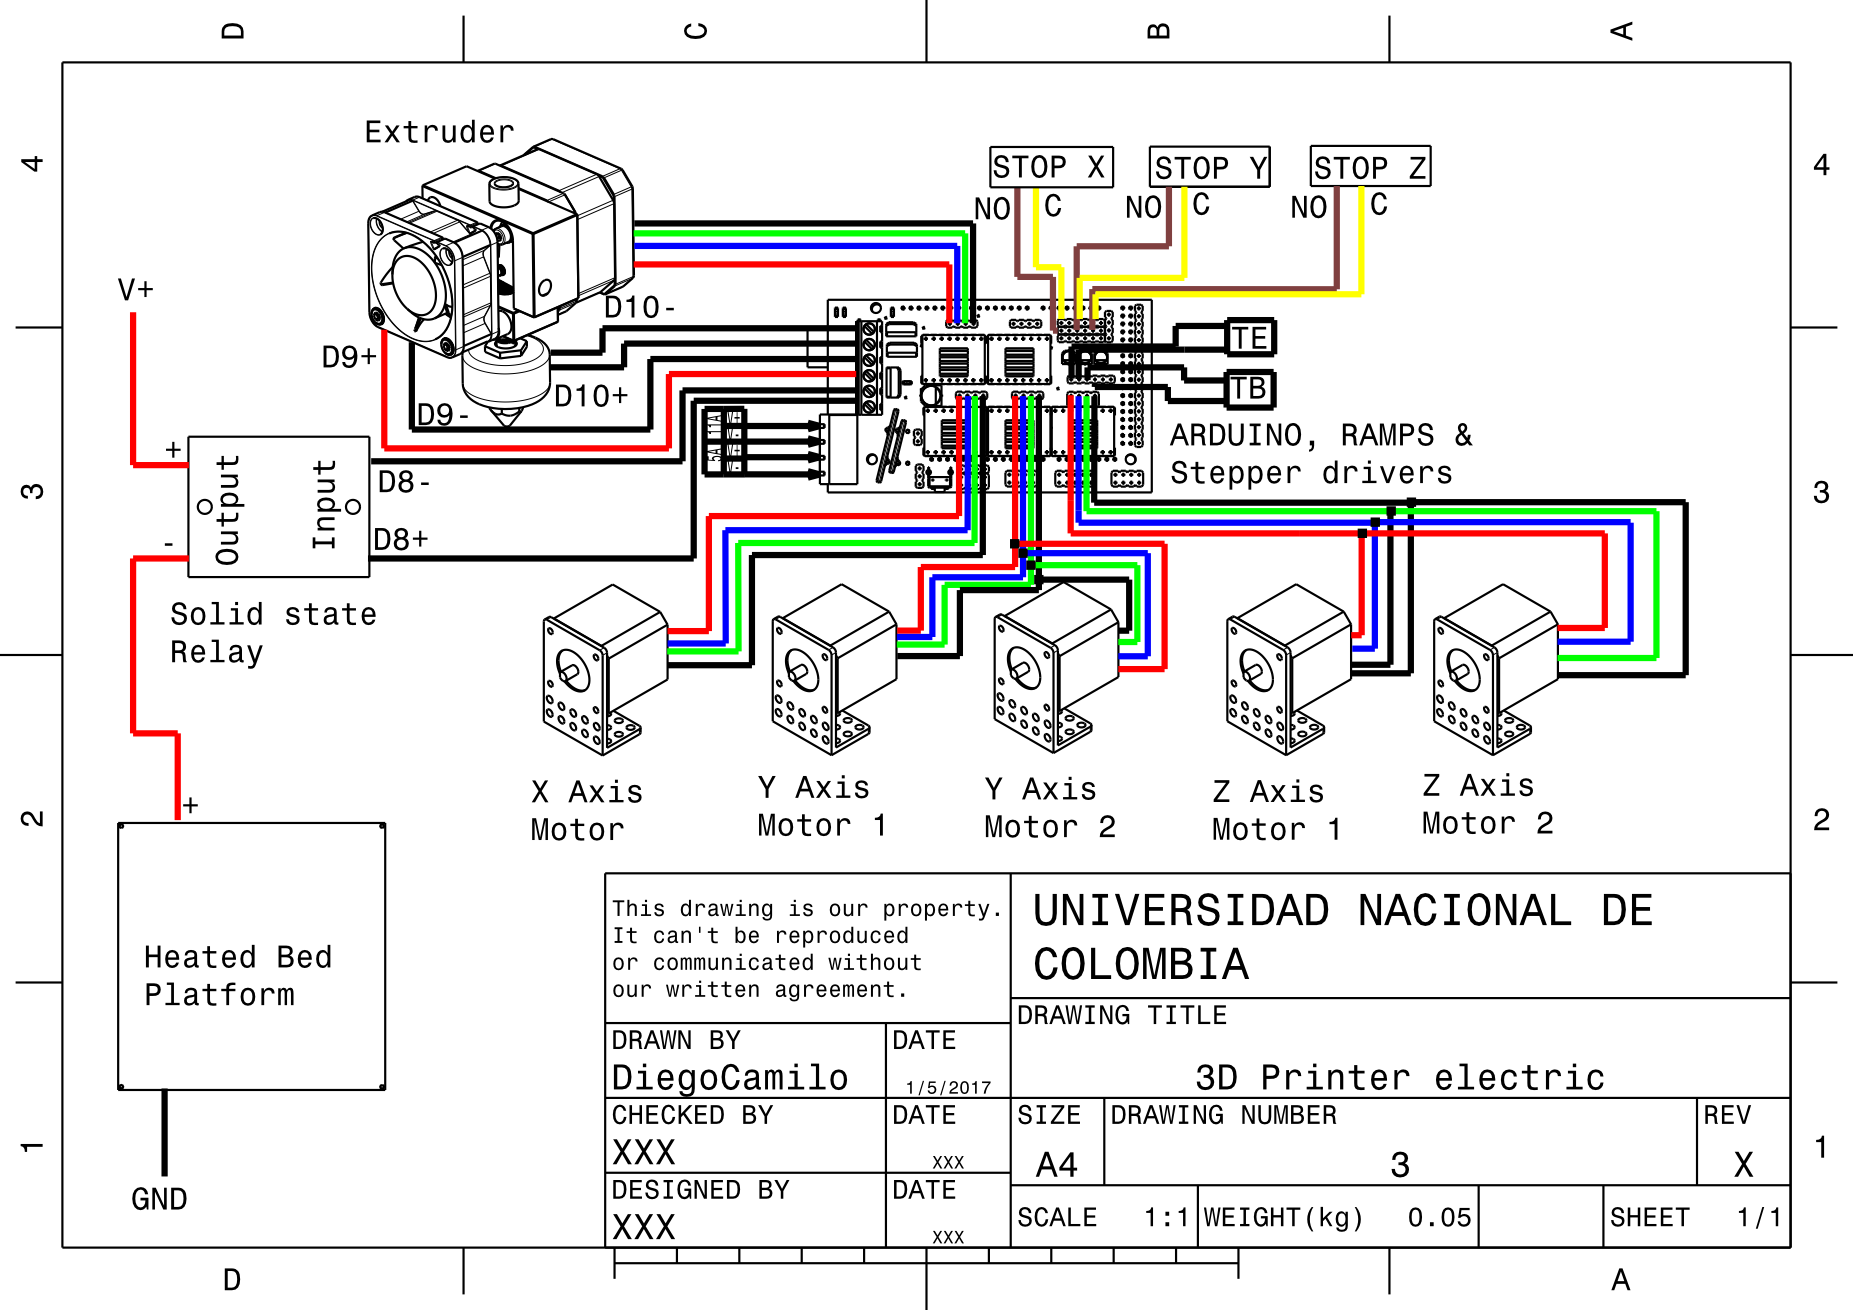
[picture p175: page 1]
