NervenCid/UNAL_FDM/Prototipo_11/Planos Electricos/RaspBerry.pdf

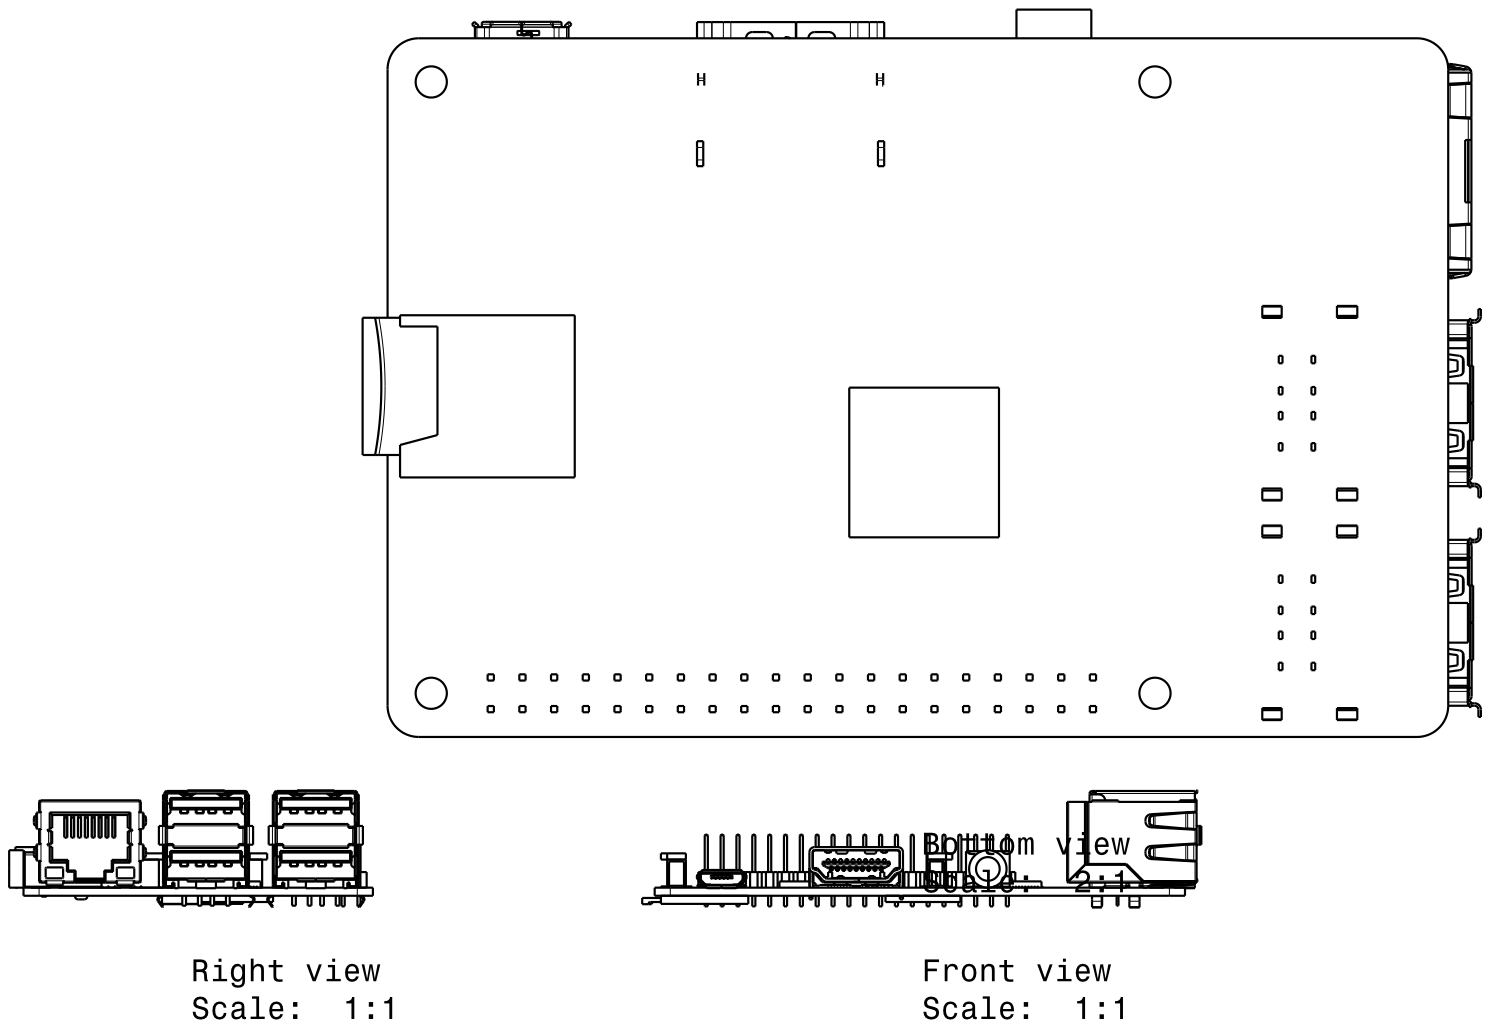
[picture p176: page 1]
