NervenCid/UNAL_FDM/Prototipo_11/Planos Electricos/RaspBerryArdu.pdf

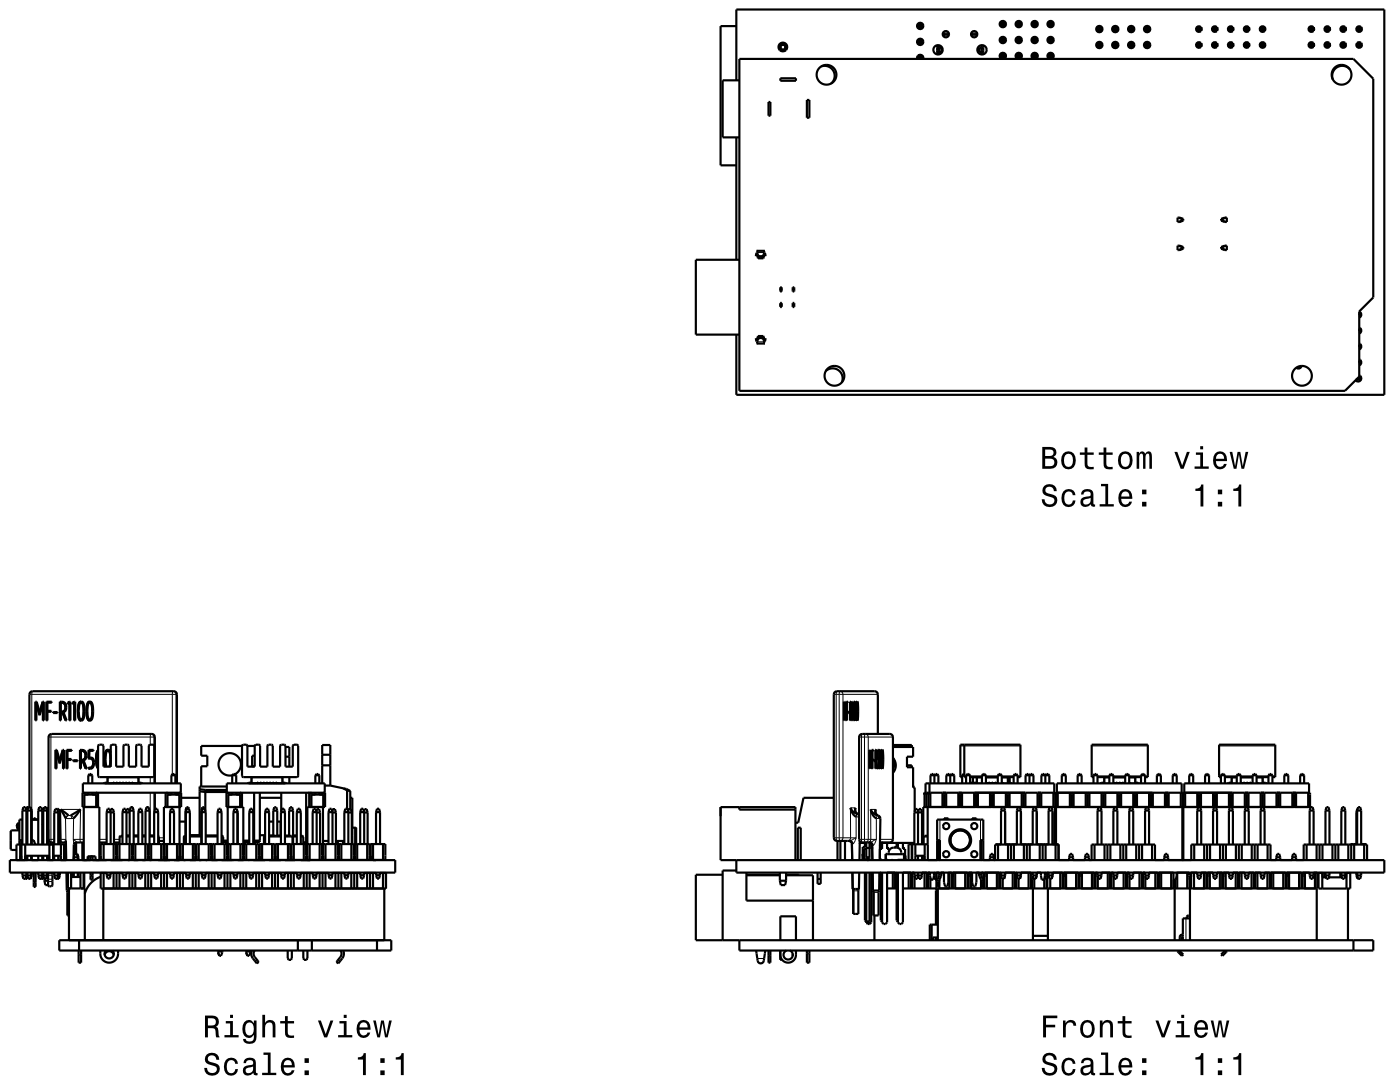
[picture p177: page 1]
