NervenCid/UNAL_FDM/Prototipo_11/Planos Electricos/SoporteGiratorio1.pdf

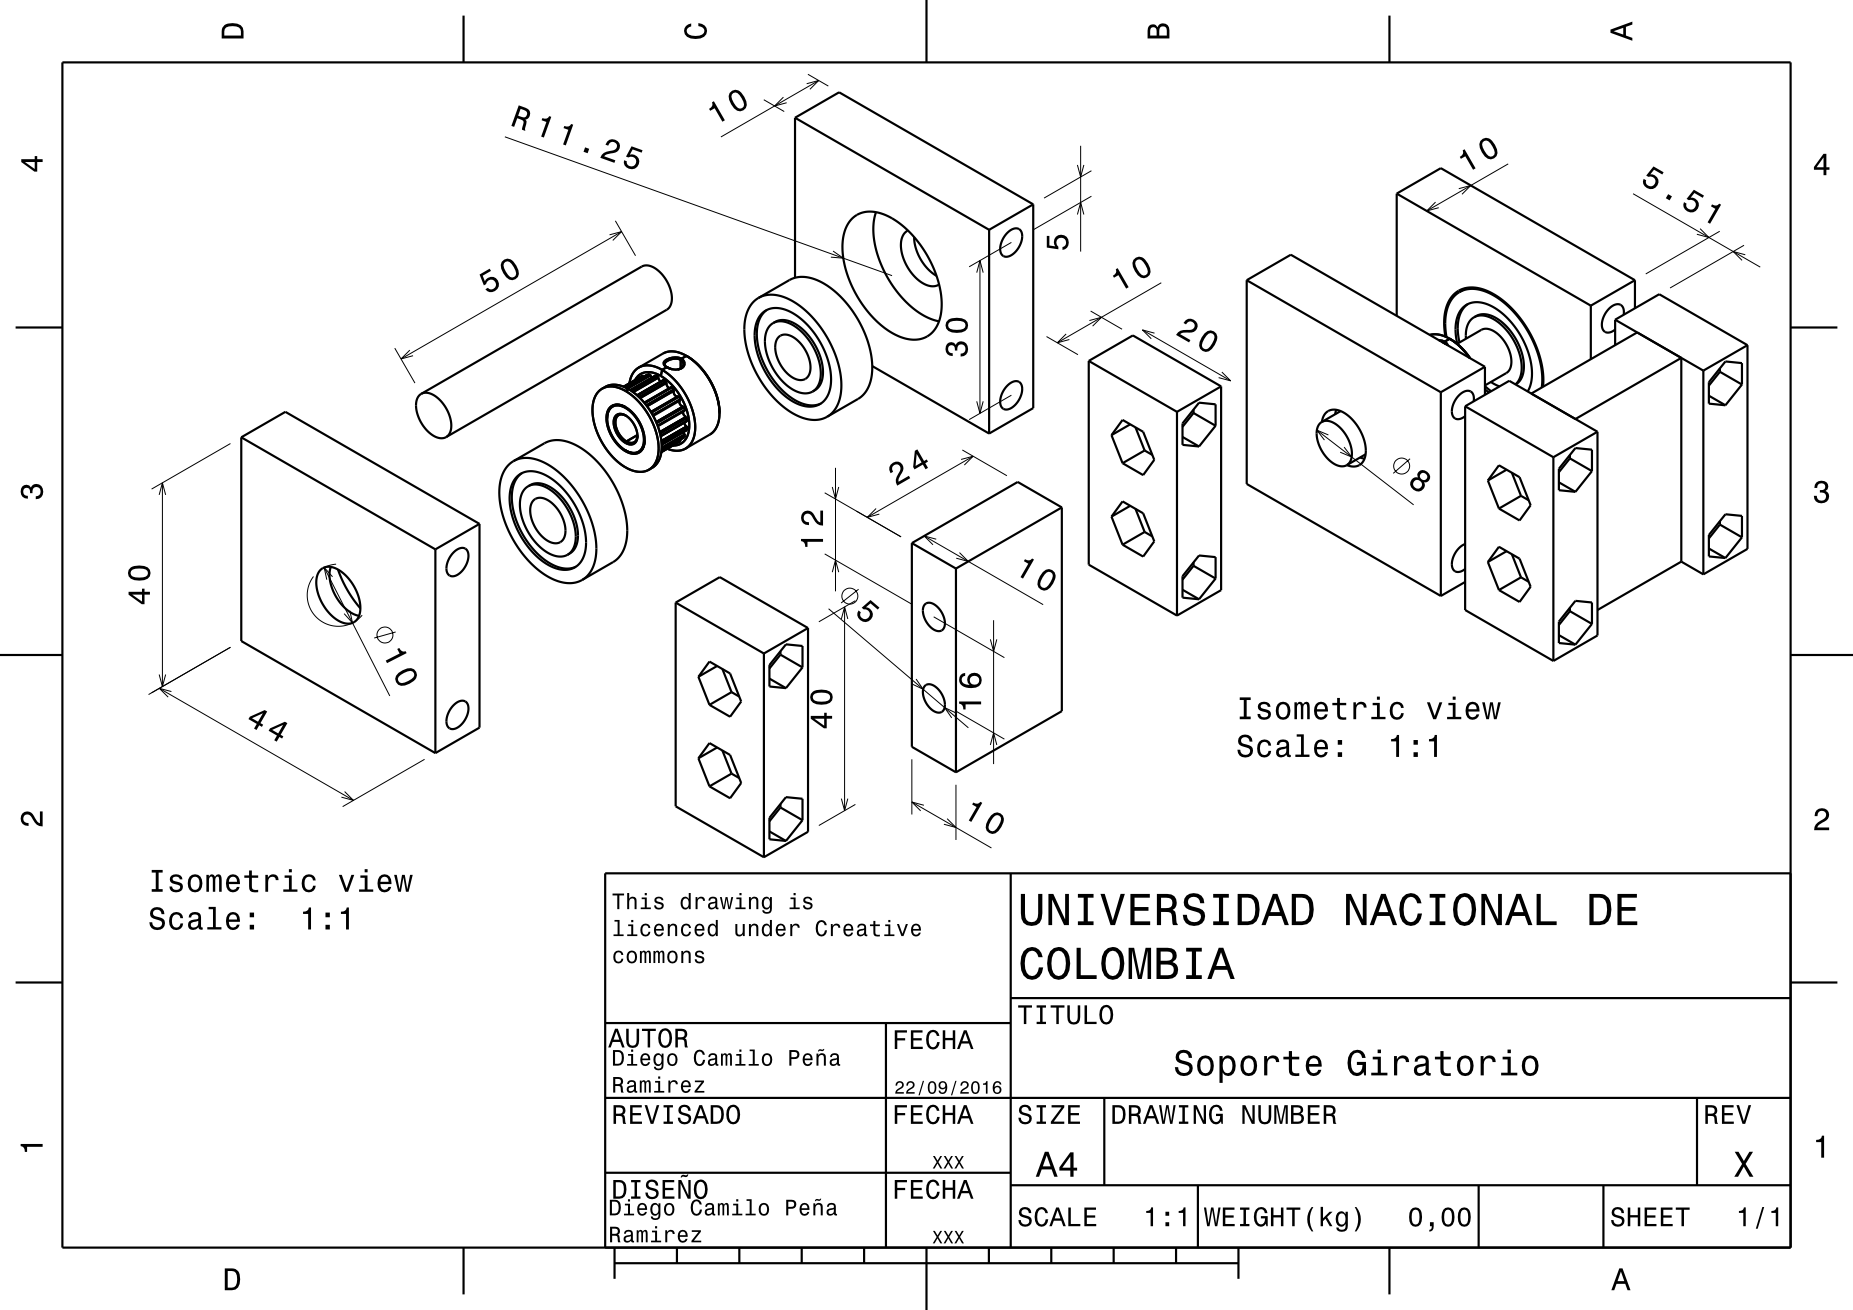
[picture p178: page 1]
