NervenCid/UNAL_FDM/Prototipo_11/Planos Electricos/Tapa_Gabinete.pdf

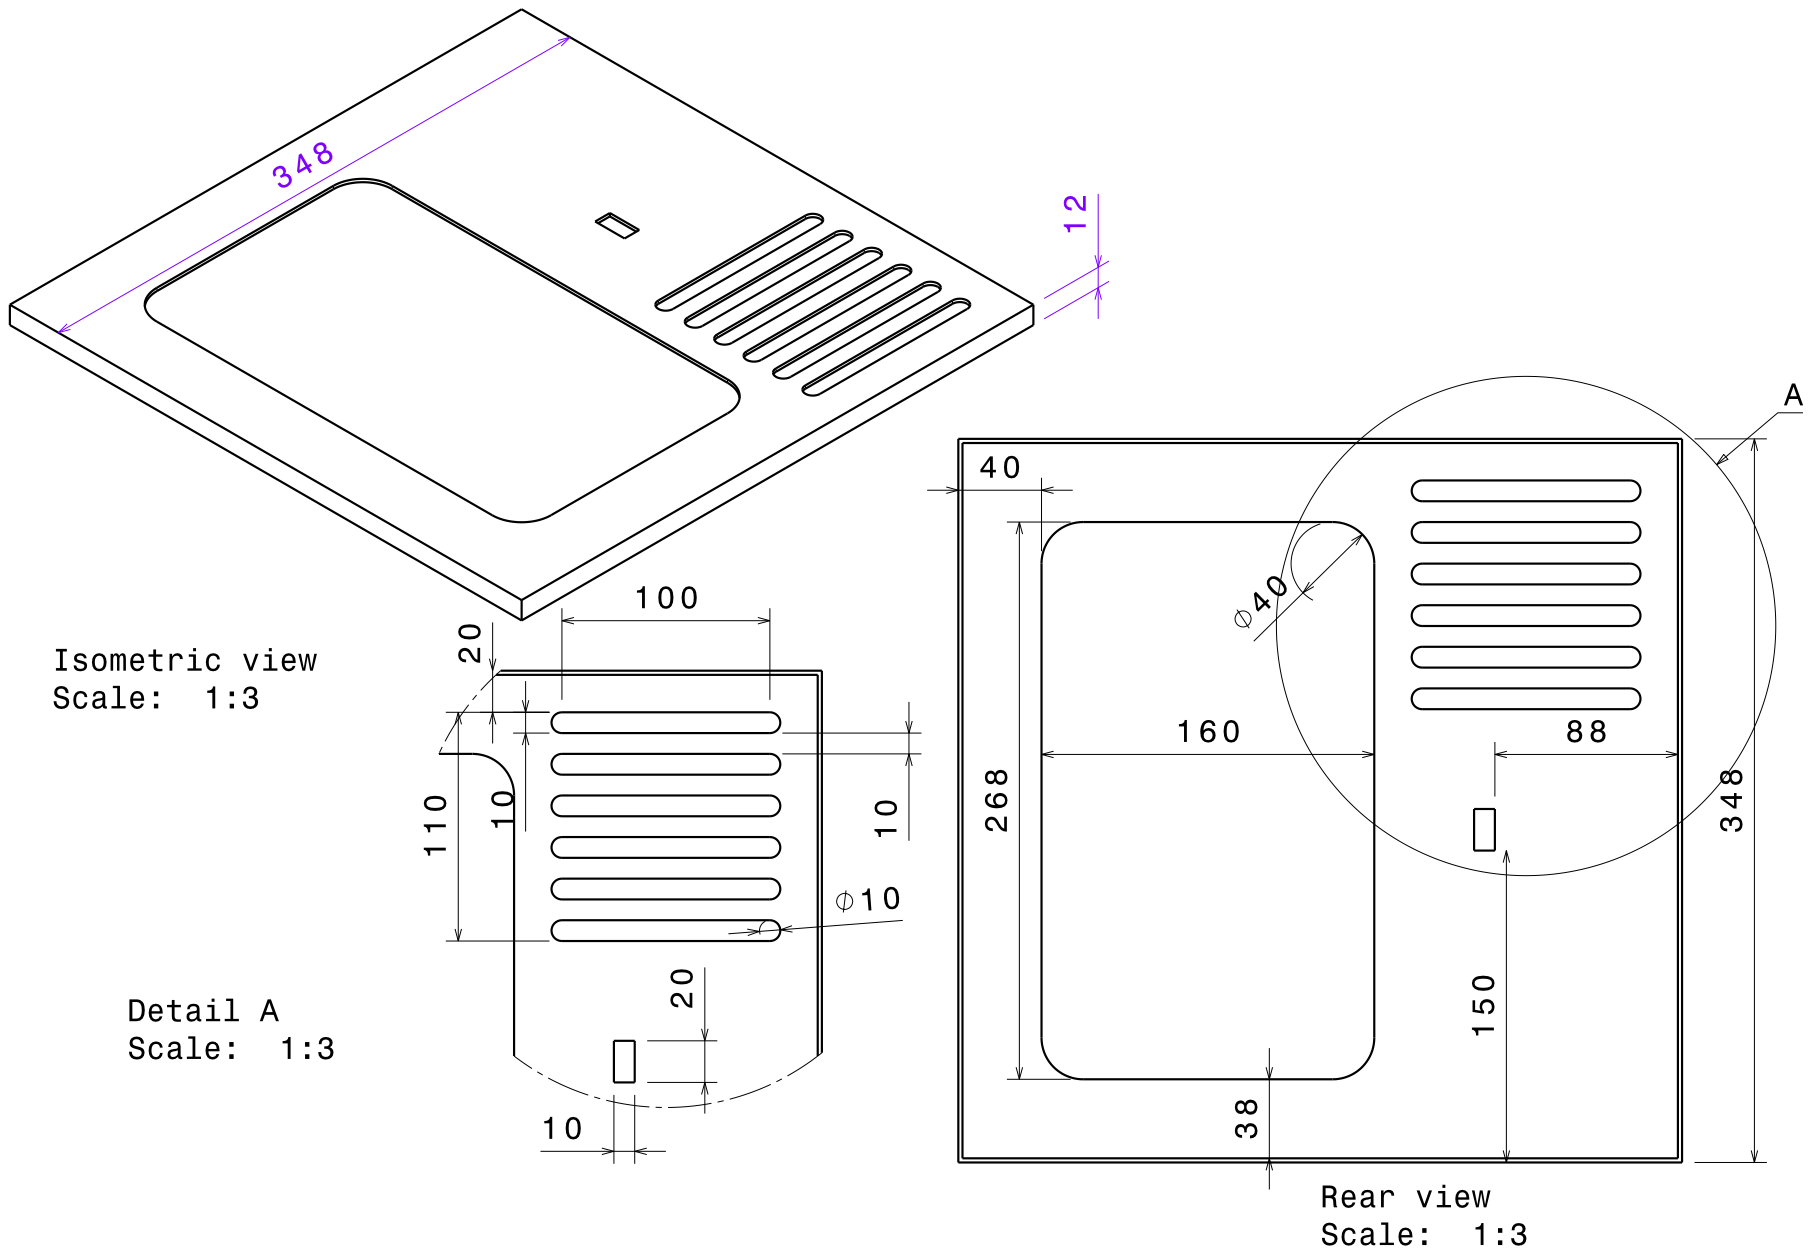
[picture p179: page 1]
