NervenCid/UNAL_FDM/Prototipo_11/Planos/AcopleEstEjeY.pdf

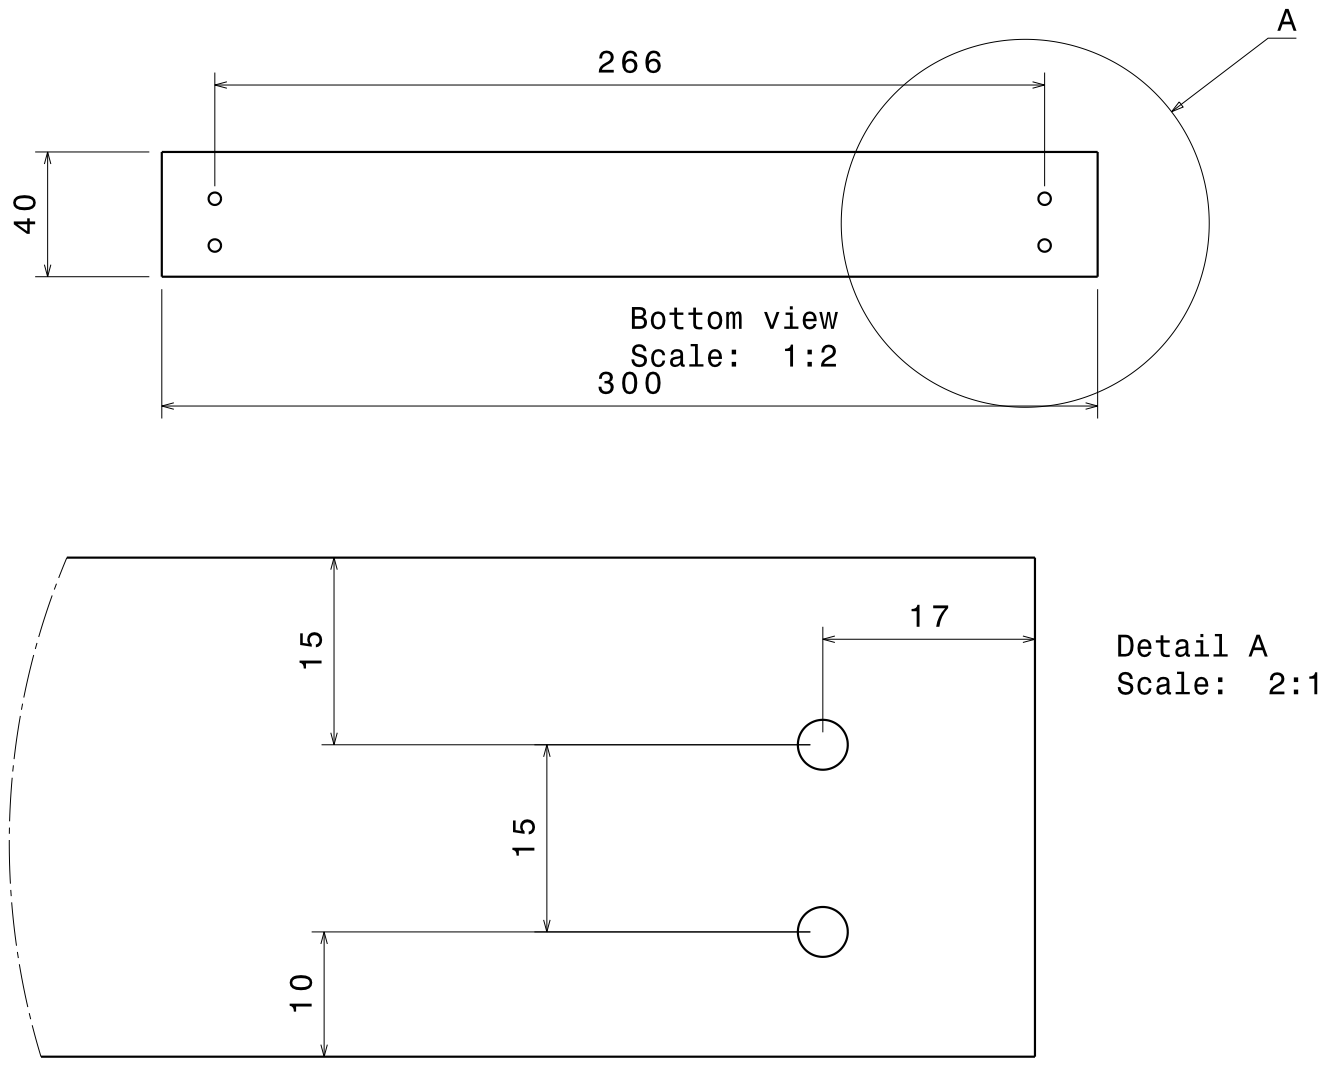
[picture p180: page 1]
