NervenCid/UNAL_FDM/Prototipo_11/Planos/BaseMovil.pdf

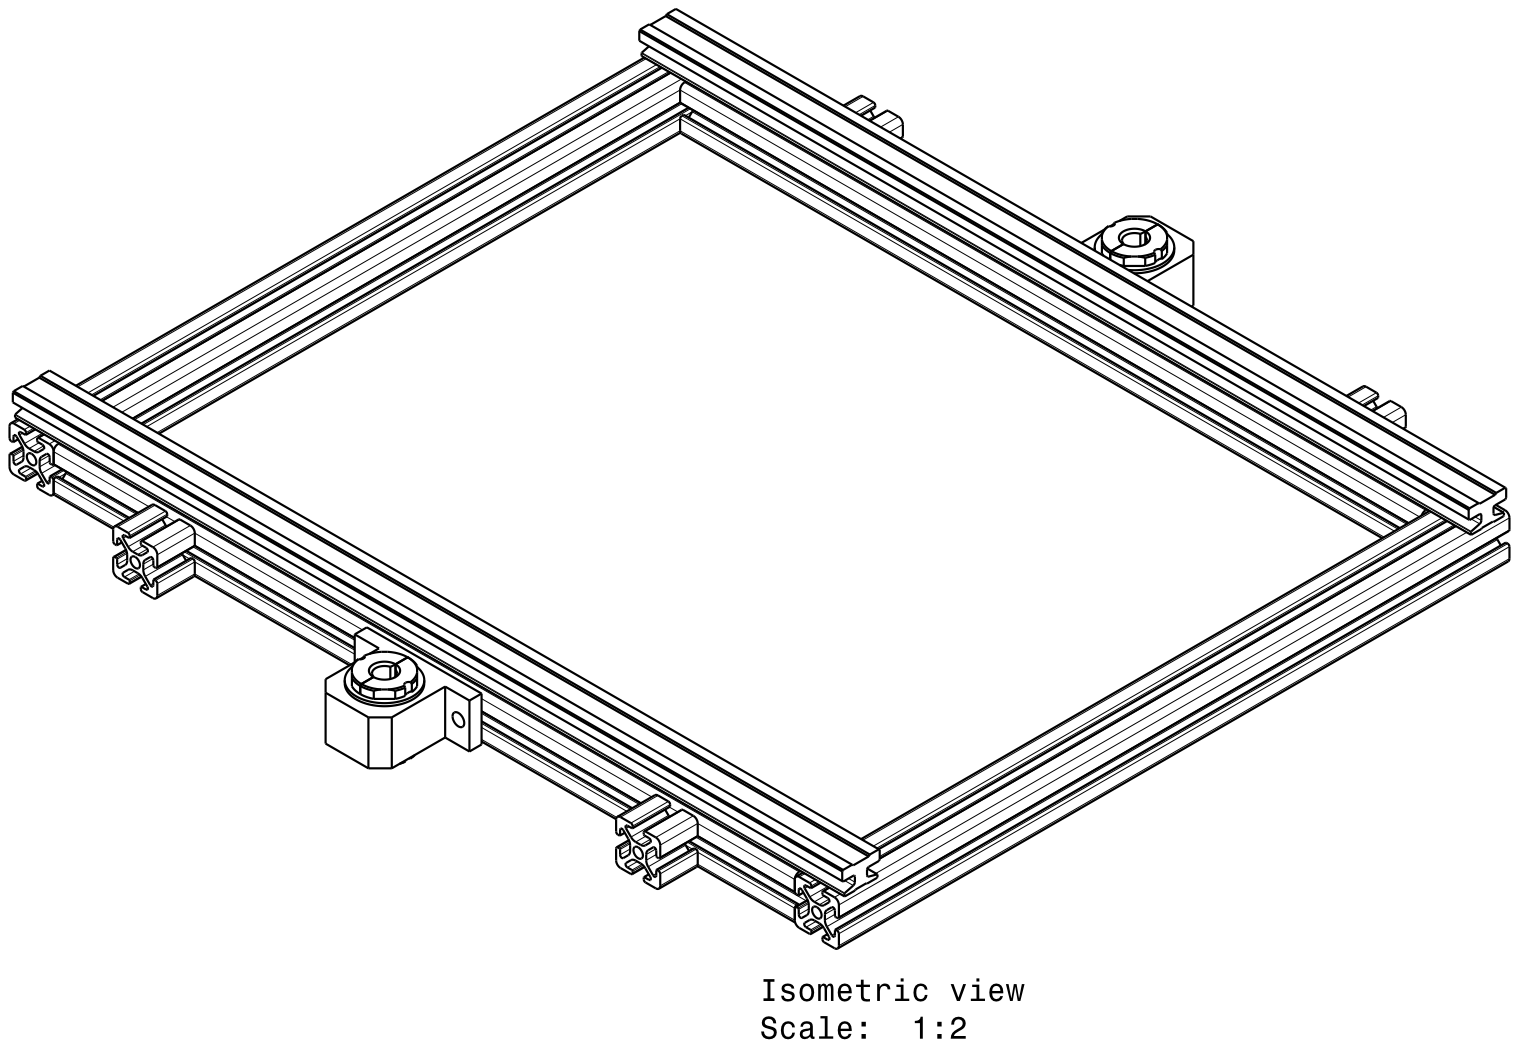
[picture p181: page 1]
