NervenCid/UNAL_FDM/Prototipo_11/Planos/BaseMovilEns.pdf

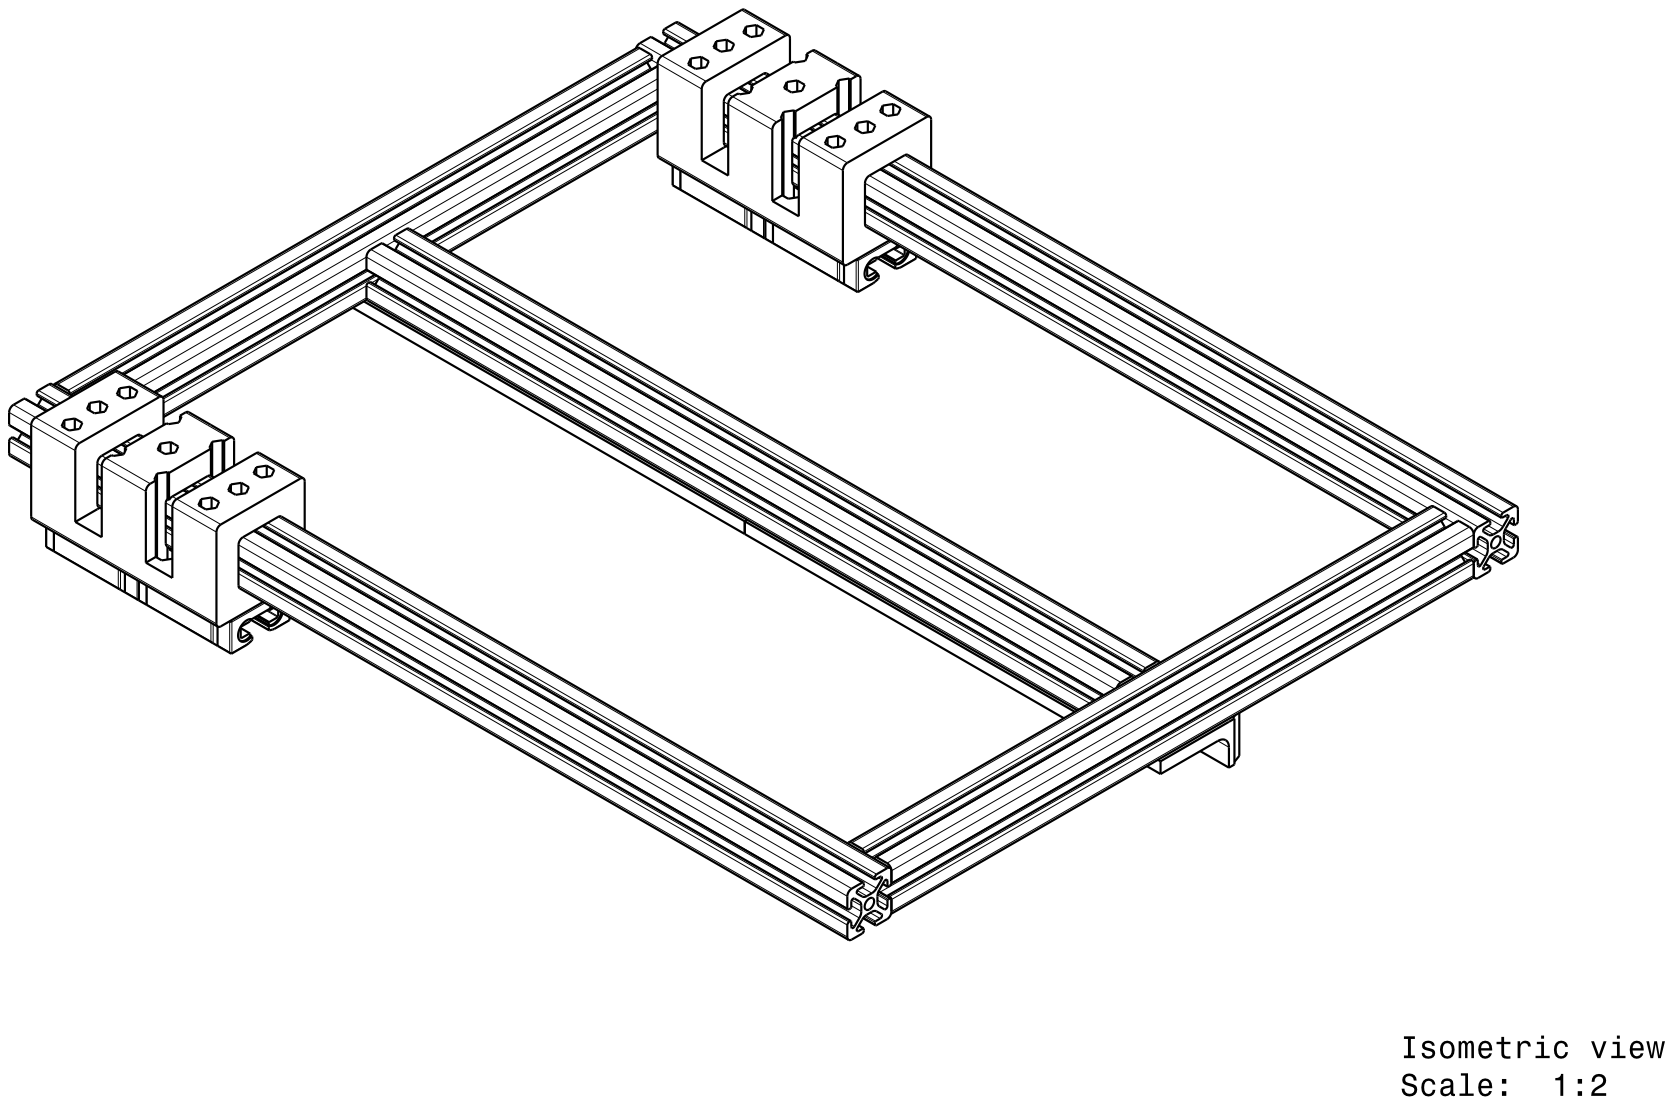
[picture p182: page 1]
