NervenCid/UNAL_FDM/Prototipo_11/Planos/BaseMovilExplo.pdf

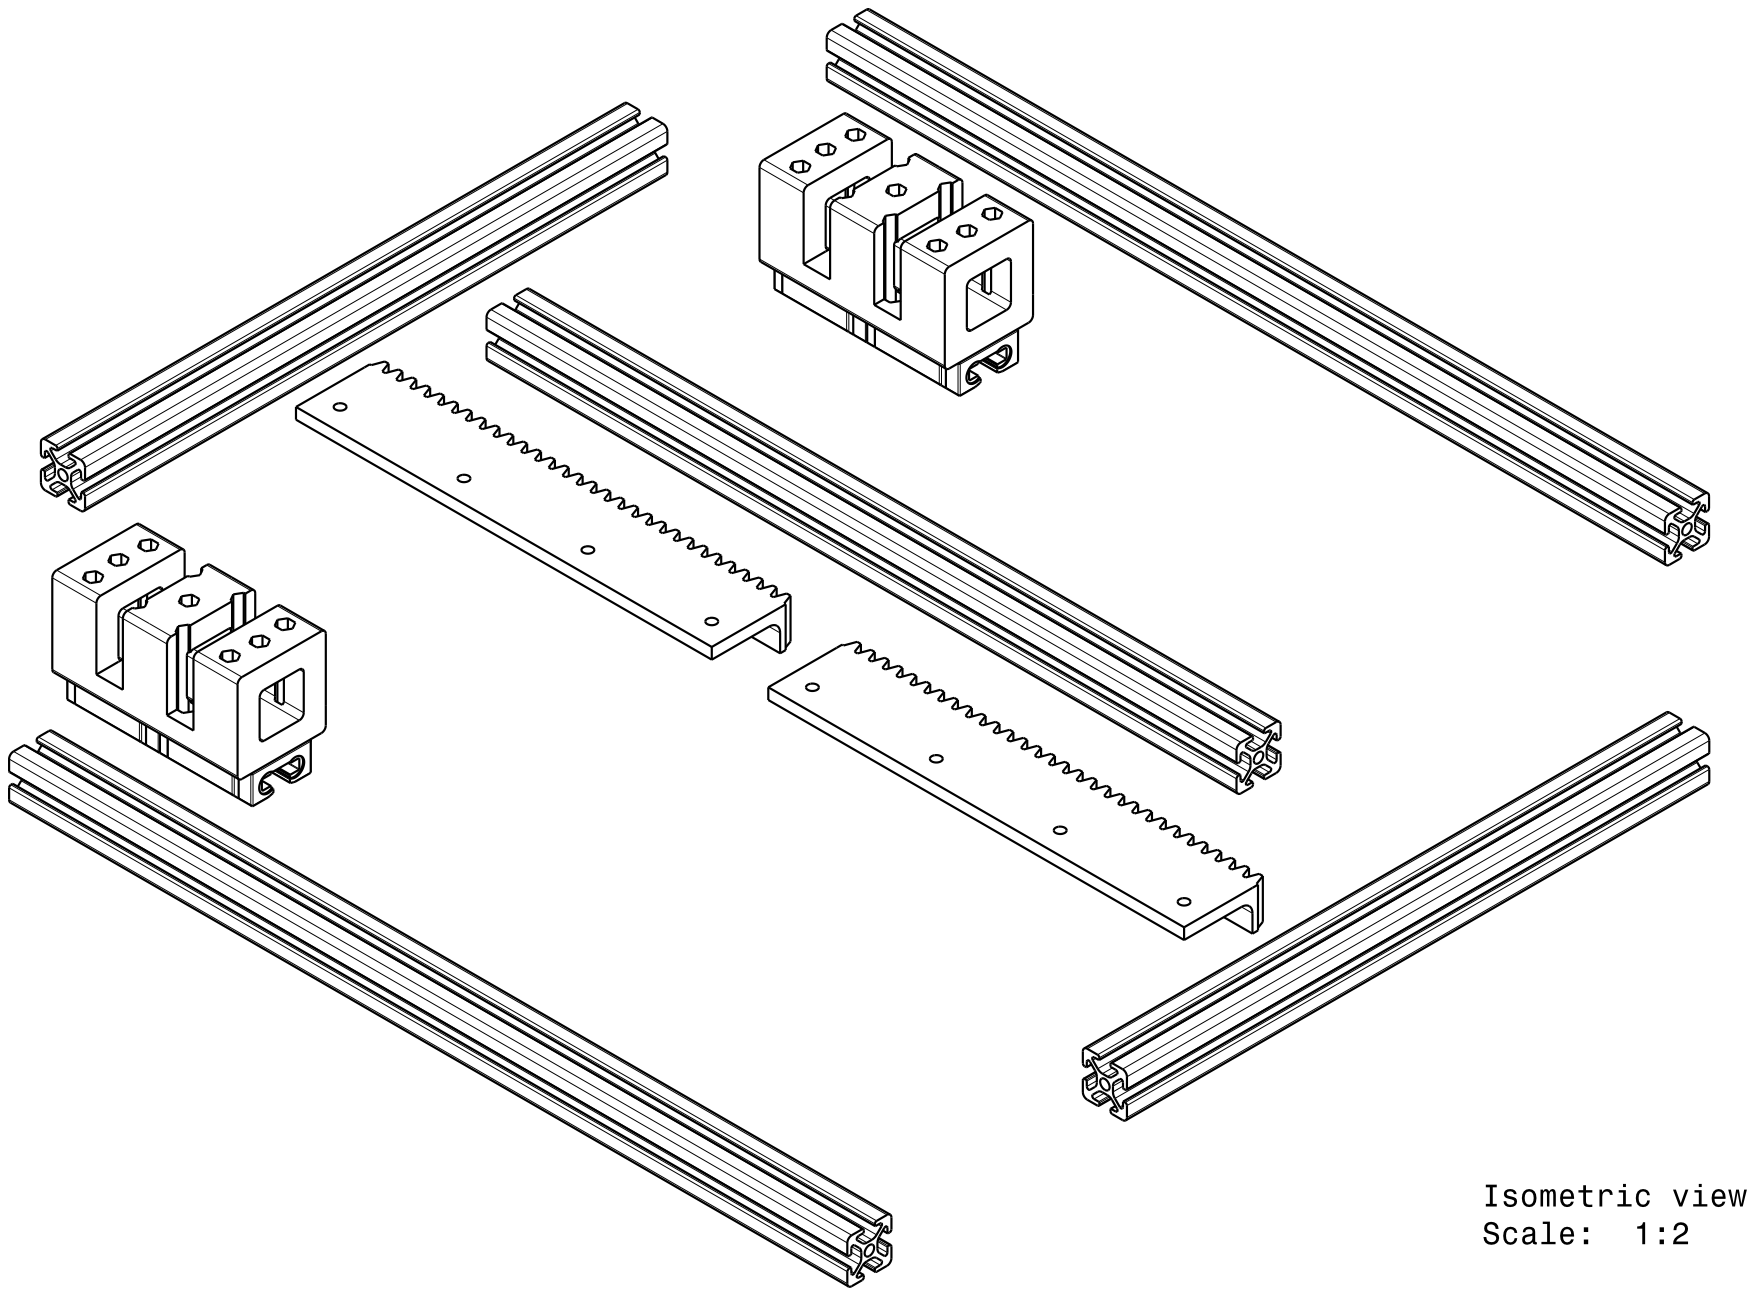
[picture p183: page 1]
