NervenCid/UNAL_FDM/Prototipo_11/Planos/BaseMovP1.pdf

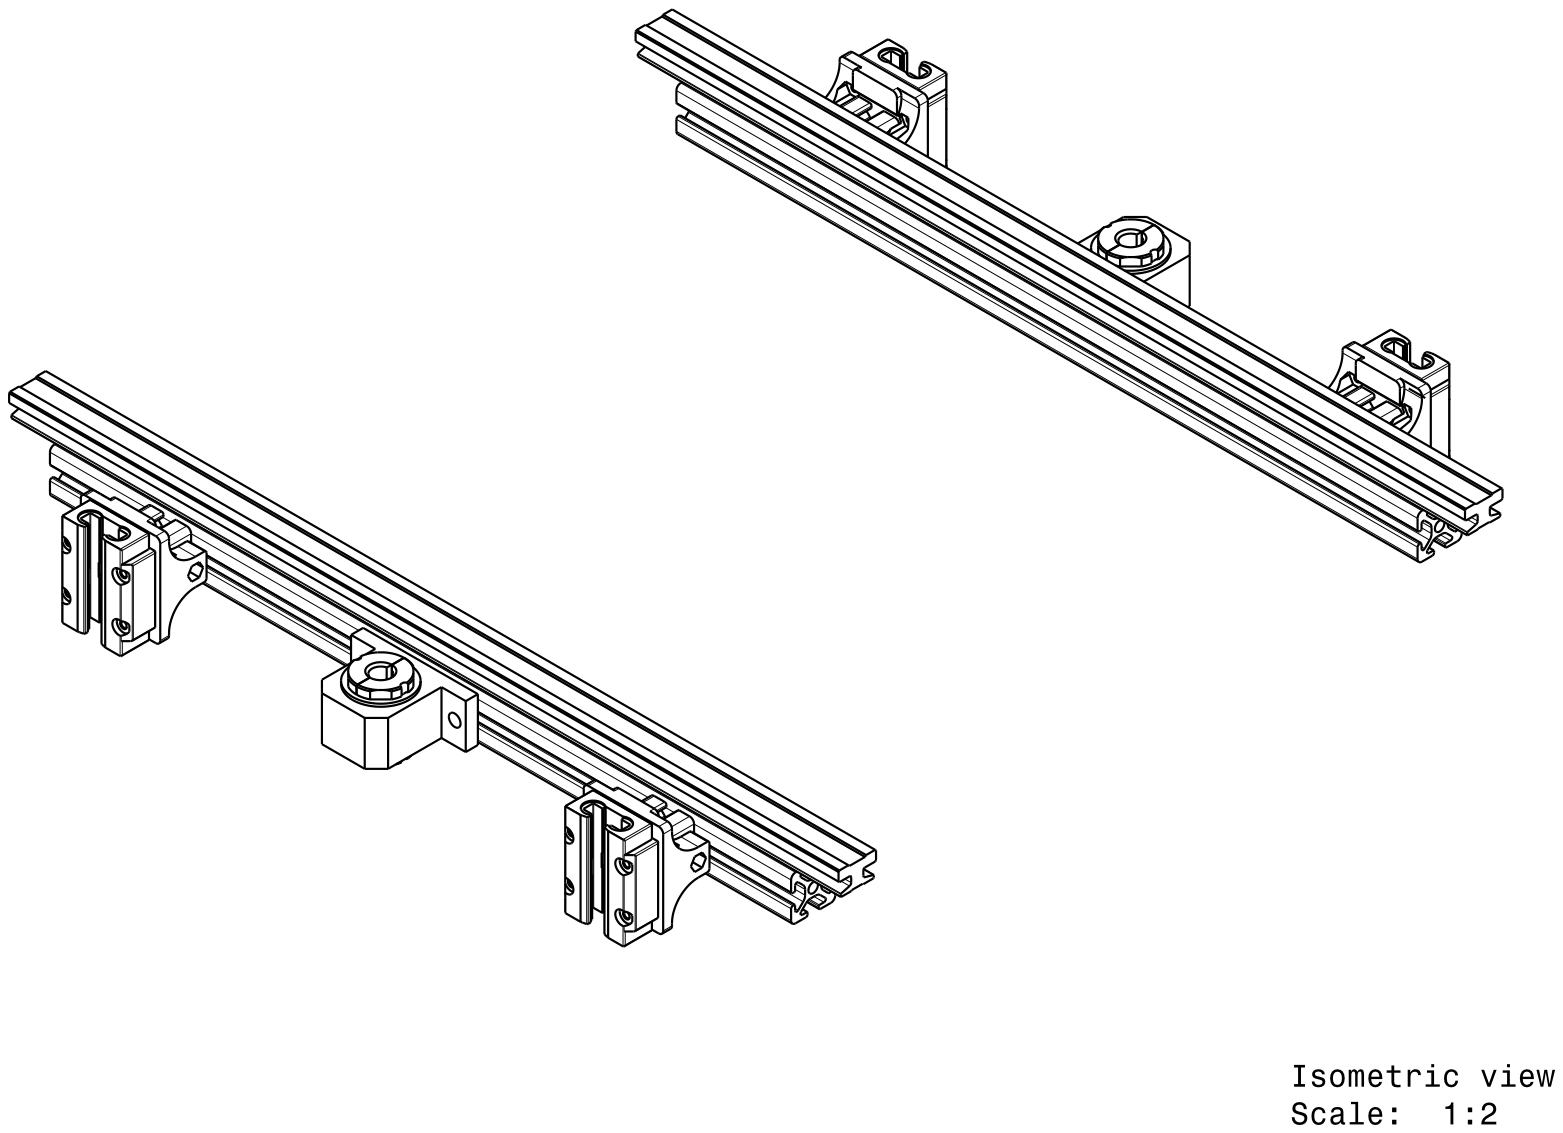
[picture p184: page 1]
