NervenCid/UNAL_FDM/Prototipo_11/Planos/Conjunto.pdf

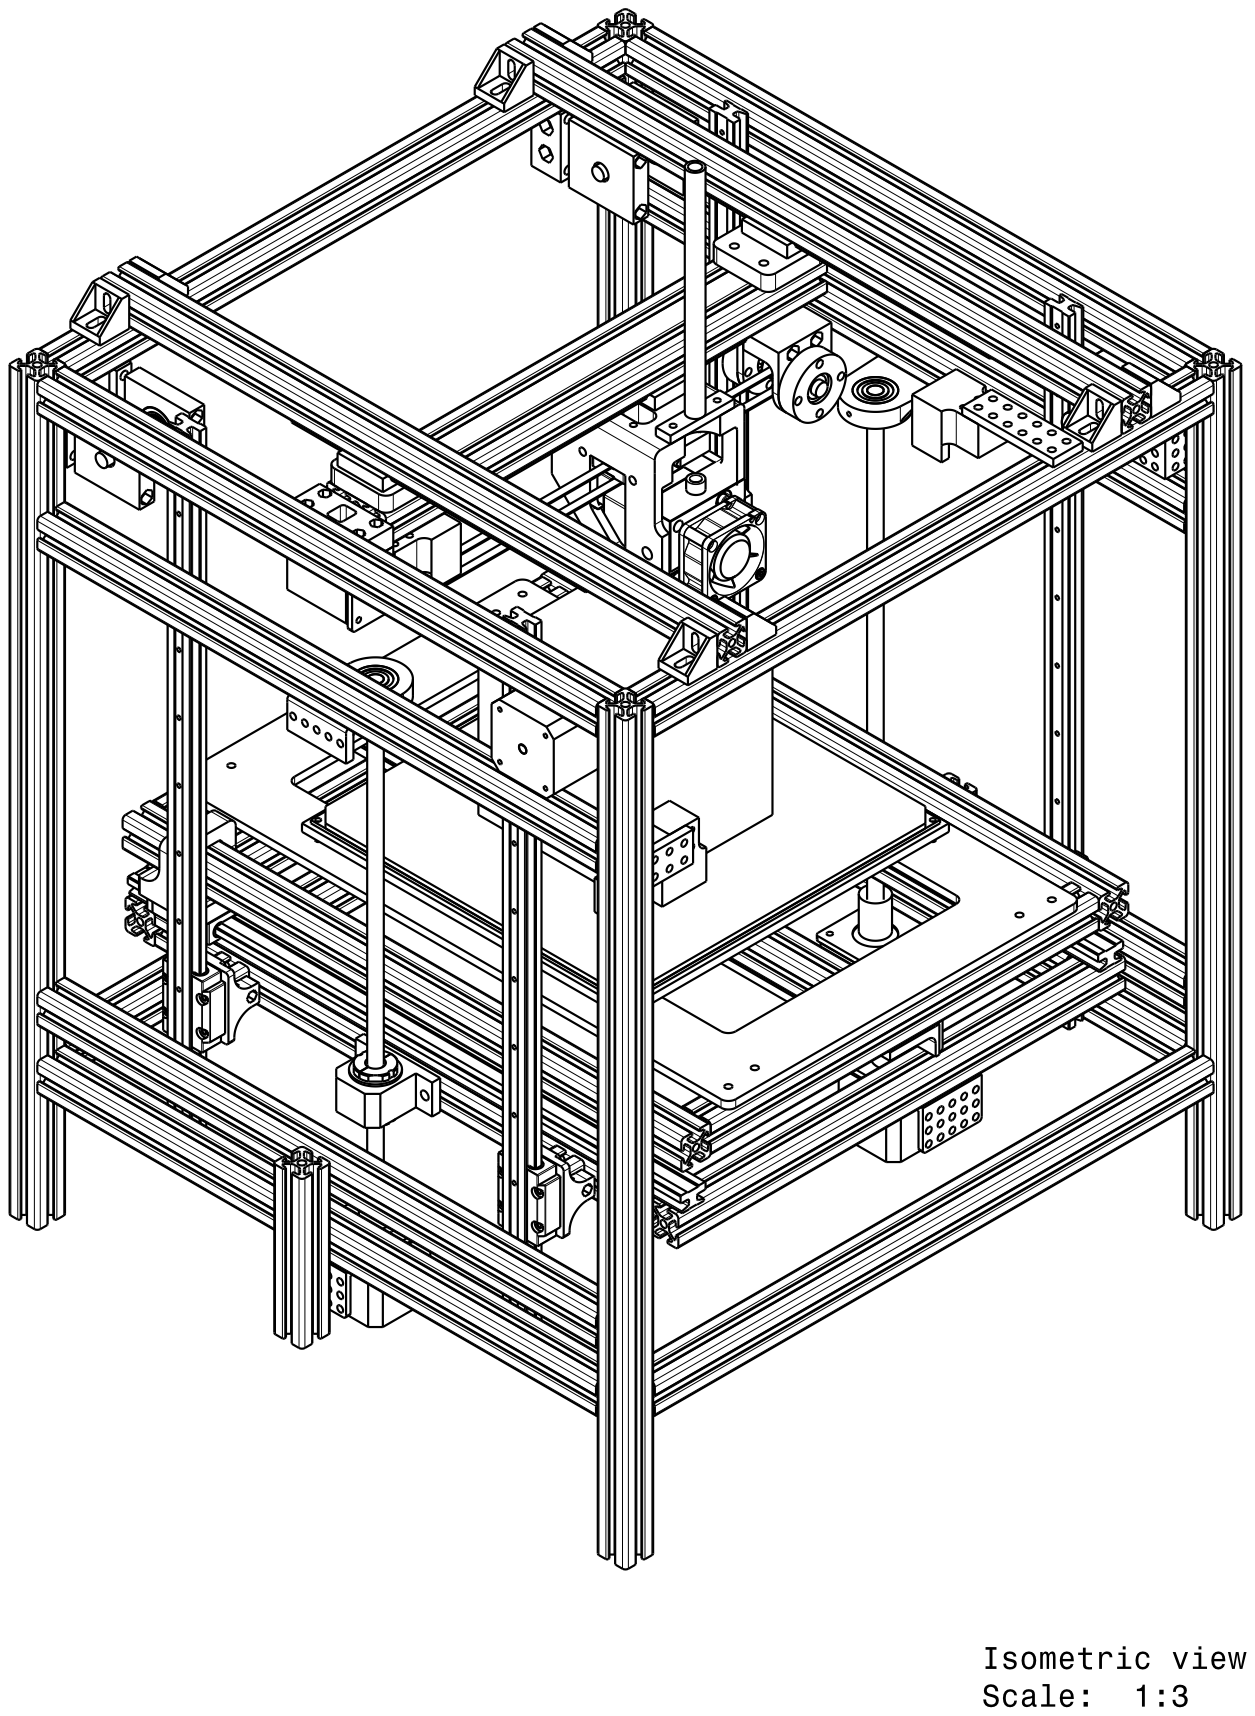
[picture p185: page 1]
