NervenCid/UNAL_FDM/Prototipo_11/Planos/EjeX.pdf

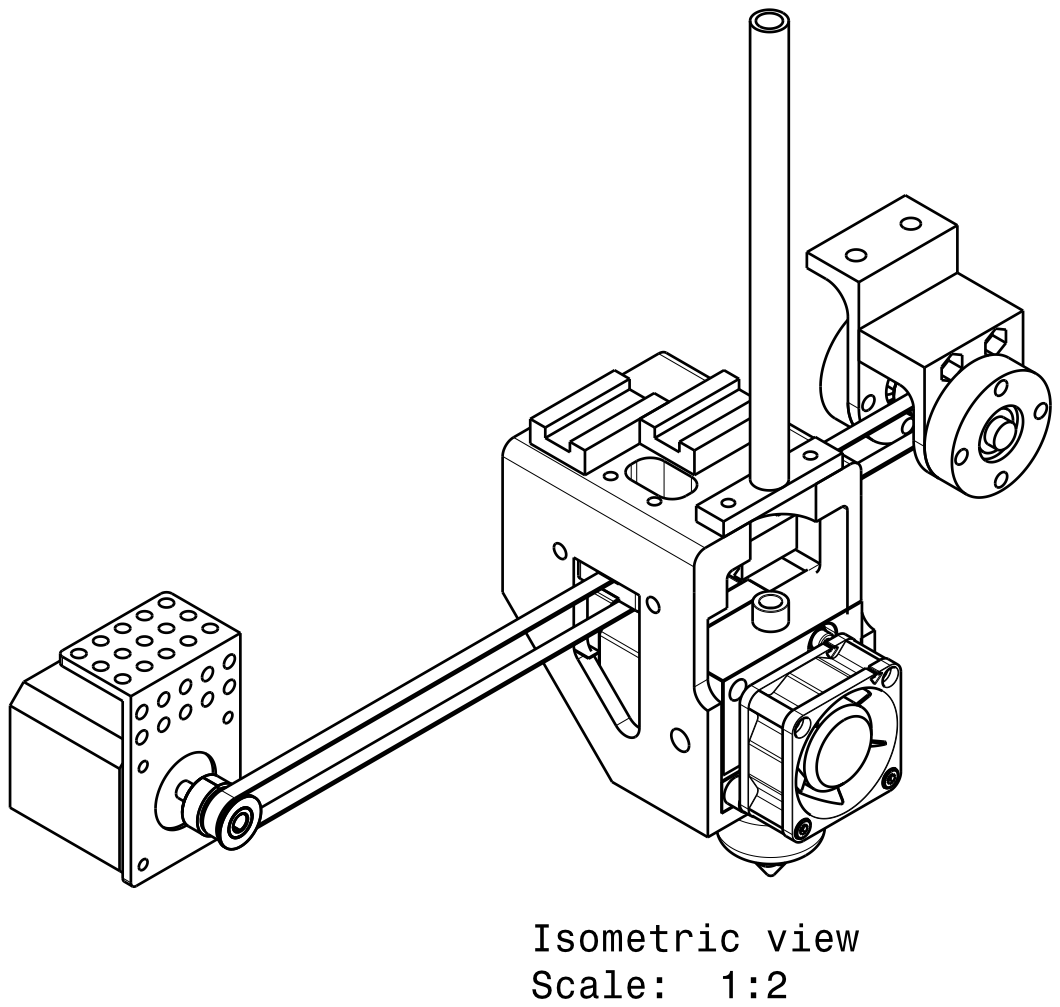
[picture p186: page 1]
