NervenCid/UNAL_FDM/Prototipo_11/Planos/EjeY.pdf

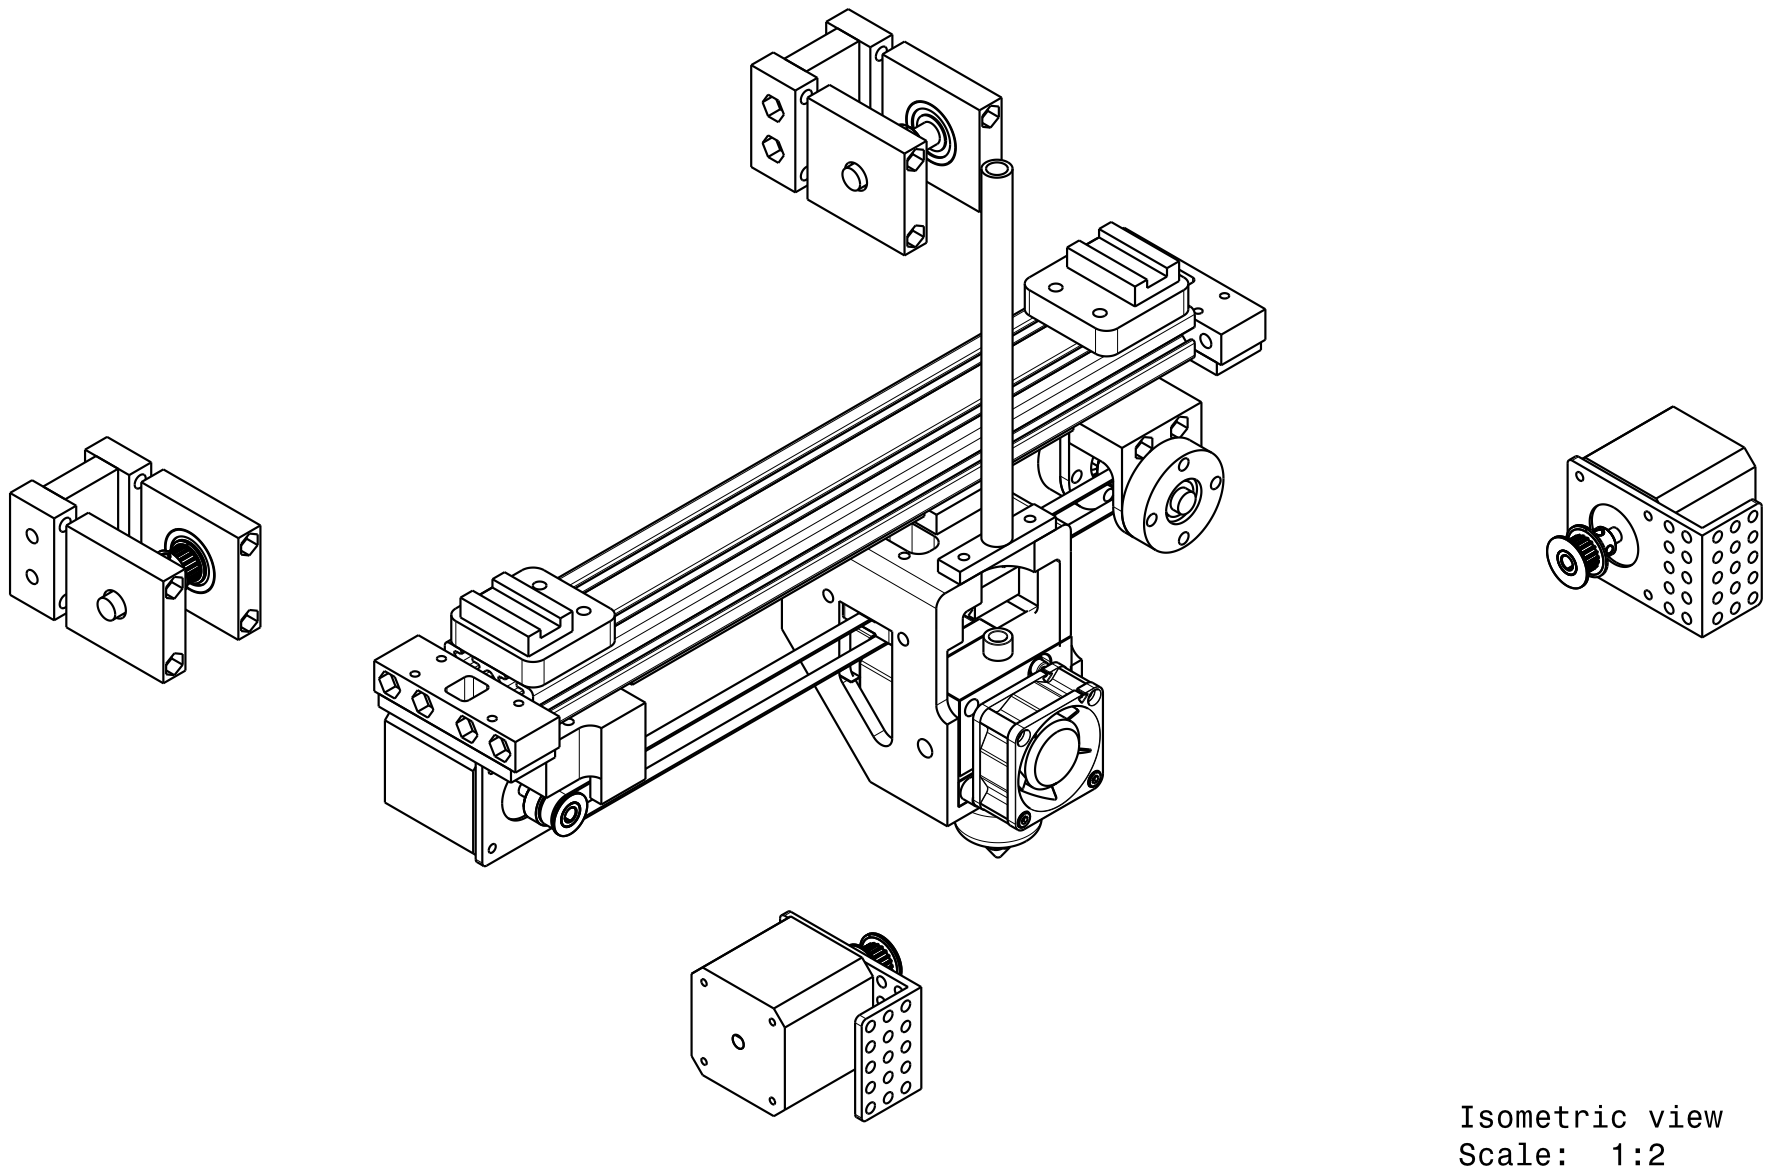
[picture p187: page 1]
