NervenCid/UNAL_FDM/Prototipo_11/Planos/EjeYEstr.pdf

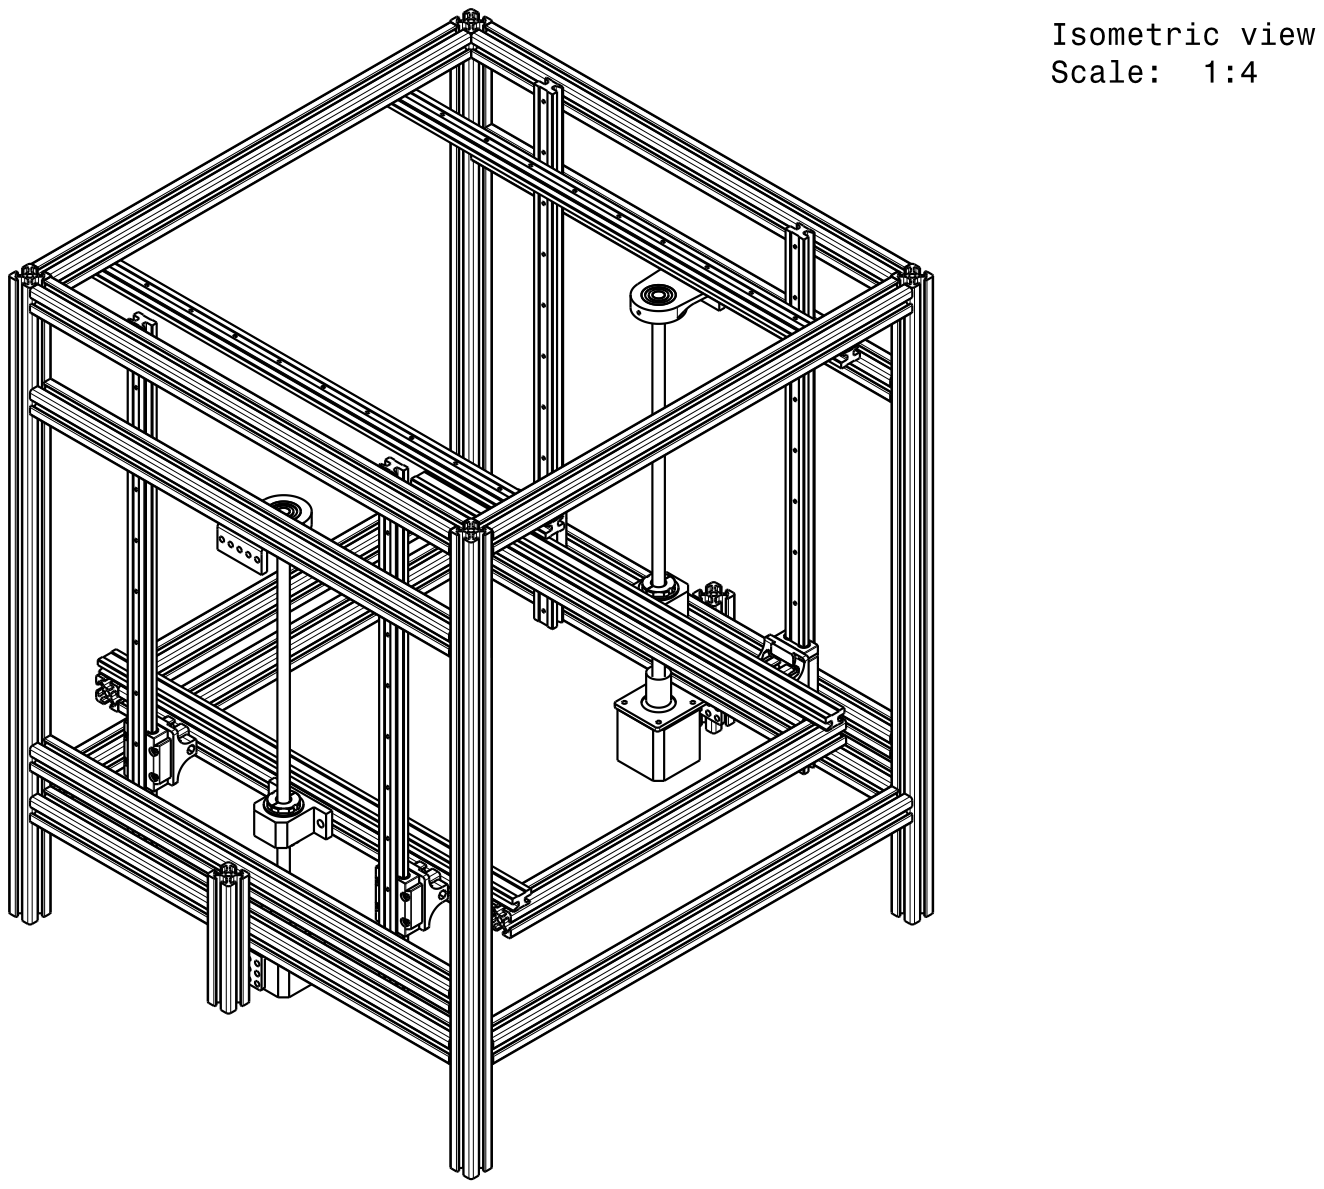
[picture p188: page 1]
