NervenCid/UNAL_FDM/Prototipo_11/Planos/EjeZ.pdf

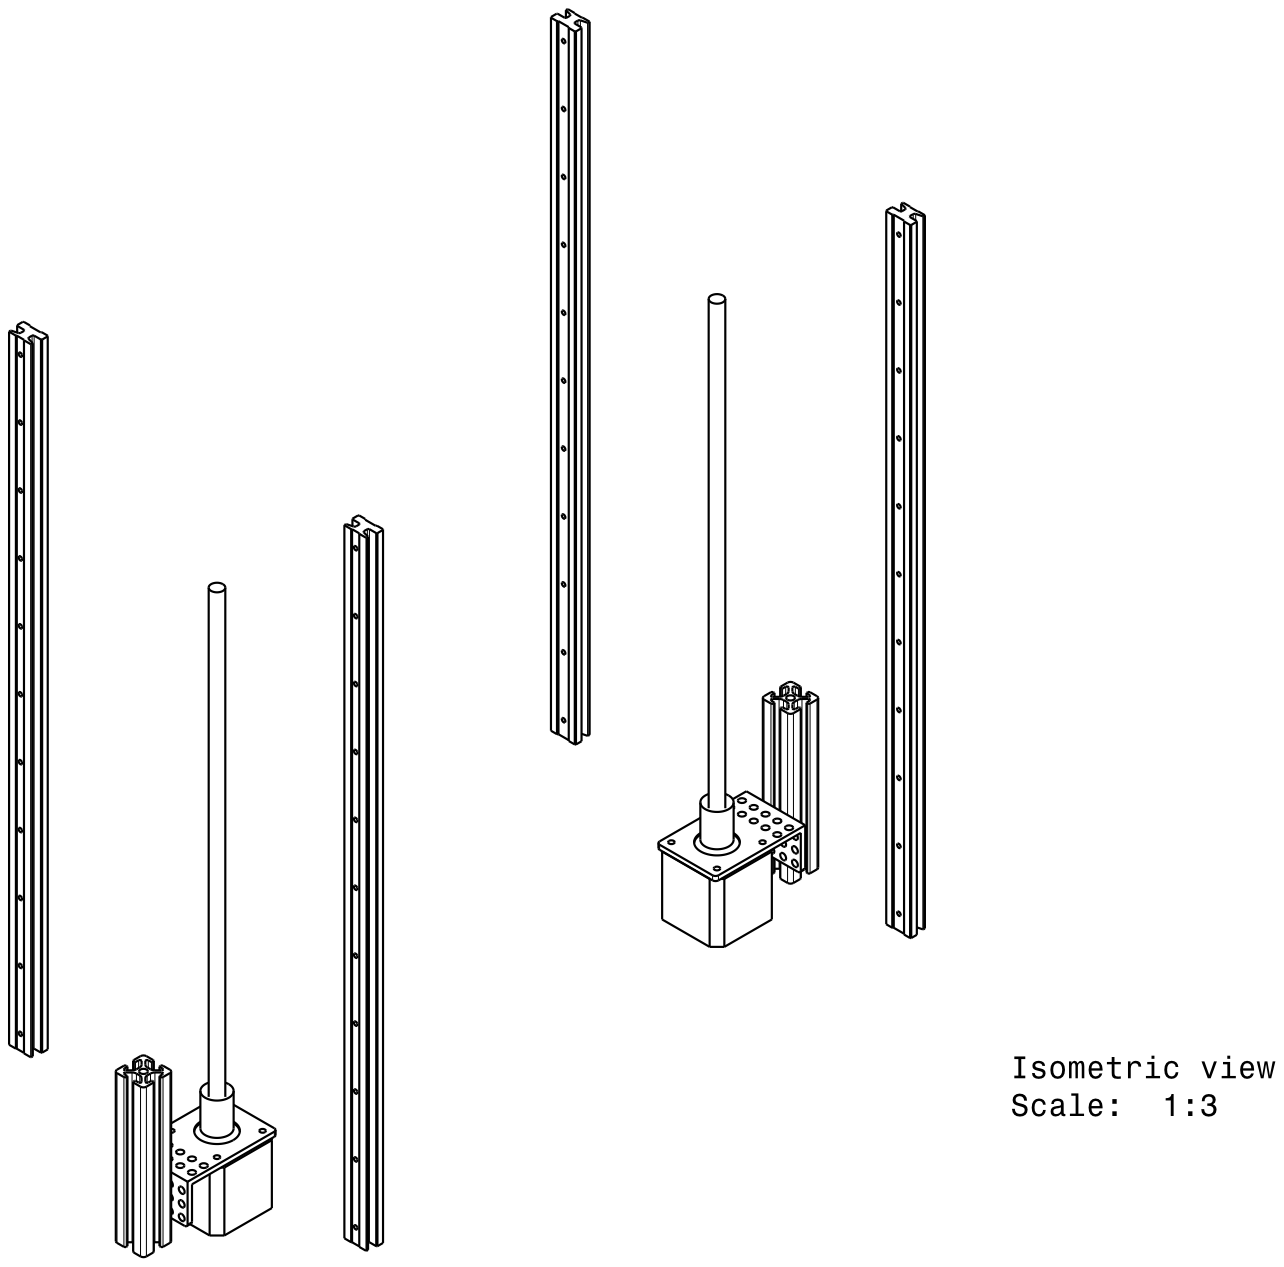
[picture p189: page 1]
