NervenCid/UNAL_FDM/Prototipo_11/Planos/EstructBMF1.pdf

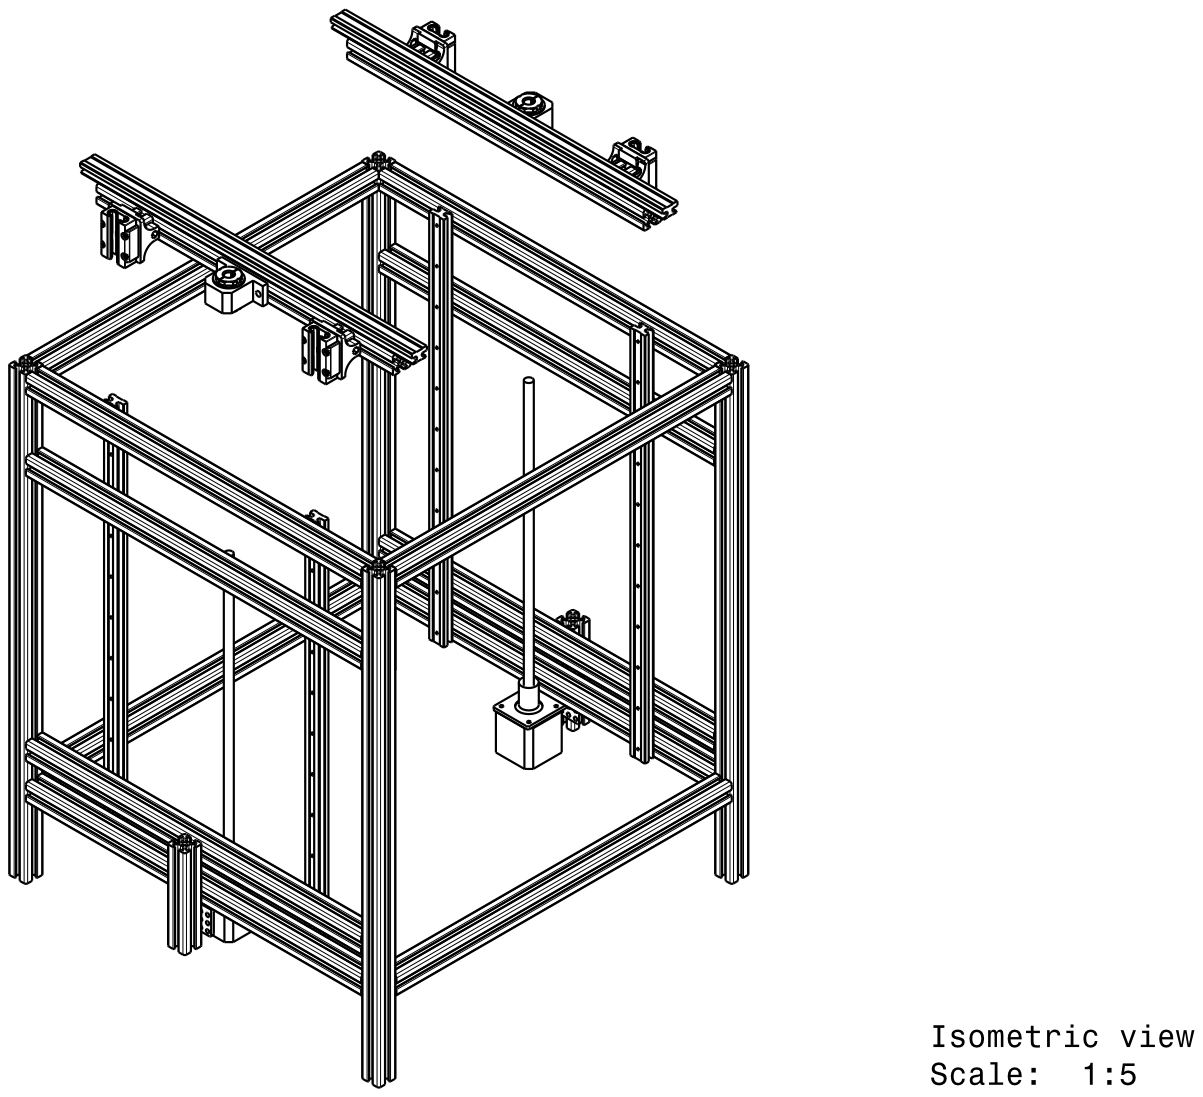
[picture p190: page 1]
