NervenCid/UNAL_FDM/Prototipo_11/Planos/EstructBMF3.pdf

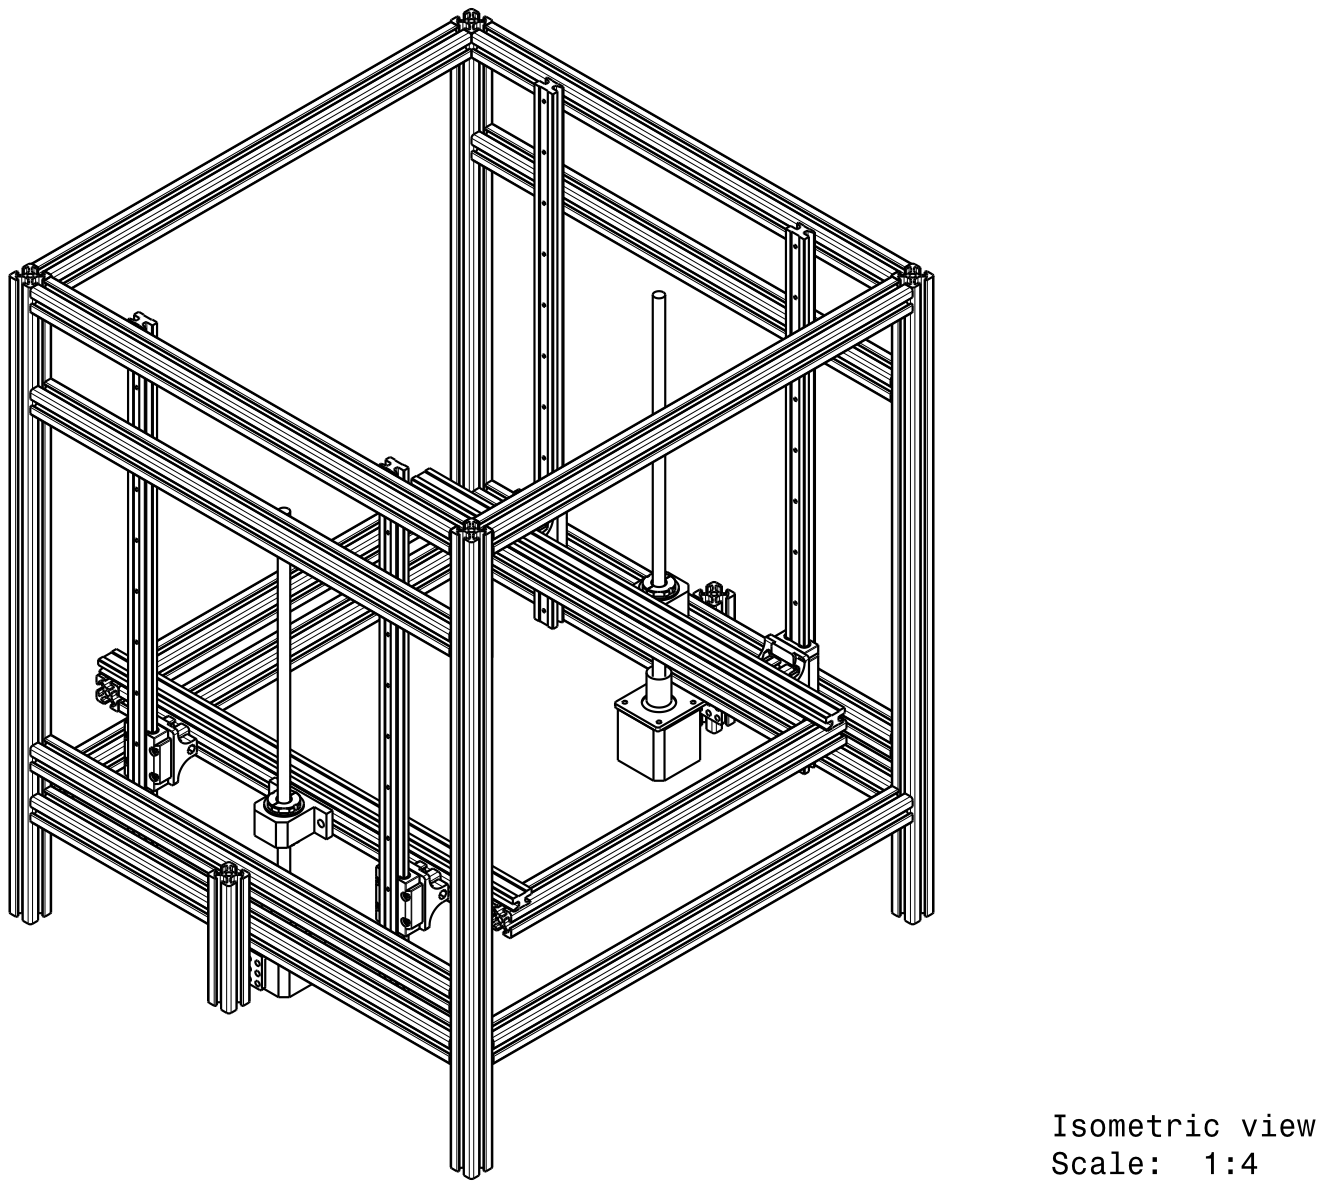
[picture p191: page 1]
