NervenCid/UNAL_FDM/Prototipo_11/Planos/EstructBMF4.pdf

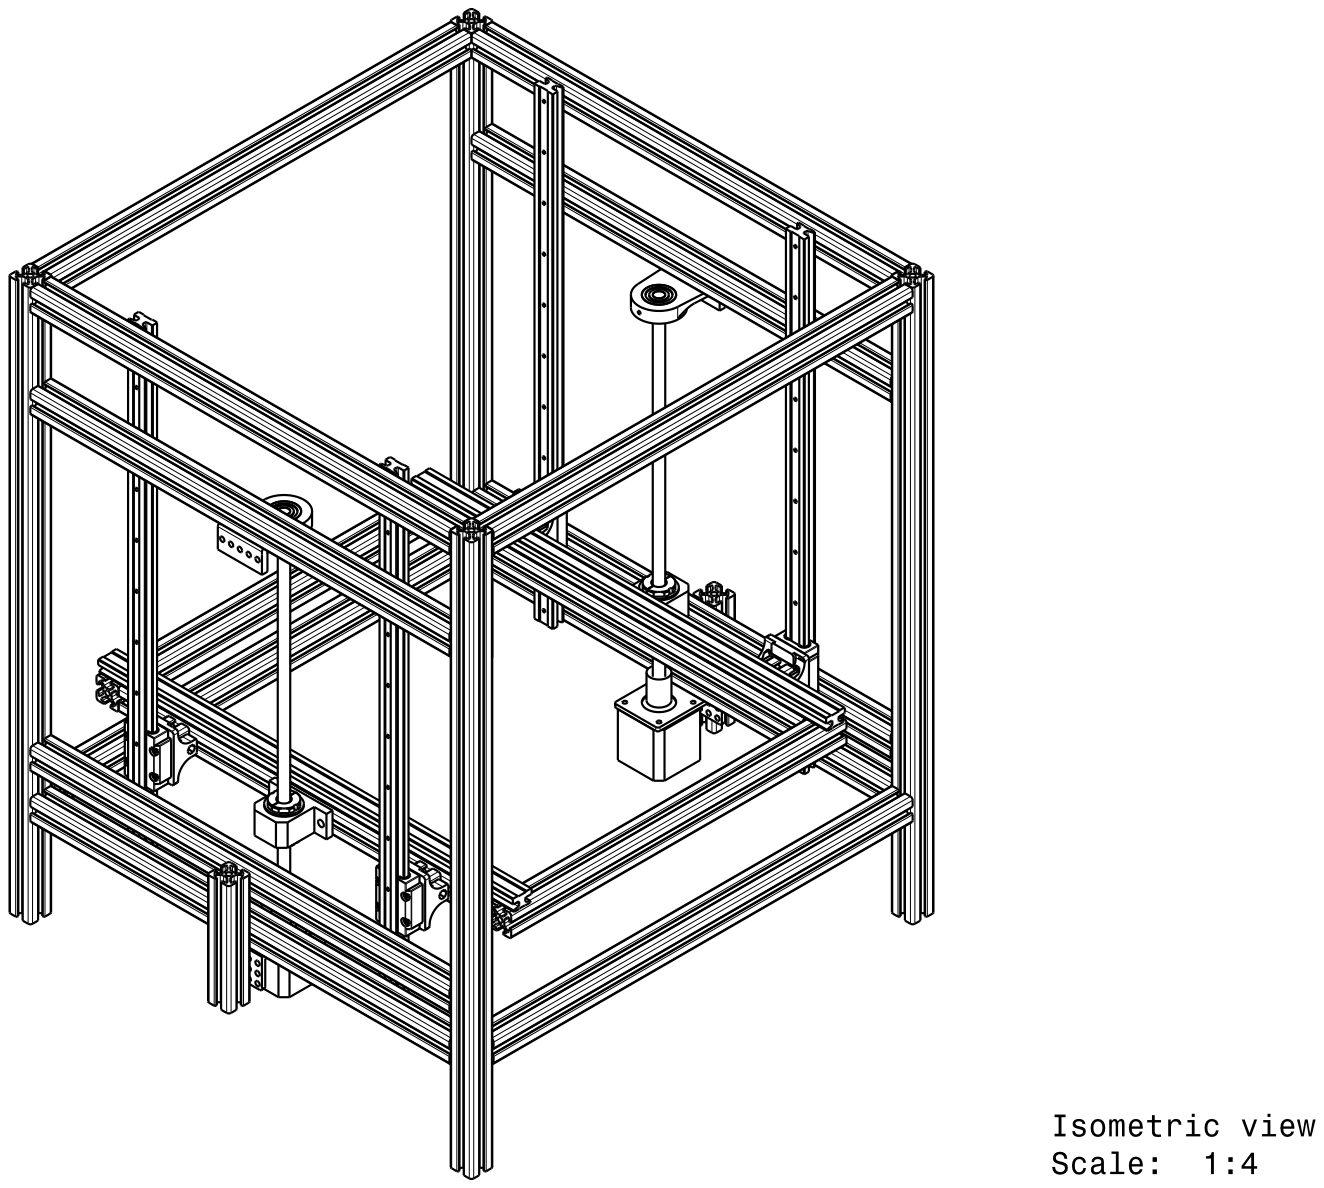
[picture p192: page 1]
