NervenCid/UNAL_FDM/Prototipo_11/Planos/EstructPatin.pdf

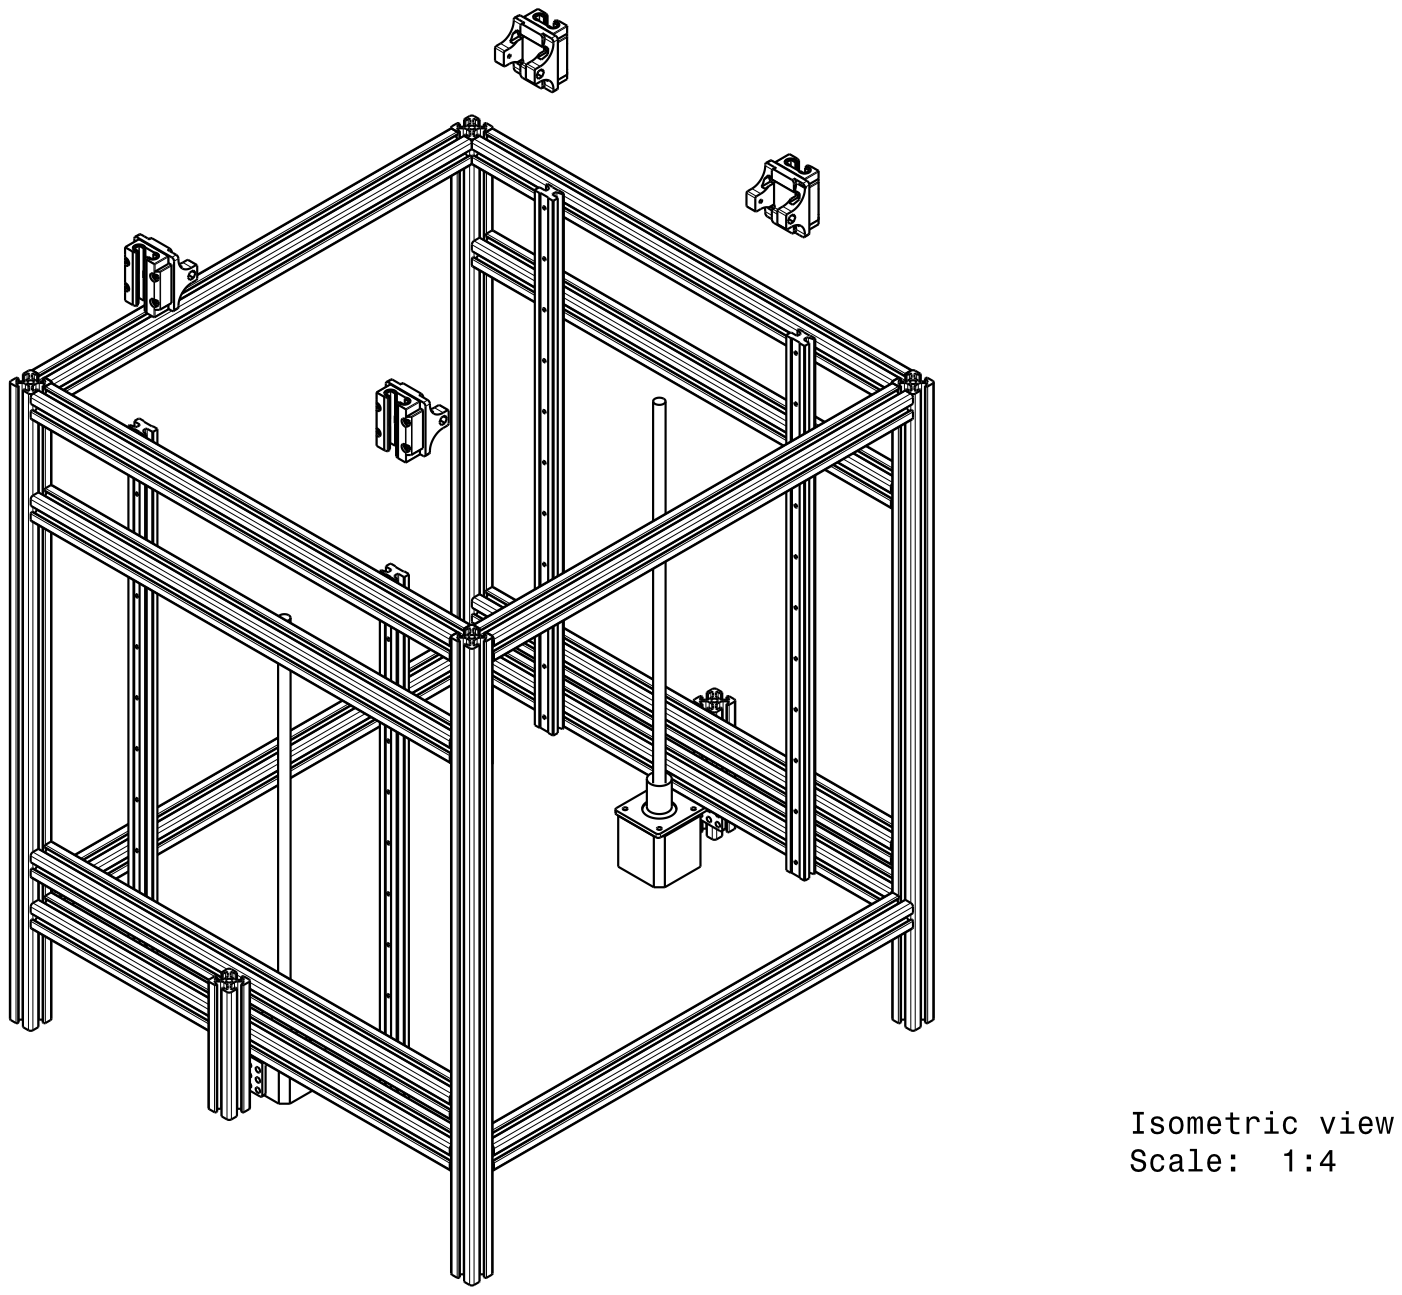
[picture p193: page 1]
