NervenCid/UNAL_FDM/Prototipo_11/Planos/EstructuraIsometrica.pdf

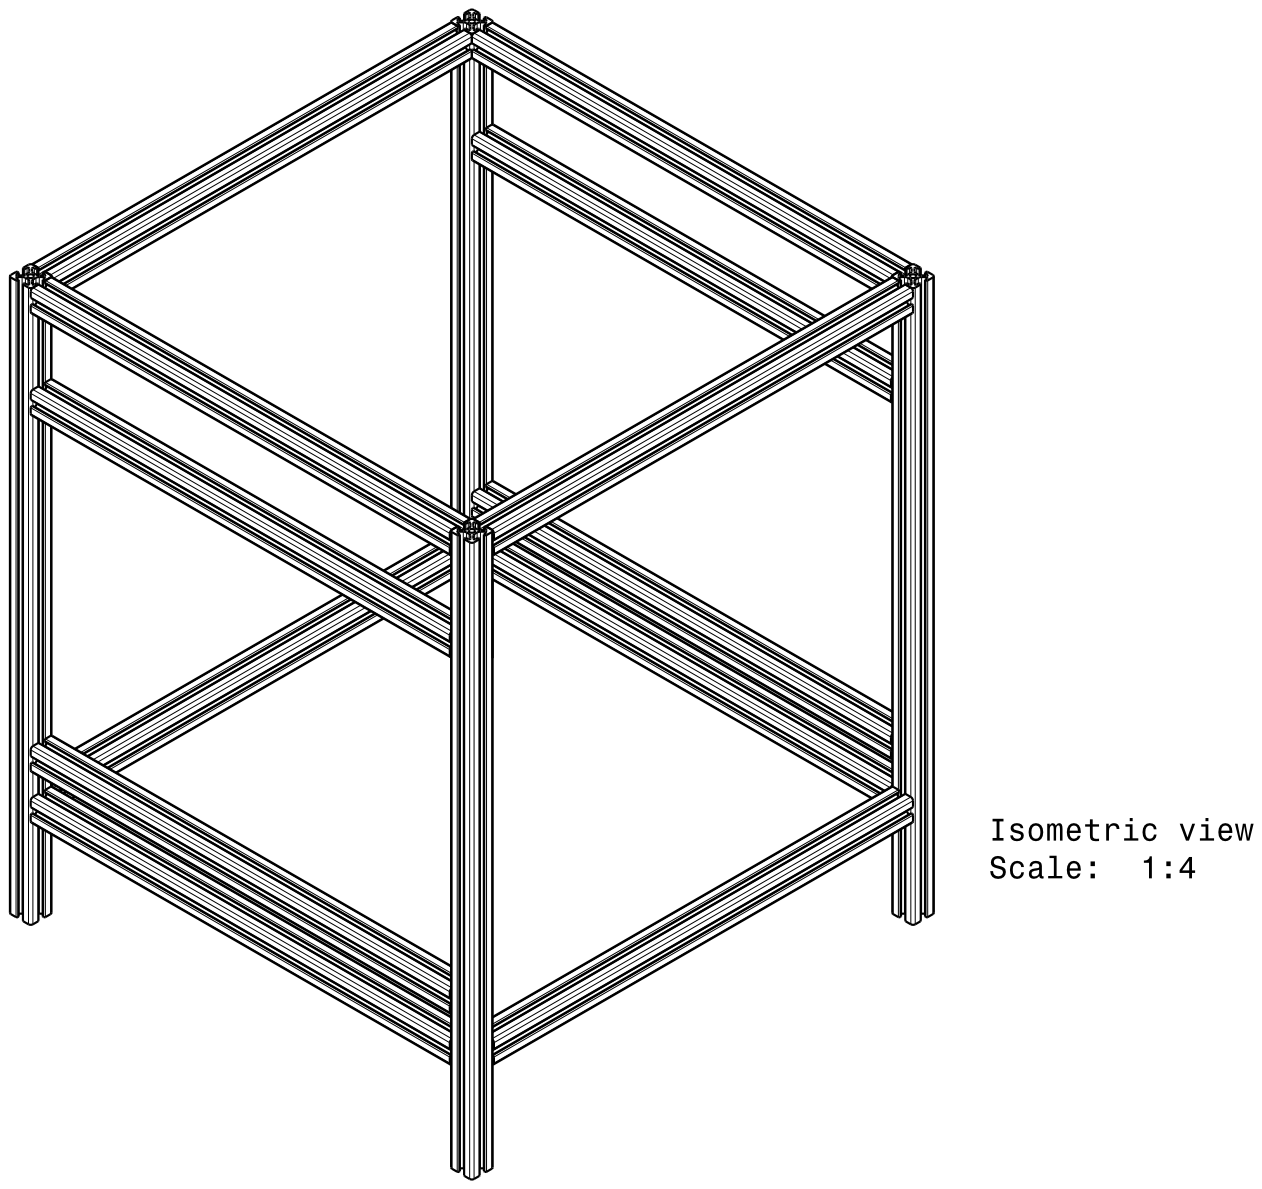
[picture p194: page 1]
