NervenCid/UNAL_FDM/Prototipo_11/Planos/EstructyEjeZ.pdf

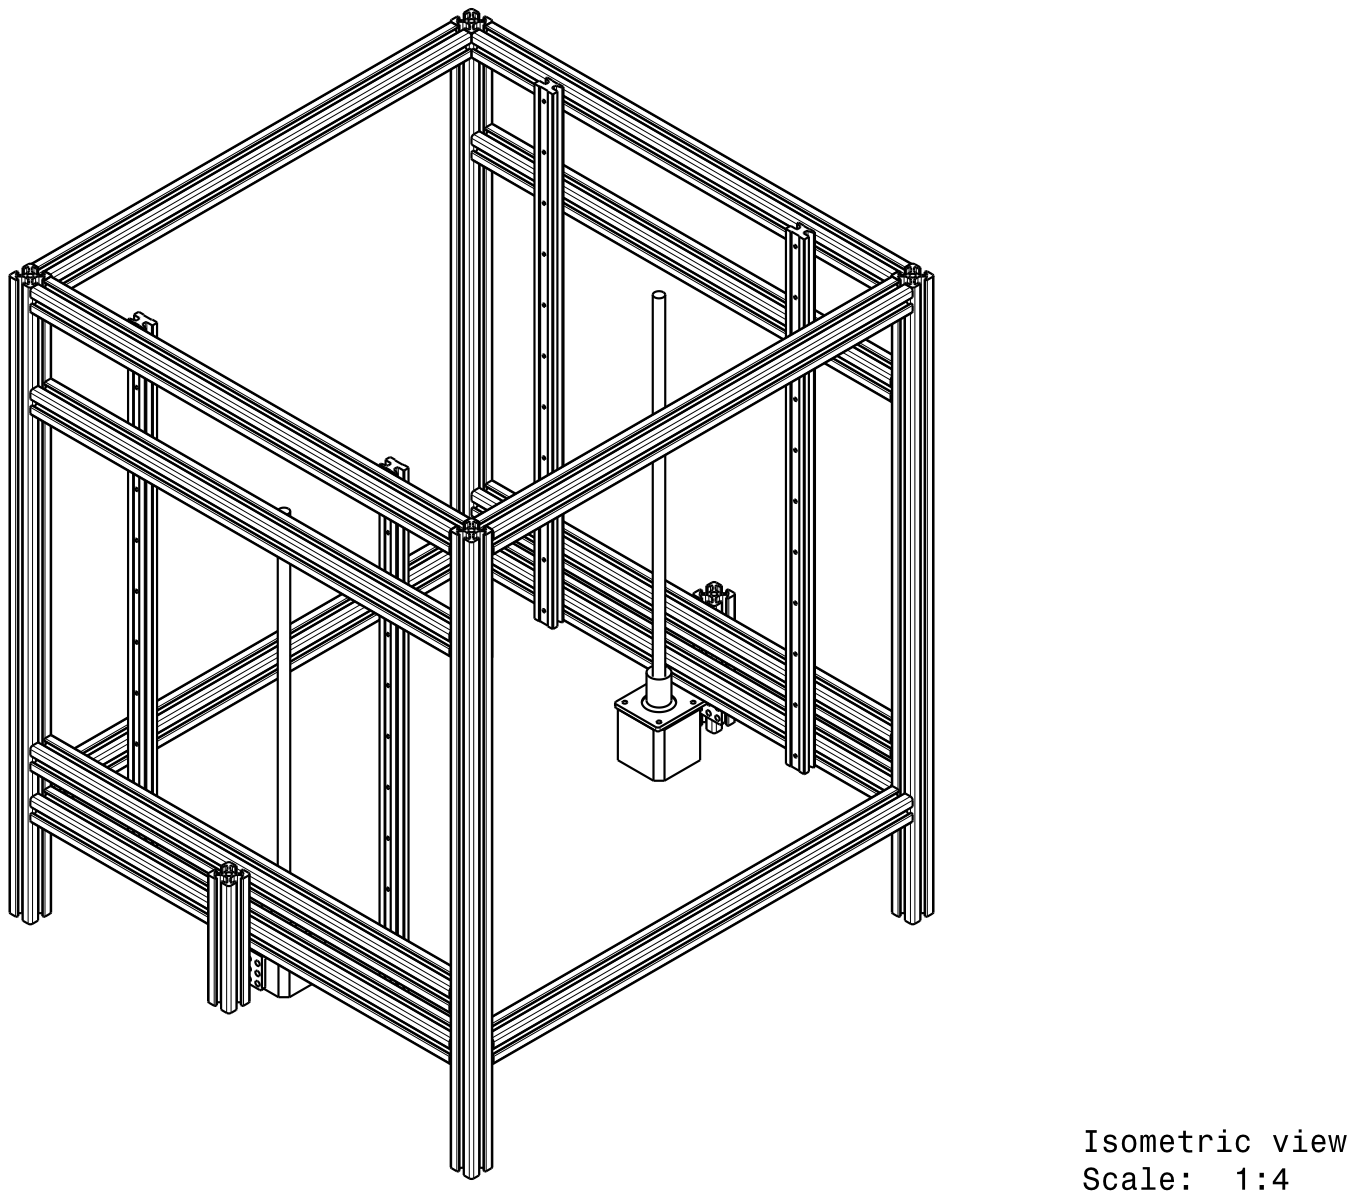
[picture p195: page 1]
