NervenCid/UNAL_FDM/Prototipo_11/Planos/ExtructEjeXYF1.pdf

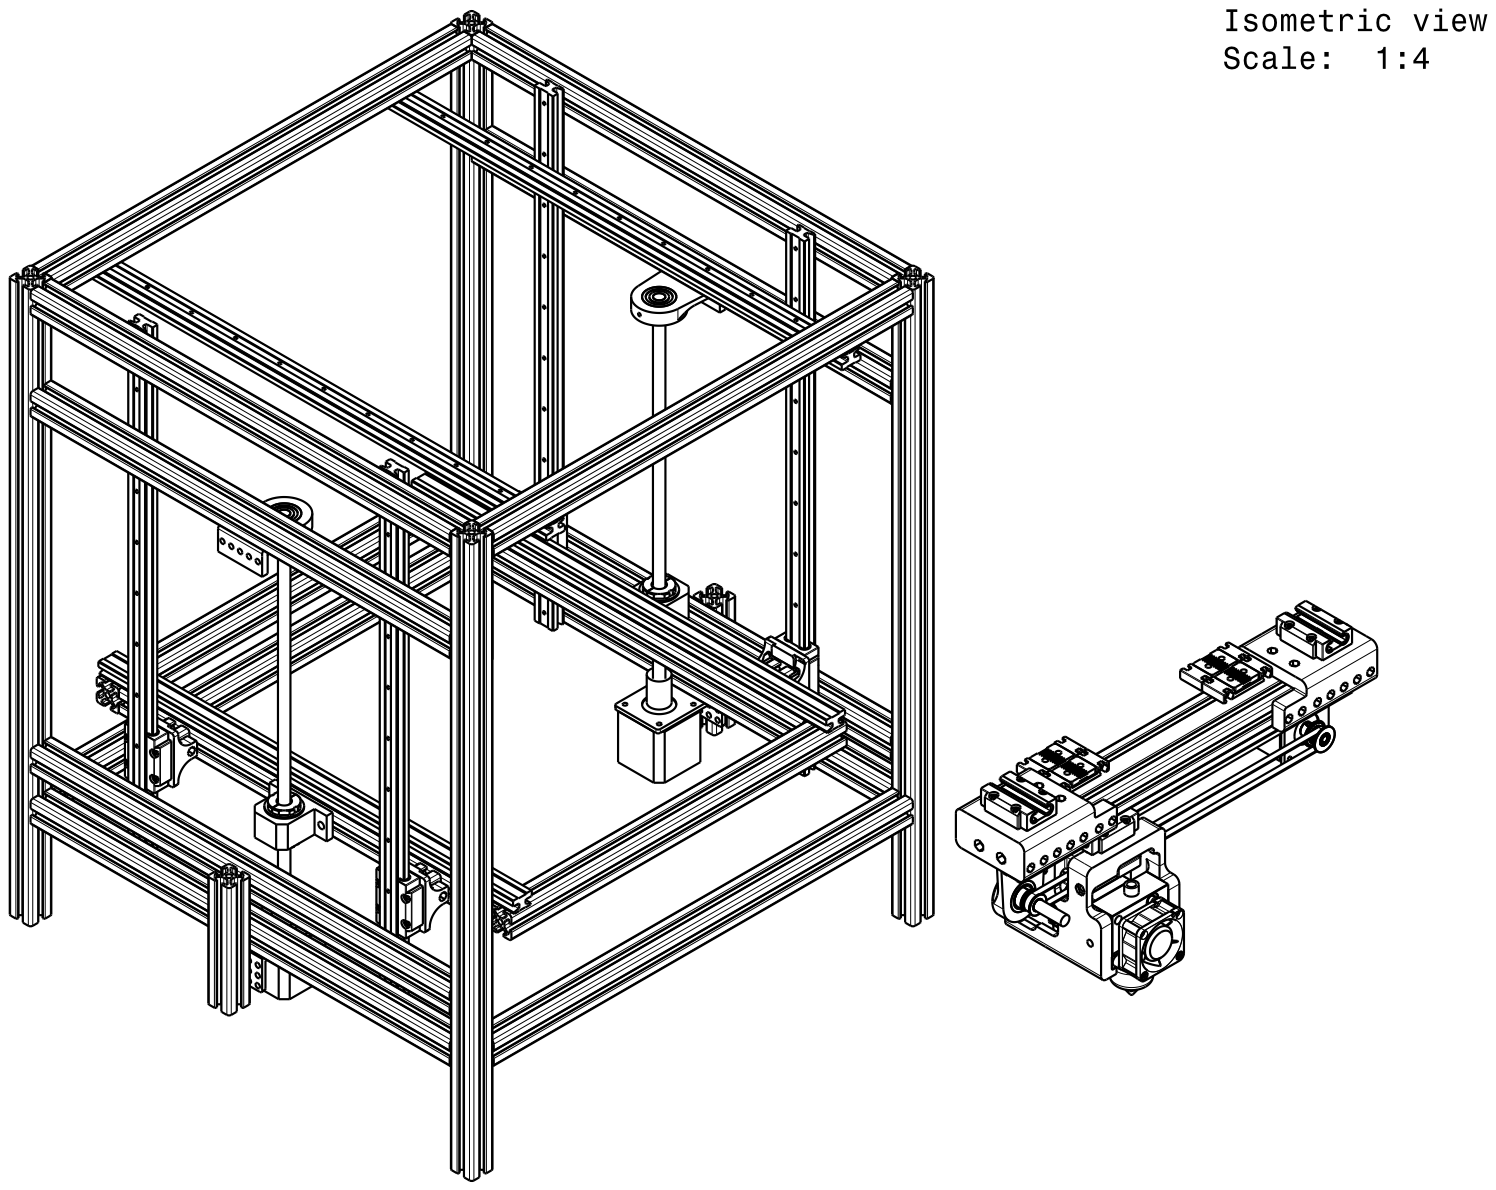
[picture p196: page 1]
