NervenCid/UNAL_FDM/Prototipo_11/Planos/ExtructEjeXYF2.pdf

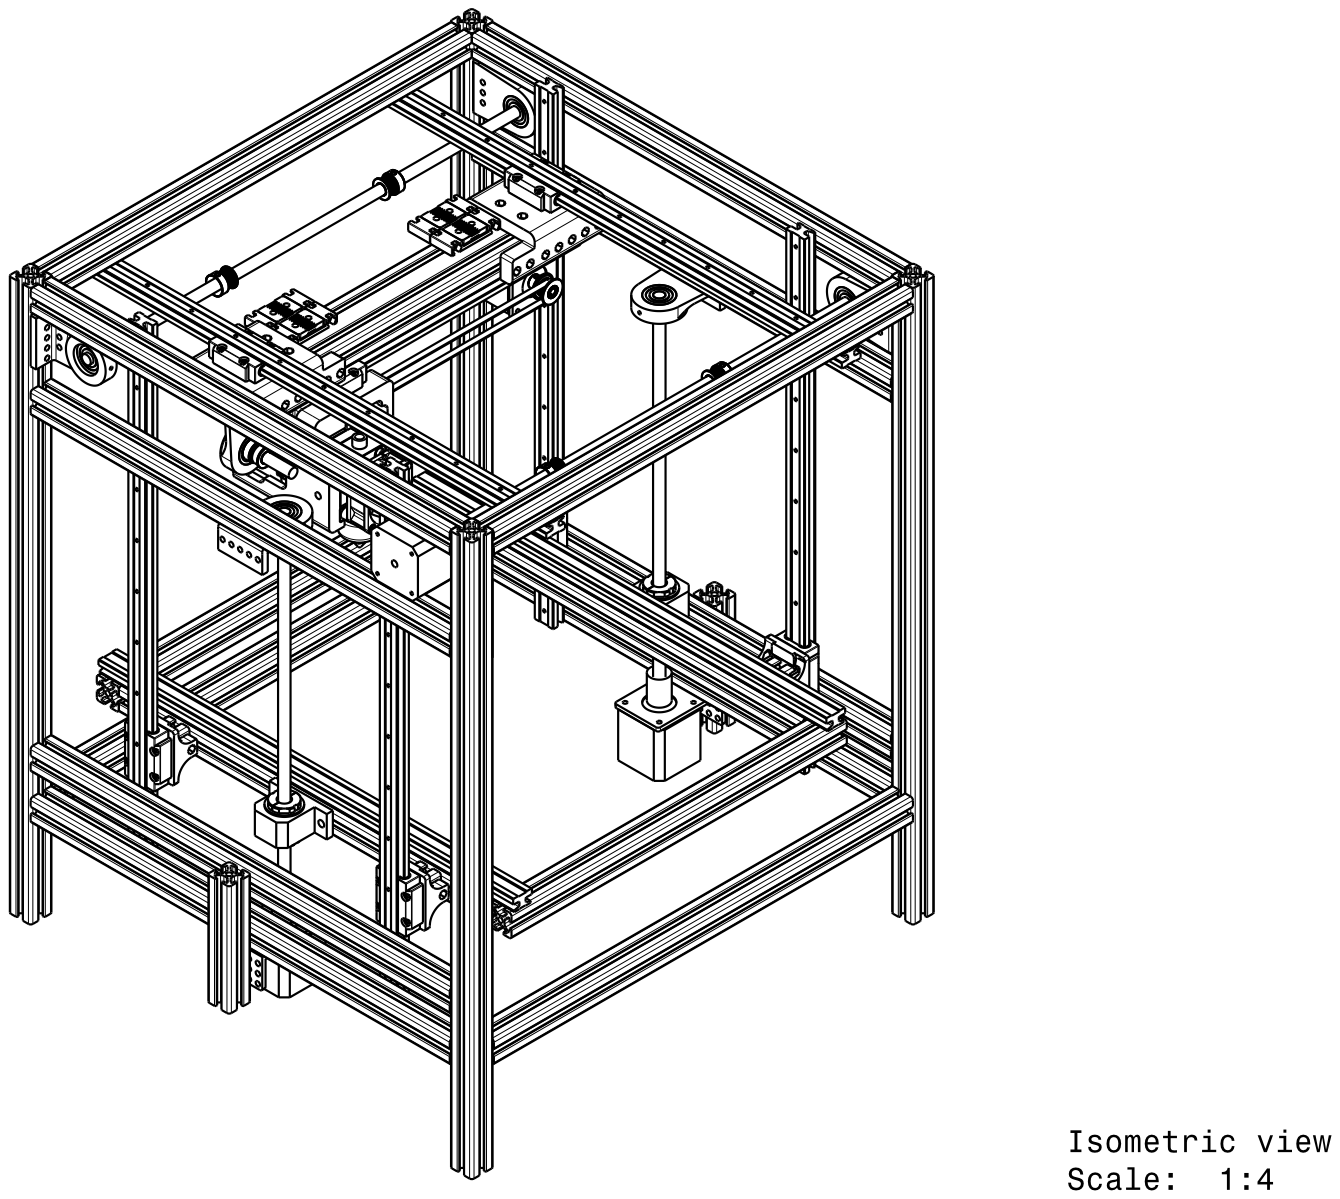
[picture p197: page 1]
