NervenCid/UNAL_FDM/Prototipo_11/Planos/Extrusor.pdf

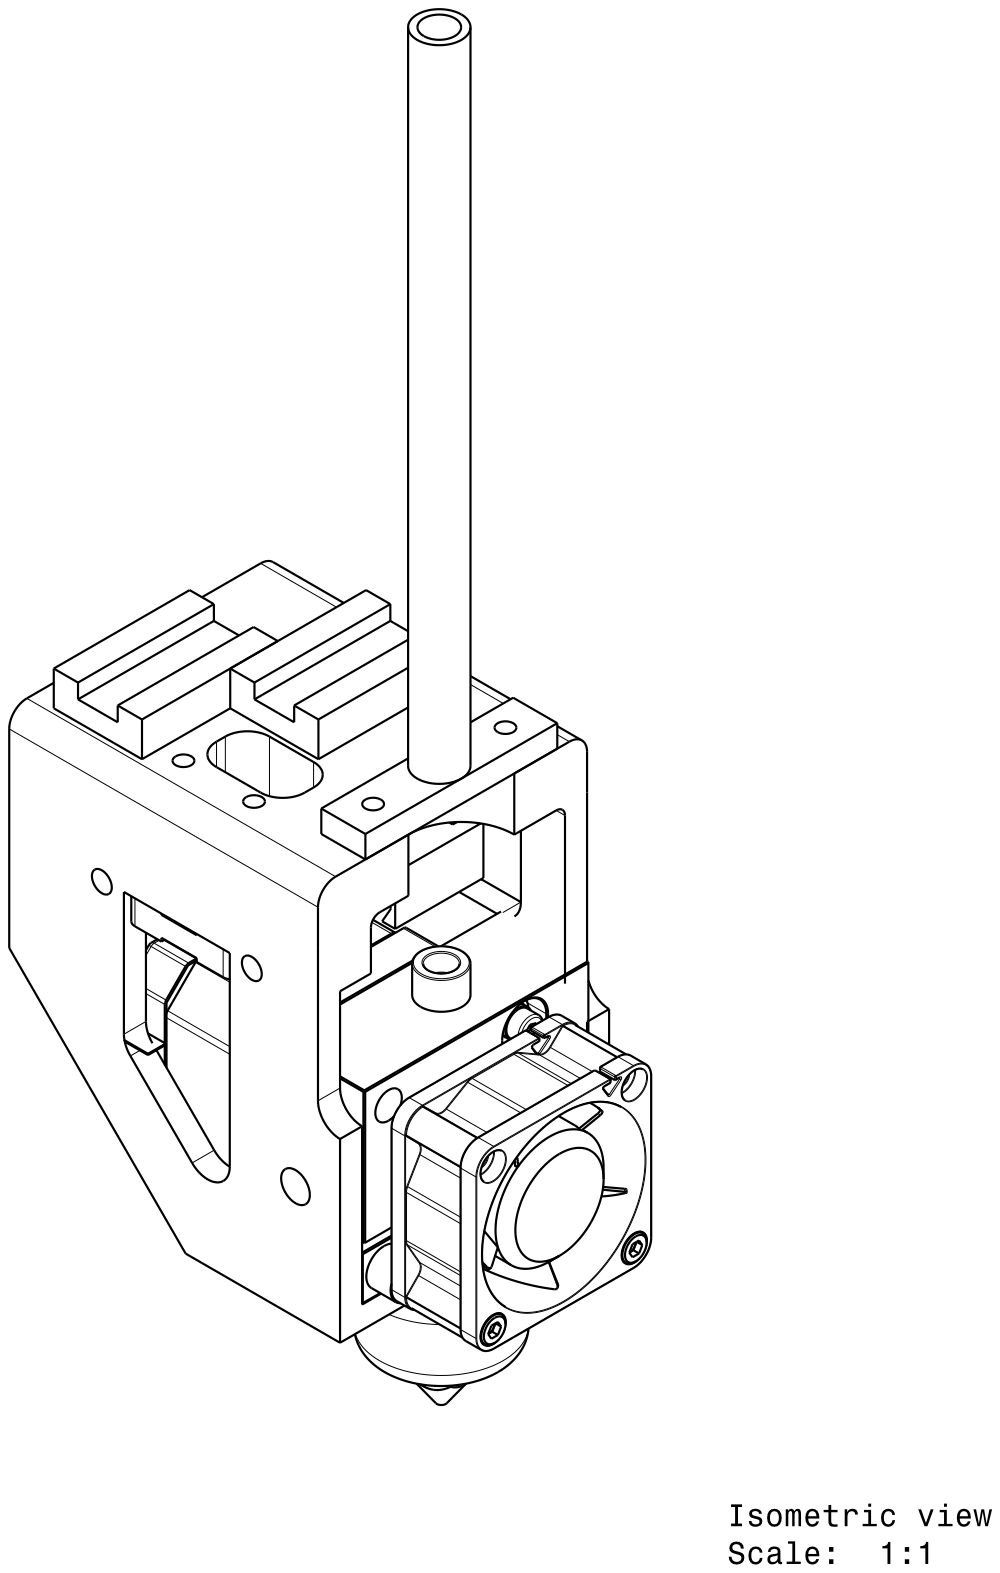
[picture p198: page 1]
