NervenCid/UNAL_FDM/Prototipo_11/Planos/GuiaCili.pdf

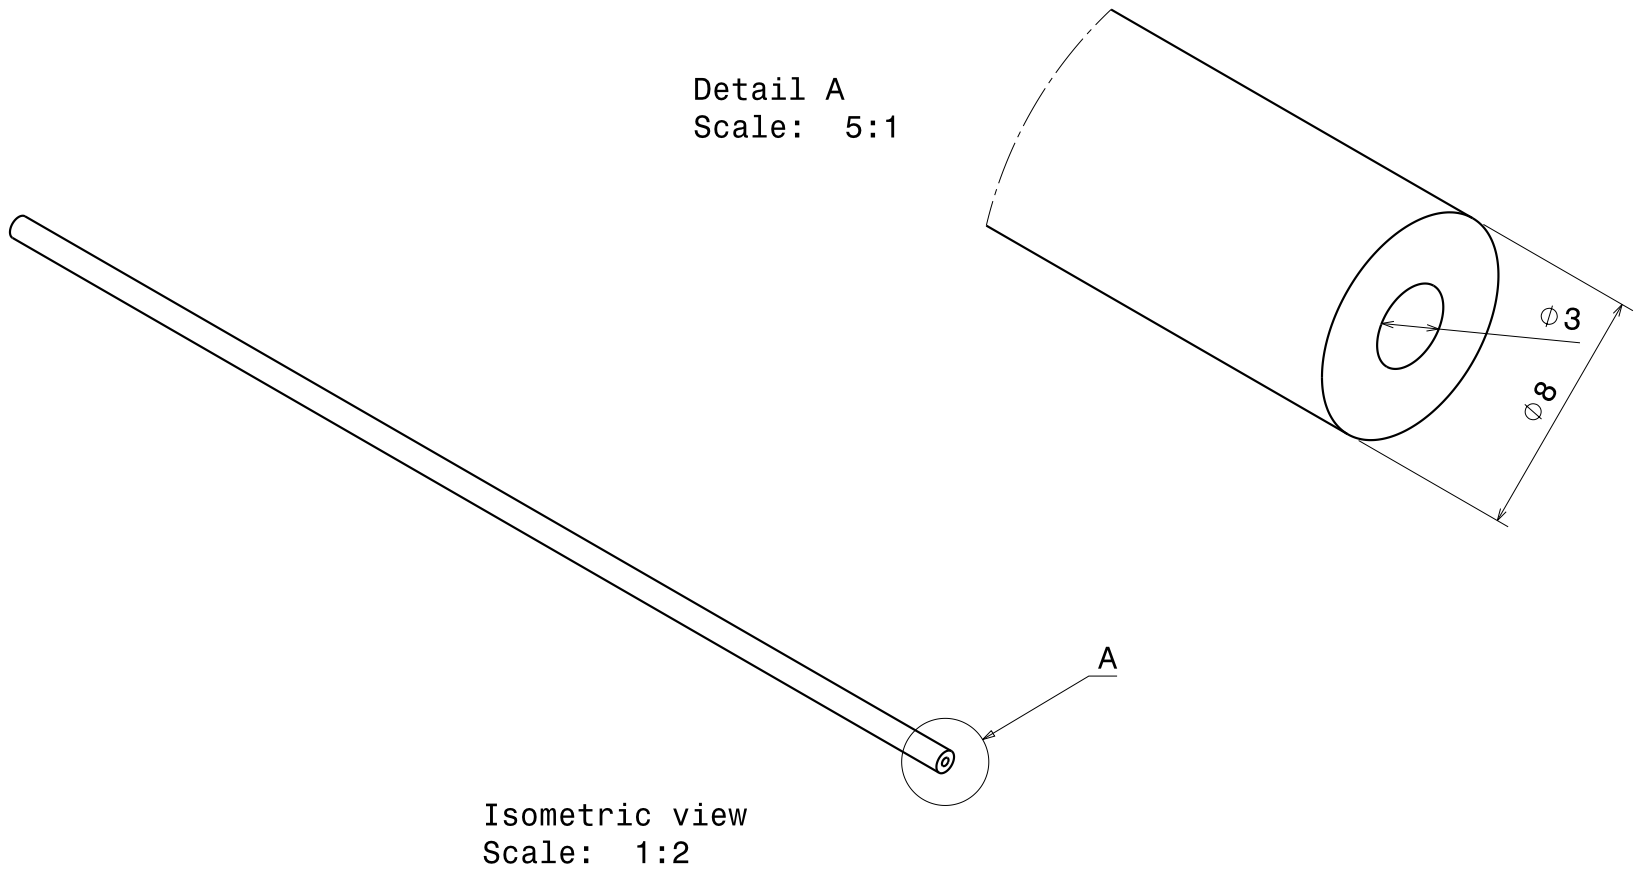
[picture p199: page 1]
