NervenCid/UNAL_FDM/Prototipo_11/Planos/HBP.pdf

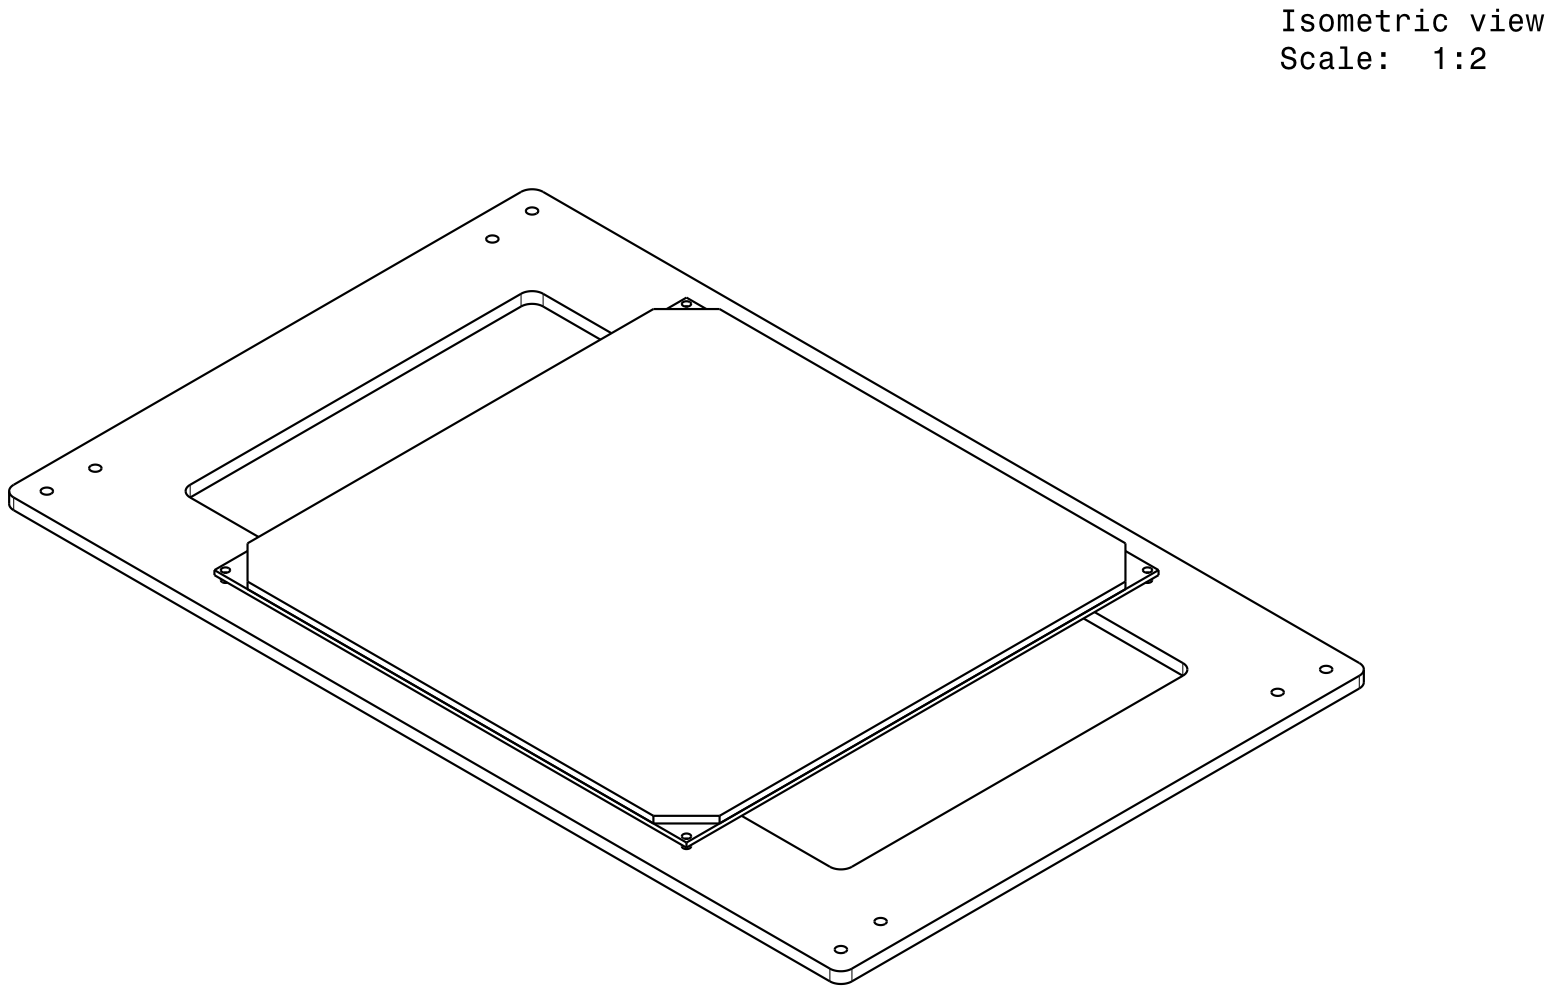
[picture p200: page 1]
