NervenCid/UNAL_FDM/Prototipo_11/Planos/HBPExplo.pdf

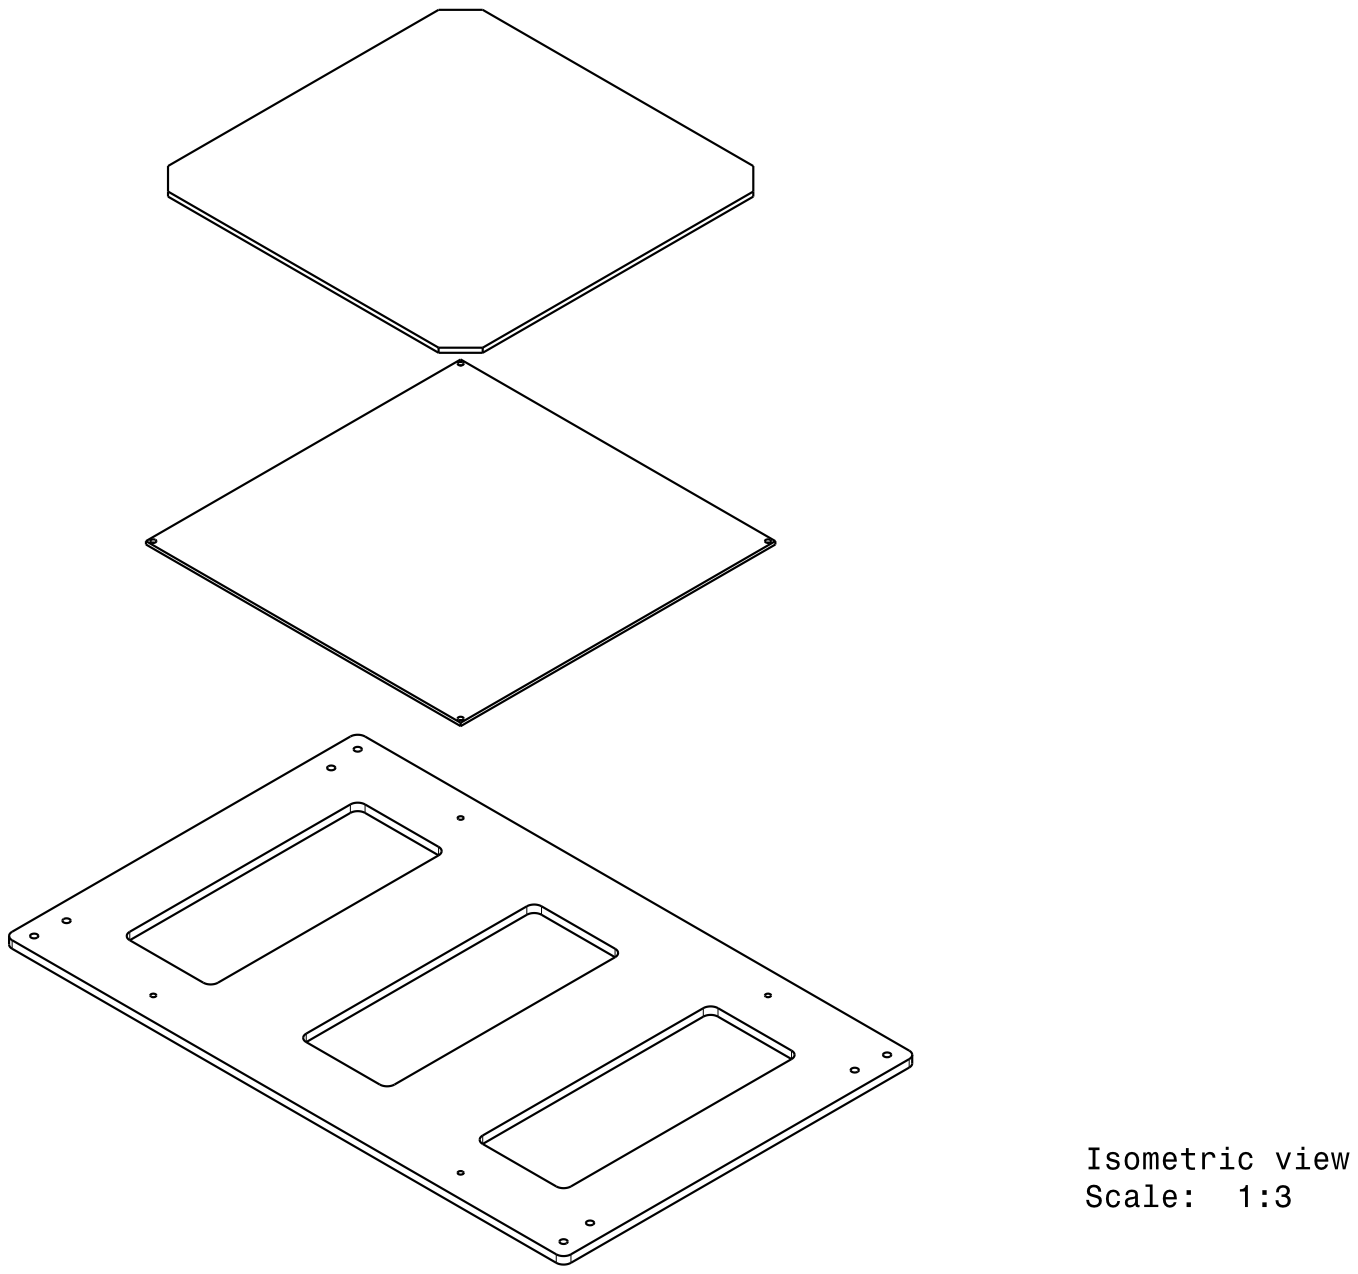
[picture p201: page 1]
