NervenCid/UNAL_FDM/Prototipo_11/Planos/IsometricaExplos.pdf

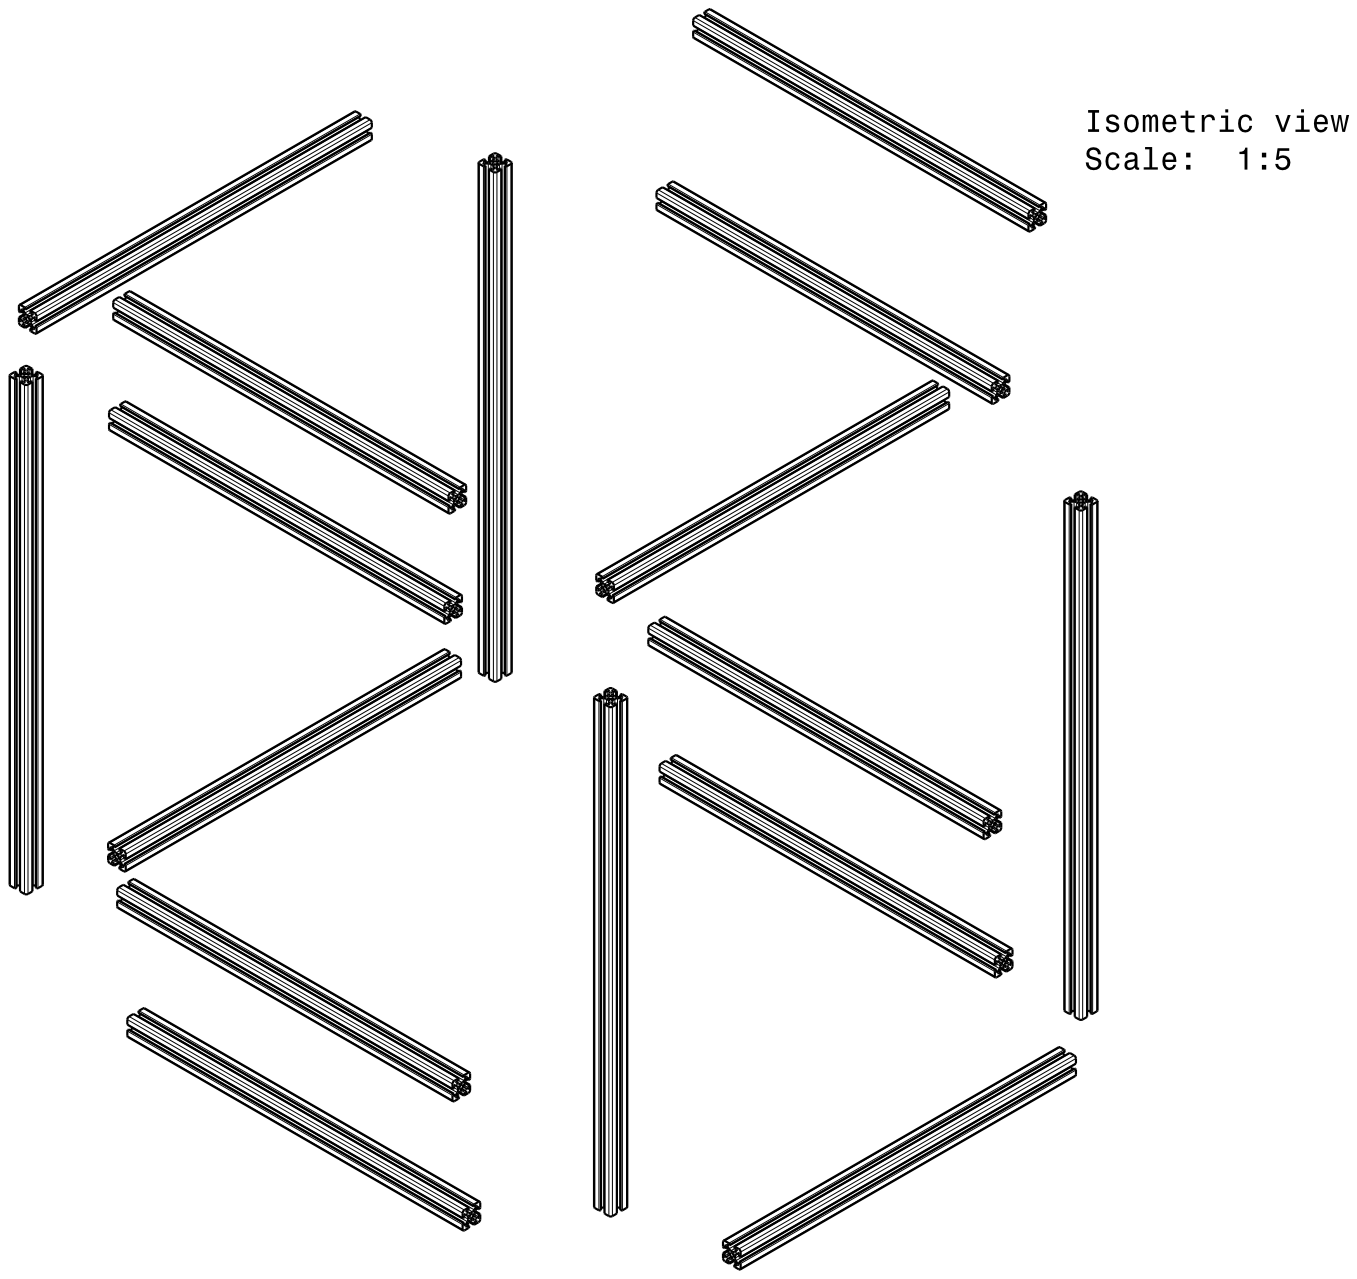
[picture p202: page 1]
