NervenCid/UNAL_FDM/Prototipo_11/Planos/LaminaYTWExplo.pdf

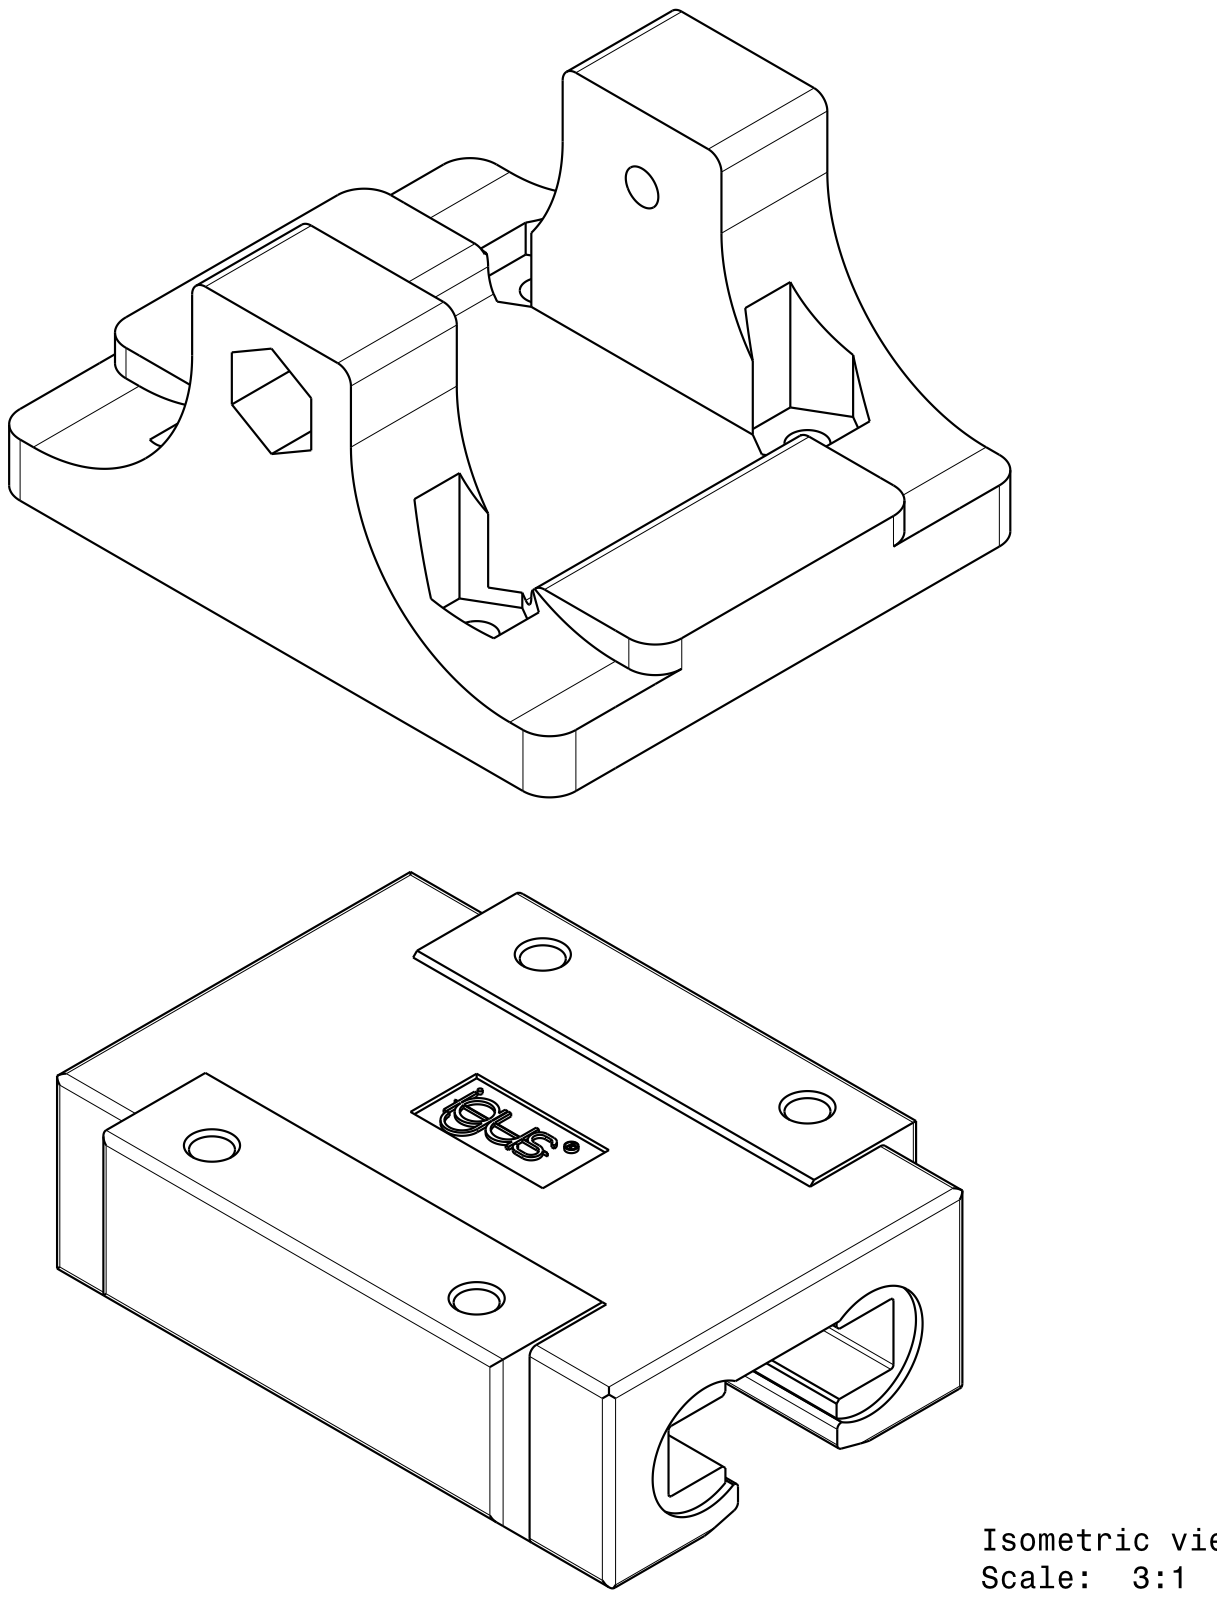
[picture p203: page 1]
