NervenCid/UNAL_FDM/Prototipo_11/Planos/LaminaYTWIsome.pdf

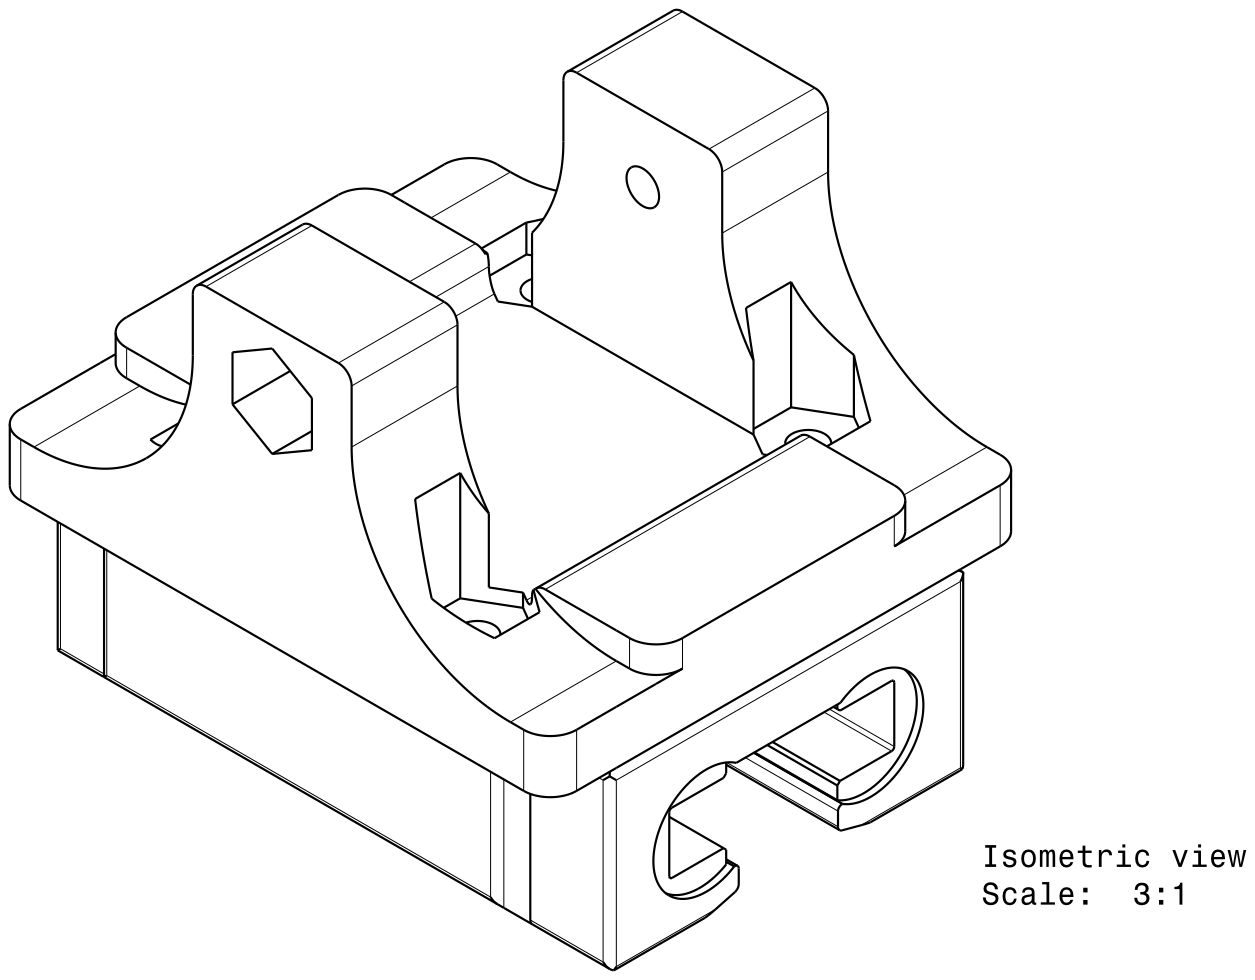
[picture p204: page 1]
