NervenCid/UNAL_FDM/Prototipo_11/Planos/PortaYNEMA17.pdf

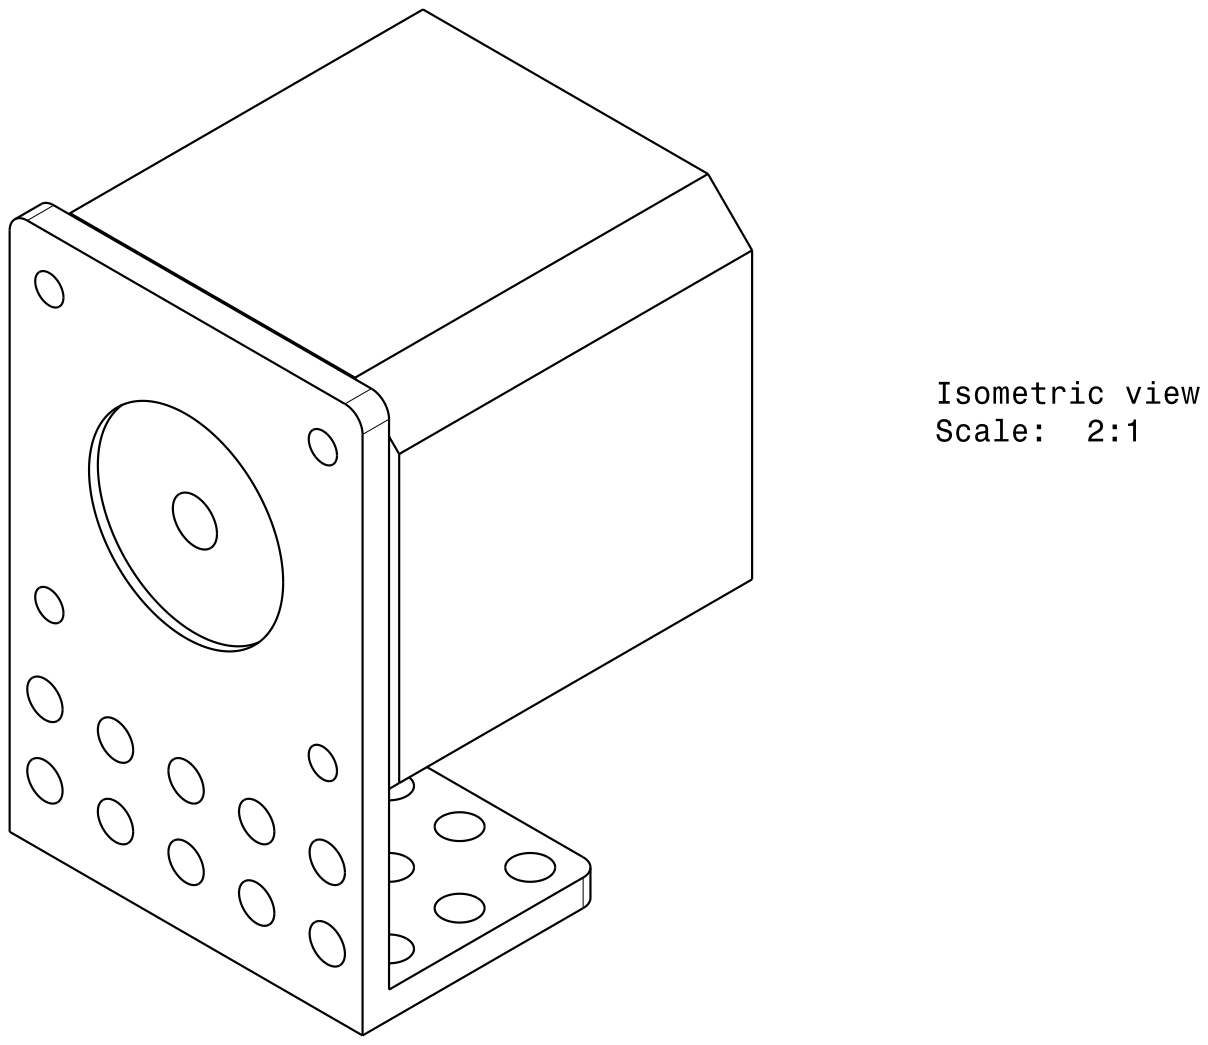
[picture p205: page 1]
