NervenCid/UNAL_FDM/Prototipo_11/Planos/PortaYRod.pdf

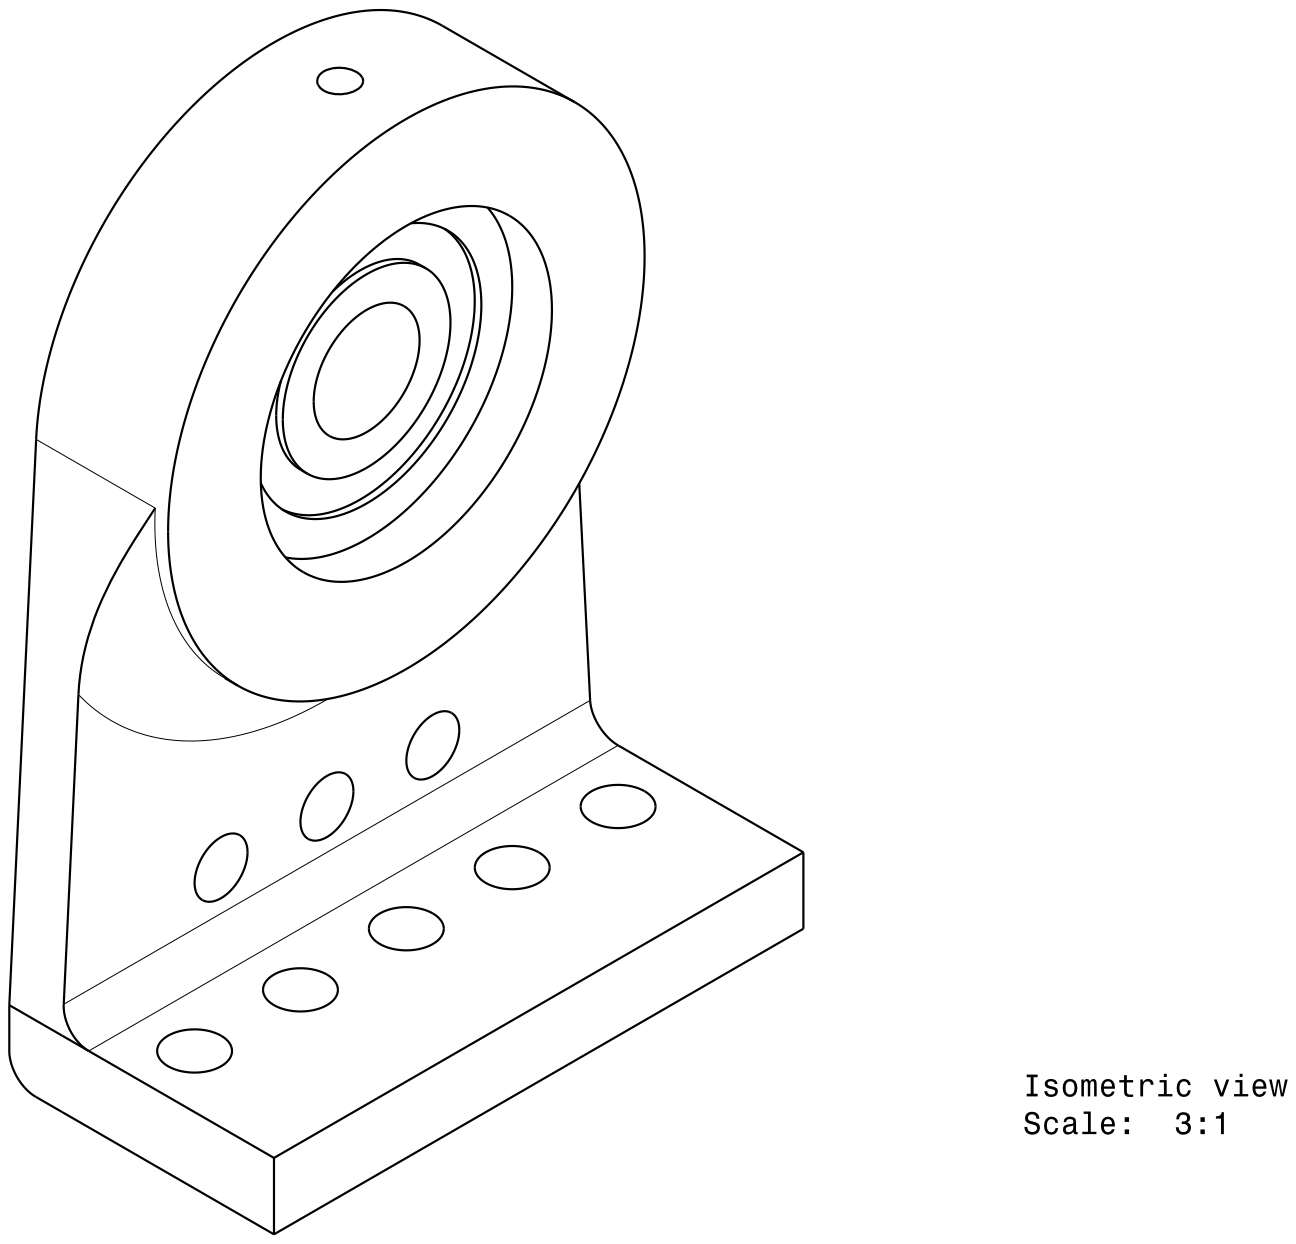
[picture p206: page 1]
