NervenCid/UNAL_FDM/Prototipo_11/Planos/Soporte_GiraTesor_A.pdf

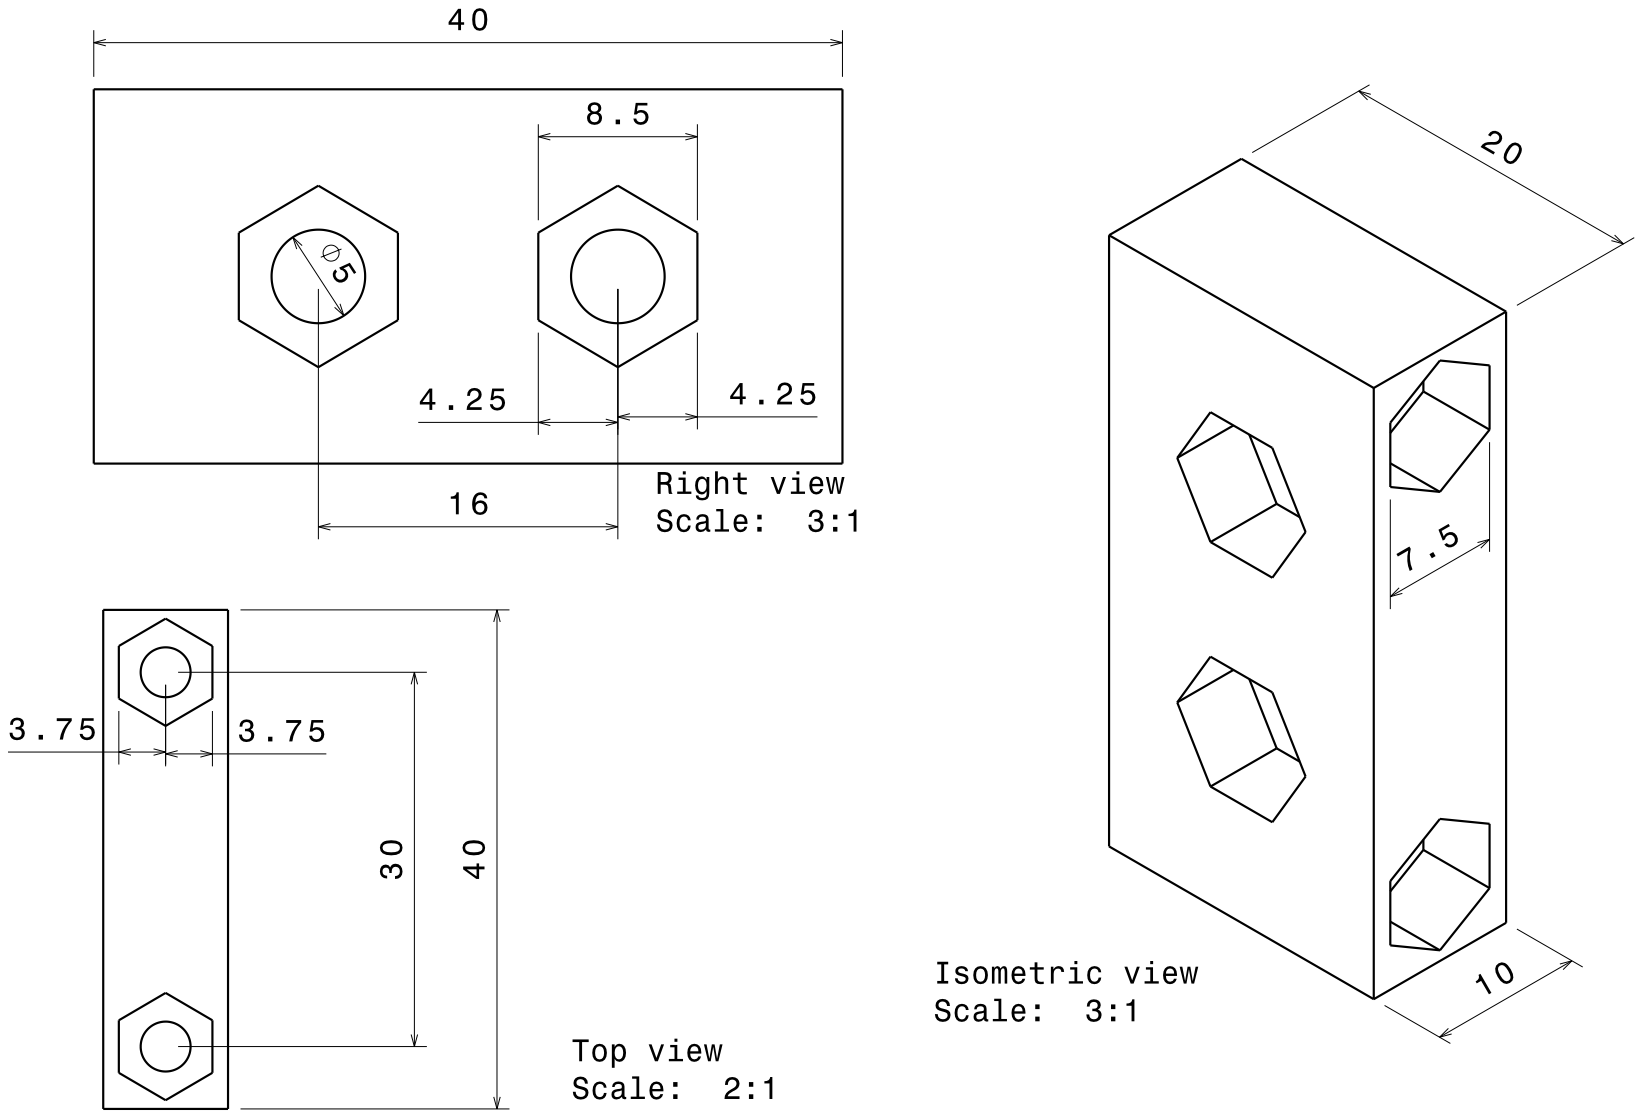
[picture p207: page 1]
