NervenCid/UNAL_FDM/Prototipo_11/Planos/Soporte_GiraTesor_B.pdf

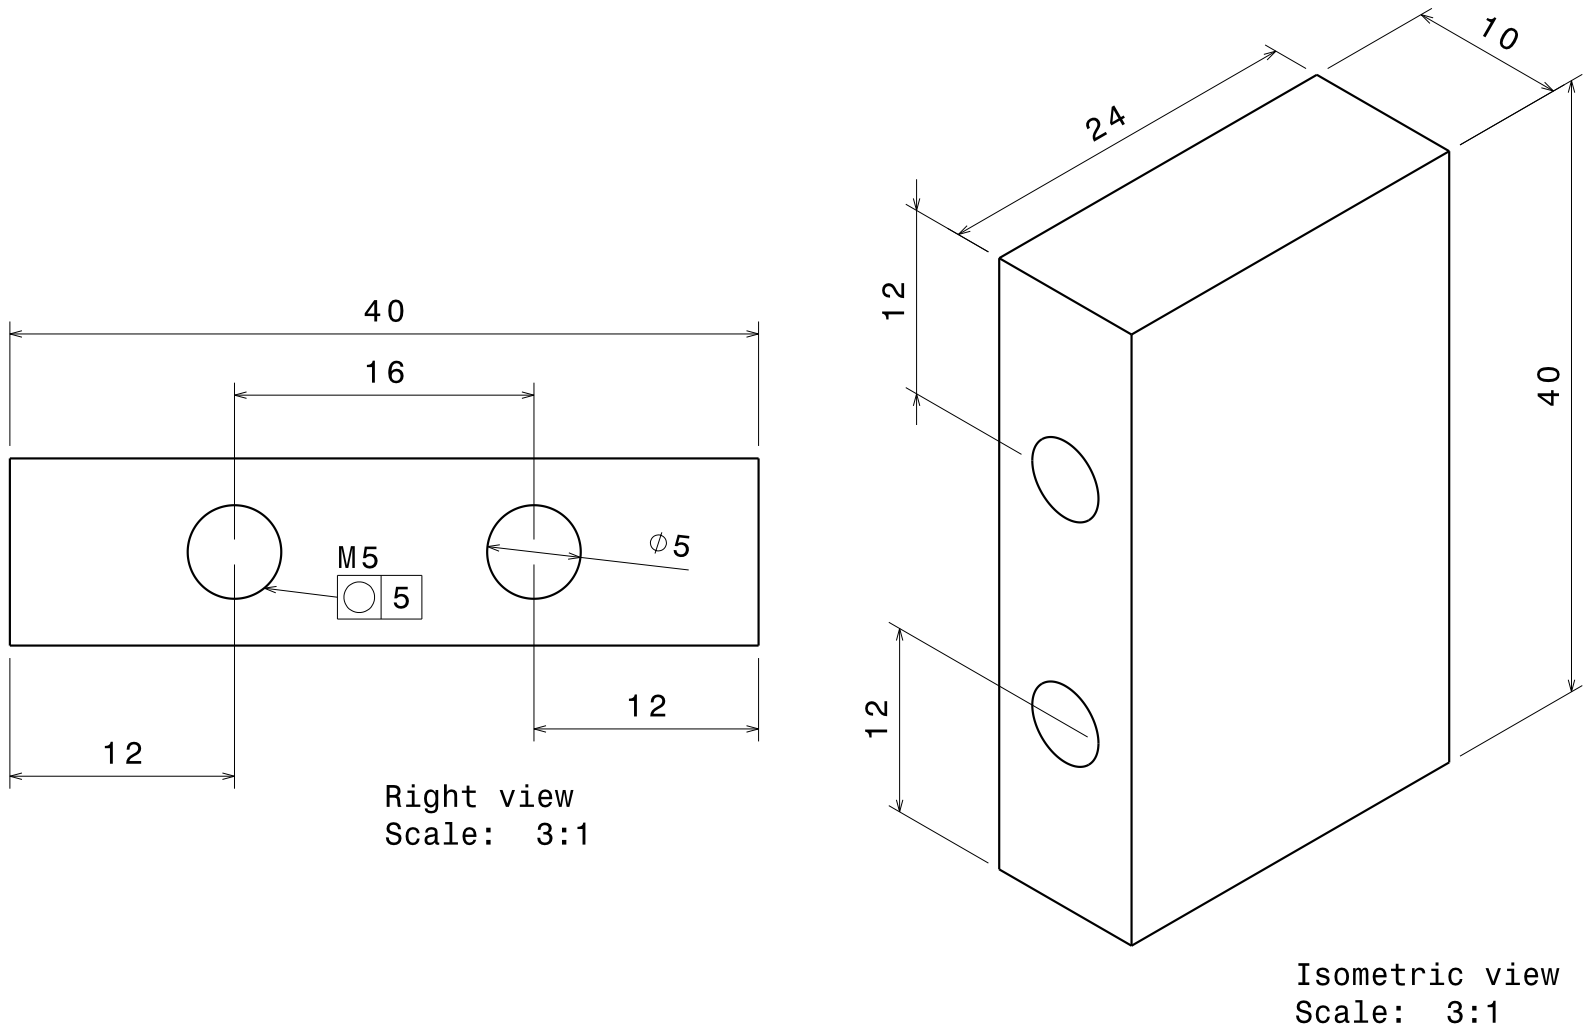
[picture p208: page 1]
