NervenCid/UNAL_FDM/Prototipo_11/Planos/Soporte_GiraTesor_C.pdf

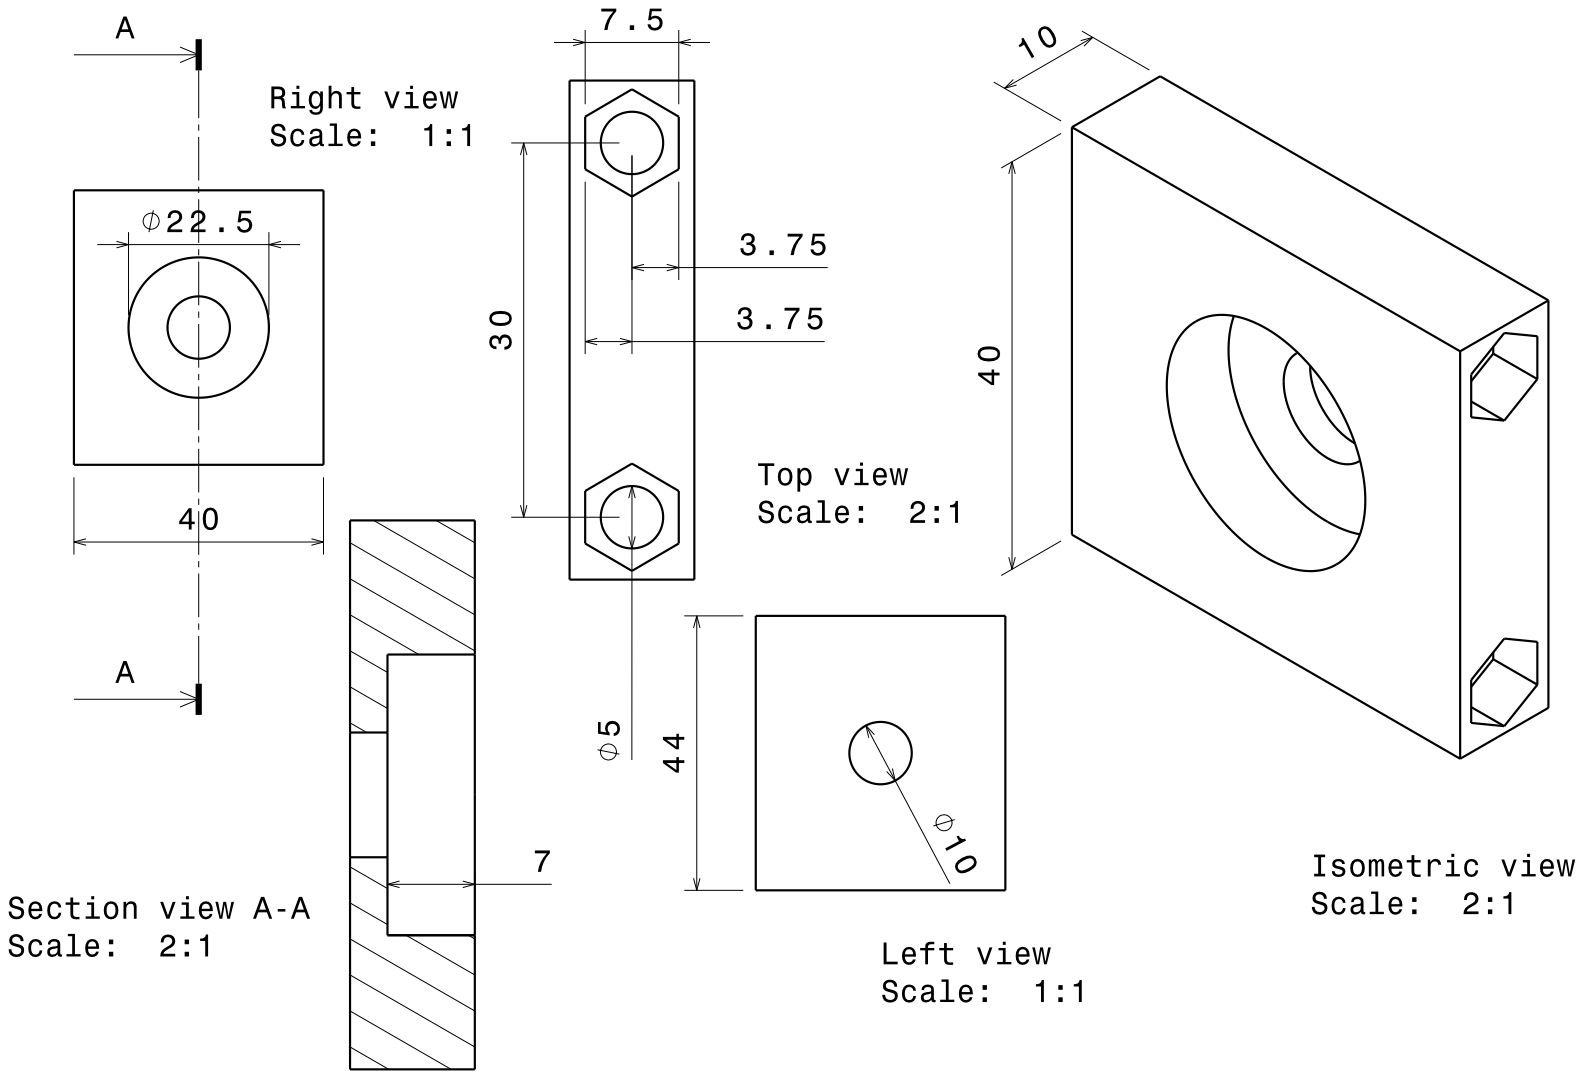
[picture p209: page 1]
