NervenCid/UNAL_FDM/Prototipo_11/Planos/Transfer.pdf

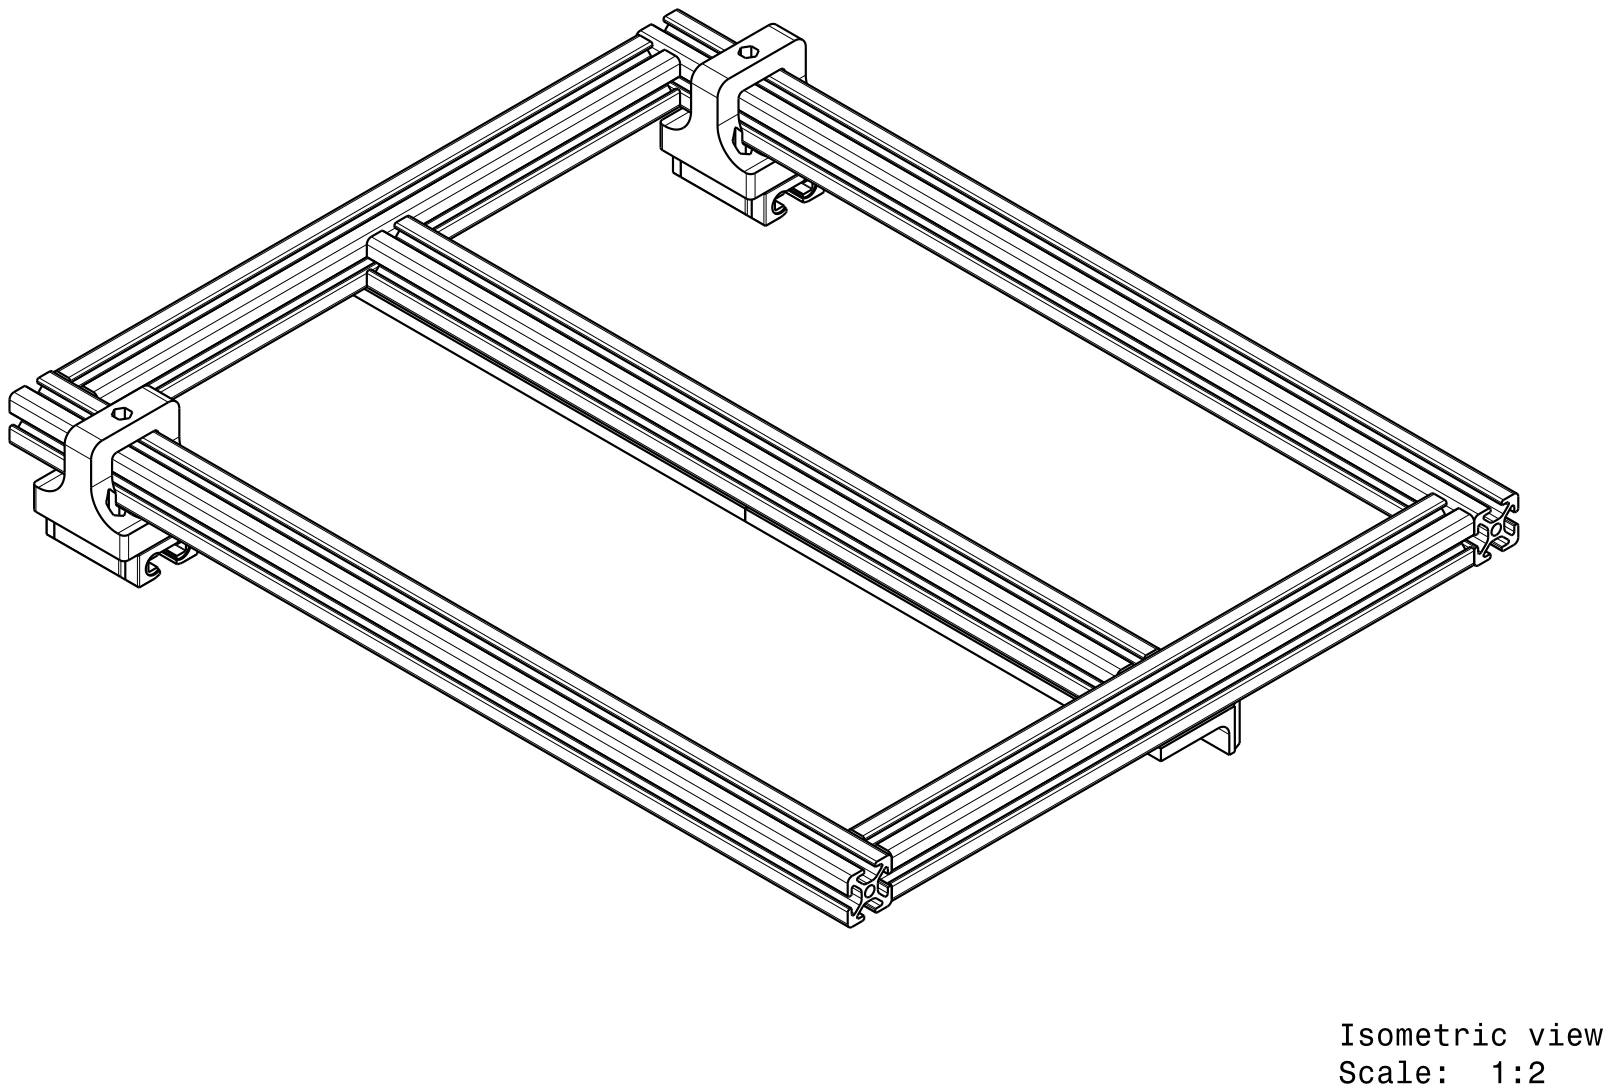
[picture p210: page 1]
