NervenCid/UNAL_FDM/Prototipo_11/Planos/UnionEstandar.pdf

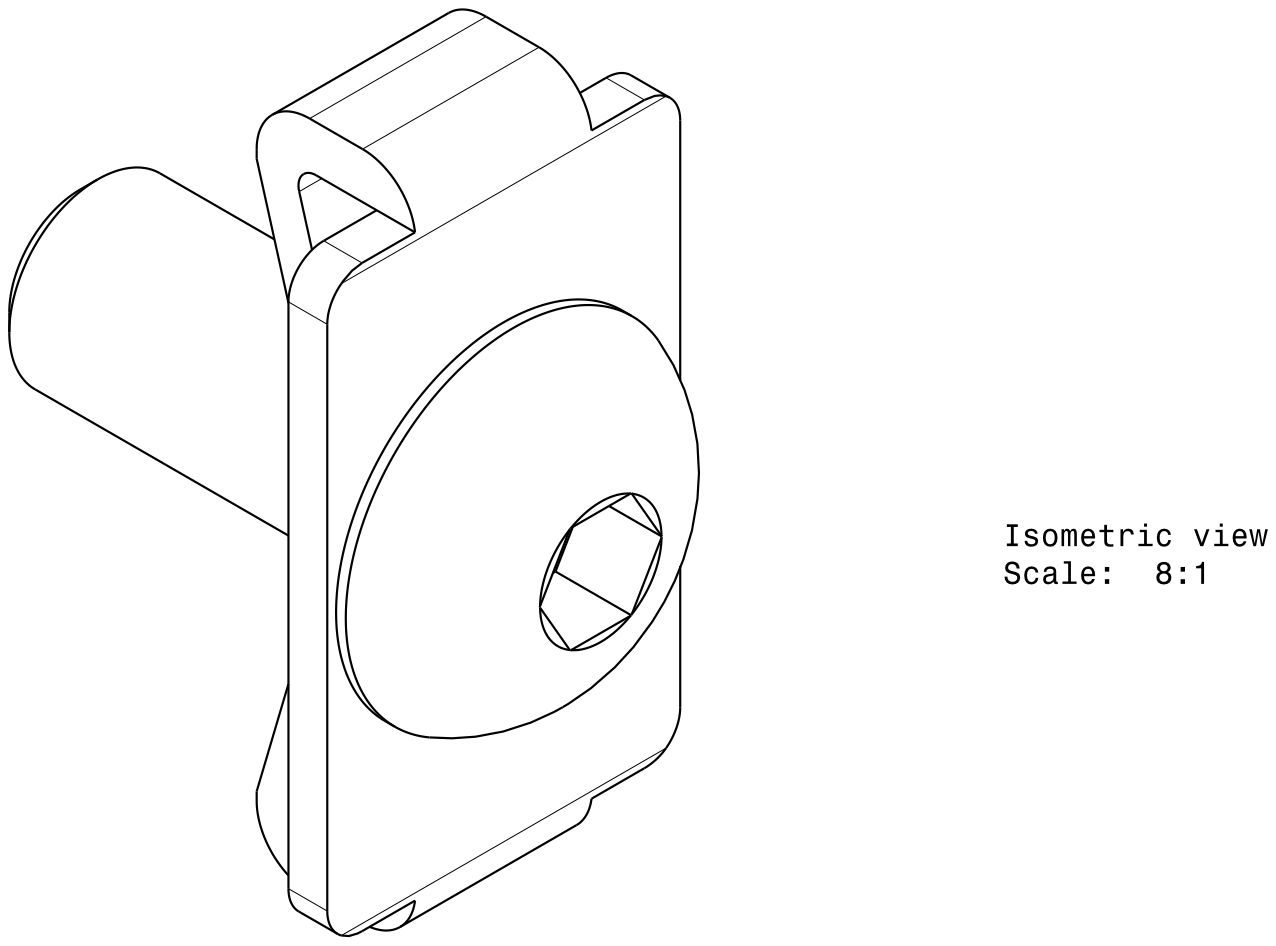
[picture p211: page 1]
