NervenCid/UNAL_FDM/Prototipo_11/Planos2/Base_Movil.pdf

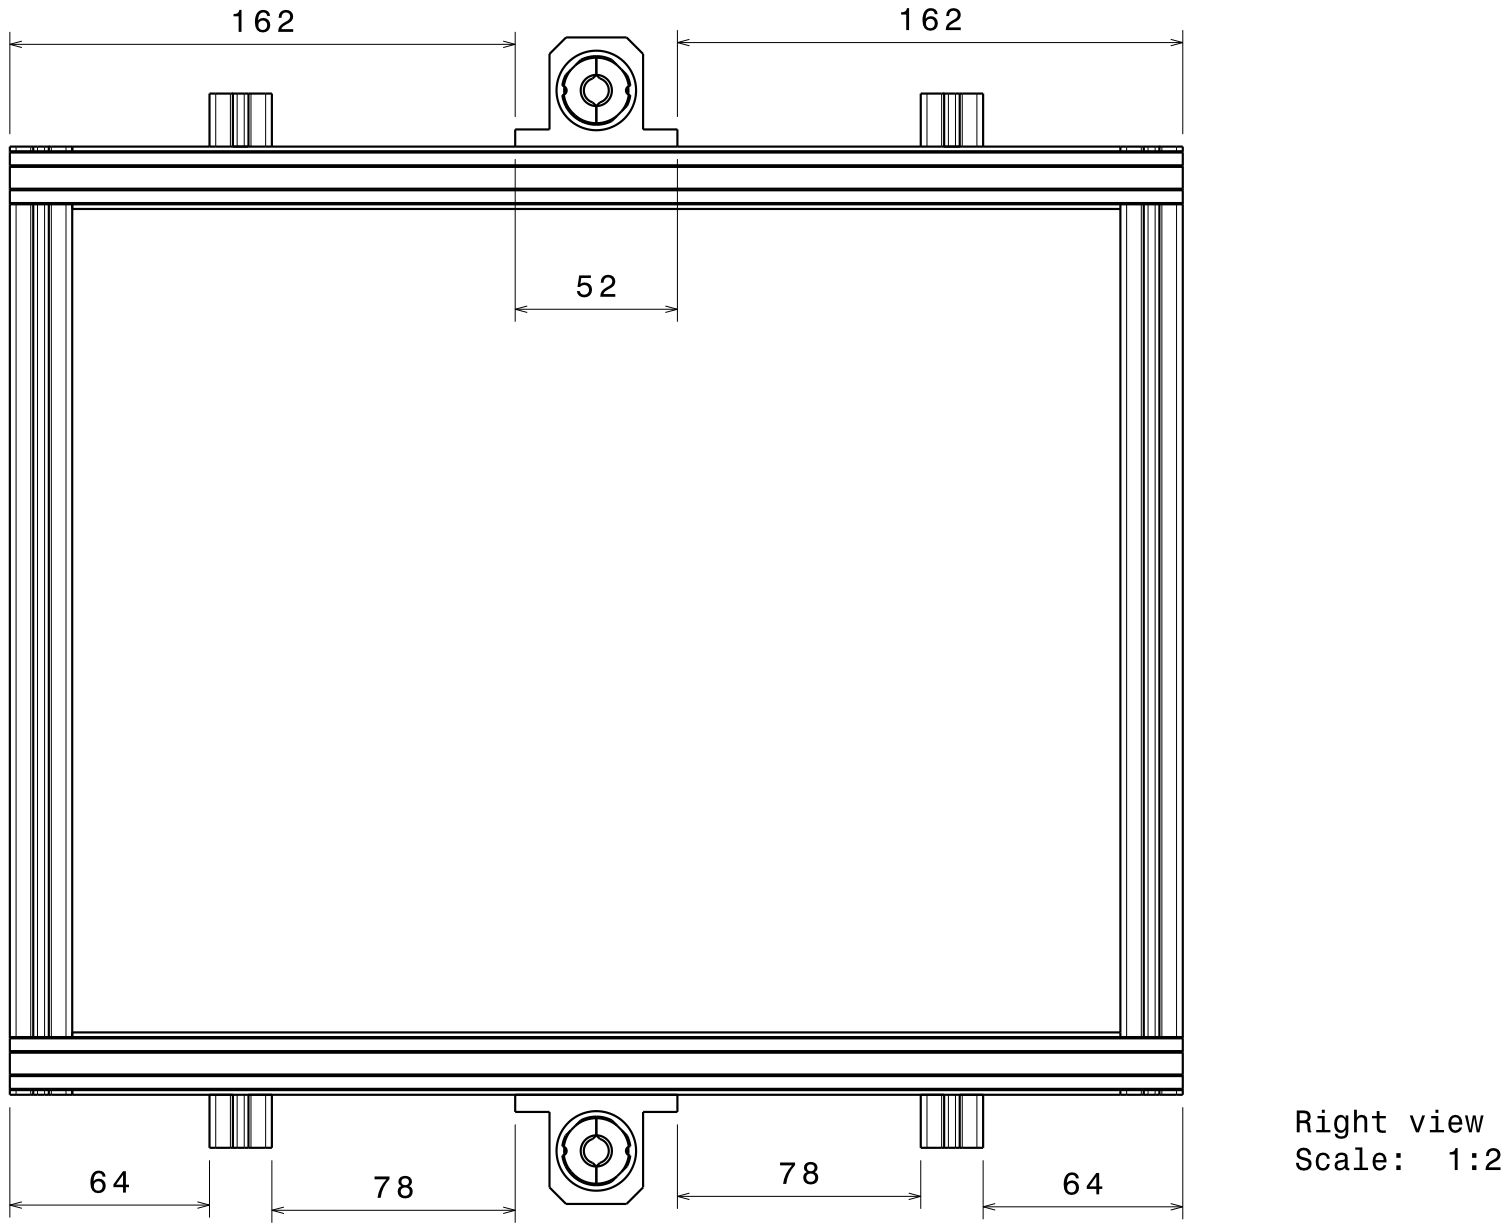
[picture p212: page 1]
