NervenCid/UNAL_FDM/Prototipo_11/Planos2/EJEXY.pdf

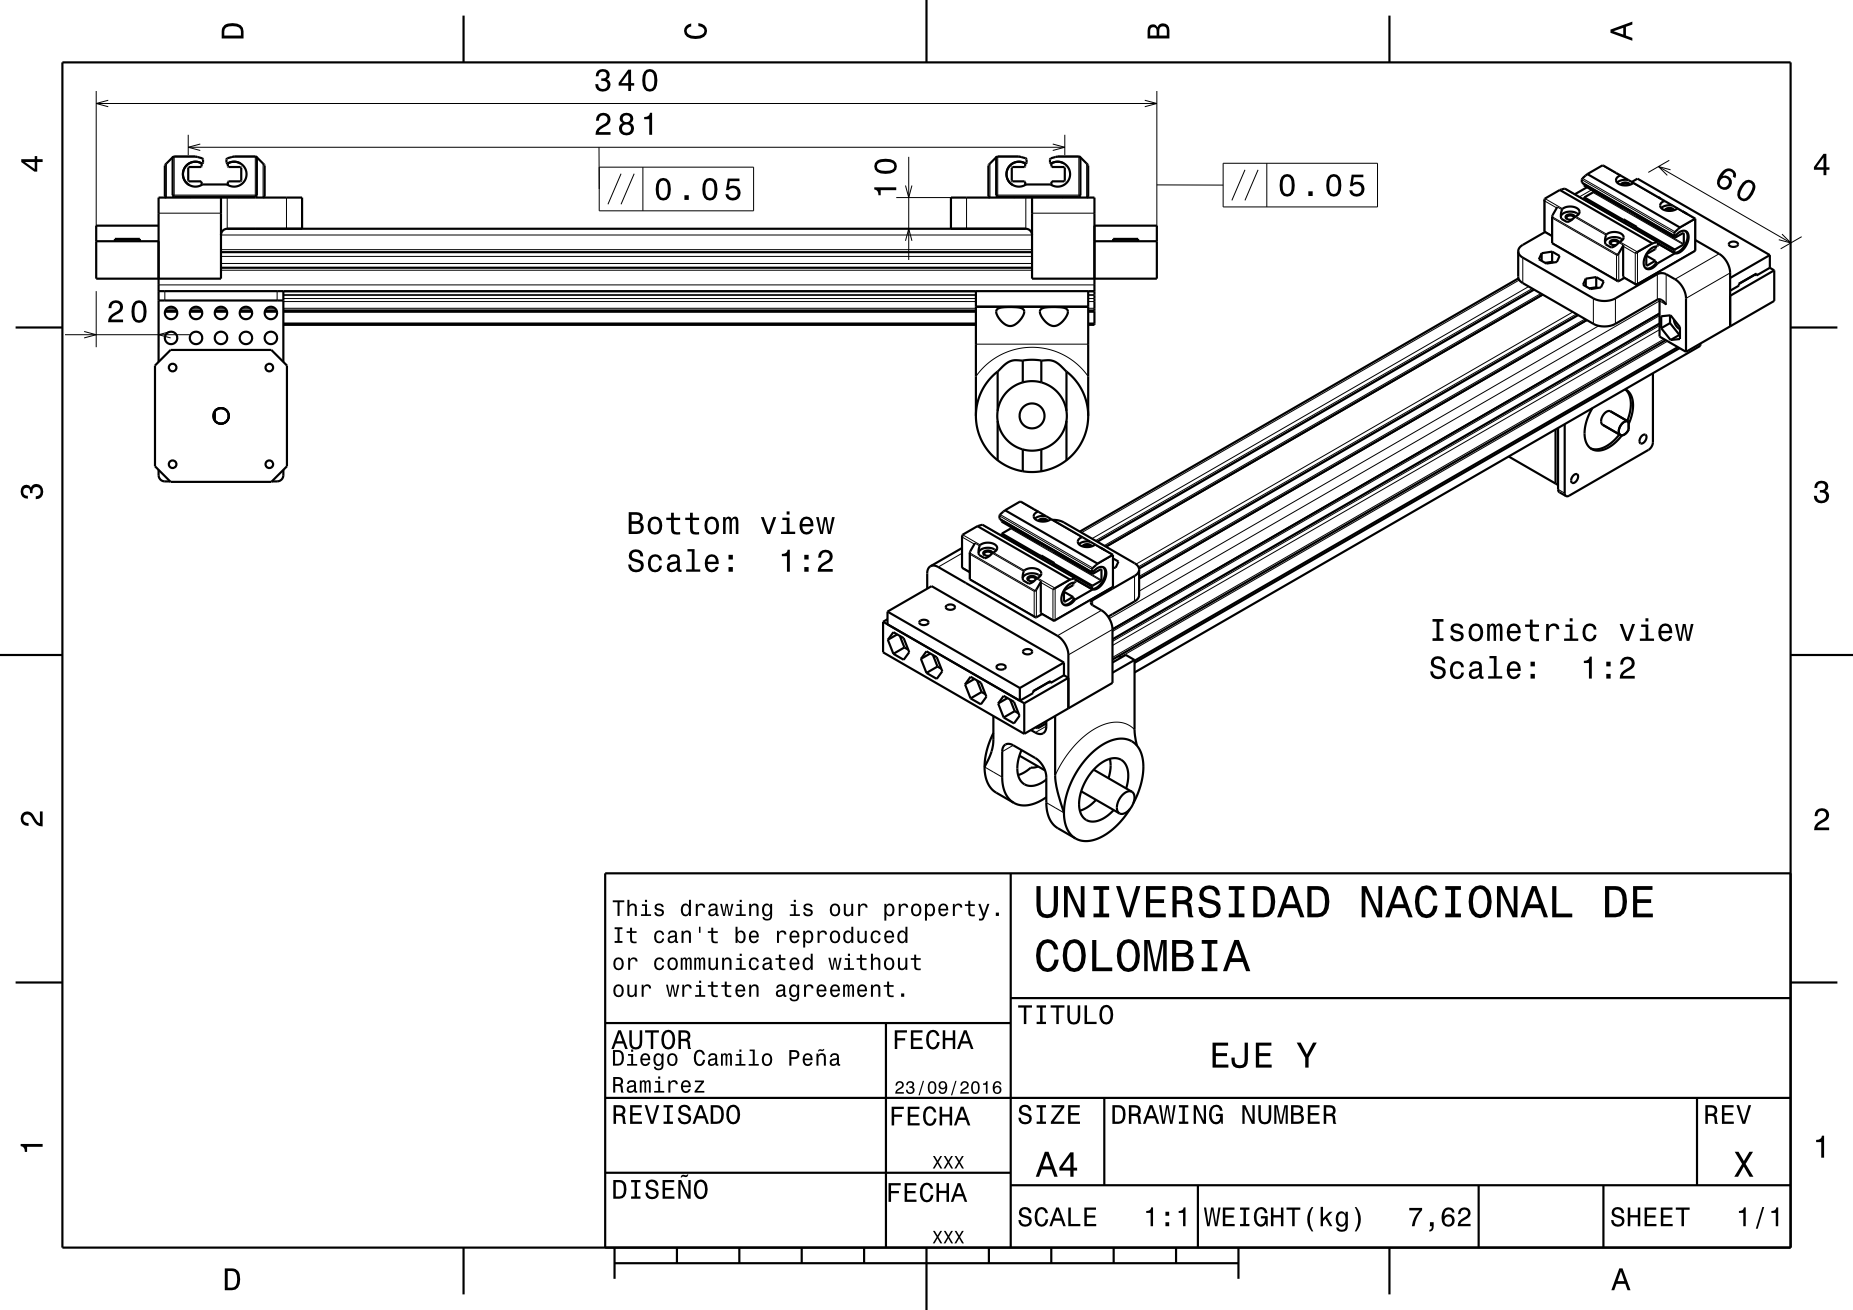
[picture p213: page 1]
