NervenCid/UNAL_FDM/Prototipo_11/Planos2/Estructura1.pdf

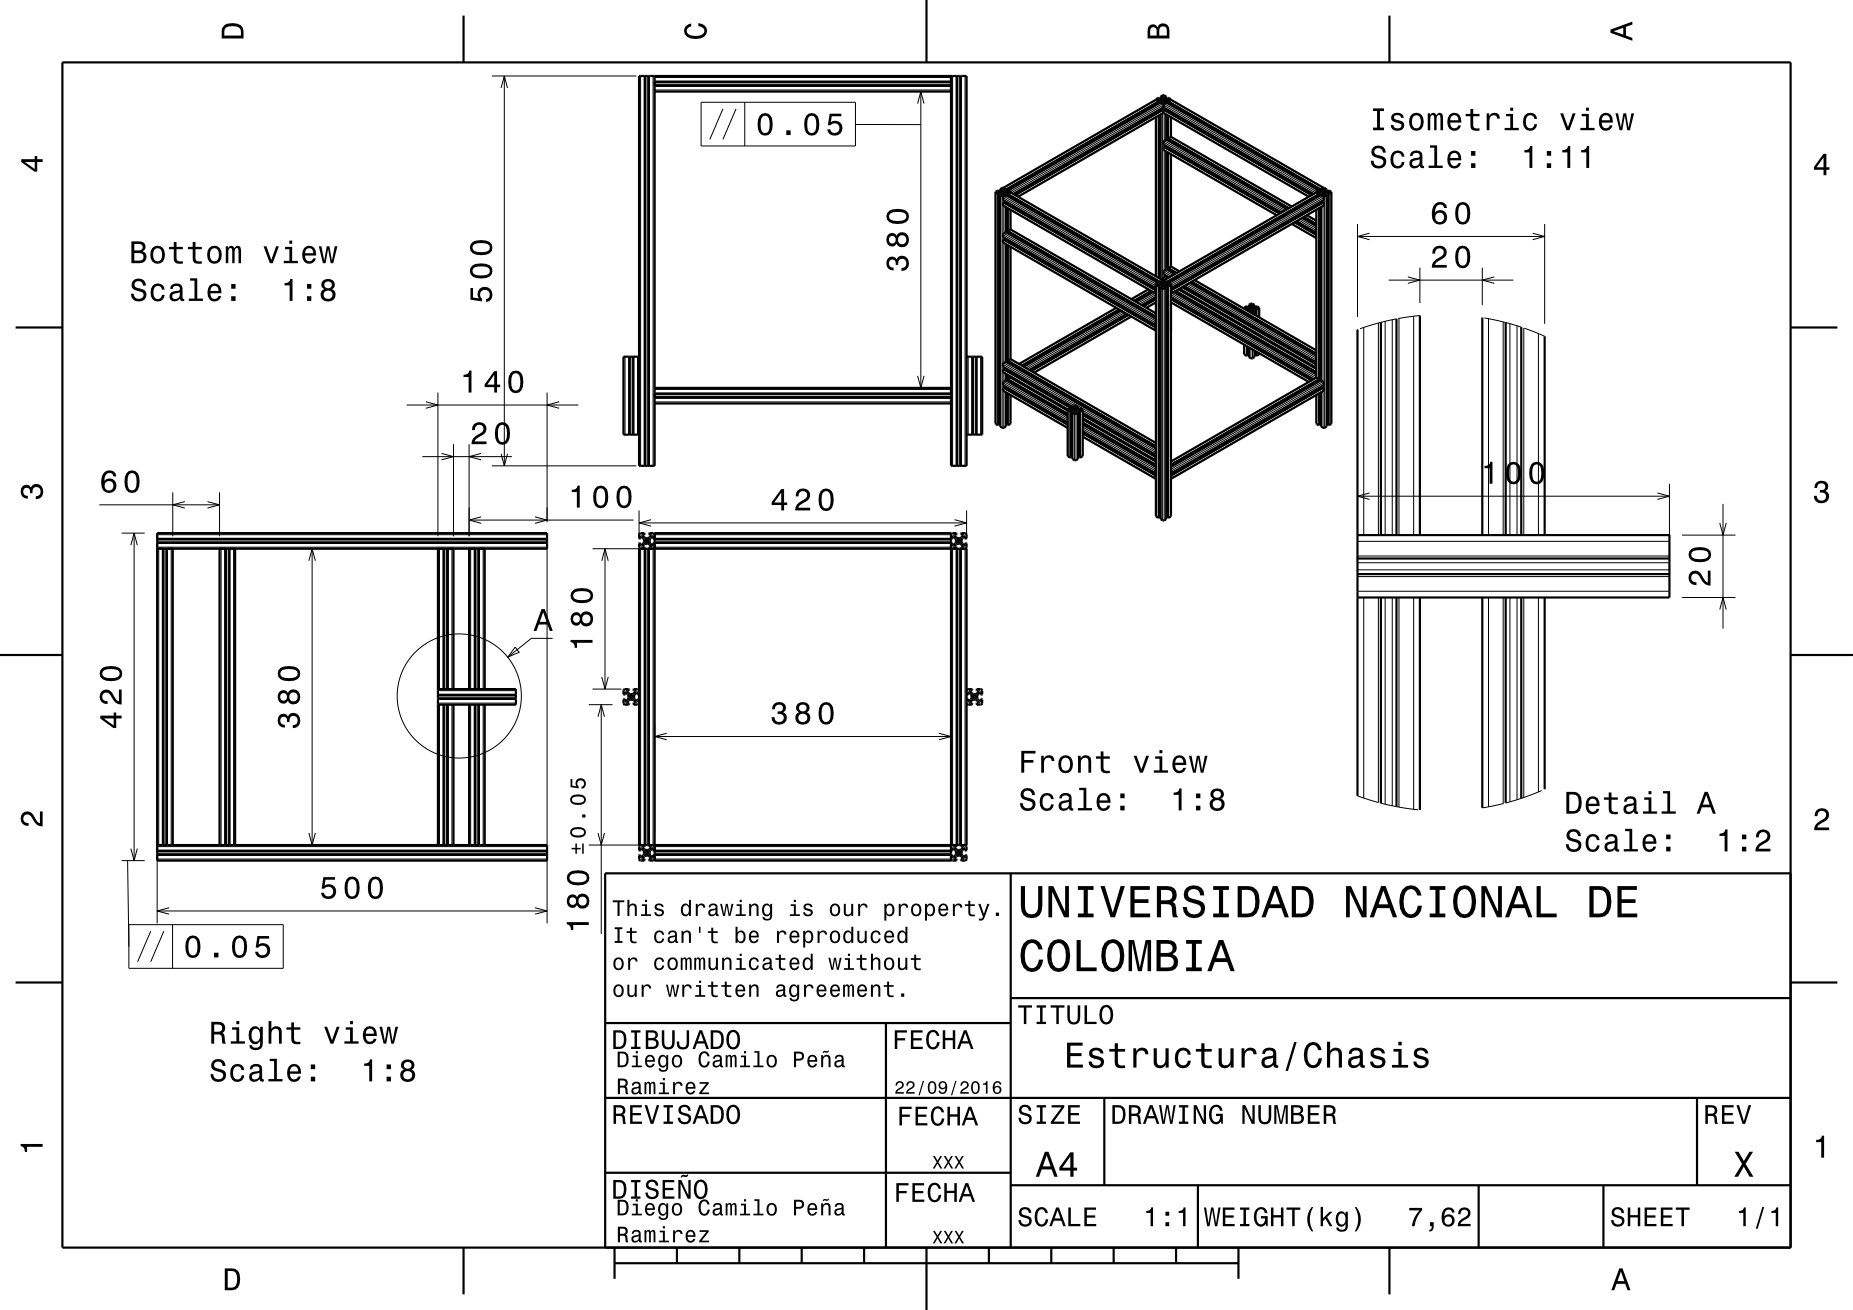
[picture p214: page 1]
