NervenCid/UNAL_FDM/Prototipo_11/Planos2/Tabla.pdf

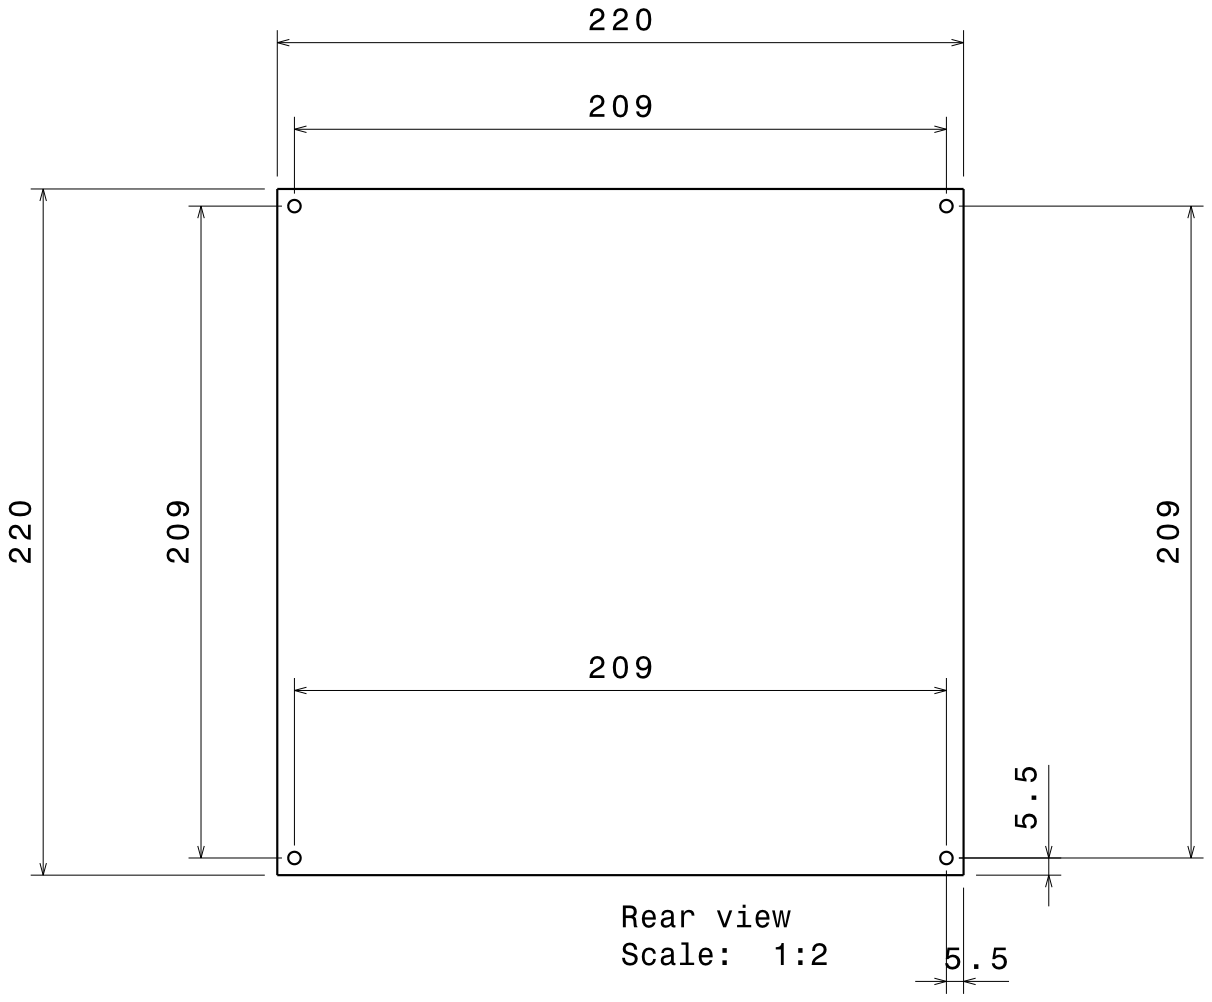
[picture p215: page 1]
