NervenCid/UNAL_FDM/(commit log)

2017-09-23 add folders
    [(GT2) 36 Tooth x 8mm Bore Pulley.CATPart, 42BYG_NEMA17.CATPart, 619_5.CATProduct, 619_5_PART1.CATPart, 619_5_PART2.CATPart, 619_5_PART3.CATPart, Acople flexible.CATPart, AcopleEstEjeY.CATPart]
2017-10-14 Actualizacion 13092017
    Se actualiza el product
    [Ensamblaje_1.CATProduct, Tablero_Control.CATProduct]
